rogerisaksson/coaxial_63100/docs/architecture/planners.md

# Architecture: Planners

The loop in a synthesizer's terms, a term a thing: [synth](synth.md).

The gynoid's latent loop, the one way she moves: a text compiled to rows,
the latent state stepped, the modes on her body and their springs rendered
into the whole-body loop's ask ([solvers](solvers.md)), then her drives.
Run by her law ([robotics](robotics.md)). Findings:
[orthokinematics](../findings/orthokinematics.md),
[flight](../findings/flight.md).

| Module | Is |
| --- | --- |
| ortho | orthokinematics: humanoid robot movement as text - `(stream_inject ..)`, `(defbehavior ..)`: latent targets, a stiffness and a damping a mode, rhythm, task constraints - compiled to rows of numbers (gynoid_mesomorph_medium.lisp, examples.lisp) |
| latent | humanoid robot latent state stepped with no branch: a row laid by a mask, the state a lerp, humanoid robot rhythm one angle; each mode's reference and impedance out |
| modal | humanoid robot modes on the body, no branch: the soles' places from the centre of mass as sums and differences, the standing legs' compression, the turns; what is sensed, the statics and the loop's ask laid flat |
| impedance | humanoid robot modes' springs rendered, no branch: the centre of mass's acceleration, a sole in the air, the turns, arms and knees - the whole-body loop's ask |
| poise | humanoid robot ZMP into humanoid robot spanned support polygon, humanoid robot capture point kept in it; which soles stand, with no branch |
| stride | humanoid robot stride from humanoid robot drive's phase: when a limb swings, where its sole lands (humanoid robot capture point), its clearance, its rock heel to toe, a standing sole's heel rising |
| leap | on the whole-body stack: which soles stand, told from one pass - each as it bears, an unloaded one beside one that bears or with humanoid robot at rest; one that does not is asked to its landing (reach) |
| support | sparse upper-body admittance coupling between driven joint innovations and modal references, with no branch |
| se2 | the outer twist-to-setpoint gate and the inner branchless heading, analog insole floor-plane and CPG modulation pass |

- The texts: `gynoid_mesomorph_medium.lisp` (and `_r80`), `gait_base.lisp`,
  `postures_base.lisp`, `motion.lisp`, `situations.lisp`,
  `examples.lisp`.
- `host/tools/sim/`: ortho (humanoid robot latent loop as the page runs it,
  traced; `--walk --look` humanoid robot walk's look); hop (a hop on it:
  thrown, flown, landed).

## Suites

| Suite | Holds |
| --- | --- |
| `test_ortho.py` | a text compiled to rows, none refused; no branch in the core or the renderer; the state blended and turned; crouched, shifted, bowed, on one sole, hopped; the walk on its own payloads; the first texts as given; the gym's worker, keys |
| `test_postures.py` | the seat's chain her landing's; her legs blended over what bears her, the soles' the crouch bit for bit, a let-go hip hung; the kernel's posture atlas read; sat on the chair, her ask her legs' |
| `test_leap.py` | which soles stand, from one pass alone; a landing within reach; the loop in C against the python stack, no sole standing; a hop on both, three in a row on the loop |
