rogerisaksson/coaxial_63100/docs/architecture/aerodynamics.md

# Architecture: Aerodynamics

What flies, on one flight stack: intent as text, the kinematics in a
vacuum, figures as rows and routines as cards, the grounds; the airframes in
MuJoCo, each on its 63100 drives. The quad and the core in C it flies on:
[quad](quad.md). Findings: [aircraft](../findings/aircraft.md),
[envelope](../findings/envelope.md).

| Module | Is |
| --- | --- |
| aerolisp | flight intent as text - `(stream_inject ..)`: latent targets, a stiffness and a damping a mode, an oscillator, task constraints - compiled to aero/'s payloads, a stream laid over the one before; a vehicle's blocks by `defblock` and `use` |
| aerokin | the quad's kinematics in a vacuum, no branch: a row of `aerobatics`' setpoints and the frame as it flies to aero/'s payload - a collective, the rotors' axis's tilt in the heading, the rates its turn gives |
| aerobatics | a figure a row of setpoints (`aerokin`'s), a routine a card of them |
| grounds | the gates in the air and what stands about them; `world` the rotorcraft's, these grounds for the course and the airfield for the routines |
| airfield | the aerobat's runway, its course laid for a plane - an air gate, a limbo, a hoop, a slalom, a knife gate on one line of arcs it flies by L1 - what stands about them |
| course | the gates among trees, houses and cars, a lap a line flown as rows; `flown` any laid line |
| sweep | the rotorcraft's sweep past the spectator before their figures, out down the runway and back past them |
| helicopter | the 3D helicopter in MuJoCo: collective and cyclic swashplate, tail rotor, stunts; `airframe`, `form` a T-REX 700's measured form - drawn -, `sky`, `law`, `observer`, and `kit` the SO(3) law's pieces the three share |
| ornithopter | the Dune-style four-wing flapping ornithopter in MuJoCo: articulated wings, dive fold, stunts; `airframe`, `sky`, `law`, `observer` |
| aerobat | an Extra 300 in MuJoCo: prop-hang, high-deflection surfaces, stunts; `airframe`, `form` its measured form - drawn, and what touches the runway -, `sky`, `law`, `observer` |
| wingborne | a plane's wing and tail in the air, its run on its wheels and its law wing-borne |

- The texts: `aerodynamics.lisp`, `dynamics.lisp` and `kinematics.lisp`
  shared; `quadcopter.lisp`, `helicopter.lisp`, `ornithopter.lisp` and
  `aerobat.lisp` a craft each.
- Drawn by `coaxial/graphics/<craft>.py`; flown on `terminal/views/<craft>/`
  and `show_<craft>.py` ([views](views.md)).
- `test_helicopter.py`: the helicopter and the ornithopter in MuJoCo, the
  three's boards and views; `test_aerobat.py`: the aerobat's routine on its
  airfield and its gate course in wind.

## Aircraft Flight Stack & Real-Time SO(3) Control Architecture

Aircraft flight stack and real-time SO(3) control architecture
