rogerisaksson/coaxial_63100/docs/DONE.md

# Done

What left [TODO](TODO.md), the oldest first; a line's numbers are in the file
it names. A closed item is cut from the list and gets its line here, last;
the two hundred before these: [DONE_1-50](DONE_1-50.md),
[DONE_51-100](DONE_51-100.md), [DONE_101-150](DONE_101-150.md),
[DONE_151-200](DONE_151-200.md).

1. Her DC link (`machine.body.dclink`): her packs, their BMS and her boards'
    capacitance under her drives' power, bled on her boards' d axes past the
    text's onset; under its 60 V through every scene, a hop down's landing
    58.93 V (test_kernel.py, [kernel](findings/kernel.md)).
2. Her blind field (`machine.senses.field`): the kernel's admittance seek down
    where her rows wait on a seat not bearing her; a chair lower than seen
    found and sat on, a chair pulled before it bears her a squat
    (test_kernel.py, [kernel](findings/kernel.md)).
3. The somatic manifolds on her observer (wbc_gmo.c, 8 manifolds): her
    forefoot by her soles' centre of pressure, her thighs' backs, her
    forearms' and carpal heels' shove; read against her skin walking,
    seated and lying ([kernel](findings/kernel.md)).
4. Her right-invariant EKF on SE_2+2(3) (`machine.senses.inekf`) beside her
    estimate: IMU and her soles' contacts by the observer's weights; walking
    0.039 m along the floor and 0.004 in height in 7.2 m where her estimate
    0.060 and 0.041 (test_kernel.py, `tools/sim/drifted.py`).
5. The kernel's two master texts as given, a module a file (26): the
    22-capsule body schema, the AST-to-SoA lowering - its functions
    evaluated as written -, the somatic schedule folded into the room's; the
    protocol's list rewritten to its seven steps and five tests.
6. The SoA ABI and the lowering (`machine.texts.lowering`, wbc_soa.h): a gait
    folded into a bank of the text's fields at its offsets over her nominal's,
    a biquad a node seeded on her value, the manifolds' weights, the capsules;
    carried over her link's table, her loop's biquad in C bit for bit; swapped
    settled, a step of 8.6e-7 where unseeded 0.30 ([kernel](findings/kernel.md)).
7. Her body schema (`machine.law.schema`): the kernel's 18 capsules on her
    skin, its 13 pairs' clearances, her posture held to each near pair's
    ECBF in her mass's metric, each floor raised by its braking distance
    through her drives' back-EMF bounds (`machine.body.bemf`); walking every pair
    clear of its floor ([kernel](findings/kernel.md)).
8. Her law's torque box her drives' back-EMF bounds (`machine.body.bemf`,
    `machine.stack.shrunk`): each driven joint's bounds by its speed on her link's
    volts inside its clamp, in her python step, wbc_step.c and the board's
    wbc_shrunk.c: her ask shrunk to her clamps, each drive clipped to its
    bounds, her C twins as her python ([kernel](findings/kernel.md)).
9. The insert's phase-margin probe (`machine.law.margin`, `tools/sim/margin.py`):
    the text's lock-in at 15, 22, 30 and 38 Hz, each in its turn, on her loop
    broken at a drive's torque; a known loop read within 0.11 dB and 1.7 deg;
    her gearboxes in, her hip's loop at 22 Hz past 0 dB with 25 deg
    ([kernel](findings/kernel.md)).
10. Her things as the room's boxes (`machine.law.schema`, `machine.body.capsules`
    the kernel's capsules apart); her arms' shield against them through their
    elbows tried and undone: at a doorway's jamb it spared no strike and
    halved her shoulder's yield ([kernel](findings/kernel.md)).
11. The wayfinder's gauge (`machine.way.wayfinder`, `tools/sim/doorway.py`): her
    trunk twisted through the gap 0.6 s ahead; the lodge's door ajar at 0.8
    of her shoulders passed, her waist 28 deg, her arms 55 mm clear
    ([kernel](findings/kernel.md)).
12. Her map (`machine.eyes.registry`): the kernel's 256 slots of what her looks
    told her within her eyes' frustum, a thing matched to a slot of its kind
    within its position's precision, weighed by the text's log-odds, blind
    spots kept 45 s and swollen, a mover at its velocity; 45 of the lodge's
    53 boxes after her bed errand ([kernel](findings/kernel.md)).
13. QUIT on the front page, Q and Enter on it; the RS485 plate tells its CRC
    from her wear's drift alarms (WEAR), SERVICE's row named wear.
14. Her buses through a noisy line (`edge.noise`, `edge.burst`, wbc_sil.c): a
    corrupt frame refused once and resent the next pass; a bus refusing past
    her horizon 1/omega (306 passes) turns her drives off till a restart;
    Renode's limb takes the same noise on its socket (test_buses).
15. The tube on and off (`terminal.ui.tube`), a retro set's switch: a dot over
    the shell's text, a line, the front page unfolding from it; the last frame
    folded to a line and a dot on leaving, 0.4 and 0.3 s.
16. The suite's side-lie (side_lie.lisp): perched on the bed's edge, a
    trochanteric pendulum along it; its handler (`maneuver._pendulum`) refuses
    the roll past her modes' reach by name, her gym's lie_bed kept.
    stunts_base.lisp renamed motion.lisp.
17. Her eyes' things as her registry's looks under `physics.SIGHT`
    (`sight.told`, `sprung.LOOKS`), the world's boxes their stand-in without
    it; the chair, table and bed told within 0.10 m.
18. Tour's corner on her closing speed toward the stop (`se2.closing`), a
    spin's drift away no approach; the brake's wire by the gait she was told,
    not her sway's phase: the chair errand sits at 23.7 s where 25.5.
19. The kernel's Coulomb slide as an ask of her step (`wrench.step`, the C
    step and its mirror): a pressing contact's tangential rows freed, its
    friction the kinetic one given, its normal force capped; unasked, the
    step to the bit as before. Measured on the chair's edge sit.
20. A slide said by her text: `(slide v)` in a phase's task constraints
    (`ortho.SLIDE`, the row 304 bytes), carried by her latent (`latent.SLID`,
    wbc_law.c alike) to her step's ask; nothing said, nothing moved.
21. The kernel's reachability on her loop (`machine.law.somatic`): each leg's
    reach over her leg's length rolls her sole's centre of pressure onto its
    ball from 0.86 to 0.98 of it by the furniture's told share; the slide's
    ask laid there too. Standing and sat on the chair, nothing moves.
22. Her seat one patch of her step (`wrench._patch`, wbc_patch.c): its
    contacts' split pinned as felt; the Coulomb regime as the step feels it
    (`rounds.pushed`, past SLIDE_M_S), the text's slide its cap; what bears
    her capped as told over every patch, no lower than the lever's rule; the
    rise's lean panned to her soles at the handover's 0.82, her legs' springs
    back with it, her neck braced seated. The chair laid 2e-4 rad either way
    sat (main fell at -2e-4), square and +2e-4 risen at roll 2.4 deg, the
    dock stood, her walk as it was; the -2e-4 rise stays open (protocol 5).
23. Her loop's layers live (`machine.process.introspect`, findings/introspect.md):
    latent, impedance and wrench a JSON line each law pass to any client
    attached, every field named from her code's constants; idle 604 us a
    pass where 615 without, 875 read.
24. Her telemetry gated (`machine.rig.gate`, `machine.rig.streams`, findings/
    introspect.md): her analyzers beside her loop, a trigger's half swing
    before and after written gate after gate, 11 streams on their own
    clocks interleaved in time with their metadata; every gated section her
    passes' own to the bit (test_gate), the page's snapshots matched.
25. Her pose laid within her joints' stops (`physics.World.reset`): her
    fingers, held a fist at 80 deg, laid at the stand's 18 snapped in at
    893.5 deg/s each lay, her wrists at 69.1; now 0.4 and 3.8, her walk as
    it was (findings/introspect.md).
26. HUMANOID's prompt on its own model (`gynoid.MODELS`, gemma4:e4b: 4.6
    GB on the card where 12b held 8.1), warmed as the page opens and at
    `/`, released as it closes; the Ollama host 127.0.0.1, where localhost
    paid 2.04 s a request: a prompt 2.42 -> 0.11 s, a board-chat question
    8.0 -> 1.4 s (MODELS.md).
27. Her classifier on MuJoCo's furniture painted into her map (test_sight):
    each piece's kind, place and floor hull within a voxel at 0.05 m, the
    bed moved and turned; a map's voxel its own (`voxels.Map`), her eyes'
    at the 0.1 m they fill; a look's `things` 994 -> 174 ms at 0.05 m
    (findings/sight.md).
28. Her fake camera, a vision SIL (`machine.eyes.camera`): her eye's frames shot
    on the card where the world runs, her map and classifier in a process
    of their own, her things a look later; her loop 1.09 x flat out with it,
    1.08 without; a structure told in pieces by its cells (test_camera).
29. The rotor page's segments read its feed once a frame in test_views_segments:
    the stepper went 52-80 of 60 degrees under a full run, 56 and 52 on 24
    copies side by side.
