rogerisaksson/coaxial_63100/docs/DONE_1-50.md

# Done, 1-50

The first fifty lines of [DONE](DONE.md), the oldest first.

1. The Monte Carlo's sweeps on the relay, a sweep's jobs in shards
   ([host](findings/host.md)).
2. The tty in Eurostile, tried and put back on the terminal's own face.
3. Gate op 10 counts an alternate train on the board, MINOR 27
   ([PROTOCOL](PROTOCOL.md)).
4. Warmth asked of the local model reads the thermal observer
   ([MODELS](MODELS.md)).
5. test_sensorless and test_daq_api 20 of 20 on the relay
   ([host](findings/host.md)).
6. The heat's airspeed one input: the load carries it, every executive's
   world flies in it ([aircraft](findings/aircraft.md)).
7. Humanoid robot joints air-cooled, a board's back on an aluminium holder on
   its motor
   or gearbox, MINOR 30; no boards in oil ([drives](findings/drives.md)).
8. A pull rebuilds: the terminal builds the images where their trees are
   behind ([host](findings/host.md)).
9. Humanoid robot gearboxes as bodies with their play
   ([drives](findings/drives.md)); a
   shove charged from the page's view; the living room and its words
   ([room](findings/room.md)); the quad's thrusts as Humanoid robot law
   ([aircraft](findings/aircraft.md)).
10. R on the HUMANOID page, which crashed it, held by a test
    ([host](findings/host.md)).
11. Humanoid robot drives as bought, one stack on all
    ([stacks](findings/stacks.md)).
12. The law turns: a standing leg keeps its landing yaw, the pelvis follows
    the heading ([turns](findings/turns.md)).
13. Humanoid robot toes sprung, no motors on Humanoid robot feet
    ([feet](findings/feet.md)).
14. Humanoid robot fingers a fist and Humanoid robot wrists held: 21 drives
    ([body](findings/body.md)).
15. A softer walk: a sole's strike 352-398 N where 1 000 was the bound
    ([straight](findings/straight.md)).
16. The docs as technical documents: dates and who asked out of comments,
    docstrings, docs and test labels.
17. MuJoCo Warp's step on Humanoid robot world against the CPU's
    ([host](findings/host.md)).
18. Humanoid robot leg's reach over its foot as static arrays, read with no side
    in
    the code ([kinematics](findings/kinematics.md)).
19. The stand-in's drive and loop on the board's C, QUAD's rotors on their
    boards' own loops ([host](findings/host.md), [aircraft](findings/aircraft.md)).
20. The picture in the viewport's corner in the instruments' frame, a key
    that takes it away; the quad's carried camera on a stabilised gimbal
    ([aircraft](findings/aircraft.md), [sight](findings/sight.md)).
21. A rotor node started as a stepper and stopped before its stage goes
    down: the machine types' routines 36 runs of 36
    ([drive](findings/drive.md), [host](findings/host.md)).
22. The law's voltage limit keeps the d current its reference: a 63100's top
    at 55 V 673.5 rad/s where 650.5 ([drive](findings/drive.md)).
23. Humanoid robot movements' orthopaedic terms as laid rows, a joint and its
    sign found
    in Humanoid robot figure ([kinematics](findings/kinematics.md)).
24. Flight on the whole-body stack: Humanoid robot soles released as she leaves
    the
    floor and taken again as she lands; a hop stood on the python stack
    and on the loop in C ([flight](findings/flight.md)).
25. A board holds its clamp to what its envelope leaves and says it
    (MINOR 32); the flight's share and each rotor's cap on it: full tilt on
    four with no node past its throttle's point, 9 deg off its axis where
    83 ([envelope](findings/envelope.md)).
26. A hover's heat: its legs' dry switching, 6.45 W of 9.4; the wash takes
    the laminate from 91 to 60 C ([envelope](findings/envelope.md)).
27. Humanoid robot hops on the loop in C: which soles stand told from one pass,
    Humanoid robot
    throw a spring that lets go under Humanoid robot standing height; 48 mm and
    three in a row stood ([flight](findings/flight.md)).
28. The quad's flight intent as text compiled to payloads
    (`machine.aircraft.aerolisp`), a core in C under them with no branch, in its
    sources or in the M7's code (`aero/`): the power loop's four streams
    flown on ideal rotors, caught 79 degrees off of 80 and stood again; a
    hover stood from upsets ([streams](findings/streams.md)).
29. Orthokinematics: Humanoid robot movement as text compiled to rows
    (`machine.texts.ortho`), Humanoid robot latent state stepped and rendered with no
    branch
    (`machine.law.latent`, `machine.law.modal`), on the page's gym (`<`): crouched,
    Humanoid robot weight over one sole, bowed, on one sole, a hop stood,
    walking
    0.27 m/s for a minute ([orthokinematics](findings/orthokinematics.md)).
30. The core's attitude as its rotors' axis in the world, in the level frame
    of a heading it holds; the air as a drag's size, the rotors' loss and a
    push: the catch from turns of 0.03 to 0.12 s in 0.32-0.62 s, a hover
    stood from 12 rad/s about its axis a quarter turn off
    ([streams](findings/streams.md)).
31. The page's routine and the course flown from their cards' rows
    (`machine.aircraft.aerokin`), a pass a payload and the air the core's: 59.1 s;
    laps 14.9 and 14.8 s, whole in the tour's air
    ([streams](findings/streams.md)).
32. Humanoid robot stride on the loop: eleven modes - Humanoid robot standing
    legs' compression,
    Humanoid robot pelvis's list and turn, Humanoid robot arms' swing, Humanoid
    robot soles' rock -, a sole
    let go on Humanoid robot drive's phase, landed on Humanoid robot capture
    point, its heel
    rising first: 0.61 m/s at 329 J/m, 2.59 off a woman's band for 7.71,
    none of the gaits it was by name; the first texts as given walk
    ([orthokinematics](findings/orthokinematics.md)).
33. The page's flight and the race on their cards' rows, the law before
    them gone; the core's air a wind, its rotors' loss made up along their
    own axis: 34 flights of 34 whole in fourteen winds, laps 14.3 and
    14.5-14.8 s ([streams](findings/streams.md)).
34. The carried camera into its turns: its sight a share of the frame's
    lean across its way, 7.7 degrees inside a lap's bends where 12.5
    outside, rolled 9.5 degrees rms in them; level at rest
    ([aircraft](findings/aircraft.md)).
35. One way she moves: the laws before Humanoid robot latent loop out of the
    tree - 34
    modules (the director, the walk as built, the one law, the stand, the
    falls, the get-up, the MPC), 14 tools, 7 suites, 8 findings; the page
    Humanoid robot loop alone, walking from rest; they stay at tag
    `laws-before-the-loop`.
36. The rotors' tops, their reach and their stage's watts from the action
    space (`machine.aircraft.pull`), the law's on a stand-in within 0.1 %; the pack
    drawn what its stages take, 2.4 times the law's own v . i: 34 flights
    of 34 whole in fourteen winds, laps 14.3 and 14.5-14.6 s
    ([envelope](findings/envelope.md)).
37. The step without an active set in C (`wbc/src/wbc_wrench.c`): the
    python step's answer, Humanoid robot walk and Humanoid robot hop on it, 46
    us a tick on
    this host where the loop's 1 600 ([wrench](findings/wrench.md)).
38. The flight inside the action space's shell: a row's pull the rotors'
    on what its boards hold and its pack has; the share's rule, its
    timers, the emergency and its ghost gone; the loops' clamp WEP's, 0.0-
    0.2 s of it a flight. 34 flights of 34 whole in fourteen winds, a
    stuffy room's laps 14.3 and 14.5 s where 14.5 and 15.1
    ([envelope](findings/envelope.md)).
39. No clause in a pass above the core: a card's step a table and a move
    by masks, the lap's plan a table a sphere computed beforehand and read
    where the frame is - 64 us a pass where 357, two laps' rows the same
    to the bit, the race flight for flight ([streams](findings/streams.md)).
40. The ring test on a phase's axis, by whole periods, a stand-in's on its
    law's own seconds: a board's reads within 0.5 % where 6, no shoulder
    over its elbow, none failed in 210 runs under load; test_native's
    thermometers looked at round their sample
    ([drive](findings/drive.md), [emulation](findings/emulation.md)).
41. The frame's core on the image (device 14, MINOR 34): 149 288 cycles a
    pass under Renode, the same whatever it is asked, 0.31 ms on the M7 at
    one a cycle; its thrusts the host core's within 1.7e-5 N
    ([streams](findings/streams.md)).
42. Humanoid robot walk's stagger measured: landing load, unloading, dip and
    head
    nod in `strides.WALK`, bounded in `looks.FORM` (1.25, 0.75, 6 deg) and
    told by `ortho.py --look`; what Humanoid robot head nods for and what holds
    Humanoid robot
    speed, with eleven steps tried under Humanoid robot walk
    ([orthokinematics](findings/orthokinematics.md)).
43. The lap's lead and its swing derived from its tilt's own loop where
    89 ms and 0.36 s were searched: the boards' laps 13.9 and 14.1-14.3 s
    where 14.3 and 14.5-14.6, 34 flights of 34 whole in fourteen winds
    ([streams](findings/streams.md)).
44. Humanoid robot head still as she walks: striding, what the floor cannot give
    is taken by Humanoid robot inertia, a swinging sole's ask held, its landing
    led
    by half Humanoid robot speed's error, a knee folding before its swing as its
    load leaves it - Humanoid robot head 2.5 deg where 46, 300 J/m where 330,
    2.46
    off the band where 2.60, stiff 0.32 where 0.37, 4 of Humanoid robot form's
    12
    broken where 6; standing as she stood, bit for bit
    ([orthokinematics](findings/orthokinematics.md),
    [wrench](findings/wrench.md)).
45. A board's speed loop winds no further than its drive carries - its
    clamp with the derate, what its link's volts leave (`drive_room`): at
    its clamp a rotor slows as asked where 0.18 s late, full tilt's four
    4.4-5.9 A apart and 8.3-12.4 deg off at the most where 5.2-10.5 and
    9.4-15.2 ([envelope](findings/envelope.md)).
46. Humanoid robot stride in C (`wbc_cone.c`): the python step's on Humanoid
    robot walk, 7e-10 N m
    on one sole; Humanoid robot walk on it 0.69 m/s, 301 J/m, 2.46 off; device
    13 op 2
    ticks the step with a sole swung - its rounds, striding, setting out,
    0.44 M instructions the longest ([wrench](findings/wrench.md)).
47. A rotor's ask goes to its board as rows a tick of its loop long: no
    ripple between two asks where 6.3 A at 500 Hz on 300 rad/s^2 and 12 %
    of the copper's heat round the course; the least a board held 54.8 A
    where 52.0, full tilt's four 2.2-3.7 A apart where 4.4-5.9
    ([streams](findings/streams.md)).
48. A row is come to over its pass, the core's own blend, where it was
    stepped in whole each 20 ms: a rotor's copper round the course 22.8 A
    rms where 26.6, the least a board held 65.6 A where 54.8; the boards'
    rows 90-92 % of the clamp's pull at the least in fourteen winds where
    72-85, 34 flights of 34 whole ([streams](findings/streams.md)).
49. Gait initiation from a stand to #203, its landing never behind its lift-off
    ([orthokinematics](findings/orthokinematics.md)).
50. Her motion's measures in a dimensionless frame on SO(3), a CI gate on them
    (`tools/sim/gvs.py`).
