rogerisaksson/coaxial_63100/docs/DONE_151-200.md

# Done, 151-200

What left [TODO](TODO.md), the oldest first; a line's numbers are in the file
it names; the fifty after these: [DONE](DONE.md).

1. The flight pages watched by a spectator beside the field: one eye, a
   filtered gaze, a lens framing the craft over its horizon, the chase on the
   course's laps alone - the aerobat's routine had been chased and flown on
   the course's 1.5 g ([aircraft](findings/aircraft.md)).
2. The rotorcraft swept past the spectator before their figures and the
   figures brought down to 4 m, full tilt to 15-20 m where 22-63; the four
   pages watched from one spot by the runway ([quad](findings/quad.md)).
3. The helicopter drawn a T-REX 700's and the quad a Hunter's, measured off
   models, the ornithopter a dragonfly's: a canopy over frames, a boom on
   supports, bowed gear; plates on flat arms, the pack, a GPS mast, legs on
   the sky's feet; a ribbed glass head, veined wings
   ([aircraft](findings/aircraft.md)).
4. The rotorcraft's routines flown on the airfield, as the aerobat's, the
   course's grounds standing for the course alone: a tree had stood 6 m from
   home ([quad](findings/quad.md)).
5. The four of one size at 2 kg, 1.25-1.4 m: the helicopter on a 1.25 m rotor
   (1.0), its turns as quick; the Extra on a 1.4 m wing (1.6), its side
   its form's, its opening's turns 11 m and its knife 0.47 m; the quad and
   the ornithopter as they were ([aircraft](findings/aircraft.md)).
6. The rotorcraft off a pad under the first gate straight into the course, its
   descent not held; the helicopter and the ornithopter on the gates'
   middles, the helicopter at 1.5 g; the spectator 10 m off the runway, each
   craft framed at 0.4: eighteen page runs on the tour and in kept winds,
   none struck ([quad](findings/quad.md), [aircraft](findings/aircraft.md)).
7. Every figure on the deck - the hover at 0.3 m, the high 0.75, each
   figure's lowest point 0.2-0.5 m over the runway, the helicopter inverted
   at 0.2 with its disc 0.12 over it, the quad's toss 0.7 s -; gusts, eddies
   and rise none at the floor, whole from 3 m, and every disc's ground
   effect: in six winds the quad struck none, the aerobat 16 times where 21
   ([aircraft](findings/aircraft.md), [quad](findings/quad.md)).
8. The helicopter and the ornithopter lap on a line laid for them by flight
   at 2.2 g, their laws on all they have: 18 s a lap where 24, none struck in
   17 airs, six page winds and 36 turbulent seeds
   ([aircraft](findings/aircraft.md)).
9. The aerobat lands off a circuit and a final laid as its laps are, the
   course's off its last lap: in still air a touch at 0.22 m/s 0.04 m off
   the centreline where 0.64 m/s; in gusts 13 of 13 at 0.11-0.22 m/s, no
   final past the stall where every course's hung on its propeller, all
   stopped on a strip to 30 m where the timed circuit came down 25-37 m
   beside the runway ([aircraft](findings/aircraft.md)).
10. The crafts' pages run as her page does: the flight in a process of its
    own, her worker's loop made general (`machine.process.apart`), played back in
    real time or slower, never ahead: 18.7-19.3 frames a second where
    13.4-18.7, the longest gap 89 ms where 639 ([host](findings/host.md)).
11. The flights drawn in step and at 30 frames a second: each frame on a
    beat, the flight shown at the instant it is written (`screen.drawn_at`),
    a synchronized update - on screen 0.98-1.02 of its speed where
    0.67-1.48, on its lap 0.04 dots off smooth motion -, a frame 35 ms where
    52 ([host](findings/host.md)).
12. The aerobat's propeller a 1.4 m 3D model's 17x8, fixed, on its speed,
    its surfaces in its slipstream, both boards on its own rotor: 2.65 g
    where 7.5; its routine lands in 9 airs of 9 where 7
    ([aircraft](findings/aircraft.md)).
13. Her page held to what it shows and played back steady, her 3D drawn a
    frame ahead in its own process (`terminal.ui.ahead`, the flights' too):
    27.3 frames a second where 14.8, her motion on screen 0.92-1.03 of its
    speed where 0.59-1.07 ([host](findings/host.md)).
14. The aerobat's page on its 17x8 as its boards turn it: gusty, its figures
    higher by its law's gusts, the waterfall one tumble from 6 m, its lap at
    16 m/s, its course on all it has - 2 crashes in six tours of 400 s where
    47 ([aerobat](findings/aerobat.md)).
15. The aerobat flown, not forced, in air grown and subsided: gusts over 4-8 s,
    eddies of two stages, a kind eased in on an S - the air's change 0.09-1.5
    m/s^2 rms where 1.2-14 -; its wing-borne share whatever its pitch, sped up
    on its propeller, its height's loop at its wing's pace, its take-off and
    heading within what its wing does: 3 strikes in six tours where 7, its
    circuit's pitch 1.4 deg where 3.1 ([aerobat](findings/aerobat.md)).
16. Her inner loop a branchless SE(3) and modal continuum (`machine.law.motion`,
    `machine.senses.touch`, `machine.senses.grip`, `machine.law.se2`, `machine.process.sprung`,
    `machine.senses.edge`, `terminal/views/humanoid_keys.py`, `test_structure.py`):
    zero `if`-branches or mode-name checks in `motion`, `touch` and `grip`;
    off-sole leg-chord suspension (`impedance`, `poise`) dangling her legs on
    chair and bed; named stream commands (`stand`, `sway`, `step`, `walk`,
    `walk_back`), `A`/`D` sidestrafe and `Q`/`E` turn in place; cervical and
    shoulder inertia decoupling on stop; and `software_layout.svg` generated
    from live code constants ([scenarios](findings/scenarios.md)).
17. Space-charged (`5-250 ms`) standing two-footed high jump, walking and
    running forward leaps, viewport `[F]` autonomous approach errands for
    chair, bed and doorway exit, and TTY tour with live LLM command stream and
    interactive `/` gynoid LLM prompt (`machine.moves.leap`, `machine.way.tour`,
    `machine.process.worker`, `terminal/views/scanner.py`, `terminal/views/gym.py`,
    `terminal/views/viewpoint.py`, `terminal/views/show_humanoid.py`,
    `test_leap.py`, `test_errands.py`, `test_views_humanoid.py`).
18. Smooth room bed entry and rise (`lie_bed` and `rise_bed` with physical
    pelvis alignment, backing, foam compliance and heel clearance), persistent
    `BOARD CHAT`-style `GYNOID CHAT` LLM prompt dock under the viewport, and
    continuous outer-loop horizon functions (`init_lead`, `brake_lead`,
    `stand_lead`, `rise_lead`) replacing discrete delay tables (`machine.world.room`,
    `machine.law.motion`, `machine.way.tour`, `machine.law.se2`, `machine.process.worker`,
    `terminal/views/gym.py`, `terminal/views/show_humanoid.py`,
    `terminal/keybindings.py`, `test_errands.py`, `test_views_humanoid.py`).
19. The 31 mocap takes as MuJoCo scenarios (`tools/sim/stunts.py`,
    `scenarios.STUNTS`, `tests/takes/stunts.json`): one measuring function for
    a move from joints' places, a take's and hers alike; a scene, a telling
    and a signature a take; a step's edge behind her (`floor` `edge_behind`);
    a verb without a text refused by name. First run 2 of 31 met.
20. The emulated RS485 bus in order and conformance at its own pace: a limb's
    characters on one medium, framed by t3.5 on its clock (`RS485_Bus.cs`,
    `RS485_Adapter.cs`), the UART's 475-MIPS touch and the receive FIFO
    gone; emulated boards armed on the host's emulated pilot
    (`coaxial.node.arm_stage`, SIL); a limb of three 51 echoes of 51,
    conformance 110 of 110 on the emulator and on the bench board, the bench
    suites green on COM3 ([emulation](findings/emulation.md)).
21. Her simulator's pace against real time: MuJoCo's step alone 13.6 of
    real time; her loop 1.38 -> 1.73 (walking 1.92), the page's worker 1.37 ->
    1.87 on this laptop, her walk's smoke the same to the digit: her surety
    field in C bit for bit (`wbc_surety.c`, held over 12 s of her walk), the
    whole-body step's pointed write with M rescaled; her suites run her flat
    out, real time the page's; the tiers her page affords by the machine's
    cores said at boot and in its BUSES box with her headroom
    ([pace](findings/pace.md)).
22. A performance build beside her stack
    (`gynoid_mesomorph_medium_performance`: the U12 II KV120 on box A for her
    spine, hips, knees and ankles, its manifest and its text extending hers,
    the U12 II and U10 II in the motors' library as bought): her hop's demand
    on it measured, 1.44 of the U12's amps at the hips and the box 0.93 where
    1.33, and her standing jump 0.03 legs' rise on it for 0.01: the hop's ask
    is the law's ([demand](findings/demand.md)).
23. The standing jump's push laid from what the drives give (`leap.pushed`:
    a curve of rows at the knees' clamp through the lever, the crouch the
    take's own frames held a spring's period): take-off 1.5-1.65 m/s, rise
    0.43-0.51 legs of the human's 0.55 where 0.01; four faults of the law
    found on the way - the latent's curve anchoring, `touch.step`'s dropped
    acceleration, the knee rows' damping against still, the surety's phase
    read for the held polygon - rows that lower her waiting for a floor
    (`waits.landed_rows`), and the parry stepping her only while the rows
    hold the polygon: off and down on both soles
    ([stunts](findings/stunts.md)).
24. Balloons on what she sees, HUMANOID: each support in her sight a balloon
    on it, its key and its word, the one she faces first (from her lay in the
    lodge F1 go out, F2 lie down, F3 sit; one alone F1 too, F1 and her rise on
    her while something bears her), a chair's seat and back one
    thing, one behind the docked eyes or off the drawing at their edge
    pointing on; F then the digit within a typed key's hold
    (`console.HOLD_WINDOW_S`, 0.65 s) or the function key says that one's
    errand to that thing (`at`: the chair scene's two chairs each their
    own), F alone the first's once the hold lapses ([host](findings/host.md)).
25. CI's host gate out of time and its moved bed: her page's close read its
    world's pipe after ending it, and half a state on a POSIX pipe waited for
    its rest for ever (show_humanoid past 120 s, the terminal pages and an
    ortho shard past 300 s); drained while it ends now, `test_views_flying`
    holding a world spilling 4 MB states closed within its wait, red on the
    old close on CI. Her map's cell as high as HITS of a look's points say:
    the moved bed's 95th 0.74 on Linux, told a table, 0.49 now. Her walk's
    correction judged as a share of what the world's own model takes: 0.57
    here, 0.62 on Linux ([identification](findings/identification.md)).
26. The firmware workflow's Release job green again: the emulator suite's
    bus group, out of time at 480 s on CI's runner, split in two - the
    echoes through a limb of three 129 s here, the off-rate open 63 -, each
    test's seconds printed, a group out of time keeping its lines (the
    relay's children unbuffered).
27. The curve's own acceleration reaches the impedance only with no polygon
    held, a throw's rows (`touch.step`, `wbc_touch.c`): held, a take's frames
    31 ms apart bent 118 sagittal/s^2 and 56 pitch/s^2 of noise and the
    sit-down take fell seated at 6.9 s (3.8 widths, 0.6 now; the standing
    jump 3.9 -> 3.0); test_leap 21 of 21, errands 19 of 19
    ([stunts](findings/stunts.md)).
28. BOARD ATTITUDE at the screen's 30 Hz and its first frame under a second:
    drawn in a process of its own a frame ahead, its face, outline, floor and
    shadow at once on arrays (bit for bit), its feed asked a frame - 10.4 ->
    29.6 fps turning, 19 -> 27 new poses a second; from the front page on the
    bench 2.3 -> 0.9 s, drawn here on the warm card till its process is up
    ([host](findings/host.md)).
29. BOARD ATTITUDE's drawing started as the terminal opens and again after
    the page closes (its AHEAD; `ahead.keep`, `take`, `let_go`), a named
    page's before the loader's imports: on the bench by name 2.5 -> 1.9 s to
    the first frame, from the front page 0.9 s, its own process's
    ([host](findings/host.md)).
30. The terminal's one UX: every page's keys rows of one table
    (`terminal/ui/bindings.py`), its bar and help read off them, one dispatch
    with each page's modes, a key two rows bind refused; Esc the start menu
    over any page, Tab the instruments' column - folded at first to a rail,
    its arrow breathing, the front page's panels up -, ? the keys; the 13
    pages drawn with it at 150 x 44 ([host](findings/host.md)).
31. F's balloons only on what she has identified: a rise from the thing that
    bears her offered at that thing, none with none known; from the floor
    alone (a crouch, a fall) offered, unballooned. Lying in the bed she walked
    to: `[F1] rise bed` on the bed, the click up ([sight](findings/sight.md)).
32. The ortho-DSP suite read, voiced on her walk by its changes off the
    nominal and refused by name where she cannot (`machine.texts.dsp`,
    test_dsp.py); a take converted to its modifier against her walk, numpy
    alone (`tools/sim/identify.py`); the patches, the schedule and the takes
    played on her and measured by it (`tools/sim/suite.py`,
    [sequencer](findings/sequencer.md)).
33. The start menu over a page taken out: Esc leaves a page for the front
    page, the band its name alone (`terminal.ui.bindings`, `taskbar`,
    `stage`; test_views_keys.py, [host](findings/host.md)).
34. Her head through a stop: her neck let go through a brake and a sole
    let go only once the other bears as much of her (`motion.control`,
    `poise.stands`, wbc_stride.c; [jerk](findings/jerk.md)).
35. The folded column a tab: its edge a line, a tab in the middle of it,
    its arrow breathing over Tab's keycap (`terminal.ui.taskbar`); the
    pictures draw what the terminal draws where Consolas has no glyph
    (`machine.rig.ansi`).
36. The drawing takes the folded column's room: BOARD ATTITUDE, angle, desk
    and thermal the window less the column as it stands (`taskbar.room`),
    not the open column's ([host](findings/host.md)).
37. The folded column's tab 5 cells across, its edge's line run into it, its
    arrow and key on the key bar's ground; one column on every page: chat
    and render the template's 40 and its instrument, desk's bridge the whole
    room, HUMANOID and the crafts `taskbar.room` (`terminal.ui.taskbar`).
38. The tab's arrow breathing fainter: 0.3 of the way to an instrument
    edge's ink, from 0.5 (`taskbar.BREATH`).
39. Her agent's chat a drawer, slid as ?'s help (`taskbar.slid`): up with
    the greeting as HUMANOID opens, on / while her prompt is open and
    HELP_S after its last line, then down, her drawing taking its rows; its
    lead a braille turning (`gym.drawer`, test_views_humanoid.py).
40. The suite's chair: sit and rise played from the ortho-DSP suite's
    patches, paced to her springs, her arms held, docked at the patch's
    standoff (`machine.texts.maneuver`, `seated`, `swing`; test_errands.py,
    [sequencer](findings/sequencer.md)).
41. Her way walked through a corner where a curve fits her arc: A* ->
    convex corridors on her cells -> a clamped cubic B-spline held in them
    by linear rows (`route.planned`, `qp.solve`), walked on her arc's twist
    while she lags it (`tour._steer`; test_sight.py,
    [errands](findings/errands.md)).
42. The autotuner on her loop: the text as given
    (lisp/humanoid/meta_ast_autotuner.lisp) read, a root's literals walked by its
    grammar, their reach on her by evaluation, a gait, a stunt or a schedule
    run on the relay, its six classes over whatever bears her, the text's
    step a QP with her form held, judged against its floors, a write held on
    every root it reaches (`machine.texts.tune`, `tools/sim/tune.py`, `telemetry`;
    test_dsp.py, [autotuner](findings/autotuner.md)).
43. The anti-spasm insert her master bus, the last stage of every patch: its
    tank on her drives' 1 kHz pass, each slew and jerk its drive's own,
    buffers before her stops; her heel's cap a woman's (`machine.law.supervisor`,
    `wbc_bus.c`, `stride.HEEL_RAD`; [synth](architecture/synth.md),
    [jerk](findings/jerk.md)).
44. The autotuner at runtime: her loop and a tuner apart with no lock
    (`machine.process.rcu`), her raw passes copied in C and cooked off-core, a table
    of her walk's row compiled from her texts laid at her barrier
    minimum-jerk (`machine.process.tap`); her walk tuned while she walks, converged
    and held on her suite's roots and the bench (`tools/sim/runtime.py`;
    test_tune.py,
    [autotuner](findings/autotuner.md)).
45. The dual-domain kernel's texts as given (host/lisp/humanoid/kernel/, 22
    modules) read whole: quasiquotes, laws her world resolves, pipelines
    threaded later, gates; each op its mechanism's node (`machine.texts.kernel`);
    90 names, the room's schedule (test_dsp.py, todo/protocol.md).
46. The kernel's SoA bridge in C: `rcu`'s block laid by wbc/inc/wbc_rcu.h
    (64-byte lines, two banks, acquire/release words), her loop's taps and
    takes through wbc_rcu.c, the block locked in memory; her walk linked bit
    for bit as unlinked (test_tune.py).
47. Her momentum observer, blind (`machine.senses.observer`): her drives' torques
    through her edge, her IMU's acceleration, her encoders over her law's
    M(q) at the kernel's 35 Hz, split over its patches; against her skin
    walking her soles 22 N rms, seated 14, nothing unfelt past 0.06 of her
    weight walking (test_kernel.py, `tools/sim/observed.py`,
    [kernel](findings/kernel.md)).
48. Her momentum observer in C (wbc_gmo.c, 31.6 us a law pass) and her
    pass's cost measured: 58 us of the text's 350 on this host; her chest's
    yaw standing moves her soles and centre of mass under 1e-5 of its
    acceleration (test_kernel.py, [kernel](findings/kernel.md)).
49. What bears her weighed as felt (`observer.weighed`): her rows' told
    manifold weights where the text's comparator feels the manifold, gated
    at 4.5 and 45 a second, the rest her soles'; her ZMP's hold her soles'
    taken weight (test_kernel.py, [kernel](findings/kernel.md)).
50. Her capture point's barrier (`machine.law.barrier`): the kernel's DCM barrier
    on her centre of mass's ask over what bears her, on as far as her rows
    lean on what she does not feel; a chair pulled from under her sit
    weighs nothing and she squats (test_kernel.py,
    [kernel](findings/kernel.md)).
