rogerisaksson/coaxial_63100/docs/MODELS.md

# Models

The local model with the board's tools: `host/coaxial_ollama/`,
`host/board_chat.ps1` (+ `board_chat/`), `host/dbg.py`, tools in
`host/coaxial_mcp/`. Its measured failure modes are in FINDINGS.

## Picking and pulling

### Picker

`python -m coaxial_ollama.capability`: VRAM minus reserve, free RAM,
cores -> tag. `choose(prefer='speed')` takes the largest tag that fits VRAM
whole (a hybrid split measured ~5x slower). CPU ceiling 8 GB; a 12B on 32
cores ran 6.4 tok/s.

| Tag | GB | Note |
| --- | --- | --- |
| llama3.1:8b | 4.9 | invents tool arguments |
| qwen2.5:7b | 4.7 | |
| gemma4:12b | 7.8 | default here |
| qwen2.5:14b | 9.7 | 12 GB card |
| qwen2.5:32b | 20.0 | |
| llama3.3:70b | 42.0 | needs 64 GB RAM |

### Reserve and pull

Reserve = max(quarter of card, 2 GB, used + 2 GB); override
`COAXIAL_VRAM_RESERVE_GB` / `board_chat -Reserve`. Windows' `AdapterRAM` is
32-bit: read `qwMemorySize`. `python -m coaxial_ollama.pull TAG` is the one
pull (daemon stream drawn as a bar); every entry point pulls a missing tag.

### Decision model (`coaxial_ollama/decide.py`)

Ollama's `/v1/systemone` (0.35.1): a state and typed questions in, one
forward pass, a probability an option out; no text, no tools.
`decide(state, {key: choice() | noul() | score()})`; the first of `MODELS`
pulled answers.

| Tag | GB | Measured |
| --- | --- | --- |
| clef:4k | 17 | `ollama create clef:4k -f` a Modelfile `FROM clef:27b-q4_k_m`, `PARAMETER num_ctx 4096`: 53/65 layers on the 16 GB card, 21 s cold, 5.3 s a decision warm, the same answer every pass; over three faults rounds it picked stand 0.57, faults 0.28 |
| clef:27b-q4_k_m | 17 | at its 16384 the runner wants a 5.4 GB compute buffer beside 11.7 GB of weights: OOM; `options.num_ctx` and OLLAMA_CONTEXT_LENGTH ignored |
| clef-flash | 10 | every request "non-finite logit" on 0.35.1 (ollama issue 18769) |

### Her prompt (`coaxial_ollama/gynoid.py`)

The HUMANOID page's prompt in the operator's own words: the page's model
(`gynoid.MODELS`, else the chat's DEFAULT_MODEL) picks one row of her catalog
(`machine.texts.says`, every row generated from the code that plays it - errands,
stunts, behaviours, gaits, takes, the tour), held to the rows by a JSON
Schema enum, null when nothing fits, the mocap takes named after her own
rows and chosen only when asked for. Asked off the page's thread, the plan
sent as it lands (`gym.drain_plan`); loaded off it as the page opens and at
`/`, held 5 min, released as the page closes; a smoke run loads nothing.

Measured on 20 prompts in Swedish and English, and the eight of
`tests/test_live_gynoid.py` judged on her loop:

| Tag | GB on the card | Warm s | Cold s | Right of 20 | Loop |
| --- | --- | --- | --- | --- | --- |
| gemma4:e4b | 4.6 | 0.11 | 7.5 | 17 | 7 of 8: 'res dig' lying chose lie_floor |
| gemma4:e4b-it-q8_0 | 6.3 | 0.15 | 8.1 | 17 | 'res dig' lying lie_floor as Q4 |
| gemma4:12b | 8.1 | 0.39 | 6.3 | 17 | 8 of 8 |
| gemma4:e2b | 3.1 | 0.15 | 6.5 | 12 | |
| qwen3.5:4b | 3.8 | 0.19 | 4.2 | 11 | |
| qwen3:4b | 3.2 | 0.16 | 11.7 | 11 | |
| d3:2b | 3.8 | 0.07 | 3.6 | 13 | decision model, 72 options in one pass |
| tev1:4b | 5.6 | 0.24 | 3.8 | 13 | decision model |

No better: a fits flag before the op, the kinds beside the lines, the request
put in English first, repeat_penalty 1.0 or 1.05 (the same 20 answers).
With the takes in one list her walk came out running_forward and 'stand up
from the chair' sit_to_stand. 'buga' and Swedish 'spring' missed on every
model; hop's line was its specialization's header ('propulsion spring
specialization') till `says` passed over a self-extending behaviour.
strands-decider needs MLX. The live suite's first run found the catalog's
errand command carrying a documentation placeholder for `at` into her loop.

## Daemon and client

### Tuning (`board_chat/Tuning.ps1`)

| Variable | Value | Why |
| --- | --- | --- |
| LLAMA_ARG_CACHE_RAM | 0 | prompt cache ~343 MiB a question |
| LLAMA_ARG_CTX_CHECKPOINTS | 0 | restoring one threw `std::bad_alloc` |
| OLLAMA_MAX_LOADED_MODELS | 1 | two copies of weights: `cudaMalloc failed` |
| OLLAMA_NUM_PARALLEL | 1 | the same |

A failed preload is reported in the daemon's words (`llama-server binary
not found` = broken install: rerun `setup.ps1`).

### Client (`client.py`)

Host 127.0.0.1: `localhost` tries ::1 first and paid 2.04 s a request, the
daemon on IPv4 alone (1-14 ms). Temperature 0, seed 7, `num_ctx` 8192,
keep_alive 30m (REPL) / 2m (one question). OOM ladder: free other models,
flush, halve context to 2048, raise. `release()` sends keep_alive 0. Never a
second client at another `num_ctx` (reloads 7.6 GB).

## Prompt loop (`dbg.py`)

`coaxial_ollama/debug.py` `Chat` = `budget` (the prompt inside the
window), `turn` (one question, its rounds and calls) and `commands` (the /
lines); the fixed words are `words.py`.

### SYSTEM and tools

~70-token SYSTEM prompt; every line answers a measured failure
(`test_ollama_prompt.py`). Hints join only with their tools. Tool sets
(`SETS`): read, code, pins, build, docs, all, none; re-sent every turn
(runner ~1390 tokens, read ~560, none ~110). A non-`REPEATABLE` tool
repeated in a turn is refused. `run_command` = argv allowlist
(`sandbox.Shell`); `run_python` = persistent `sandbox.Scope`. Output
clipped at 4000 chars.

### Slash commands and prose orders

`/py`, `/sh` (no model), `/model TAG|auto` (releases VRAM first),
`/board simulated|auto|rs485|COMx`, `/node N` (0 = broadcast), `/tools`,
`/detail`, `/confirm`, `/lang`, `/ctx`, `/clear`, `/history`, `/cost`,
`/help`, `/q`. A sentence asking to switch boards is carried out by
`board_switch()` for no tokens (`BOARD_WORDS`, `_BOARD_VERBS`).

### Intent, language, replies, context

- `intent.py` classifies a sentence on the turn's own client (map, read,
  power, devices, link, words, control, orient); 11/12 on gemma4:12b.
  Thinking off (it spent the budget and returned nothing).
- `language.py` locks the session to the question's language; only the
  host releases it. Stdin/stdout re-coded (cp1252 split multi-byte UTF-8).
- `replies.py`: catches a retyped channel table, tool calls written as
  text, marker noise, a tool named instead of called.
- `context.py`: prompt <= 0.7 of `num_ctx`, old tool results stubbed to 80
  chars. `detail.py`: terse under 30 B parameters.

## Runner and MCP

- `runner.py` drives `coaxial_ollama/plans/bringup.yaml`: tasks with limits
  judged in Python; a `report` tool called once, last, with a board tool behind
  it.
- MCP (`python -m coaxial_mcp --port COMx`, stdio): board_info,
  analog_read, docs, self_test, imu, angle, orientation, afe_power,
  devices, digital_read, gpio_pin, gpio_port, test_gate, thermal, link.
  `coaxial_ollama.tools` adds run_python, run_command, build_firmware,
  run_tests, link_diagnose, report. `docs` = index / section (clip 4000,
  1200 terse) / find (12 hits with chapter).
- `run_tests.py -m auto` asks `pick_tests.py` for the model's pick, held
  inside the tier; the path map settles cheap changes without the model.

## What the models did

- Wrote "Mid-scale ... 25.00 C" from the warning text when refusing was
  tried.
- Invented a coaxial cable twice; guessed `ch=['phA']`, BUS_VOLT, A0; sent
  the left knee (asked in Swedish) as `right knee`.
- gemma4:12b answered a measurement with HARDWARE.md's table; denied being
  able to flash with the tool listed.
- qwen2.5:14b switched the AFE on four times in one turn; answered in
  Chinese, Japanese and Thai.
- A search hit without its chapter was reported as the explanation when it
  sat under Ruled Out: `find` reports the chapter.
