rogerisaksson/coaxial_63100/docs/findings/support.md

# Findings: support

What bears her off her soles - a seat, a bed, a knee or a hand on the floor -
as her skin feels it (`machine.senses.borne`) and her law and her step take it.
Her scenarios: [scenarios](scenarios.md).

- Past her modes' 1 onto a chair: 447 N on its seat at 1.83 s, her soles
  unload, her law reads no stance and lets her fall freely: down at 3.06 s.
- A segment the skin feels pushed up is support (`machine.senses.borne`): in her
  support region, grounding her, her soles standing while it bears. Its sensed
  force fed to her whole-body step a pass late chattered: 695, 250, 88, 539, 131
  N on the seat 30 ms apart, her soles 0 to 286 N; unfed, seat and soles shared
  her weight, 100 N each.
- Her free soles were held in her pelvis's frame, as in flight: pitched forward
  0.5 rad on a seat they rose 9 cm. Something bearing her and no sole standing,
  they are held up from the floor in her way's frame.
- Her soles unloaded, the step took her base as free: her trunk pitched from
  0.95 to 1.42 units and she slid off the seat. Each bearing segment a contact of
  the step - three unknowns at the touch's centre, its point still, its push in
  its cone -: seated 1.95 to 8 s, the seat 190-220 N, each sole 30-50 N.
- On a mattress's soft edge the step planned 311 N where it bore 107, and she
  rolled back; a contact's push no more than 30 N over what it bears now: she
  reclines 0.44 rad on the edge 5.8 s and rises. Reclined 1 rad, her pelvis
  pitched with her trunk - one pitch mode for both -, her thighs rose with it and
  she slid off.
- Rising: the old thrust's 6000 N/m threw her soles 15 cm up; a lean of 1 s
  before the thrust overshot her trunk to 1.5 units and her capture point stepped
  her out of a squat; a lean of 0.5 s under a thrust blended over 1.5 s, she
  rises at 0.13 m/s.
- Not kept: standing soles pressed 20 N while something bears her, a contact's
  friction half a sole's - the chair fell rising at 11.9 s.
- The referee: 'sat' and 'lay' count what bears her off her soles, on her soles
  her soles' own loads; the bed side-on, its edge 0.1 m behind her (lengthwise,
  its headboard stood in her).
- A fall is a part of her above her shins on her ground (`floor.grounds`); by
  her doing's name, lying on a bed was one.
- The bench: scenes 62 of 87 (chair and bed up), the 80 N polar and the replays
  as they were; 200 N as it was, standing 14 of 32 met, walking 21. Chair 13 of
  13 wobbles; bed 7: at -5e-4 she sat over her right sole on the mattress's edge,
  2 and 219 N, 22 N on the edge, and a sole lifting stepped her. Seated deeper
  and slower, 3 of 13.
- Rising off the bed at -2e-4 her pelvis's geom was over the mattress's front
  corner - 2.1 cm from its edge where the chair has her 6.7 -, the contact's
  normal 23 deg ahead (0.92 up, 0.40 on). As the sit-up's blend ended the step
  planned 145 N up of the 358 asked, a contact let go in its last round (wrench.md);
  the corner took 241-309 N along its normal and threw her on at 4-6.7 m/s^2
  against -1 asked, a 0.27 m step; the other sole, the step's counterweight on
  one (W_COM 1000, W_SWING 30), rose to 0.34 m and never landed.
  `wrench.pushed` takes every prop's normal as the world's up.
- The step held to its band: the bed 10 -> 11 of 13 wobbles, its two falls
  lying back (5.15, 6.24 s) gone. She sits deeper on it, her centre of mass 14
  cm behind her soles' middle as the sit-up ends, and a rise waits while her
  capture point is off her soles and something bears her (161 passes at wobble
  0). The bench as it was but the bed, up at -2e-4, down at 2e-4: there the bed
  bears half her weight 0.51 s of the 1 asked. At -5e-4 her soles' loads swap
  side to side every 50 ms rising, the mattress's share flickering 0.17-1.0,
  and she goes back over her heels (12.75 s).
- Not kept: her height held while something bears her - raised to as she is by
  the share off her soles -: the bed 9 -> 6 of 13, falling as she lay back where
  the soft mattress had her deeper than asked.
- Not kept: her pelvis's pitch apart from her trunk's (a `pelvis_pitch` mode, 0
  at rest - her walk the same to the digit): her trunk reclined 1 rad over a
  pelvis kept at 0.5, the bed 11 -> 5 of 13; her pelvis bore 200 N on the edge
  at 3.5 s and none at 4.0, nothing under her trunk, and she rolled back off it.
- A foam's mattress (0.08 s, 10 cm) under a quicker `lie_bed`: lying at 2.2 s
  where 4.2, still at 3.4 where 6.3, 7.5 cm in where 5.5; 1 fall in 13 lain
  where 2. Quicker on the firm one, 5.
- A sole let go as she sat, the other standing, rose where her folded legs put
  it (`swing.free` held a free sole at the floor only with none
  standing): the chair 0.4 um off, off the seat 36 ms at 2.07 s and back on it
  at 488 N, her left sole 0 N, up 2.2 mm at 2.22 s and 7.3 at 2.29, and she was
  thrown off the chair at 4.1 s, 1 of 16 offsets. Each sole that does not stand
  held at the floor while something bears her: 16 of 16 seated and risen, the
  others' trajectories and her walk the same to the bit. Not kept: a prop kept
  on its last felt force within 2 mm of where it bore, 6 of 16 risen.
- Her legs as what bears her holds them (`modal.poses`): sat on the chair
  the crouch's column asked her ankle 25.4 deg past hers, her hip 28.6 short
  (chair_low 33.8, 37.0); the seat's chain (`modal.seat`, her legs to 0.1
  deg) blended by her support asks 7.8 and 6.2, the soles' 0.15 the rest.
  Her legs, the contacts', moved not at all; the chair and the walk the same
  to the digit; bed_rise, unmet both, fell at 19.7 s and now never rises.
  `HUNG` adds her pelvis's pitch to a let-go hip where the chain subtracts it.
- On all fours (`machine.moves.fours`, test_fours), her toes and fists, limbs
  plumb at the dog trot's -0.06 rad: knee 1.68 rad, hips 0.648 m up, her
  legs 0.48 of her. The text's 0.68 is her centre 0.099 m back; no contact
  metric moves it - a static stance's vertical loads are its statics' (her
  drives' held torques, arms 22.3 N m, legs 43.0: 6e-16 of her).
- The torus clock at the text's 8.5/s locks each symmetry from any start in
  0.64 s or less. Trot to crawl keeps two limbs bearing along the torus's
  shortest arc; the offsets taken as numbers turn the right fore three
  quarters and leave one bearing at 0.26 of the morph.
- Four contacts on one plane cannot all be squeezed alike: 6.1 N short of
  32 (a braced quadrilateral's self-stress); three can, to 3e-14.
- The kernel's six ground origins laid rigid on a hard floor
  (`machine.world.groundwork`, test_groundwork; her 30.8 kg as built): the supine
  rests on its dorsal patch, pelvis and head bearing, her torso 9.8 mm up.
  On her shins and toes the tall kneel's centre is 79 mm past her knees, no
  rest, until 0.60 of its axial column (knee 115 deg, pitched -17 deg). The
  quadruped bears on fists and toes, her knees 111 mm up; the tripod's fists
  hold her pelvis 63 mm up; the prone's +0.45 rad shoulders, unabducted, put
  her arms under her chest, her front 211 mm up. Her ankle's 45 deg never
  lays a foot's dorsum flat: she kneels on her toes. The 90/90 bridge turns
  a hip 39 deg, hers 25; the quadruped's neck -49 deg, hers -45.
- Rolled onto her side on a hard floor, her arms at her sides she climbs
  47.3 J (74.0 N m) and lies on her downside fist; the overhead slot 10.3 J
  (26.0 N m), its fist still lowest side down; the cantilever 3.0 J, her
  centre 15 mm toward the roll. Her head clears the floor by 45 mm round the
  turn; the helical wave turns her waist 21.8 deg of its 50.
- The roll law's trough at its soft threshold, 65 N/mm: 4.65 mm, 0.70 N m.
  Its 110 N heel push 0.163 m from her right buttock gives 17.9 N m, equal at
  2.55 N/mm; its cantilever (hip 0.95 rad, knee straight) holds that heel
  0.73 m up. Its m g / (2 k L) is a length only with k L the floor's
  d Fz / dz.
- On soft ground (`machine.world.substrate`, test_substrate): the work loop's
  energy return of a linear contact is exp(-2 pi zeta / sqrt(1 - zeta^2)),
  so its regimes are damping ratios: harmonic under 0.076, plastic over
  0.28 - an elastic foam damped at 0.5 returns 2.7 % and reads as snow. Her
  30.8 kg's stroke fits the identifier's 35 ms only past 62.1 N/mm.
- Her patches: sole 213 cm^2, fist 28 (the text 25), shin 334, forearm and
  fist 153, thigh 565, buttocks 522; shin to sole 1.57 (the text 4.8),
  forearm to fist 5.42 (5.5), thighs to buttocks 2.16 (3.2). Her pressure,
  kPa: standing 7.1, a landing at 1.25 of her 17.7, kneeling 4.5, fists on
  all fours at the text's 0.34 18.2, forearms 9.9, sat 5.8; snow's ceiling
  14.
- A power law's stiffness at load F and sinkage z is n F / z, whatever its
  moduli: the tamp's 42 N/mm opens under its 0.28 of her weight only within
  2.0-4.0 mm of sinkage (n 1-2), 7.2-14.4 under all of it; at its 260 mm it
  stands at 0.008-0.016 of the gate.
- Her centre held still, her push on a bed is her weight, constant: the bed's
  energy about its loaded rest falls by its own damper alone, to 9e-7. A bed
  damped 0.076 with her on it keeps 0.13 of its energy after the text's 1.5
  periods if as heavy as her, 4e-4 if a fifth. The kip's 340 mm takes 263 ms
  and 102.9 J; her hips and knees at its 12.5 and 14 rad/s keep their 108
  N m (48 V, 16.8 rad/s at most).
- Off her feet (`machine.moves.crawl`, test_crawl), the crab at her capacity: its
  hips turned out to their 25 deg stop, her shoulders not at all. So turned,
  her abduction moves her ankle sideways 0.74 of its stroke (0.30 m for
  +-20 deg), her knee 0.60, her hip's turn 0.07, her elbow 0.08; her trunk's
  lateral bend carries her shoulders 0.37 m. Its straight arms plumb at 1.04
  rad of shoulder extension, she rests on soles and fists pitched 59 deg, her
  pelvis 226 mm up, her legs 0.378 of her; static N m (held): hip 31.8 (43.0),
  its turn 18.5 (43.0), knee 9.8 (41.8), shoulder 1.0 (22.3), elbow 1.2
  (22.3). Belly down, the dog's origin turned out so rests on toes and fists
  pitched -73 deg, pelvis 512 mm up, legs 0.274; hip 16.8, knee 17.6,
  shoulder 8.8 N m, each within its held. There her abduction moves her
  ankle sideways 0.91 of its stroke, her hip's turn 0.91, her knee 0.42.
- A sled's anchors hold its drag only carrying over mu_sled / (mu_anchor +
  mu_sled) of her, 0.44-0.48 on the patches' frictions: the scoot's (0.75)
  hold 0.601 of the vault's half turn, the stairs' (0.65) 0.469, the hip
  drag's (0.28) and the army crawl's (0.35) none.
- A dead leg (`degraded_scoot_and_crawl_*.lisp`, `crawl.partitioned`): her
  freewheeling knee holds 1.23 N m of backdrive, her shank and foot (2.31
  kg) level turn it 4.6 - it folds; a 0.22 rad roll onto one buttock lifts
  her far hip 35.6 mm (163 mm across); her heel 30 mm off her midline, her
  hands 148, the dead side's arm pushes 1.20 of the other for no yaw; her
  anchors hold the low crawl's belly from 0.441 of her, the seal drag's from
  0.509.
- Laid rigid, the dog's origin rests on its hands and toes; her back's bridge
  lies on her arms, its feet 313 mm up; the scooter's heels and fists hold her
  pelvis 25 mm up.
- The supine ratchet: a 175 mm riser takes 52.9 J; the text caps her
  shoulder's extension at 28 N m, her shoulder holds 22.3 for ever; its 18 mm
  skim is a 0.59 m/s, 5.4 J drop.
- At a seat's or a bed's edge (`machine.moves.bedside`, test_bedside), standing:
  her heels reach 54 mm behind her hips (0-0.06 m up), her calves 43 (to
  0.43 m), her thighs' backs 46 (to 0.76), her buttocks 148. The chairs'
  seat edges and the lodge bed's side (0.10-0.44 m) meet her calves, on no
  patch of her registry; an edge over her knee meets her thighs' backs, her
  posterior femoral patch. From the turn's standoff the stool meets her in
  62 mm, the bed in 42; the text seeks 110.
- Seated, legs hung (the canonical seat): her centre 86 mm ahead of her
  buttocks, at her spine's 30 deg extension stop still 35 - she cannot lean
  off a stool backward. Her centre over a 340 mm stool's middle, her ischia
  are 45.4 mm inside its rim upright; its 40.8 mm margin holds to a 0.045
  rad lean (the text 0.09). Her hung shank swings at 0.912 Hz (the text
  1.15). On her toes at her 45 deg stop her buttocks rise from 0.771 m to
  0.841. Her leg is 845 mm hip to sole (the text 890).
- On the lodge bed: lying straight she reaches 0.750 m over her pelvis,
  0.900 under; her pelvis lies 0.835-1.300 m from its head. Sat her deepest,
  her calves at its edge, her hips are 0.316 m in, 0.134 off its line; on
  her back, arms at her sides, 0.609 m wide - inside the roll's 140 mm
  margins only within 5.4 mm of the line. Her hip holds a leg out straight
  with 18.1 N m of its 43.0.
- Rolled from her back onto her side in the roll wave's posture she drifts
  0.310 m, a radius of 0.197 (the text 0.165). Her spine's 35 deg lateral
  stop moves her pelvis 186 mm across her shoulders (the text 185, its cot
  210); from the pendulum's 134 mm the escape scoots her 0.443 m that
  quarter, three strokes. On the 720 mm cot's 500 mm between margins her
  elbows fold 0.95 rad more: 499 mm wide.
- Onto a stool at her hips (`overheight_*.lisp`, test_vault): her hands
  bear on fists, a point each, so hung from them she leans back 40 deg at
  her lockout (her elbow's -5 deg stop, the text -13) to 76 at the dip's
  end. Her lockout lifts her pelvis 31 mm from the dip's origin (the text
  42); the dip lowers it 167 mm (235), her hip then 11 mm under the seat.
  At the anchors' 0.92 of her: shoulder 34.5, elbow 42.7 N m (peak 51.3,
  held 22.3); her heel hooked bearing 0.45, 20.6 and 25.5.
- At the edge her thighs bear 0.18 of her; wrapping it 26 deg from the dip
  they drag 30 N. A 5 kg stool of 200 mm base, its seat at her hips 0.844
  m, keeps its centre 46 mm off its middle, 110 mm inside its margin; it
  tips at 0.185 of its load in shear, the text caps 0.38. Seated her fists
  reach 252 mm along the seat either side of her shoulders. Her forefeet
  take her from a seat of 0.738 m, dipped 0.822; from there undipped she
  drops 84 mm, 1.28 m/s, 25 J.
- Her seat as the kernel's pressure box (the ischial box of
  `anatomical-manifold-registry`, x -90..110 mm, y +-145 mm), where her step
  holds each seat contact's point and its split pinned to the felt (W_PIN,
  [seat](seat.md)): a probe on the Python twin of her upright step laid each
  patch she sat on at the box's corners round its felt centre, in her way's
  frame, a quarter of its force each, its split unpinned while she sat. In
  the twin as on the bench stand_to_sit and sit_to_stand fell; the root of
  stand_to_sit's fall (5.645 s, her arms 1 511 deg/s, her right elbow 17.9
  times its clamp) is her turns against a pinned support, her head and arms
  its reaction masses: replayed without the turn rows or the pin, the step's
  scale stays 1.00. Cornered on any seat the beds regressed (bed_leg fell at
  9.00 s); on firm seats alone her passes past her clamps went 19 -> 1 on
  the chair and 7 -> 0 on the low one and both takes stood, the beds and the
  floor the same to the digit, but the thighs' force moved past her hips; on
  her pelvis alone sit_to_stand fell at 11.31 s, each corner on the segment
  under it chair_low at 12.23. Not landed: the box lies flat in her way's
  frame, and on a low chair her thighs slope and the seat is bounded, so its
  corners land off what bears her. Open: the box clipped to the seat's face,
  each corner on the segment under it there, as `emancipation.seated`
  corners a seat on the floor.
