rogerisaksson/coaxial_63100/docs/findings/body.md

# Findings: body

Build, buses, falls, drawing and clothes; the drives in
[drives](drives.md), the board's findings in [FINDINGS](../FINDINGS.md),
her latent loop in [orthokinematics](orthokinematics.md).

## Model

- MuJoCo, 55 kg, 26 drives, 1 kHz: on the line the legs stand
  in a V, 8 cm out at the hip for 3 at the foot, needing 0.773 m of 0.770:
  the IK clamped, a foot hung 3 mm off the floor, the body tipped over it;
  the pelvis 12 mm lower. On one leg no stiffness held (x5 4.8 s, x20
  unstable); the CoM fed back through the pelvis's target did.
- Hair on two hinges under the crown, 0.06 kg at 1.8 Hz: 17 deg fore and aft
  and 6 aside, walking.
- Jeans' legs softly stopped at 14 deg swung to 19, the shin 35 mm out
  through their sides, the sneaker 64. Stiffly stopped at 5, 8, 3
  (`mjcf.HEM_*`), a 74 mm hem on the vamp: the shin inside, the sneaker 5,
  the other foot 12 in where 16.
- Jeans as MuJoCo cloth (`flexcomp`, 3.14.0), the 1 ms step 0.31 ms: two
  grids of 400 vertices over the shanks 19.2 ms, 100 vertices 1.06, 100
  touching the body alone 0.47, 48 so 0.31. A coarse reference runs live, the
  denim not.
- The whole body collides (`figure.BODY`).

## Buses

- Boards on their buses, simulated (`machine.rig.buses`):
  + A bus a limb (the type's subsystems: the axis, each arm, each leg), a
    process each with its boards' PD loops, in lockstep with the world a
    step at a time over a shared block (q, qd, limit in; ctrl out; a byte on
    stdin a step); the host's frames real bytes on a TCP socket a bus
    (`socket://`, an emulated limb's port).
  + Modbus RTU (`machine.rig.rtu`): a pass is one 0x10 broadcast of the bus's
    setpoints (9 bytes and an i32 mdeg a unit, SETPOINT_REG) and a 0x03 poll
    a board (8 bytes; reply 13: angle and rate, i32 mdeg and mdeg/s,
    STATE_REG); a frame lands its bytes after its stamp at 9 216 000 baud
    (USART2/UART5's rate in the .ioc; 115 200 is the debug VCP's alone),
    8N1; a reply the board's 30 us turn after the poll; nothing sent on a bus
    still busy a pass on.
  + A leg's seven boards hear a pass's setpoints 40 us on, the host their
    state 0.4 ms on: held 89.8 %, stir 3.55 mm, as with threads (89.8 %,
    3.53).
  + Lockstep of five processes: 19 us a step spinning on the block, 37
    spinning then a semaphore, 46 the semaphore alone. The walk's step 1 431
    us wall against the threads' 1 710 (GIL hand-offs); the buses' share
    ~350 us a pass (a sendall 21 us a bus, a pipe byte 10 a process, CRC and
    parsing ~115); 0 bad frames in 10 000 replies.
  + The setpoint rate a board carries on at is read between two frames, never
    from a hold: from the reset's hold to the first frame 37 us later it came
    to 150 rad/s and every drive slammed to its peak.
  + A world with no buses runs the drives itself (`machine.process.sprung`).
- Five processes (the axis's 5 boards, each arm's 4, each leg's 7), 0 bad
  frames:
  + With the heat in each reply (21 bytes) a leg's wire is busy 430 us of a
    1 ms pass.
  + Each board keeps its heat (`machine.body.heat`: thermal.c's envelope on three
    lumped nodes, the 5230SL through a 1:64 cycloid, heat at 10 times the
    clock).
  + A knee warmed to 100 C (0.93, derated 0.73) walked on, 0.98 2.5 s later;
    in its SOA (on-resistance x50) it dropped its gates under 107 N m, armed
    again 54 ms later, its derate back to 1 in 2.8 s, walking on.

## Falls and stops

- Contacts: seat, back, chest, skull, arms, thighs (`figure.BODY`).
- Pads where falls land, 5 mm of gel (`figure.PADS`, `mjcf.PAD_SOFT`): stiff,
  it bounced, median landing 19.6 kN, bare 6.0; over 12 falls against none,
  the padded parts' landing peak 5.99 -> 5.32 kN at the median, its spread
  3.00 -> 2.53.
- Down after a sill the spine bent back 98-101 deg; stopped (`mjcf.STOPS`)
  31-37.

## Page

- The drives' callouts (HUMANOID page) dock at the viewport's edges, a leader
  to each pivot: beside the figure at 0.42 m they were three cells and
  crossed the stride.
- The page threw at a zoom of 1.1^3: a callout placed at its joint's height
  at rest, the joint past the drawing's edge, was written past the last row.
- Callouts 34 cells a joint -> 20 in the tty's frame, the name on a patch in
  its drive's heat colour (`ansi.thermal_rgb`).
- Playback: the frames drawn at 15 a second showed the same
  state again 65 times in 235, the rest 0.036 s of simulated time apart on
  the mean with 0.022 of spread; the process runs 0.7 of real time in slices
  of 0.05 s. Played 0.2 s behind the newest state on a clock of its own, its
  pace eased over 0.5 s, the states between blended: the same state again
  once in 234, simulated time per wall second 0.22 of spread where 0.62. The
  drives' six-field readings had cost the loop's `flat` twice its time; a
  float taken as it is: 0.53 -> 0.64 of real time.
- What her law sees, reviewed: her edge's array alone - an IMU in its own
  frame, encoders, load cells, skin in each segment's frame, no place or
  speed of hers in the world - and her own model as her estimate poses it;
  her floor and its pitch from her soles. Her law in C is given her law's
  arrays alone. The world is written by the drives' torques, a lay, a scene
  and a shove; its harness is the stand's (`test_sysid`). test_structure
  holds it, `borne`, `grip` and her law's C now among it; the fallen limp
  took the world's joint angles where her encoders give the same bits.

## Mechanics

- The hip's drives kept on the pelvis's side, its pitch on its axis:
  on the thigh 0.12 m down with rods to the pelvis they would
  add 0.038 kg m^2 to the leg's 1.685 about the hip, its ~140 deg past a
  crank's dead point (the ankle's rod spans 95, 39-41 deg at worst), and
  ball-joint play where hysteresis shows. The femur and tibia hang from their
  drives' gearbox collars (`skeleton.HUNG`), no longer through the drums'
  centres, 40 mm into the hip's; the pelvis's boom 30 mm round, 170 N m on it
  147 MPa.
- The ankle's rod bent down the calf's inner back (`linkage.BENDS`), its ball
  on the heel's back 20 mm in: clear of every part over fit's 45 poses, 2 mm
  of its drive at full dorsiflexion; straight inside the leg it stood 51 mm
  out of the shell and 15 of the jeans, now 52 and 5 behind the calf.
  Rejected: arms at 33 and 34.5 mm with the hub kept (the walk from the
  squat fell at 13 s); the drive 15 mm ahead (two falls put the head down at
  1.6-1.9 m/s); the crank outside (the thigh's boards met it sat back, 15
  mm).
- The ankle a parallel pair (`linkage.PAIRS`):
  + Two M drives at 1:68, 80 and 150 mm under the knee, each a 12 mm carbon
    rod crossed from a crank on its drum's gearbox end at the knee's front,
    bent down past the drums to a horn on the heel's back 12 mm out or 16 in.
    The ankle's shell, 32-36 mm round, leaves any rod's line within 25 mm of
    the axis: on 48 mm arms the balls stood 26-29 mm out.
  + Pitch both together: lever 0.75-0.91, 160 N m, 652 deg/s. Roll one
    against the other: 0.60, 105 N m. Each board's current the pitch's share
    plus or minus the roll's, within its 25 A (`buses`, `physics.paired`).
  + Inside the shell and jeans standing, fit clean over its 45 poses;
    scoreboard 495, held 68.3 % (the L and its rod: 535, 64.5).
  + Skeleton colliding: 542, 62.3 %, never the floor: inside the shell,
    outside the skins' capsules, the toes' belt sank to it with the sole and
    felled the body; a knee's drum landed past its gel, 935 N against 102 bare.
    Colliding, shoved past saving into the crouch, the head met the floor at
    1.03-1.66 m/s in 3 of 64 falls, without at 0.66-0.81 in 2; one with
    nothing of the skeleton touching: chance. On her loop, colliding,
    she walks as without: 51 s, 0.69 m/s, 299 J/m, 2.45 off the band
    where 300 and 2.46; a pass 1 651 us where 1 610.
- Every drive's output on its drum's axis from its gearbox's end
  (`tools/sim/fit.py`'s outputs). Before: the ankle's L along
  the shin turning its crank about the knee's axis; the hip yaw's gearbox
  facing up, away from the hip; the elbow's and wrist's belts turning about x
  off drums along the arm (across it the drums stood 3-26 mm out of the
  shell, so a bevel pair at each gearbox's end, `linkage.BEVELS`); the spine
  roll's M 90 mm off its joint, nothing between.
- The hip a gimbal of parts (`skeleton.gimbal`):
  + The yaw's M on the pelvis turns a fork (a steerer; a crown over the
    pitch's L; legs before it 20 mm in, behind it 20 out) to the roll's
    bearings 55 mm either side of the hip's centre; the roll's M rides the
    fork, its spur pair into the cradle round the L.
  + Each drive's stator on the stage before its joint, a body of its own
    (`build.riders`, `physics.STAGED`), 4.6 kg off the pelvis, 35.95 kg kept.
  + The boom 60 mm across and an arm up to each yaw drive: across, it lay on
    the L, their inner corners 16 mm higher rolled 25 deg, no crown between.
    fit clean over its 45 poses once the femur left its collar 34 mm out,
    not 28.5 (knees under the body it met the fork's front bearing, 1 mm).
- The trunk's roll drive: the shell at the spine's pivot 70 mm
  ahead and behind, 102 to the sides.
  + On its own axis a roll M stood 47 mm out of it, 10 past the clothes
    ahead, 27 behind.
  + A rod from the pelvis to the roll's stage crosses the pitch: its ball on
    the pitch axis, rolled 10 deg and pitched 60, it read 10 of false roll;
    its slant took the roll's lever through zero near 58 of pitch.
  + A bevel differential across the pivot fitted (two M at x +-55 mm), but
    its bevels carry the drives' 87.5 N m each, 4.4 kN on a 20 mm radius:
    steel needs ~70 mm across, the drums then past the shell; sat back on the
    heels, hips -163, the femurs met its drums 3-6 mm wherever the knee's
    board left room.
  + The roll's M on the pitch stage beside the pivot met the hip's yaw drum.
  + Taken: the roll first (`figure.SEGMENTS`; a replica, not an exact copy):
    its M on the pelvis, 10 mm lower, a 1:1 spur pair into it; the pitch's L
    on its stage, 13 mm off the M; the hips' yaw drums rolled 35 deg; fit
    clean, the M 4 mm inside the skin; scoreboard 582, held 64.0 %.
- Drives held (`skeleton.HELD`). Before: the
  hip's roll M, the ankles' and the toes' held by nothing; the arms' and the
  trunk's only by wires through them. Now: the roll M on two collars and
  struts into the fork's back leg; the yaw M's collar on the boom; the
  ankles' M on struts into the tibia; the toes' S on the foot's keel; the
  humerus and the forearm clamped to their drums' collars and on under the
  bevel to a clevis; the tibia's clevis round the ankle's cross. A bone is
  checked against each drum it does not clamp: the femur went 30 mm through
  the hip's yaw M at the sit back's asked -163 and meets it past -142; the
  hip reaches -130 at most, the torso stopping the thigh. The gimbal rolls
  -35..+28.
- The trunk framed (`skeleton.TRUNK`):
  + The boom ran through the roll's M: its middle 28 mm down under it, the M
    on it; 40 mm back, a hip's roll M yawed 18 deg met it, 17 mm.
  + The pelvis's fork to the roll's bearings 66 mm before and behind the
    pivot; its front legs 55 mm out past the 1:1 spur pair and in under the
    bearing (a bar across met the pitch's bracket at 75 deg rolled 35, 11
    mm), its back one on the middle.
  + The pitch's bracket arched 52-85 mm over the roll's band to the waist's
    M, now 120 mm up the torso, its gearbox down (the mass model had it at
    the pivot, inside the pitch's L).
  + Over spine -30..85, roll +-35, waist +-50 the closest 2 mm; every drive
    held (`skeleton.HELD`).
- Sneaker, size 38, in shape and physics (`coaxial/graphics/sneaker.py`):
  + 237 mm long (the heel 55 behind the ankle, the ball 117 ahead, the toes
    65), 94 wide at the ball, 76 tall at the heel, 15 mm of toe spring; the
    gum sole 28 mm at the heel, 18 at the ball; 0.25 kg (`build.HOLDS`).
  + The forefoot's bend is the toes' spring, 10 N m/rad (`drives.passive`);
    grip and give in `machine.body.mjcf`.
  + A bare quarter render reads as a low-top sneaker, the toe box rounded,
    the sole band seen.
- The shell fitted to the skeleton as sized, the clothes over it
  (`tools/sim/fit.py`). Standing, past the shell: the hips' yaw
  inverters +6 -> -1 mm (the pelvis's rings at 0.07 and 0.11: 130 and 106 ->
  140 and 114 wide), the head's turn +4 -> -1 (the neck 5 mm fuller), the
  knee +1 -> -1 (the femur's and tibia's ends 2 mm fuller); left: the toes'
  stack +20 in the shoe, the elbow +2. The shell past the clothes, measured
  since (`tools/sim/seams.py`): the cheeks 19 mm out of the jeans between the
  seat and the thighs' legs -> the seat's crotch 20 mm lower, its bottom
  rings 110 and 95 wide, 130 back: within 1 mm, the rest 3-27 inside. A held
  drive's bevel pair crashed the page's mechanism view (no drum on the
  wrist): skipped, in test_render.
- Tubes cut from stock (`tools/sim/members.py --family`): of 13
  stock sizes (1 mm walls to 25 mm round, 2 from 30) the lightest family
  passing every member within 2.5 mm of its radius was six (12x1, 20x1,
  25x1, 30x2, 40x2, 50x2), 0.67 kg of tube against 0.68 in nine sizes; seven
  as built: 35x2 for the tibia's lower run (40 met the ankle's rod by 6 mm in
  the crouch), every tube in the shanks' high-modulus grade. Changes: the
  femur's lower run 50 -> 40 (flex 0.25 deg), the boom kept 50 (0.30 at 40),
  the neck 18 -> 20 (0.28 -> 0.20), the hip fork's arms 22 -> 25 (1.02 of
  their allowable at the hips' 203 N m peak at KV 110 -> 0.78), the humerus
  24 -> 25, the forearm 22 and 18 -> 25 and 20. Marginal: the tibia's lower
  run 0.31, the femur's 0.25, the roll's horn 0.26.
- Members sized for stiffness: at 0.6 of their drives' peaks
  at most 0.25 deg each; roll-wrapped carbon E 70 GPa, G 20.

| Member | Stock tube | Room | Taken |
| --- | --- | --- | --- |
| femur | 60 x 56 | 50 | high-modulus 50 x 44, 0.14 deg; 36 at its top |
| tibia | 60 x 56 | 40 | 40 at its top, 30 past the rods, 20 its clevis |
| boom | 50 x 47 | 60 | 50: a hip's pitch twisted the 30 mm one 1.3 deg |
| hip fork | 22 x 20 | 24 | legs 22, bearing arms 18, crown a carbon plate |
| spine fork legs | 35 x 32 | 24 | high-modulus 24 front, 30 behind |
| trunk column, girdle | 50, 35 | 40, 30 | high-modulus 40, 30 |
| humerus below its drive | 35 x 32 | 20 | high-modulus 20, 0.37 deg |
| forearm below its drive | 20 x 18 | 14 | high-modulus 16, 0.14 deg |
| drums' struts | - | - | printed 20 for the rods' 3-4 kN |

- The arms' 12 mm tubes bent 7.7 deg under the elbow's 50 N m. Printed
  PAHT-CF takes a solid 30-80 mm round where carbon takes a 20-60 mm tube:
  printed parts short and stout. The boom steep to the yaw drives: at 45 deg
  the hips' L met it, 8 mm. The fork's crown a tube met the femur's collar, 4
  mm. The neck's bracket 10 mm, the head's 0.77 kg on it; 25 stood 15 mm out
  of the neck.
- Printed parts without overhangs: collars split rings printed axis up, tube
  sockets bore up, side holes a 45 deg roof; brackets plates printed flat,
  their loads in the layers' plane (PAHT-CF and PET-CF half as strong across
  them); seats 0.1 mm under, reamed.
- Members under their drives (`tools/sim/members.py`): each tube,
  plate, rod and strut against its drive's deliverable peak or 1.5x its
  clamp, the less; stress against the material, flex at 0.6 of it against
  0.25 deg.
  + As they stood: the pitch's bracket (12 mm) 8.1x its carbon's allowable,
    22.7 deg (the spine wound up 27 deg at its 142 N m: the trunk's visible
    bob); the neck's bracket 1.3x and 3.2 deg; the hip fork's 10 mm steerer
    3.7x in the yaw's torsion, its crown's diagonals 7.1x; the shank's lower
    run 1.2 deg; the arms 0.75-1.2x.
  + Sized: the bracket 36 mm high-modulus (40 took 9 mm of the waist's
    holder); the fork's legs 30 high-modulus, its back member 40; the neck 18
    at 47 mm out (20 took 6 mm of its collar); the steerer 24; the fork's legs
    30, its arms 22; the femur's top 40; the tibia's lower run 36 (40 took 5
    mm of the ankle's rods); the arms 24 and 22. 3 of 63 marginal: the
    tibia's lower run 0.31 deg, the neck 0.28, the roll's horn 0.26.
  + Joint wind-up at the clamps, structure and box: spine 1.1 deg, waist 1.6
    (its 44 mm box), hip and knee 1.1, hip roll 1.8, ankle 2.6 (the 12 mm
    rods' stretch over the horn).
  + Carbon tubes cut to length, epoxied into printed PAHT-CF holders (a
    socket one diameter deep at 15 MPa shear takes 500 N m on a 40 mm tube);
    each holder an extrusion along its print axis, no overhang in any print
    pose.
- Flex in the world (`physics.WOUND`, `drives.flex`): a board's
  encoder on the motor sees its joint wound up by its last torque over its
  gearbox's stiffness (`drives.BOX_K`, estimated 20/9/3 kN m/rad) and its
  structure's (`drives.WIND`). A loop on the motor takes no series flex: the
  servo and the observer read the motor's encoder (`physics.WOUND` 1).
- The trunk's roll on a four-bar (`linkage.PLANAR`): its 1:1 spur
  pair's 100 mm wheels stood in the pitch bracket's sweep, and a stage at
  1:40 needs 1.5 after it. An 18 mm crank on the roll's M, a 24 mm horn on
  its stage, crossed, in the 12 mm between the M's face and the roll's
  bearing, the M 7 mm back: over +-35 deg its lever 1.33 at rest, 1.48-1.73
  toward the ends, its transmission 53 deg at worst, 2.9-3.7 kN in its rod;
  over spine -30..85 and roll +-35 the closest 1 mm.
- By `tools/sim/bom.py`, `tools/sim/fit.py` and `tools/sim/members.py`:
  21 part types, one bearing
  size, one rod end, tubes of 7 stock sizes; standing, the elbow 20, the
  shoulder 15 and the hip yaw 6 mm past the clothes; over 45 poses the
  closest pairs -13 to -19 mm (the pelvis's frame and the hip roll's drum
  rolling onto her front, the arm bones and the ankles' rods sitting back);
  2 members of 61 past a limit, the shank's first run flexing 0.29 deg, the
  spine roll's horn 0.26.
- Dressed as cloth hangs (`coaxial.graphics.gynoid`): the tee a tube hung
  plumb from the chest and the bust, EASE_M 12 mm off the torso where it is
  wider below, its hem at the hips' widest, 140 mm under the torso joint
  (0.192 half-wide over the jeans; a hem 36 mm under it at 0.152 over the
  jeans' 0.118 top read as a roll); the seat's back 100-126 mm behind the pelvis
  where 130 stood a ledge over the thighs; the hair a cap 14 mm over the
  skull from the ears' line, its front the hairline up to 0.65 of the
  skull's height, where an ellipsoid 24 mm wider than the head reached the
  jaw; the fall 36 mm deep behind the occiput where 160 stood a wall.
- Bent at the joints (`coaxial.graphics.drape`, two frames a corner, blended over
  the 35-90 mm past the joint): the seat's corners on a thigh swung 35 deg
  follow it, no notch at the hip; the tee's hem follows a spine bent 15;
  a stride's frame 0.01 s the dearer. A grid-and-tendon cloth (the ICARSC
  2026 composite, 20 x 26 spheres a panel) is a page's whole budget: not
  taken.
