rogerisaksson/coaxial_63100/docs/findings/errands.md

# Her errands

What F and a click send her to - a chair, a bed, the door -: her way there,
her dock, its stunt; the scenes themselves in [scenarios](scenarios.md).

## Walked to a thing

- Told to stop, `law.held_back` held the stand for ever: the brake's sway
  kept a swing commanded on two standing soles, her doing flipped between
  `brake` and `#201` 3 781 times in 4 s, `sit_chair` held with it. Holding on
  the sole off the floor, on her rhythm's gain or a control step ahead of now
  each moved her (`walk_turn_right_at_0.69` fell, ice 1.76 m); the hold as it
  was, let go after two of her rhythm's swings (`latent.TURNS`): she stands in
  0.3 s, sits at 3.2 s, rises at 2.7 s, the 12 replays whole. Let go only
  with her capture point inside her soles, hop-after-a-stop fell.
- Her doing read at the world's passes between her law's: a stand her law held
  came and went at every pass, 596 flips in a stop, the page's arrows with it.
  Read at her law's last pass (`se2.doing`), 2.
- A hold let go kept its start: a hop said 2.1 s after a stop, her still
  stepping, was let go at once onto one sole (275/0 N) and fell landing at 3 of
  9 wobbles; each hold counted from its own, 1, after a 38 N push.
- The ice scene's `past 1.8` was that shuffle: told to stop at 1.49 m she
  crept on at 0.045 m/s to 1.88 m; let go she stands at 9.0 s at 1.76 m. Its
  goal is 1.7 m.
- A walk asked of a stand swaying over 0.04 m/s got a stand first and the gait
  1.35 s later (`worker.heard_say`'s `off_c`); at rest she sways 0.05, after
  a stop 0.05-0.16, so every W waited 1.35 s. The sway term gone, init_walk
  comes with the ask, her posture and loads still gating it.
- W held through a scene change: what she felt of the chair (`g['_felt']`,
  3 s) outlived the world laid anew and deflected the walk into a sidestep at
  0.29 m/s. Cleared on the reset, init_walk within 10 ms, 0.49 m/s at 2 s;
  the page tells her the keys' twist again as it sees the new scene.
- On a scene laid anew (`gym._run_scenario`), the pad's cached `setpoint` held
  the prior twist and swallowed the next W asked at once; cleared on scene
  reset, a walk asked at once begins in 1 ms. `arrows.describe` draws the stop
  mark only on `STOP_DOING` and the going arrow only on a commanded twist.
- Told to stand from her walk she goes on 0.70 m and is still 2.7 s later, at
  0.81 m/s felt whatever speed was asked (0.25-0.69): she has the one walk
  (`se2.STOP_M`). A left sidestep moves her at her heading plus a right angle,
  0.12-0.35 m/s, 0.00-0.15 m on after a stop; her back-walk 0.09 rad off dead
  astern, 0.05 m on. The errand from the viewport (`tour.step_errand`: stood
  where her stopping point enters the box before the dock, the look-ahead on
  the prop's normal, a turn, a sidestep, backing onto the edge) docks her at
  the chair with her heels 0.05 m from its edge, seated at 18.8 s, and reclines
  her into bed_rest at 29 s, surety 0.97. Before it: a stop radius of 0.6 m
  from 0.69 m/s overshot the staging point by 0.95 m, and a cone of 0.3 rad
  flipped her between walking and turning in place every half second, 16 s
  round one spot, surety 0.36.
- Her stop's spasms: the brake cuts her drive in 500 ms and lets her stride go
  (`a[STRIDES]` 1 to 0 in a law pass) mid-step at 0.5-0.9 m/s; her step's
  rounds, its projection gone, trade what her soles cannot give to her arms
  and head - a shoulder at -294 rad/s^2 (under 6 with her stride held), -99
  deg at 1 168 deg/s. Her stand lets her neck go while her rhythm's gain falls
  to 0.05 (the brake's hold reads the gain told, the rest's the gain as it
  is): 97 deg at 900 deg/s. The suite's stop (`dock-terminal-stance`) laid on
  her loop - from her lateral crossing every voice's amplitude to 0 on the log
  brake over two bars, her stand at its end, her clock's rate kept - meets the
  22 held scenes unwobbled and stops a steady walk with her arms at her walk's
  own swing, her neck at 16 deg/s at most, her stride let go at 0.16-0.23 m/s;
  but she goes on 1.24 m and is still 3.9 s after the word (0.72 m, 2.2 s by
  the same reading), and in the lodge her errands lose to her stops by the
  furniture and to the clock: the chair 66 down and 29 short of 112 (38, 7),
  the bed 9 and 52 (3, 4). Her clock slowed with the rest stalled her last
  swing, a sole 16-21 cm up for 0.9-2.0 s, 3 runs of 4 down; her neck held
  through the stand cut the runs whose neck spasm is at a stop 52 -> 22 and
  moved the trade to her arms (corner stops' median 208 -> 261 deg/s). Not
  kept.
- Asked flat on the bed from recline (pitch -3.0, sagittal -2.5) she lies at
  -84 deg by 6 s and rolls: yaw 3.7 to 157 deg, the bed's share 1.10 to 0.20,
  surety 0.51, the rise stuck in sit_up; sagittal -3.5 with her arms back
  falls off the bed at 6.6 s. Lying flat waits on her trunk's contacts as her
  support (item 1); mocap: lying down from sitting takes 5.7 s, the hips
  0.45 m back, the feet from the floor to the mattress.
- Seated on the bed's edge from the errand (the page's recording, 17:56), her
  soles reach the floor and her support flickers between the mattress and a
  sole - the bed's share 0.96, 0.28, 0.99, 0.29, the loads 0 and 98 N - and the
  whole-body step takes the trunk's moment from her right arm: wound 421 deg
  on the page, -53 to -362 in 6 s here, the chair the same (-186, -310). Her
  shoulders have no range; given a human's (60 behind, 180 overhead) the arm
  pumped within it (+74 to +157 in 0.75 s) while the flicker lasted, and the
  stop met her back-walk's arm swing (65 deg back) and the standing turn at
  the dock: she fell onto the bed, where without it she lay. Not kept. The
  stagger before it: 6 s turning in place for a
  half turn at her YAW_RATE (0.5 rad/s made of 0.7 asked), roll 9.5 deg as it
  begins, and the sidestep at 0.15 m/s.
- The door errand on CI's Linux: aimed at the errand's end a stage past the
  door, a room's height ahead at the least, she closed on the doorway's
  middle by a room's height's worth a room's height walked, met the post at
  x 0.5 for the middle's 0.75 and pushed it 8 s on Windows, 30 s on Linux
  (a probe on the runner, both Pythons). Docked on the line and aimed at
  the middle her stage (1.2 m) ahead at the least she passes at x 0.72,
  through at 7.5 s, over at 8.8 s on both; her stopping distance ahead she
  swung to x 1.18 at the other post. Left red on Linux: the chair's sit by
  its text bears 0.34 of her at 7 s on 3.12 where Windows' 1.02 (the
  perch), the viewport chair misses the seat (3.12) or falls at the dock
  (3.14), the bed's lie sits down before the bed and falls at 22 s where
  Windows finds it at 21.5 s and sits again at 24: the dock's backing stop
  and the seat's perch, item 1's.
- A human's sit (`tools/sim/seats.py`, the takes Stand To Sit and Sitting on
  Bed): 0.6 s down for 0.45-0.52 legs, the hips 0.31-0.47 legs behind the
  ankles, knees 94-98 deg, the trunk 45 deg forward on the way onto a chair
  and 14 back onto a bed's edge, seated within 7 deg of upright, the feet
  never off the floor, the upper arms within 40 deg through it and 10 seated.
  Hers on the page: feet up 0.26 legs, arms 170 deg, hips 0.04 legs back,
  trunk -31 (the lie's recline). The feet: `impedance.ask` lifts her soles by
  what a prop holds her above her legs' asked length. Left down (the spring
  relaxed by it alone) through the viewport's bed errand the right shoulder
  stayed within -53 to +52 deg where -383 to +99, seated 10 deg, soles 98 and
  90 N, the bed 0.34-0.41, surety 0.98; the chair -56 to +131, seated 15; her
  sits then against the band: feet rise 0.00, arms seated 0.3-0.7 deg, descent
  0.54-0.59 s, off it drop 0.38-0.40 legs and knees 101-102 deg (a seat 0.45 m
  high on legs of 0.77 m), hips 0.13-0.21 legs back, the arms' swing down
  54-56 deg. But a seat then bears her with her soles (chair 0.53, bed 0.39),
  not off them as the scenarios judge a sit, a chair's sole loads cross her
  touch 32 times in 8 s, and rising from the bed she fell at swing_out. Not
  kept: the sit is to be laid from the takes whole - the hips back over the
  seat, the weight onto it, the feet down, the rise.

## Errands from every spot

Every spot of the lodge's free floor, four headings: [spots.md](spots.md).

## The keys that send her

- VS Code's terminal took F3 (find next), F5 (debug), F6 (next part) and
  F10 (step over) from a page: HUMANOID's F3 balloon did nothing. They pass
  to the page now (.vscode/settings.json).

## Spin to walk

The viewport's chair errand after 0.6 s of walking (a probe of its planner's
transitions): tour's 'corner' row fired on her speed, not her approach - at
6.32 s, receding from her stop at 0.36 m/s in a spin's drift, it stopped her
(stand 7.36 s, walk 7.88) and sat her at 25.5 s. On her closing speed toward
the stop (`se2.closing`, none receding) she sits at 23.7 s; 0.5-1.0 s of
walking before the click all sit, 15.6-25.2 s. The brake's wire was chosen by
her sway's phase (sin of its lateral phase under -0.2), which read a spin as
a backward walk; it is the gait she was told (`active_entry` among the
backward gaits).

## The stage at the budget

`route.staged` took the middle of the first free run along the dock's
normal: the chair before the table staged 0.45 m out and the viewport's
click perched her on the seat's corner (pelvis 0.742, sure 0.48); the stage
is the run's point nearest the budget - her stop and the turn's stride,
`route.docks`' d_most - 0.70 m there: seated 0.586, sure 0.95; the lodge's
start sits either way (16.6, 17.6 s). In the open the two are one point.

## The dock as the thing faces

Told to sit at the lodge's low chair (the west wall, facing +x) she walked
to (-2.27, -1.18) beside it and shuttled 30 s (recordings 212533, 212600):
the room's dock, a chair facing -z, laid on one facing +x - every prop's R
is I. A chair faces away from its back (`affordance.faced`), its dock its
own edge that way (`affordance.support`, `errand._laid`): dock (-2.47,
0.00), stage (-1.30, 0.00), seated at 23.6 s; the 0.45 m chair's docks
unmoved.

## Her way to the door

Told the door after rising from the low chair she walked a straight line
at the doorway's middle - the door's errand planned no way - across the
bed's foot, tripped and fell (the page). Every errand walks `route.planned`'s
way to its stage, the door's 1.2 m inside the doorway's middle, settles
there facing out and runs out on planned corners - no curve: the push
through the yielding door is contact, and the curve's near tracking fought
the opening panel's shove and wedged her on the post at 0.92 rad for 24 s.
The grow round her things is her figure's (`figure.WIDE_HALF`, the hips
row of BODY, 0.165 + the map's half cell): RADIUS_M 0.3 grew the 0.05-half
posts 0.4 m and shut the 0.9 m doorway - no way through it existed, which
is why the door ran hand-aimed. She looks along her way each look
(`errand._looked_along`, `sight.LOOK_S`): the rest is replanned where a
thing she holds blocks it (the walk's `_cornered`, the run out's `_out`),
a new way only where the old stops existing - a stale way from the low
chair fell her at 37 s; with the look she stood, replanned and left; the
leading blocked run (her own cell inside a grown disc docking) and the
stage's cell are hers to stand in, checked they replanned her mid-stride
and she perched on the chair unsure (0.48) and fell at the door. The door
is a thing of her map at its live pose (`route.blocked`, no door
exception): closed, no way out exists and the fallback straight line is
the push; held out of her map she ground the panel onto its 1.92 rad stop
and its spring flung her at 1.66 m/s onto her thigh. A mover wakes: a
box's swell grows by its floor speed over a look (`registry.boxes`,
LOOK_S) - the hairline corridor beside the swinging panel opened and
closed with it. From the low chair: seated 22.4 s, risen, round the bed
0.41 m clear, out past the line at 19.6 s; from the start 12.5 s; no
falls. Open: charging the closed door walking (the page's click mid-walk),
the panel sweeps 0 to 1.92 rad in 0.8 s and its edge wipes her - hinge
left, the edge crosses her lane at omega r - out at 1.12 m/s askew and the
brake fells her at the deck's rail; the push belongs to the somatic shove
(`splice-somatic-object-interaction`, the Schlesinger transport, TODO 16),
or her lane the hinge's side where omega r is small, the hinge the fixed
point of the panel's move between looks.

## Her dock solved from the thing and her turn

The stage a stride past her stopping distance (1.17 m) turned her 0.56-1.25 m
off the face and backed her 0.61-1.33 m (12 starts). Her turn in place pivots
on her soles: from still with them bearing alike, left on their balls 0.10 m
ahead, right on their middle; mid weight-swing - 1.0-1.5 s after a walk's
stop, 349/4 N to 153/153 - anywhere from 0.44 m behind to 0.28 ahead. Her
run-out is her speed over STOP_M / WALK_SPEED, a stride at least: capped at
0.87 m she ran 1.17 from 0.92 m/s onto the bed. `dock.docked` stages her the
least out her measured turn clears each thing by its height (`footprint`),
her map grows each thing by her lateral reach in its bands (0.17-0.38 m, was
0.215 for all): 12/12 sat or lay (11/12 before), 0.09-0.52 m off the face after
the turn, backed 0-0.52 m.

## Her wayfinder apart

Her dock, her way and its watch are `machine.way.planner`'s, in `python -m
machine.way.planner` on her page (`machine.way.planner.Here` in a run off it, one
process a relay baton). house.py, 112 starts a verb: the chair 28 of 39 offered
sat (34 before), the bed 20 of 25 lain (20). Her stage cleared from one arrival
lies 0.22-0.45 m out (all five: 0.45). Walking at a thing her swinging foot
reaches 0.32 m ahead, 0.24 across: the text's funnel opens a thing before its
face from her hips up only. The lodge's chair stands 1.03 m off its table's
edge, her stage 0.58 m off it.
