rogerisaksson/coaxial_63100/docs/findings/hitch.md

# The hitch on her hands

Her deep sit by her hands, from the chair's edge onto its seat (branch `sit-deep`);
the edge sit and the seat's other measures: [seat](seat.md).

Branch `sit-deep`: the two ischia, a bearing point's room and the let-go leg
on main's hands, the edge landing kept (the ischia and the rooms taken out
again on main: the lodge's chair errand, 0.47 m, rose and fell at 11.3 s with
them, the bench's 0.45 m chair 3 of 3); a leg is let go whenever a seat bears
her and her text asks nothing of her soles, on the floor or off
(`impedance._let_go`); her hands' share counts in her support's comparator;
both hands are capped at their told share together (each alone, they took
0.84 of her). The edge sit so: the seat 0.66 of her on two ischia (44-52 N
each) and the thighs on the edge (66/40 N), soles 48/52 N, upright 1 deg; the
chair scene 3 of 3. The hitch as text (`acts._hitch`: reach, brace, hitch at
the kernel's -0.16 m/s, the deep rest; `acts._egress` before the rise's
lean), aimed at her ischia over the seat's middle, 0.115 m deeper (0.42
legs), moved her hips 0 (0.263 -> 0.253 legs) square; the chair scene 1 of 3:

- Fists swung back low met the seat's front face, 2.5 cm ahead of the edge;
  reached over it a fist's radius up, both land (26-35 N), one 5 cm behind
  the edge and the other 27: the first hand down is held by its contact.
- Told the seat 0.3 and her hands 0.7, the step unloaded the seat to 0 in
  0.2 s: her let-go legs bore 0.3-0.65 of her through feet on the floor (the
  knees released to -32 dB, the thigh pointing 15 deg down), the seat unfelt
  handed her rows back to her soles. A let-go hip sprung a quarter turn from
  her pelvis is where it sat (-86 deg, the pelvis 11-18 deg forward); sprung
  level in the world (-79) it stayed -84.
- The centre of mass told in the hanging legs' frame (-3.9) asked 0.19 m at
  once, 9 m/s^2, and the ask shrank to 0.11. Shoulders 40 N m and elbows 25
  bound a hand's push along the seat near 70 N: the seat under 0.75 of her.
- The rise after it, braced and the egress said, stood her square at 14 s
  (one sole 268-427 N through the lean); at 2e-4 rad either way she fell in
  the rise (9.9, 11.1 s).

From main (branch hands-hitch, WIP): her soles keep their sat 0.15 through the
hitch, the seat at the kernel's ingress cap 0.55, her hands the rest; her
elbows lifted, her shoulders back, her fists down, her hands told only as
they come down - told as they lifted, the fist her descent swung back touched
the seat and was held there 0.23 m behind her hips. On the 0.45 m chair one
fist bears 0.15-0.27 of her in every placement; the other ends on the seat's
front corner (0.02-0.05) or 1.2-1.9 cm over it, so the shuffle, waiting for
both, never runs. Her shoulders sit 4.7 cm behind the seat's edge, her
descent swings one arm ahead of it, a phase ends with her arm 80 % of its
move (a critically damped 10 rad/s following its blend) and a fist that
touches is held where it touched; her arms share one reach and one fold, a
back-swung elbow presses its fist 1.1 cm at most, and her arm IK from the WIP
diverged from her elbow's mid-range (1 458 deg). Left: each fist's place
asked per side, or a phase that waits for her arm to arrive.
As one move - her fists carried over the seat through her descent, down on
it as it slides under her: carried hanging, her forearms held them 14 cm
ahead of its edge and they came down in front of it; carried back over it,
her arms moved her centre of mass behind her descent's and she missed the
seat, her hips 0.39 m up. Her fists asked by joint angles land within
several cm of her model's: placed by touch instead, as her hips find a seat
(`machine.senses.field`).

The pan as a row of the step (each patch's load toward its told share, weight
30 as the turns') held nothing: the seated rest's told 0.85 pushed the seat
harder than the sit has it (0.55-0.66), her soles went 186/0 N and she fell
off the low chair at 6.7-7.0 s; told a share before they bore, a fist brushing
her thigh was pressed 92 N and flung her arm - not kept.

## The low chair

A second chair in the lodge, its back against the wall straight to her right
as she starts facing the door, facing the room (`room.CHAIR_LOW_AT`), and in the
bench's scene (`floor.CHAIR_LOW_H`,
scene `chair_low_behind`, scenario `chair_low`): its seat at her popliteal
height, 0.397 m, where a human's deep sit keeps her soles flat; the lodge's
chair's top is 0.47. Landed on the low one she sits 0.30 legs back
(0.26 on the lodge's 0.45 m chair), the seat 0.52-0.56 of her, soles 0.44,
upright 11 deg, her thighs along the seat (2.4 cm under its top at the knee).
Without the two ischia (main) the low chair bears her 0.5-0.6 s at square and
+2e-4 and she stands off it, -2e-4 falls at 9.5 s; the 0.45 m chair 3 of 3.
The deep sit there is her hips 0.10 m further back on planted feet, her knee
105 -> 92 deg, her leg 0.49 -> 0.58 m hip to ankle. Scooting back as a human
(the descent's lean forward, 0.68 rad, the seat told the kernel's 0.55 and her
soles the rest, the slide said -0.16 m/s, no hands): the lean unloaded the
seat to 0 in 0.4 s (soles 136/137 N), the legs lengthened toward the deep
sit's and stood her up off the seat (hips 0.94 legs high at 4.8 s), down at
5.9 s - not kept. The seat's friction is her soles' (0.6): the feet push her
back only with the seat under 0.5 of her, a lean of the human's 43 deg, and
her law stands her where the seat is unfelt.

The rise from the low chair as the suite plays it (hips 0.33 legs back, the
seat 0.46 of her) falls 3 of 3 (8.2-11.2 s): the lean strikes the seat at
1.01-1.06 of her weight, one sole 87/0 N then 275/24, her trunk 15 deg back,
and she stands on one sole bouncing on the seat (0.46-0.62) till 11.2 s.

## The deep landing

Why she lands on the edge: `seated.landed` keeps her centre of mass over her
heels through the descent, a squat with her knees 16 cm ahead of her ankles
and her hips 0.19-0.22 m back; the human folds the knee with the shank plumb,
leans 43 deg and lets the hips swing a thigh's length back, the seat taking a
centre of mass already behind the feet. Landed as deep as her thighs clear
the edge, up to the seat's middle, with the ZMP let go through the descent
(not kept): the low chair's landing 0.46 legs asked, 0.37 measured square
(0.237 m onto the seat, upright 4 deg, the seat 0.62) - struck at 1.36 of her
weight, one sole 0 N through the sit, the rise down at 11.7 s; at +2e-4 she
fell in the sit at 4.2 s. The 0.45 m chair's landing is set by its edge, 0.29
legs asked, 0.26 measured, and the ZMP let go there felled the rise square
(9.75 s): 1 of 3 where 3. Aimed at the middle whatever the thighs met, the
0.45 m seat perched them and she fell at 3.1 s, 0 of 6.

The tip the seat catches (not kept, branch plumb-sit): her hips landed as far
back as her shank stands plumb and her thighs clear the edge, the ZMP let go
once her centre of mass passes her heels. On the 0.45 m chair her thighs meet
its edge before her shank is plumb: the landing is the edge sit's to the bit.
On the low chair (plumb: knee 87.8 deg, hips 0.51 legs back) the seat took
0.14-0.39 of her through the tip, a sole at 0 N; settling upright put her
centre of mass 0.04-0.10 m behind her heels, both soles went 0 N, the seat
struck 2.33 of her weight, her trunk rolled 45 deg back and over at 4.32 s
(baseline 6 of 7). Not the seat's points: with each patch's centre of
pressure free along her (pinned across as felt; the Python step, its C's to
the digit unchanged) she fell at 4.17 s where 4.32. From 3.3 to 3.6 s her
pelvis stays 6-11 deg forward on the seat while her trunk goes from -2 to -45
deg back over it, her soles at 0 N, where the step leaves the split free.
Her hips land 0.29-0.32 m back (0.39 planned); the settle asks her centre of
mass to the plan's upright place, 0.266 m behind her heels where it is 0.026,
and her trunk bends back to get there, her hips sliding 8 cm forward. With
her CoM row's weight off while sat (borne, her ZMP let go; prototype) she
fell at 5.11 s, the seat struck at 2.93 of her weight.

Left: the rise from the deep seat; a scoot's lean as far as puts the seat at
its cap, her legs' length following her hips, the seat held felt through it.
