rogerisaksson/coaxial_63100/docs/findings/seat.md

# Findings: her seat

Her sits on the lodge's furniture, measured in the simulated world: where a
sit lands her, the kernel's Coulomb slide as her step's ask, and what her seat
is to her step. The kernel's other steps: [kernel](kernel.md).

## Her sit's dock

Why she sits on the chair's front edge leaning forward (`seats.py --sim
chair_behind sit_chair`, a human's band from the takes): her hips land 0.218 m
behind her ankles, 0.23 legs where a human's 0.31-0.47, her trunk seated 13.1
deg forward where within 7, her soles coming and going 14 times in 8 s.
`seated.landed` caps her hips a buttock past the seat's edge (0.140 + 0.078 m)
and has her thighs clear the edge where a human's rest on it. With her thighs
let rest the press her hips land with and the cap gone: 0.29 legs, 1.5 deg,
knee 97.7 (94-98), 6 come-and-goes - and her centre of mass at her heels'
edge the constraint left (0.32 legs at the text's 0.75 rad lean); risen from
the deeper seat she fell at 31.2 s where she stood in 0.94. Her rise needs
the seat's slide forward first (the kernel's Step 4): undone till then.
Landed so again with her seat one patch of her step and her lean panned:
hips 0.29 legs back, trunk 1.1 deg, knee 97.8, her soles coming and going 8
times (`seats.py --sim chair_behind sit_chair`; the human band 0.31-0.47,
within 7, 94-98); square and +2e-4 she sat and rose rolling 21 and 27 deg,
at -2e-4 her soles left the floor 3.2 s in, the seat bore 1.47 of her and she
rolled off it at 47 deg by 4.1 s. The kernel's ingress seats her with her
hands (`specialize-with-carpal-seat-boost`: the carpal heels on the seat up
to 0.20 of her, `appendage-admittance` seeking them down at 0.25 m/s): the
deep sit waits for her arms as supports (`borne` leaves them out). Undone.
Her fists onto the seat beside her hips (an arms worktree: her hands among
`borne`'s supports, the seat's cross-fade and the lean reaching both arms
back by `seated.hands`, 27 deg upright, her soles' fade letting them hang):
her shoulders follow to the degree, and her fists hang 0.27 m from her
centre line - the shoulders' 0.148 and the forearms' carry - where the
lodge's seat is 0.22 m half-wide, 5 cm outside it and 1.5 cm under its top,
touching nothing; her shoulder is one hinge, no adduction draws them in. A
seat 0.5 m wide (a chair's), or her hands on her thighs for the rise alone.
Her shoulders and elbows swept through the sit (100 deg back to 100 forward,
the elbow 0-130): no pose puts a fist on the 0.44 m seat. Nearest, the
shoulder 20 deg back and the elbow 50, a fist is 0.242 m out and 6 mm over
the top, 5 cm past where a fist lands (0.19); straight-armed 0.27. Bent 90
the carrying angle is gone and the fist 0.18 out, but 0.41 m under the
shoulder where the seat's top is 0.46-0.55 under it. A seat 0.56 m wide takes
her fists straight-armed.

The deep landing measured (the scene's chair top 0.45 m, the lodge's 0.47):
her hips land 0.075 m over the top and 0.10 m past the front edge, her ischia
(SEAT_R under SEAT_Y, 0.073 under her hip joints) 2 mm over the seat, and her
thighs - their underside 0.050 under the hip at the root, her knees 0.10
under her hips, the seat 5 cm over her popliteal 0.397 m - bear on the front
edge: a perch on a line. Square and at +2e-4 both thighs bear and she sits,
the seat 0.55-0.63 of her and her soles 0.4; at -2e-4 one thigh bears from
2.5 s (roll 0.2 deg), her soles unload as her trunk straightens (0/0 N at 3.3
s), her pelvis pitches back 8 deg and lifts the thighs off the edge, she sits
on her pelvis's one point with her soles in the air and the step standing on
them, and rolls off at 4.1-4.3 s. Her ischia and her thighs bear together
only where the thigh's slope times its reach to the edge is their 0.023 m:
her feet planted, one depth (0.09 m past the edge); deeper her knees must
rise, the heels up or the feet off the floor - the kernel's over-knee seat
(`specialize-for-overheight-seat`: the thighs' bevel perch to 0.65 of her,
the slide back till the ischia centre, the excess onto the forefeet; item 4's
feet let go). Asked 0.15 m deeper over 1.2 s she moves 17 mm, her soles'
centre of pressure put on the ball (the ask's `edge` 1) or not: a standing
sole is held whole and its edge moves no heel; the regime frees a contact
past 0.15 m/s of slip, which a seated thigh never reaches; the seat's
friction being the floor's, her feet push the thigh's contact along only
under half her weight on the seat. Her legs let go seated (the stance flags
off): the posture's hips are -50 deg where she sits at -75
(`mode_axial_compression` bends the hip half the knee); let go she extends
them, her thighs leave the edge and she sits on her pelvis's point rolled 7
deg till the rise fells her; flexed 30 deg more, her feet planted, she pushes
herself off the seat. Her soles told standing no more and held where they
are, or lifted 1-5 cm, she falls within 1.5 s at every wobble: at 3.6 s she
had her pelvis (128 N) and both thighs (74/64) on the seat and the patch's
felt split ran away, 229 N on one thigh then 697 on her pelvis within 0.4 s.
Her seat bears her only with her soles standing. Slid in on the step's rows
instead - the patch's tangential rows freed where a slide is said and the
seat bears no more than the slide's cap - a lean of 0.5 rad pitched her
pelvis about its seat point and her hips went 4-5 cm forward; drawn along the
said slide at its 0.16 m/s (the kernel's attractor), 1.4 cm back and her
pelvis lifted off at 2.1 s. The deeper sit's centre of mass (hips 0.12 m
back, leaned 0.5 rad) lies 0.25 m behind her soles' middle, at her ischia:
her soles push nothing there against a seat gripping as the floor does
(1.0), and leaned over her soles the seat bears nothing to slide on. The
scoot on such a seat is a hitch - her hips lifted off the seat over her
soles, moved back, sat down deeper - or the far dock's drop: landed where
her thighs and ischia meet the seat together with her shanks upright (hips
0.34 m behind her ankles, 0.40 legs, the dock 0.10 m further out), her
centre of mass is 9 cm behind her heels before the seat bears; asked so she
stood on one sole from 1.8 s and fell at every wobble. The far dock with the
sit as the tree lands it (the centre of mass at her heels): her hips 3.6 cm
in front of the edge, she fell backward at 4.7 s; her descent timed and a
250 ms reach back to the deep posture after it: the seat never bore her, she
squatted 0.28 m up with her hips 0.12 m behind her ankles on both soles, 0 of
2. Her step keeps her centre of mass over her soles whatever the ask: the
deep sit is a tip onto a seat she knows is there, which her law has yet to
have.

Her legs let go instead (branch `deep-sit-letgo`): the deep landing, the
sit's rest telling her soles nothing, her soles standing no more while a seat
bears all of her, each leg's hip sprung where it was let go and its knee and
ankle undriven, the patch's pin held only while a sole stands (pinned as
felt, alone on the seat the split ran away, 128/74/64 N to 697 on her pelvis
in 0.4 s; free, square she sat 6.75 s - the pin's rule is on main: the step,
the kernel, the scenarios and the errands as before, the lie on the lodge's
bed held). So she sits deep at every wobble -
0.29 legs, upright - but on her pelvis alone, rolled 4-8 deg, her thighs
barely bearing (a hip sprung to her crouch's 50 deg where she sat at 78
lifted them; floating, her trunk drifted 3 -> 26 deg forward in 4 s; sprung
a degree off, they left the edge), her support's box a point under her
pelvis drawing her centre of mass to it; and the rise from it falls 2-3 of 3
as her soles stand again (the seat struck at 1.3-1.4 of her weight, the
soles planned 127/0 then 34/225 N a pass apart). Her support's box spanning
the bearing skin's capsules (the thigh's reaching 0.36 m ahead, into the
air) flung her onto the chair's back at 3.6 s. The deep sit wants her
thighs' bearing kept through the let-go and the soles' return eased, both
to measure before anything lands. Her pelvis as two ischia in the step
(branch `deep-sit-ischia`: its one touch split between its buttocks' lines
by where it lies, laid on them as far as it pushes her pelvis up), planted
and landed deep: +2e-4 sat and rose, square sat 6.4 s and fell in the rise,
-2e-4 fell at 4.2 s in the sit - as the deep landing alone; the perch's
soles in the air under a standing step remain its fault. The two ischia with
her legs let go: down at 5.1 and 6.8 s in the sit, +2e-4 in the rise.

Built up on seven wobbles, -3e-4 to +3e-4 (branch `deep-sit-build`): the
two ischia and the deep landing alone sit 2 of 7, five falling in the sit at
4-5 s; a sole off the floor while the seat bears her let go instead of swung
(swung, at 2e-4 rad it stepped her up onto one leg), 6 of 7 sit and 0 rise;
the let-go kept to a rest that asks nothing of her soles (a rise's lean asks
them 0.82: let go there she had no soles to lean on), 5 sit and 2 rise; a
bearing point's room its capsule's radius round it (MuJoCo gives a capsule
one contact point: her support's box was the ischia's line, her centre of
mass asked back to it at 1.5 m/s^2), 5 sit and 3 rise, those upright and
rolled 0-1 deg. The rise's lean from the deep sit asks her centre of mass
over her soles in 350 ms, 20 cm ahead of her hips: she lurches off the seat
onto one foot (the seat struck at 1.5-3 of her weight). The slide's
attractor under the governor's cap (the thighs' points drawn along the said
slide) changed nothing there: the lean's seat bears over the cap. The
kernel's egress slide as a phase before the lean - her hips drawn to where
her ischia meet the edge over 0.88 s, the seat panned to half her weight
(under it her soles' grip moves it, both surfaces her cone's), her trunk
where those shares balance (upright) - fells every rise, 0 of 7, at 8.8-9.7
s: not kept. Its trunk leaned for the legs she sits with and its centre of
mass the balance point itself, the slide moved her hips 3 cm forward and
she rose at +2e-4, 1 of 7: at square the seat struck 1.1 of her weight at
the slide's start, the step planning 0 N on it under a cap of 223 while her
soles bore nothing, and she jumped. A lean asking her hips up off the seat
(her height the knee of the hips lifted by the sit's press) never began:
rows that raise her wait while her capture point is off her soles
(`waits.risen_back`), and seated deep it is. A sole off the floor while
something bears her hovering CLEAR_M over the floor under it, no swing's
clearance of what it met (branch `deep-sit-build`, 2c9904e7): the seven
wobbles as before, 5 sit and 2 rise - the sits lost at -1 and -2e-4 fall at
4.4 and 5.3 s to the digit, in the settle's strike before any sole kicks.
The settle asking her soles nothing too: the seven reshuffled, -2e-4 sat
and -3e-4 and -1e-4 fell at 4.4-4.7 s, 5 sit and 2 rise again - not kept.
Left: that strike (the seat at 1.2-1.3 of her weight as her trunk
straightens on the perch, one thigh then her pelvis alone) and the egress
from the deep seat measured apart.

Her bed the suite's way (`house.py --one 0.32 1.01 1.37 lie_bed --said`): the
supine sleep's dock, 70 mm, fell her off the mattress's edge in the settle 3
of 3 - the bed soft, rigid, raised to the chair's 0.47 m - where the chair's
85 mm held, and a chair lowered to the bed's 0.44 held (neck 213 deg/s).
Docked at 85 the side-lie (side_lie.lisp) sat her and laid her nowhere: her
list and turn modes at their reach, 0.9 and 1.2 rad, tilt her pelvis against
her standing legs; at rest her soles bore all of her, 305 N, the bed 0, her
pelvis 0.64 m up, her neck swung 1 363 deg/s. Her gym's text (motion.lisp)
kept: arms 535 deg/s, trunk 279, neck 834 against her walk's 174, 88, 110. A
roll of her base onto her trochanter with her legs off the floor is no mode
of hers (Step 4).

## The Coulomb slide

The kernel's slide (`drive-tangential-coulomb-slide`) on her loop: her text's
`(slide v)` (m/s along her way, forward +; `ortho.SLIDE` -> `latent.SLID`)
names the regime, her pressing contacts' load capped at its share of her
weight (`somatic.CAPS`: deeper 0.55, forward 0.70); the slide itself her
step feels (`wrench._patch`, `rounds.pushed`, wbc_patch.c): a point slipping
along the floor's plane past SLIDE_M_S, along the said slide, has its
friction the kinetic one against its slip, given, its rows up alone; stuck,
or slipping against the say, it is held still, its friction the step's
within the cone. Counted whatever the text said, a hand walked into the
wall slid by that measure, was let go of along the wall's normal and the
wall threw her back 1.18 m (the wall scene at +2e-4, main's met at 0.22),
and a strike's skid as she stood up from the chair (1 000 N, 0.4 m/s)
flipped the step's answer for 6 ms. Measured across the force a patch
feels, the slip's plane leaned 30 deg into the lean's push (the force is
no surface normal) and the regime let her hips drop along it. Unsaid the
step is as it was to the bit. Sat on the
chair at its 85 mm dock, her pelvis 44 mm behind the seat's front edge (the
edge sit), 2 s of asks of the step, the regime then an ask (`slide_probe`):

| ask | moved along the seat | seat's share after |
| --- | --- | --- |
| none | +0.001 m | 0.52 |
| the point's velocity row at W_STILL, +0.16 m/s | -0.095, off the seat | 0.00 |
| the same with her centre of mass driven back | -0.029, soles 0 N | 0.50 |
| her centre of mass driven back alone, rows still | +0.043 | 0.63 |
| the regime (rows freed, friction given), com driven | -0.19 to -0.22 | 0.59 |

- A velocity row on the thigh's point at the still rows' weight lifts her off
  the seat: cheaper than moving her. The point slides by her centre of mass.
- Freed of the stiction the step assumed of the seat, her seated posture
  pushes her hips forward off the edge: the edge sit stood on that assumption.
  The slide's driver is the phase's deeper posture (`seated.landed` behind)
  with the regime, not a velocity on the point.
- A lower hold on a contact's normal force (within GROW_N of the force felt)
  felled her sit as the seat's first touch spiked: the felt force is a pass
  late (`machine.senses.borne`).
- Her text says it: `(slide -0.15)` in a phase's task constraints, m/s along
  her way, forward + (`ortho.SLIDE`, the row 304 bytes; `latent.SLID`,
  wbc_law.c alike; the step's ask from it). Nothing said, the sit and rise
  are as before to the digit. Derived instead from her sagittal reference's
  rate while borne, the slide was live in the sit's own settle: she sat 2-3 cm
  deeper (hips 0.067-0.075 m past the edge where 0.044, the seat bearing 0.63
  where 0.54) with one sole off the floor, and the errand's rise fell at 23.6
  s - undone for the text's say.
- Said with her hips asked 0.18 m deeper over 1.2 s, the knee as the edge
  sit's or as a seat at that depth has it: her hips moved 0.002 m. Her feet
  planted and her knee held set her hips' depth; a slide deeper needs her feet
  to come along - the reachability's equinus onto the forefoot (item 4), or
  the feet's own slide.
- The reachability on her loop (`machine.law.somatic`): each leg's reach, hip to
  sole over her leg's 845 mm. Standing 0.998 (her knee 6 deg), nothing borne:
  her soles her stride's; sat on the chair 0.70 and 0.75, under the text's
  0.86; 0.18 m deeper would be 0.92, her sole's centre of pressure half onto
  its ball by the seat's 0.85. Asked deeper from the edge she never got
  there (2 mm): the feet must step or slide along before the reach grows.

## Her seat as two points

The chair scene laid 2e-4 rad off (scenarios' chair, red on main): sat as
square to the digit for 2.5 s (the seat 0.59 of her, soles 63/63 N), then at
4.0 s the step's expectation of the seat's two contacts - a thigh each,
`machine.senses.borne` a point a segment - chatters pass to pass, 63/65 -> 40/60 ->
146/112 -> 104/0 -> 4/4 -> 68/219 N, her knees -13 to +50 N m, her soles 13
to 320 N; she pops off the seat at 4.5 s, yaws -0.22 rad and rolls -10 deg by
5.7 s, and the rise at 8.0 fells her (8.44 s). Laid square the split stays
even by symmetry alone. Not it: the clip's scope (one total for the two
points, the split free: down at 6.9 s) and a prior toward the force felt (a
pass late and spiky: down at 4.2 s at every wobble, laid square too). The
Python step and its C twin fall to the digit alike. The text bears her on
one manifold with a centre of pressure (`ischial-bilateral`, the slide's
stop on its CoP): her step is to take a patch's contacts as one wrench, its
force one, its CoP within the points' spread as a sole's within its room.

Tried on the Python step (`chair_py.py`, the step swapped in, falls to the
digit as the C's) with the patch's centre (the felt forces' weighted point)
held still: the sit held at every wobble and the rise twisted - the centre
held while her pelvis must leave it, yaw +-0.25, one sole 350 N, knees -93
N m. Landed instead, in both (`wrench._patch`, wbc_patch.c): each contact's
point held still and its force along the patch's normal pinned at its share
of what is felt (W_PIN, as a clipped force is held). The step's expectation
of the two thighs stays within 5 N of the felt at every wobble; the chair
bears her 5.7 s square, 6.05 at -2e-4 (where she fell at 8.44), 5.67 at
+2e-4. What bears her off her soles is capped as told (`somatic.asked`: the
pan's share of her weight, the slide regime's 0.55 deeper or 0.70 forward,
never under the lever's rule - her centre of mass between the seat's points
and her heels; under it the step planned her soles 20/19 N where 250 came),
over every patch as felt: capped a patch at a time, a thigh on the seat's
front face let the seat plan 297 N under 214.

## The rise's lean

The handover's preload pans what bears her to her soles at the share its
crossfade waits for (0.82, `maneuver._panned`), her ZMP in her support, the
kernel's egress slide said (`(slide 0.15)`): left to the fade, the seat bore
0.9-1.1 of her through the lean and one sole took her at the thrust, 33/156
N. The slide as a regime assumed - the thighs' rows freed, their friction
pinned kinetic against the asked slide - fought the seat she sticks to: the
lean's first pass planned -128 N along her thighs and felt +148; its rows
taken apart (`step_rows.py`, the pass's least squares unclipped against the
rounds') put the centre of mass's residual at 4 589 and the points' at 16
201 where the unclipped answer had 8 and 9, her soles planned 4/3 N where
67/65 bore; at -2e-4 she bounced on the seat at 1.64 of her weight and fell
at 11 s. The regime felt, she rose square and at +2e-4 (roll 7.5 and 1.6
deg; main's 3.8 and 8.0) and collapsed onto the seat at -2e-4: her neck let
go while she sat (`motion.control`'s w_sit, errands findings), the lean
whipped her head and asked her neck and head 10 and 8 times their clamps,
the whole ask shrunk as one to 0.03-0.16 (`wrench.shrunk`) and the seat met
at 3.7 of her weight; braced seated as walking, the shrink never bites
(scale 1.00 through the lean). Her legs were at the seat's gain through the
lean, the sit's cross-fade's -24 dB (`substrate-rigid-chair`): panned to her
soles so, one sole took her, 274-401 N to the other's 0, and rolled her 13
deg square; her legs' springs back toward their rest by the pan's share
(`maneuver._legs`), she rises square and at +2e-4 with roll 2.4 deg and the
dock's rise stands, its lean on the staggered sole. At -2e-4 she sits where
main fell and rises on one sole (0/299 N through the stand, the lean's
strike at 1.2 of her weight having lifted the other), stumbles at 9.8 s and
is down at 11.3; the same lean rose at 3.3 deg with the regime left to count
a backward skid (chaos, not a cause: the gate decides the outcome at that
wobble). Left (docs/todo/protocol.md): one sole bears her through the lean
(0/257 N square) and the seat is met at 1.2 of her weight twice: capped
under what holding her hips still asks, the step rolls her pelvis for it
(the pass taken apart: the points' rows 13 900 where the unclipped answer
had 76); the handover wants the hips asked up off the seat as the pan goes,
not the seat's force capped under what it gives.

Her pelvis on the seat: `impedance.SEAT_HOLDS` let its pitch go once borne,
and after the descent's 0.68 rad lean it stayed 29 deg forward of her settled
trunk, her spine at -25 deg (its stop -30); sprung to the asked pitch as her
trunk is, it settles at 9.3 deg, the spine at -6, its pitch rate at most 1.16
rad/s (the snap the old note records was ~3), the plain sit's hips 0.26 legs
back (0.24). Her hands bear as the furniture does (`borne`, a patch a hand,
the told `palmar` share): an arm whose hand bears is held by its contact, not
its rows - held by both, the first hand down turned her trunk 8 cm at the
other's and lifted it 5 cm -, and a phase can wait till each bears
(`ortho.PALMED`). The lodge's chair is 5.3 cm over her popliteal height (her
knee 0.455 m up, the thigh's underside there 0.397): her landing stops where
her thighs meet its edge (`seated.landed`'s clearance; her centre of mass 3.9
cm inside her heels), 0.192 m behind her ankles for any hands' share 0-0.28.
Deeper, her thighs must rise over the edge (1.6 cm of lift 0.15 m onto the
seat, 3.4 at 0.20) and her heels come up for her ischia to come down (4.7 deg
0.10 m onto it, 9.2 at 0.14 with her knee at 95, 12 at 0.18).
Hitched from the edge on her hands (branch seat-hitch, not kept): her arms'
reach and fold from her arm's kinematics (`figure.palm`), her hands seeking
the seat at the kernel's 0.25 m/s beside where her hips go, the press waiting
till both bear, she lands them together (21/20 N), bears 42-53 N a hand and
goes 0.077 to 0.140 m onto the seat - and falls as they let go, every variant
(5.5-7.6 s): her thighs perch on the edge (55-60 N) and her ischia hang 1.4-2
cm over the seat. Her heels raised as far as her thighs need (`stride.heels`
sat, python), her soles unloaded (12/0 N) before her ischia came down. Left:
the seat's ischia and thighs as two patches, and a hand-over to the ischia.
Her hands in the deep sit's descent (worktree wt_deep: deep-sit-build merged
with main, not kept): the merge alone sits 0.30 legs back, trunk -0.3 deg,
knee 98. The landing's limit moved by her hands' lever (the kernel's carpal
0.20, `seated.landed` with a share) and her arms reaching the seat beside
where her hips land: her centre of mass went behind her heels before her
hands met the seat, 0.26 legs, tipped back to -59 deg, soles up 0.18 legs.
The descent split, her centre of mass over her heels till both hands bear:
they never both bore, she stayed bent 41 deg forward at 0.25 legs.
The field's seek back sought again (`field.SEEK`, the kernel's -0.12 m/s
under the capture point's barrier) with her hands reaching the seat in the
descent: she fell back off it, a drop of 0.83 legs, her trunk -124 deg - her
hands bore too late for the barrier's support to reach back to them.

## The hitch on her hands

In [hitch](hitch.md).

## Her seated legs' posture

Sat on the chair, her ask's posture (`modal.poses`: her stand and the crouch
by her knees' bend) holds each hip and ankle at -51 deg where she sits at -84
and -25. The solve never reads them: a standing leg's joints follow its sole
(`wrench._maps`); a leg's posture is read at a let-go hip, the standing knees'
row and a swing's knee fold only. Asked her landing's own angles by the
ischial share (0.85; hip -78, ankle -32), the chair's sit and the bed's to 8.5
s ran bit for bit the same, sha1 every second. Her shank sits 25.4 deg ahead
of plumb, the takes' -9.5 and -0.3 (`seats.py`, shank seated): where
`seated.landed` sets her hips (the deep landing, [hitch](hitch.md)).

## The floor lie

The floor lie, the fall window's spasm and the rise from the floor:
[lie.md](lie.md).
