rogerisaksson/coaxial_63100/docs/findings/sensing.md

# Findings: sensing

Her law on what a robot of her build measures (`machine.senses.edge`,
`machine.senses.estimate`); the board's findings: [FINDINGS](../FINDINGS.md).

- Her law moved onto the edge, the world's state handed to it: her walk the same
  to the digit - 51 s, 0.69 m/s, 415 J/m, 2.57 off the band, four of FORM
  broken.
- On her estimate with her floor held where she was laid: down at 22.0 s. The
  estimate's height drifted +22 mm at 10 s and -55 mm at 20 s, her floor
  following it down only; taken where her bearing soles stand, she stood 51 s at
  410 J/m.
- Her pelvis's speed from each bearing sole's lowest corner: 6 mm/s median,
  0.165 m/s at the 99th percentile and 0.41 at worst over 25 s of walking, where
  a sole rolled. Carried by the IMU and drawn to the soles over 30 ms: 0.062 and
  0.10 (10 ms 0.135, 100 ms 0.039), her head 37-38 mm aside where 35 at any
  hold. Drawn to each insole's centre of pressure: 51 s, 0.69 m/s, 416 J/m, 2.57
  off, the same four of FORM broken, her head within.
- Her hair and her jeans' hems, unmeasured, at rest in her law's model: her walk
  as with their true angles, 493 against 491 J/m.
- A sole tripped on any along-floor touch aloft: 13 trips in 40 s of a flat
  floor, 461 J/m where 415. Walking a flat floor its along-floor touches come
  with the sole 7.9 mm over her floor at most - a landing's friction 544 N -,
  the 35 mm sill's face 14 to 38 mm up: an edge met past 10 mm trips her
  (`touch.EDGE_M`), none on a flat floor in 30 s.
- Her slide is the draw's sum, kept through a pass no sole bears
  (`machine.senses.estimate`): dropped there, a swing's toes scuffing the floor at
  2.6-2.9 m/s under 64-77 N drew her speed to 2.2 m/s where 1.3, its return read
  a slide of the sole that held, 0.6 m/s - its grip 0.157 - and she fell off the
  snow at 7.6 s. Kept, a pull and its return cancel: on the snow her holding
  soles read 0.086 m/s at the 99th percentile where 0.353 at 2e-4 rad, 0.052
  where 0.164 at 0; asphalt, ice, the slick patch and the plays to the digit.
