rogerisaksson/coaxial_63100/render/models/cube.stl

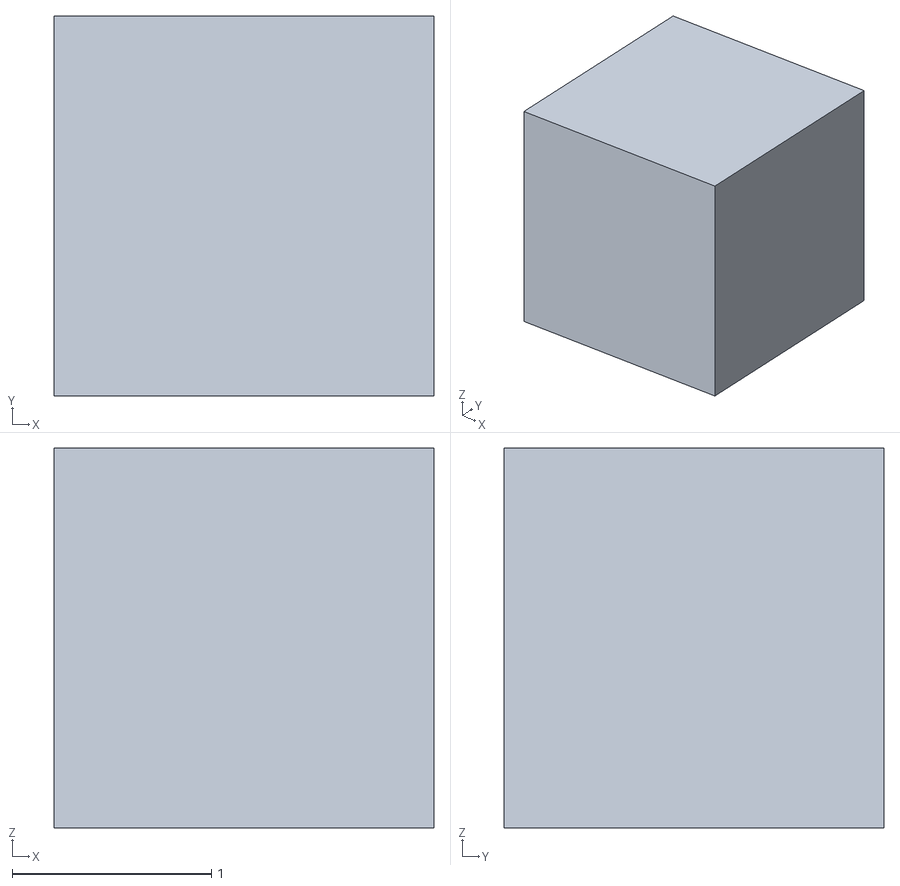
[picture p5: CAD file, 2026-08-30]
render/models/cube.stl
1.90 x 1.90 x 1.90
