rogerisaksson/coaxial_63100/render/models/coaxial_63100.stl

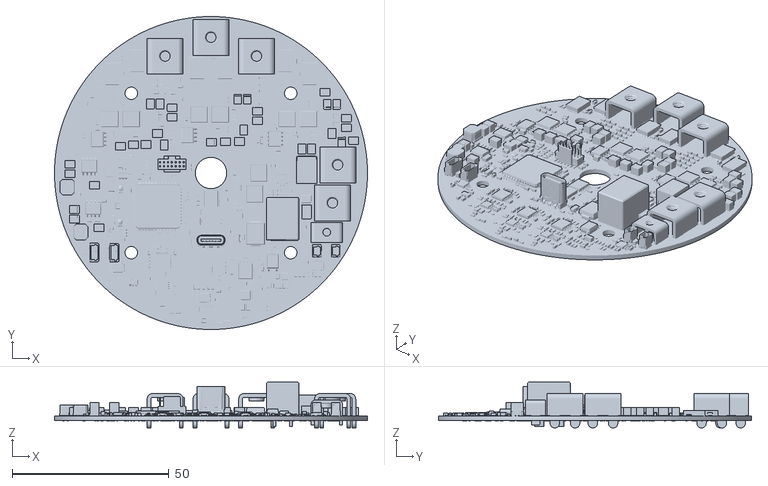
[picture p6: CAD file, 2026-08-29]
render/models/coaxial_63100.stl
100.0 x 100.0 x 14.7
