rogerisaksson/coaxial_63100/host/tests/replays/walk_and_stop.csv

t | epoch | stage | x | y | z | keys | commands
0.0 | 0 | stand | 0.0 | 0.8989447417610219 | 0.0 |  | [[0, 0, 0.0, {"laid": {"every": 3, "walks": false, "gym": "gynoid_mesomorph_medium", "room": 1.0, "sight": 0.0}}]]
0.026 | 0 | stand | -3.2782312265473372e-06 | 0.8985807767854669 | -2.5957156039460855e-05 |  | []
0.046 | 0 | stand | -9.279662904381558e-06 | 0.8983226747217075 | 3.0189254395434645e-05 |  | []
0.079 | 0 | stand | -2.4192354448080395e-05 | 0.898069405573295 | 0.0003258091295028732 |  | []
0.129 | 0 | stand | -5.5079070776971095e-05 | 0.8979488193113034 | 0.0013220353542832154 |  | []
0.179 | 0 | stand | -9.058884003639286e-05 | 0.8979299418588611 | 0.0031082451363062566 |  | []
0.229 | 0 | stand | -0.00012581780308480484 | 0.8979186096891314 | 0.005759309593316149 |  | []
0.279 | 0 | stand | -0.0001575261016290064 | 0.897900753981193 | 0.009309283360593041 |  | [[0, 279, 0.2790000000000002, {"walk": true}]]
0.329 | 0 | stand | -0.0007573452027949339 | 0.8978917753086265 | 0.013142802022441166 |  | []
0.379 | 0 | stand | -0.0024502384359139664 | 0.8976794583084771 | 0.01647593046004133 |  | []
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
