rogerisaksson/coaxial_63100/host/tests/replays/falls/hop_after_a_stop.csv

t | epoch | stage | x | y | z | keys | commands
0.0 | 0 | stand | 0.0 | 0.8989447417610219 | 0.0 |  | [[0, 0, 0.0, {"laid": {"every": 3, "walks": false, "gym": "gynoid_mesomorph_medium", "room": 1.0, "sight": 0.0}}]]
0.026 | 0 | stand | -3.2782312265473372e-06 | 0.8985807767854669 | -2.5957156039460855e-05 |  | []
0.047 | 0 | stand | -9.645343536100354e-06 | 0.8983118835049758 | 3.534037902745636e-05 |  | []
0.082 | 0 | stand | -2.5807878119335708e-05 | 0.8980554255761819 | 0.00036600349082400996 |  | []
0.132 | 0 | stand | -5.713477175637501e-05 | 0.8979464084496163 | 0.001406215221955099 |  | []
0.182 | 0 | stand | -9.275191684301527e-05 | 0.8979294439987949 | 0.00324224764752312 |  | []
0.232 | 0 | stand | -0.0001278412852856123 | 0.8979175148920432 | 0.005947463452394142 |  | []
0.282 | 0 | stand | -0.00015928637951413149 | 0.8979003470768452 | 0.009544577860177126 |  | [[0, 282, 0.2820000000000002, {"walk": true}]]
0.332 | 0 | stand | -0.000760075915256157 | 0.8978911133054978 | 0.013386407131132079 |  | []
0.382 | 0 | stand | -0.0024546401598089175 | 0.8976773529787329 | 0.0167048655380033 |  | []
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
