rogerisaksson/coaxial_63100/host/tests/replays/falls/walk_turn_right_at_0.69.csv

t | epoch | stage | x | y | z | keys | commands
0.0 | 0 | stand | 0.0 | 0.8989447417610219 | 0.0 |  | [[0, 0, 0.0, {"laid": {"every": 3, "walks": false, "gym": "gynoid_mesomorph_medium", "room": 1.0, "sight": 0.0}}]]
0.018 | 0 | walk | -1.6626247105173544e-06 | 0.898700963336565 | -2.5025933623218352e-05 |  | []
0.036 | 0 | walk | -5.9547634672518965e-06 | 0.8984421214874196 | -8.891222278707832e-06 |  | []
0.066 | 0 | walk | -1.7656657975712575e-05 | 0.8981455855111745 | 0.00017774852941963623 |  | []
0.115 | 0 | walk | -4.5720689276212546e-05 | 0.8979646989150236 | 0.0009669134760133777 |  | []
0.165 | 0 | walk | -8.048977059733118e-05 | 0.8979325392211305 | 0.0025238005895851807 |  | []
0.215 | 0 | walk | -0.00011620599561324116 | 0.8979229022377896 | 0.004925686567391318 |  | []
0.265 | 0 | walk | -0.00014909847959364238 | 0.8979037109638286 | 0.008236823886298303 |  | [[0, 265, 0.2650000000000002, {"walk": true}]]
0.315 | 0 | walk | -0.0007665858534968916 | 0.8978933074630073 | 0.011992629679776731 |  | []
0.365 | 0 | walk | -0.0024711212258895585 | 0.897679960861417 | 0.015366871002033652 |  | []
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
