rogerisaksson/coaxial_63100/host/tests/renders/ascii-x0y45z0.png

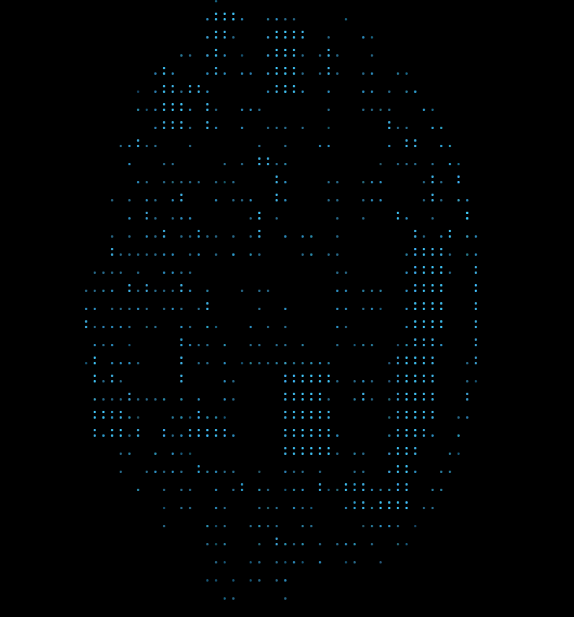
host/tests/renders/ascii-x0y45z0.png
