rogerisaksson/coaxial_63100/host/tests/renders/ascii-x45y45z45.png

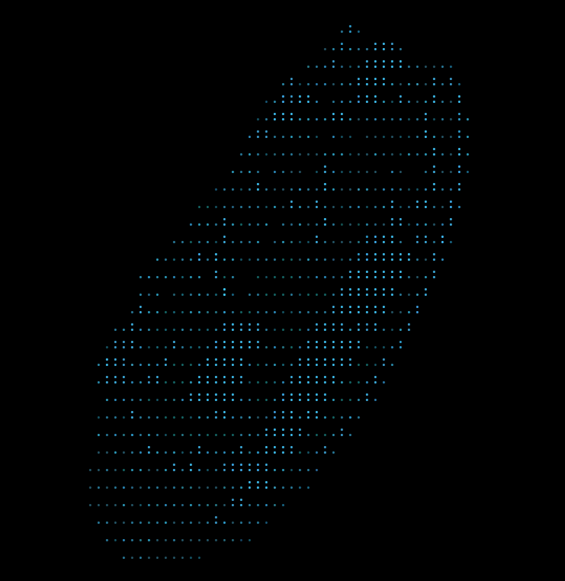
host/tests/renders/ascii-x45y45z45.png
