rogerisaksson/coaxial_63100/docs/todo/flight.md

# Flight pages

- **The crafts' continuum** (aircraft.md): the aerobat's wing-borne figures
  run into each other; its stunts still switch - a stunt or not, the
  waterfall's and the inverted nose at -1.5 and -0.5, the airborne latch,
  the burn -, as do the helicopter's and the ornithopter's laws, the line's
  lean its asked speed's derivative clipped. On their instruments the burn
  leans 28 deg, the ornithopter's dive turns its cyclic end to end. DOD: no
  branch on a threshold in the three laws; at each stage change the angular
  acceleration and the controls' step within the stage's own; the three on
  their instruments, the knife pass 2.5 cm higher; Dryden's scales.
- **The aerobat's aerodynamics from its form** (aerobat.md): the flight
  model's tail arm 0.48 m and wing 0.392 m^2 against the drawn Extra's 0.67
  m and 0.345 m^2; its side is the form's. DOD: `airframe` reads them from
  `form`; the card flies whole, the knife pass's tip within 2 cm of its 4 cm
  over the runway.
- **The courses after the aerobatics** (aircraft.md): brought to the
  routines' new shape - close by, watched, sized to the crafts. DOD: to be
  agreed.
- **The aerobat in wind** (aerobat.md): its knife pass, its final and its
  course struck in each of six winds, before the deck and on it. DOD: its
  page on the tour and in kept winds, none struck.
- **A spent pack mid-turn-over** (aircraft.md): spent in its roll or its
  flip, the quad's way down begins upside down and strikes. DOD: spent
  anywhere on its card, it lands.
- **The courses on what the crafts have** (quad.md, aircraft.md): the quad's
  planned on 3.6 g of its 11.1 - its line laid for that, on 5-6 g its ideal
  rotors struck gate 0 -, the two-drive crafts' on 2.2 of 3.6-3.9 (on 2.5
  more struck). DOD: each course on as much as its law's corrections leave,
  its line laid for it, no gate struck in the kept winds and the turbulent
  seeds.
- **The propellers' inertia and grip** (aircraft.md): the helicopter's and the
  ornithopter's pages turn the quad's motor and 16x14 (`pull.ROTOR`, 4.5e-4
  kg m^2) - the helicopter's 1 m head among them -, every suite ideal rotors;
  their discs' thrust against the air through them the quad's 14 in pitch
  whatever their collective (`quad.inflow`). DOD: each craft's rotor its own
  inertia, its thrust by its blades' pitch against its inflow, page and
  suites alike.
- **The aerobat's control at speed** (aerobat.md): off a 15 m turn in still
  air it rolls past level 2 deg at 12 m/s, 6 at 16, 12 at 19; straight in
  gusts its bank spreads 12-20 deg. DOD: out of a turn within 2 deg of level
  at any speed; straight in gusts within 5.
- **The aerobat's landing** (aerobat.md): in gusts five touches of 13
  land 0.50-0.68 m downwind of the centreline - the line's crab eased out
  under 0.2 m, its float drifts in the floor's 1 m/s crosswind. DOD: a touch
  under 0.5 m/s within 0.5 m of the centreline, stopped on the runway, still
  or gusty.
