rogerisaksson/coaxial_63100/docs/todo/bench.md

# Bench

- **25 kHz under a 63 V drive**: a hover's heat is its legs' dry switching,
  6.45 W of 9.4 (envelope.md); the bench's dry rise halves at 25 kHz. DOD:
  TIM1's period and the law's ts from the record; the ripple on a 33 uH
  winding measured; a hover's legs at it.
- **Bootloader**. DOD: a power cycle runs the store at unit 1 on the bench;
  the prefix search's real collision seen; 10 Mbit on the bench adapter.
- **From D2 SRAM**. DOD: the ITCM sample path under the drive; LOOP and
  `__sbrk_heap_end` stable an hour.
- **Drive**: a current loop closed through a winding,
  `tools/bench/commission.py` past its dry run. DOD: record ids 15..44
  measured.
- **SOA path**. DOD: dry `budget()` over the wire, a gate proof with a
  lowered ceiling and a load run on target; `Board_SyncMeanSquare`'s ISR
  cost measured.
- **Thermal observer at short periods**: the NTC anchor inverts a standing
  miss x1.8. DOD: `tools/bench/power_check.py` at 1-5 s keeps its patches.
- **STO chain** (`tools/bench/sto_probe.py`): R93 to 3V3D, a master's pilot
  on RS485, one arm with neither bypass, the keepalive from a timer
  interrupt. DOD: on the bench as on the emulator; one transient of
  `sto.asc` at 0.7 and 2.2 V within the model's windows.
- **DMA and WFI**. DOD: the A1335 by DMA against the poll; CYCCNT through
  WFI; the gate supply back after an idle's paused keepalive; ADC3's
  injected end off HAL's handler; RCR 1 on the scope.
- **Scope**: counted hold, dead-time skew, `Q_RING`. DOD: each on it.
- **Thermal**: a camera under load, a thermocouple on a winding, the
  supply's amps dry. DOD: the ceilings measured; the room found on the
  laminate's two nodes; `thermal_app.c`'s tables fitted in each.
- **Spans**: phase gain, the DC link. DOD: by a DMM.
- **`CMD_LINK_SHARE_PCT`** 75. DOD: measured on a populated RS485 segment.
- **The test line's limits** (`testline/plans/coaxial_63100_fct.yaml`).
  DOD: measured.
