rogerisaksson/coaxial_63100/docs/todo/wayfinder.md

# Her wayfinder

- **Her wayfinder apart, its smooth interactive text**
  (`smooth_interactive_wayfinder.lisp`, bridged by
  `agnostic_terrain_and_clutter_nav.lisp`): her dock and her way planned in a
  process of their own (`machine.way.planner`; a dock or a way she stands for told
  at once, her way watched walking told 0.25 s on from where she will be
  then); her map opened before the face she docks at
  (`:affordance-aperture`). Left: corners rounded where her arc fits - an
  errand walks at speed 0.02-1.4 s of its 15-28 s and stops at 1-5 corners,
  no spline fitting her 0.99 m arc in her corridors -, then her heading
  through them by the text's clothoid (`integrate-se2-clothoid-streamline`):
  her gait is said anew at each new twist (`se2.heard_twist`), a turn rate
  varied each pass needs a twist that keeps it; her stage cleared from the
  arrival her way brings her on, not from all five (0.22-0.45 m out by
  arrival); a thing seen from one side given its frustum's shadow
  (`extract-agnostic-frustum-so3-clusters`). DOD: house.py's starts sat or
  lain as often as before, nothing touched before the stunt, her body within
  0.10 m of the thing after her turn; no corner stop where her arc fits; the
  errands' suites green.
