rogerisaksson/coaxial_63100/electronics/Coaxial 63100 Schematics.pdf

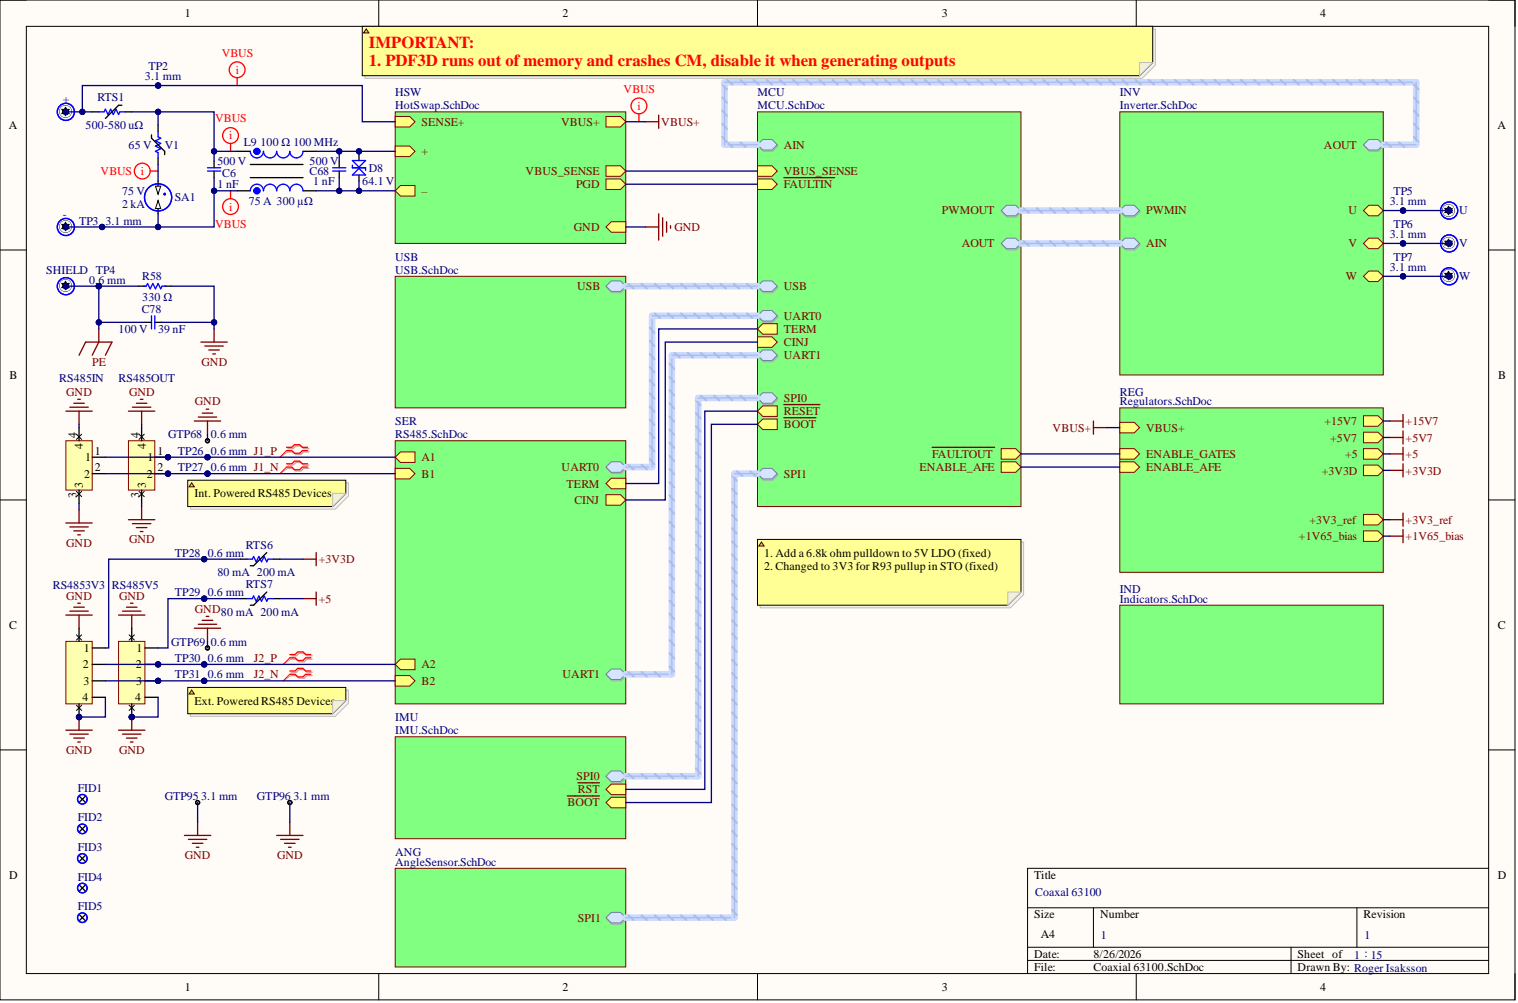
[picture p9: page 1]

IMPO
1. PDF3D runs out of memory and crashes

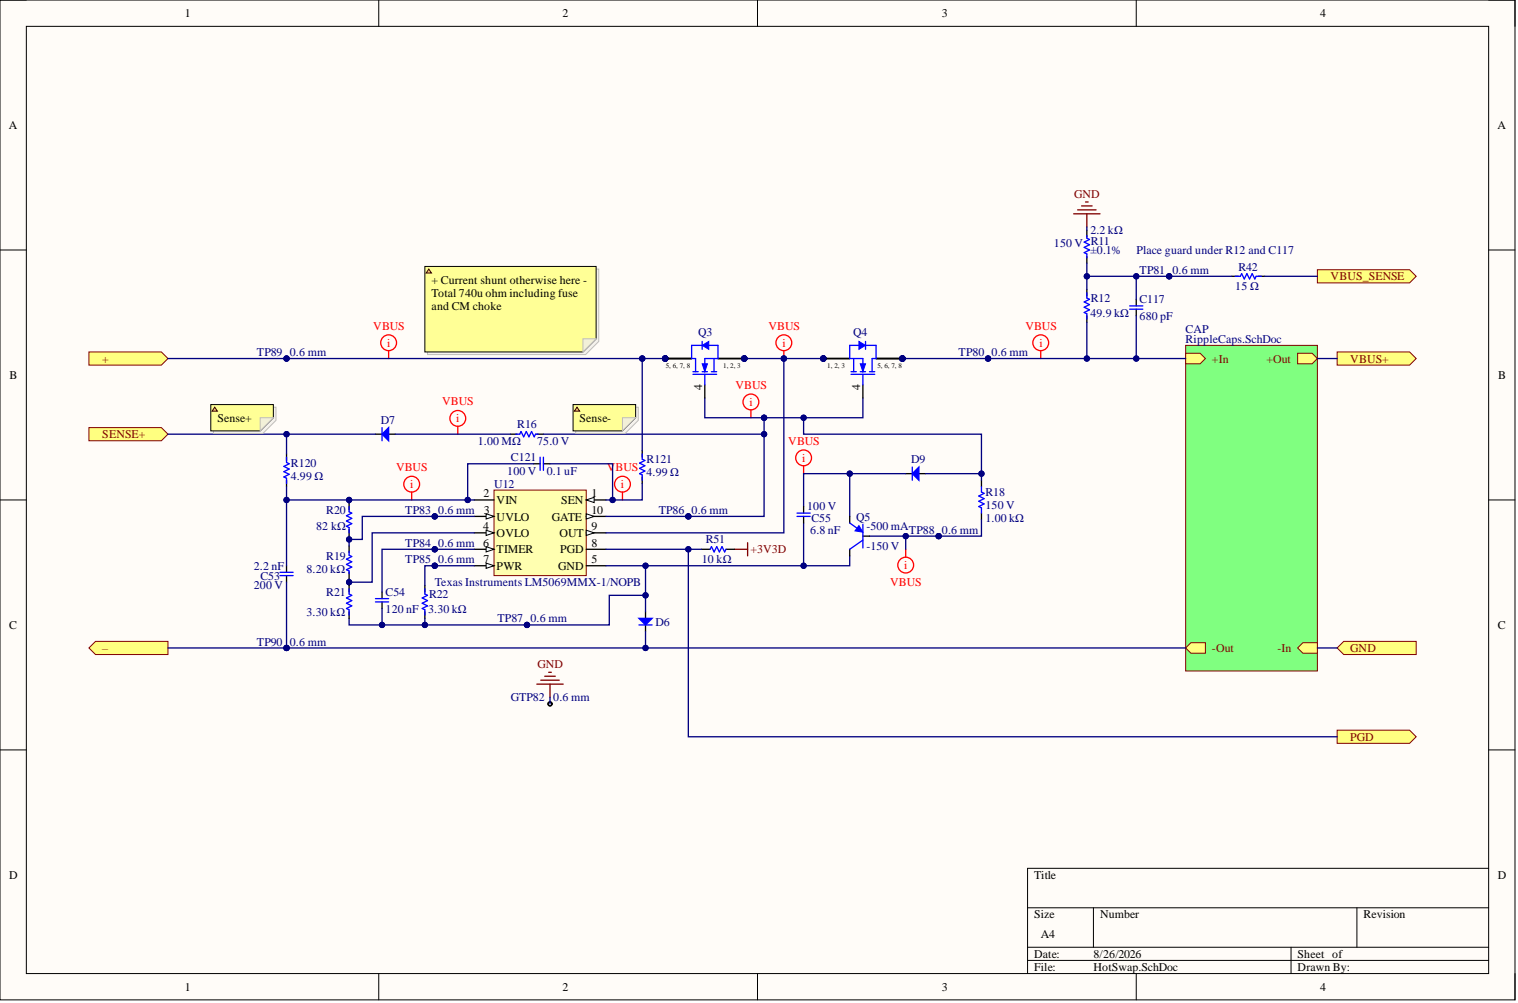
[picture p10: page 2]

- | VBU S

TP8 5 0.6 mm | 7 | VBU S | -O u t -In

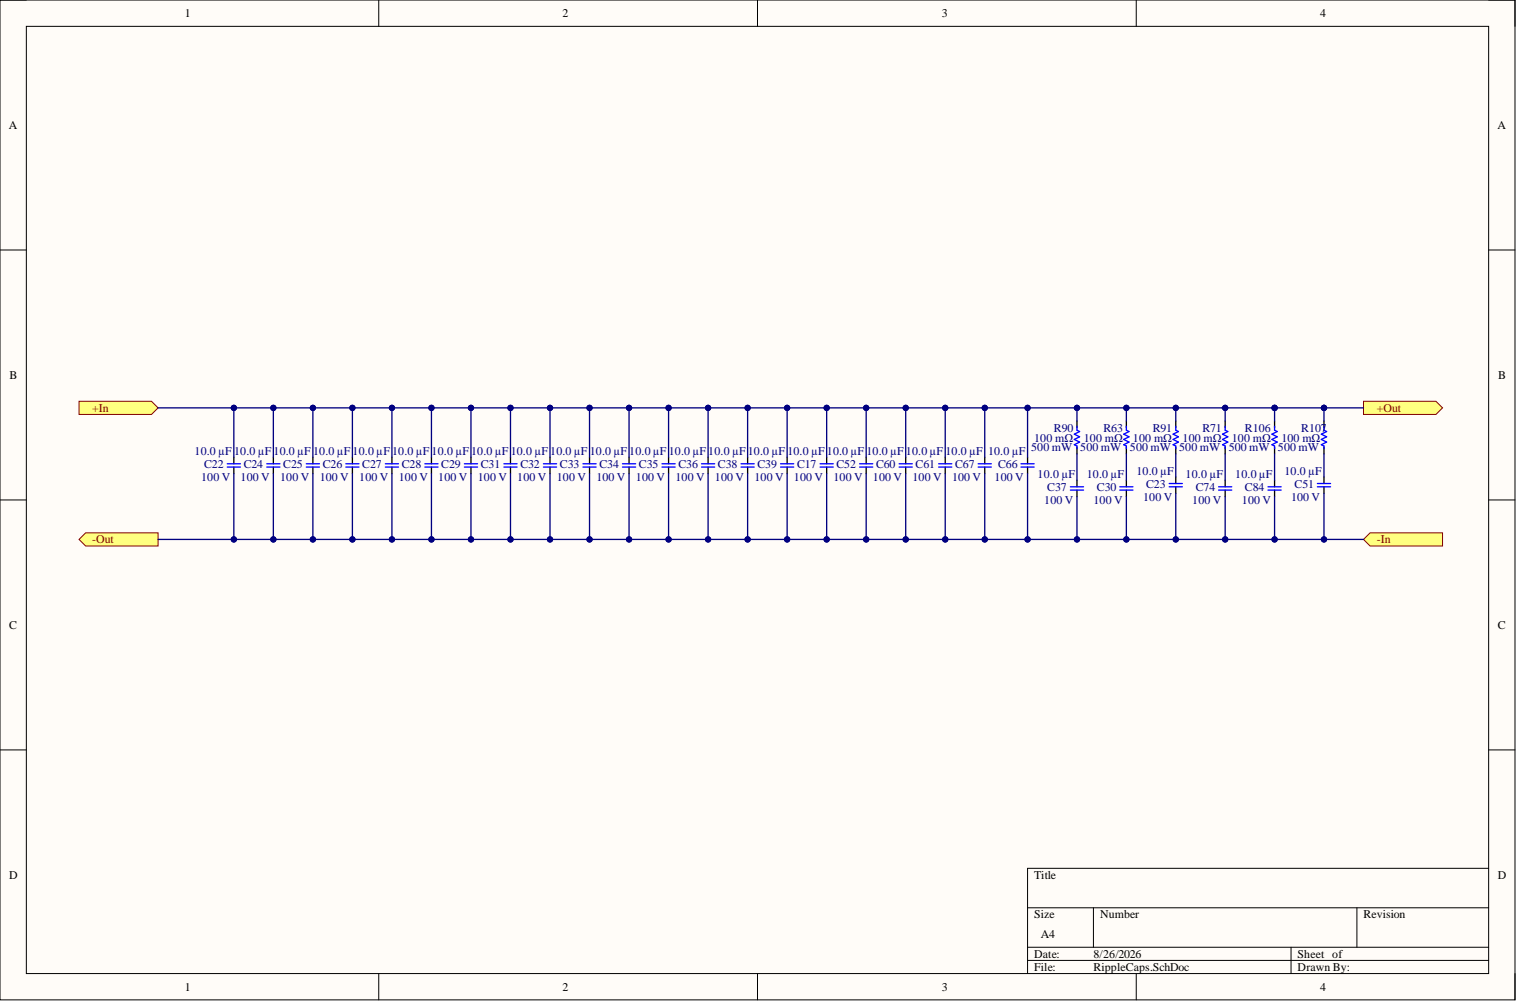
[picture p11: page 3]

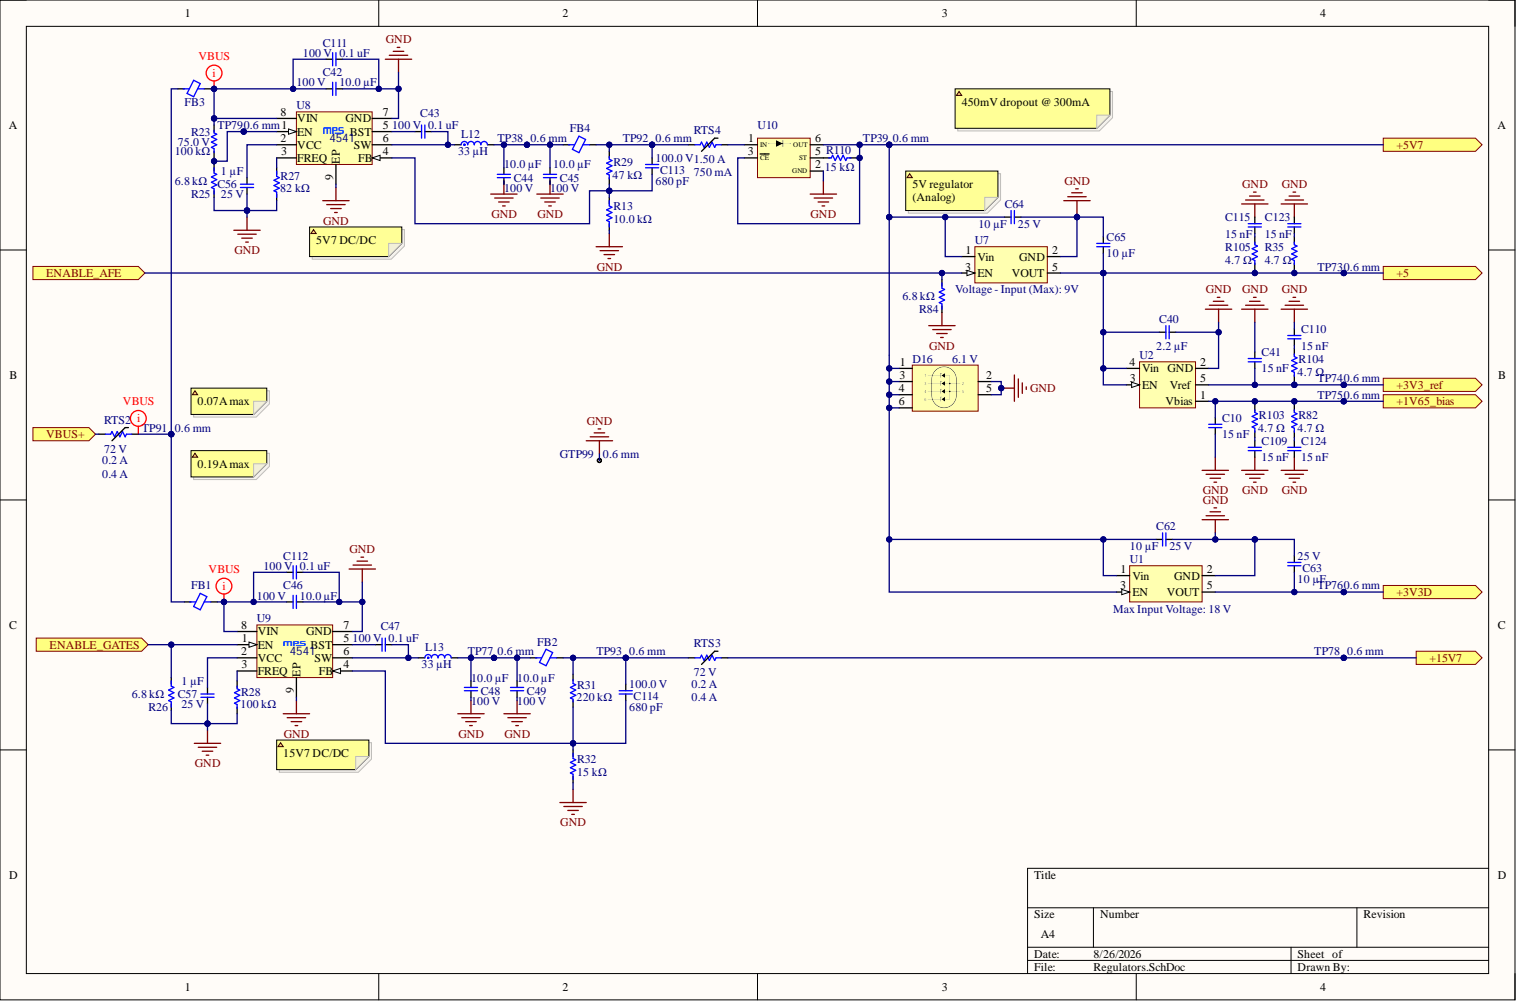
[picture p12: page 4]

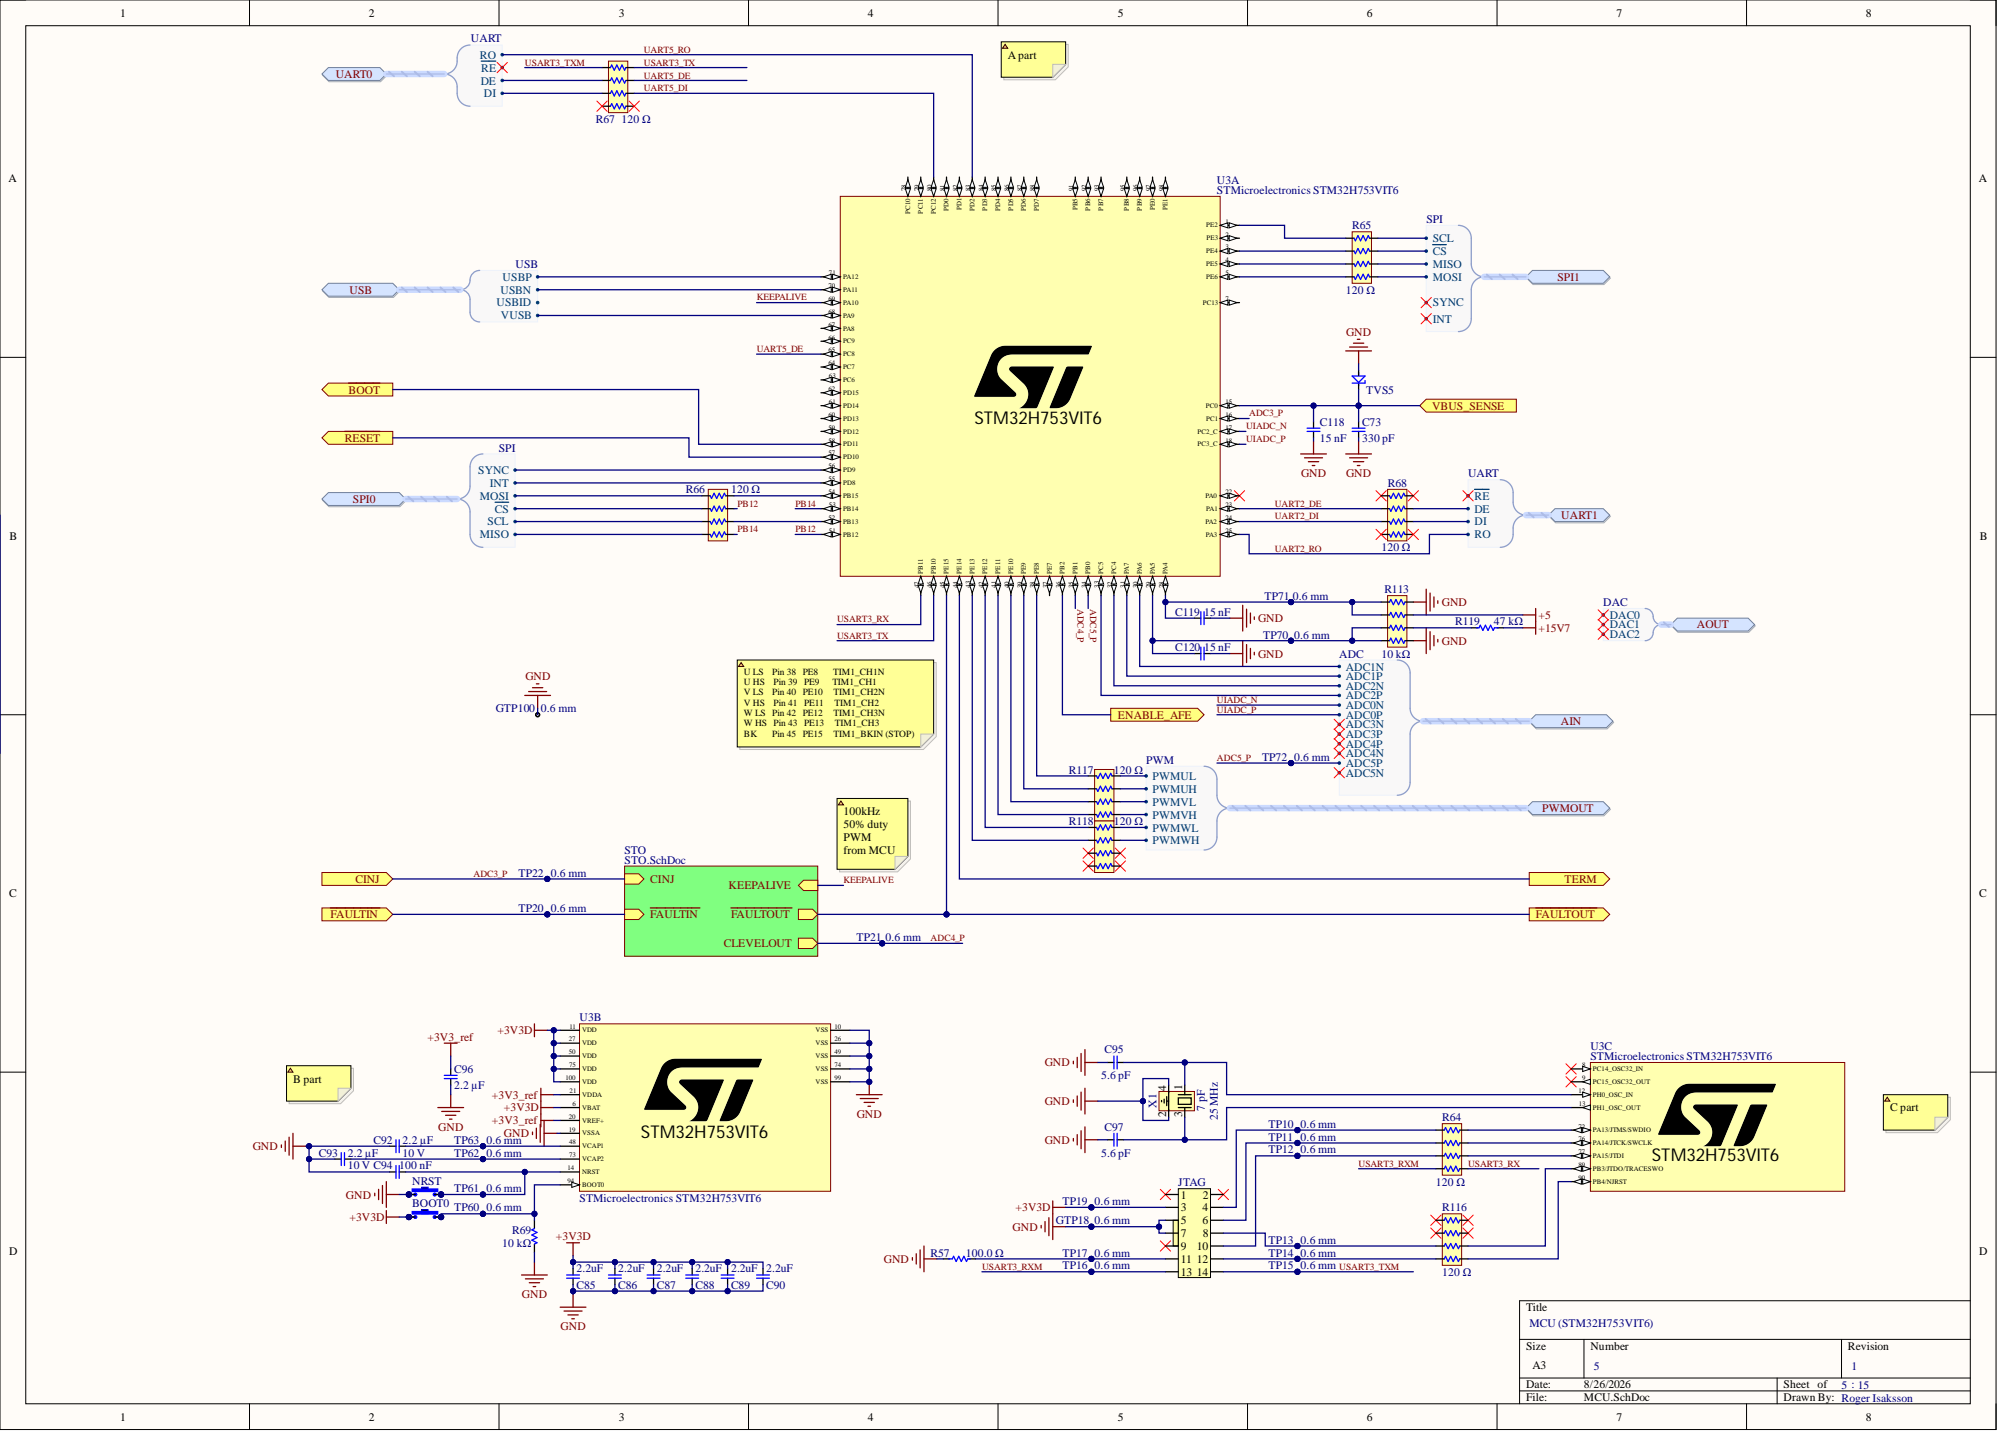
[picture p13: page 5]

USART3_RX

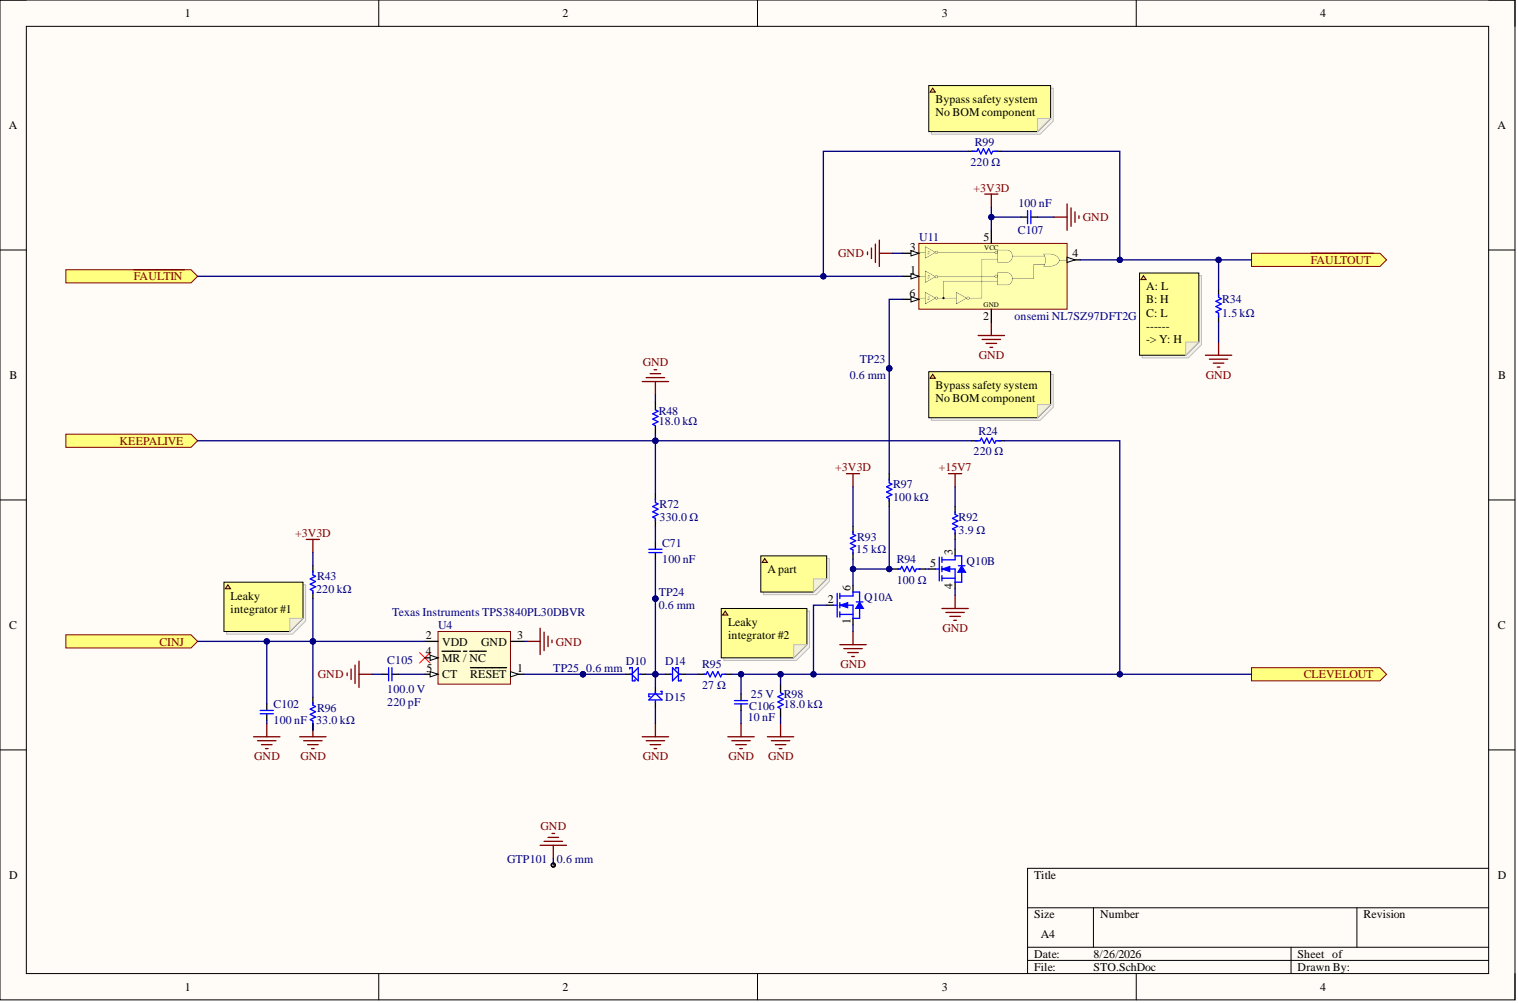
[picture p14: page 6]

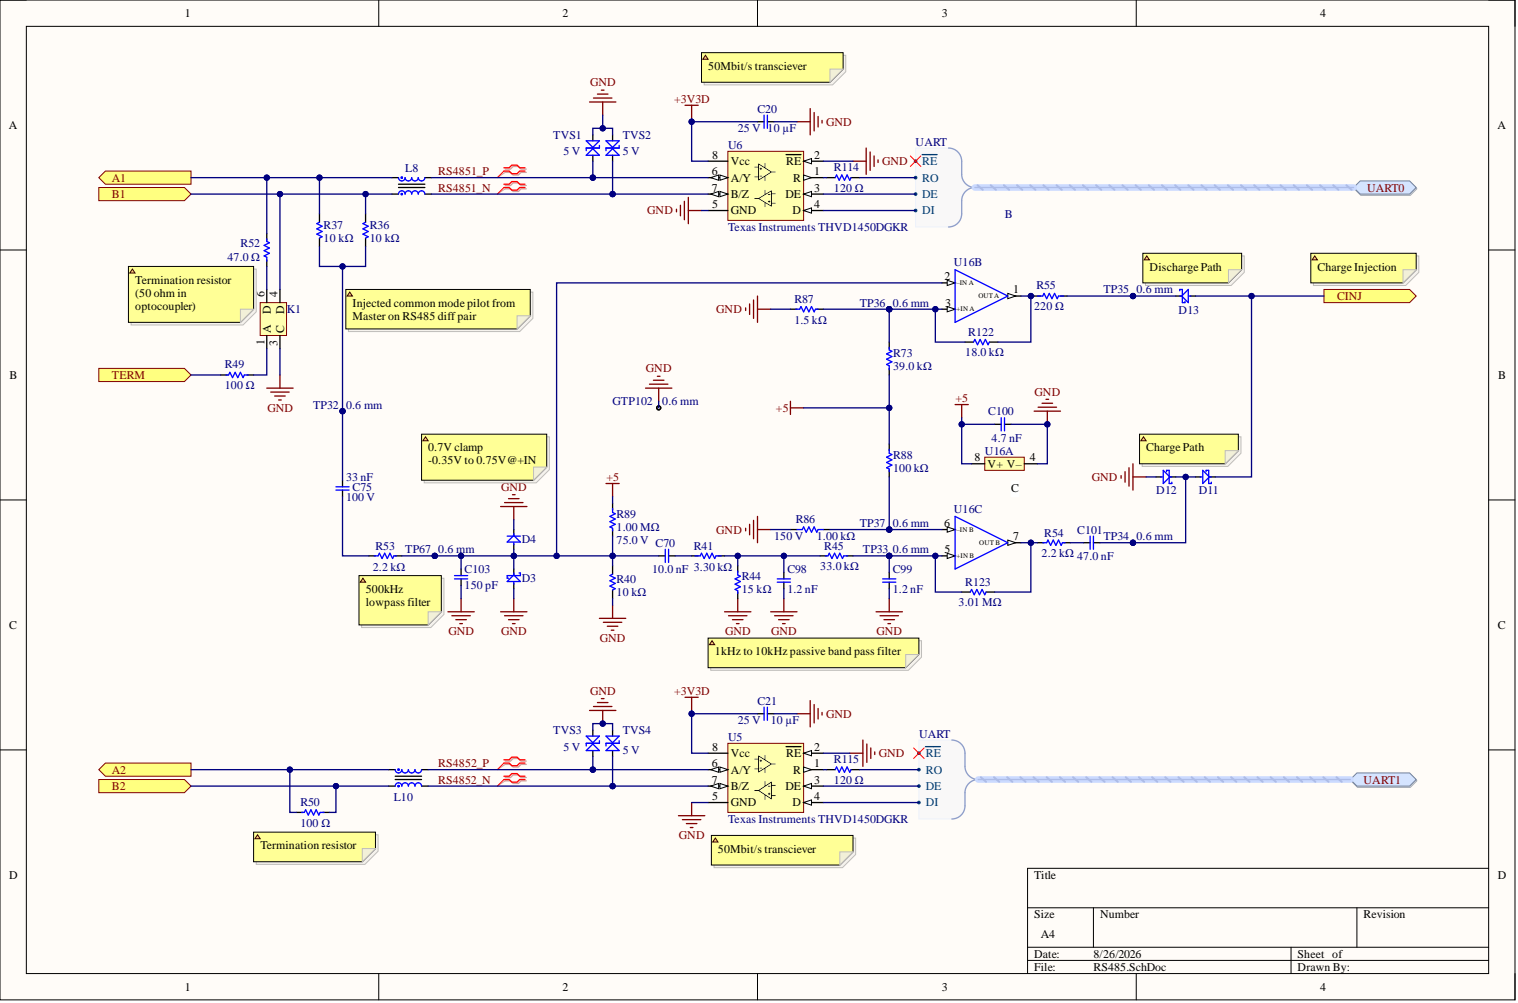
[picture p15: page 7]

Injected common mode pilot from
Master on RS485 diff pair

1kHz to 10kHz passive band pass filter

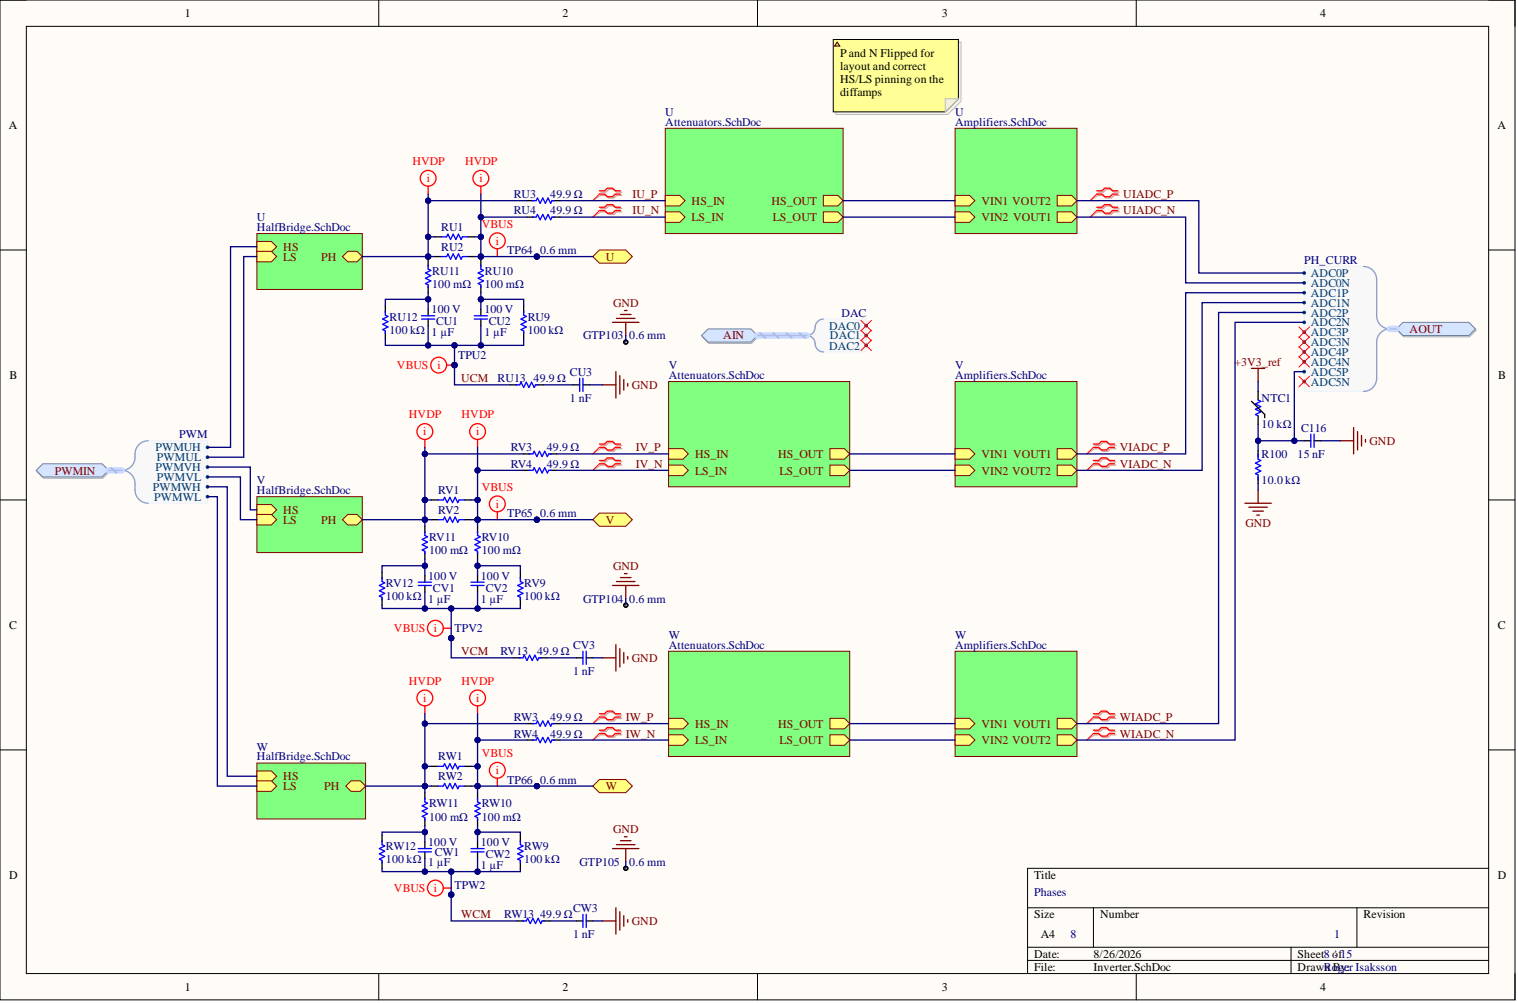
[picture p16: page 8]
ger Isak; VCM WCM UCM; ped for; d correct

H PWMUL PWMVH PWMVL PWMWH PWMWL

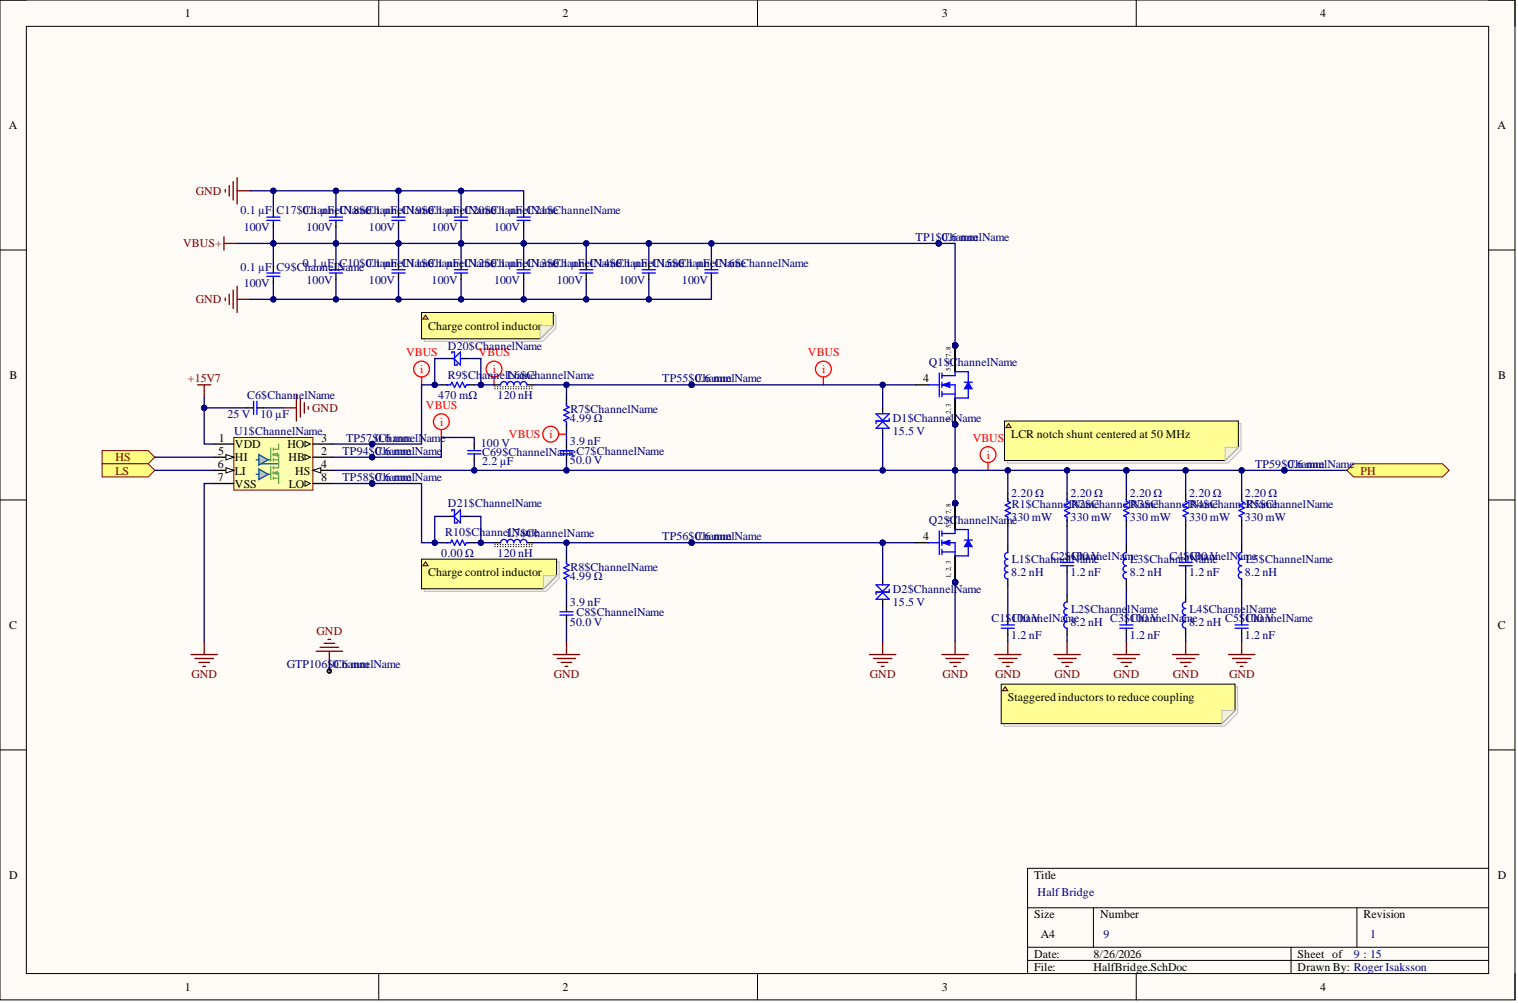
[picture p17: page 9]
File:; HalfBridge.SchDoc; Drawn By:; 9 : 15 Roger Isaksson; Half Bridge; VBUS i; TP1$Ch 0.6anmmnelName; TP55$Ch 0.6anmmnelName; TP56$Ch 0.6anmmnelName; TP57$0Ch.6 anmmnelName; TP58$Ch 0.6anmmnelName; TP59$Ch 0.6anmmnelName; TP94$Ch 0.6anmmnelName; VDD 1; 8 VSS 7; 3.9 nF C7$ChannelName; 3.9 nF C8$ChannelName; 100 V C69$ChannelName; C6$ChannelName; 2.20 Ω R1$ChannelName; 2.20 Ω R2$ChannelName; 2.20 Ω R3$ChannelName; 2.20 Ω R4$ChannelName; 2.20 Ω R5$ChannelName; 4.99 Ω R7$ChannelName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

LCR notch shunt centered at 50 MHz

Staggered inductors to reduce coupling

LCR notch shunt centered at 50 MHz

Staggered inductors to reduce coupling

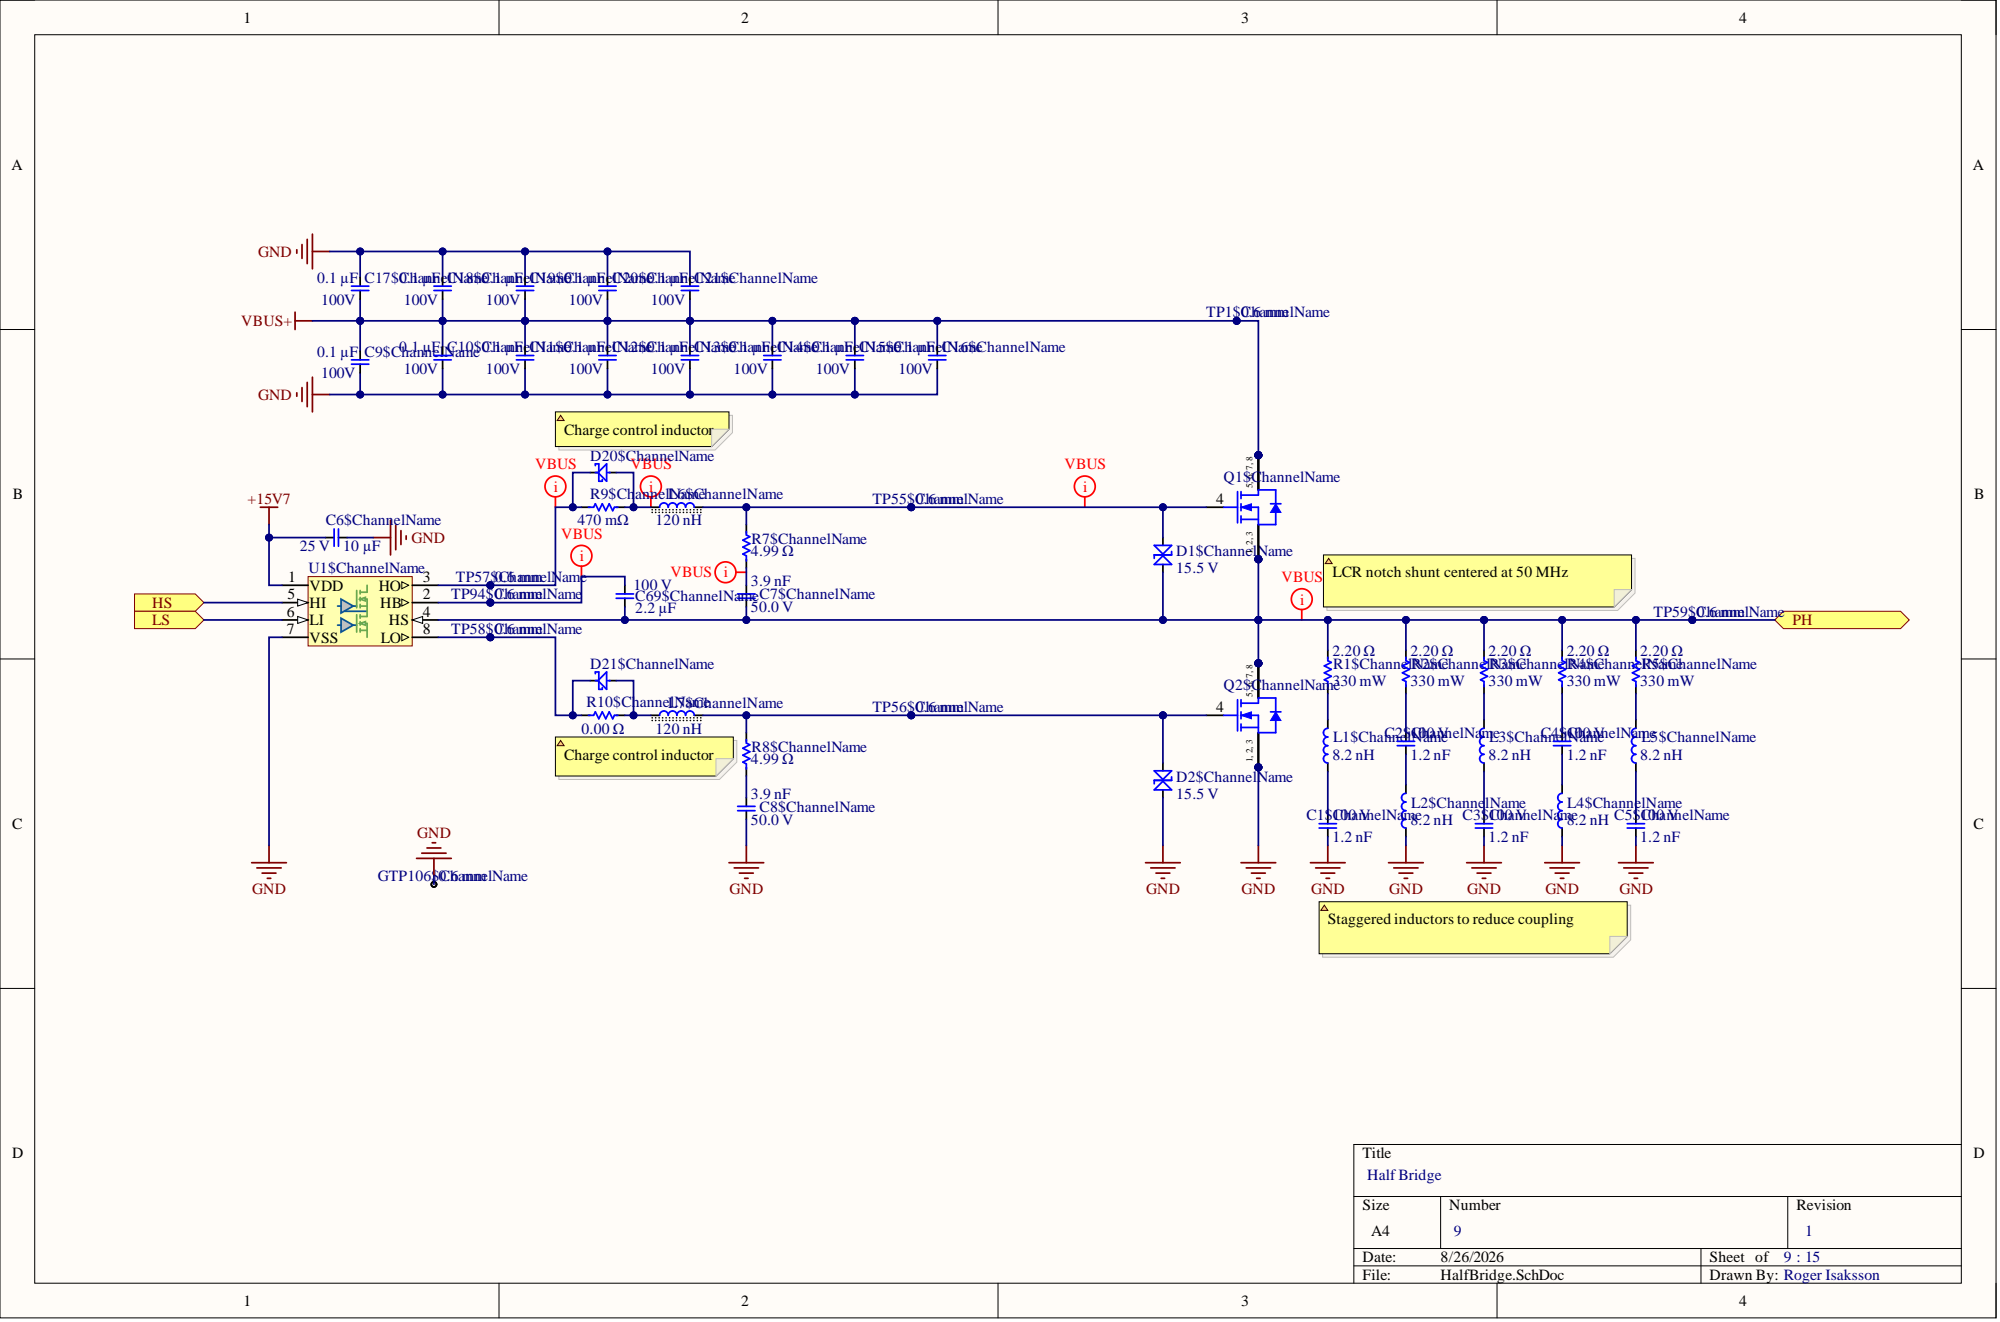
[picture p18: page 11]

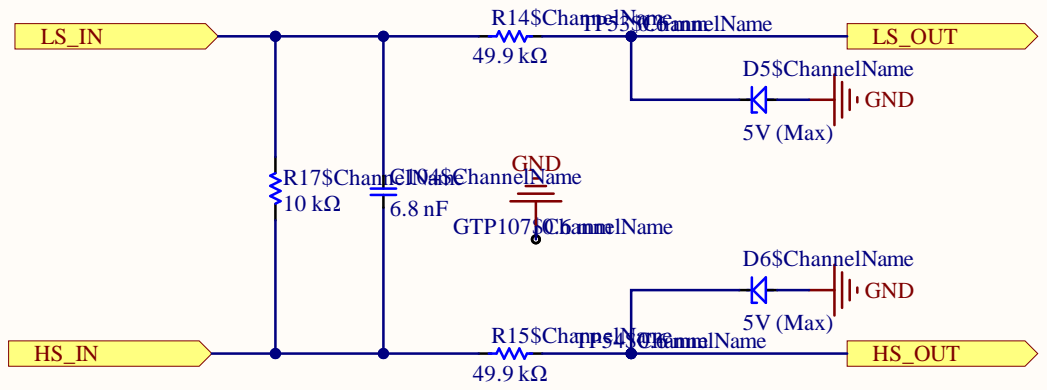
[picture p19: page 12]
File:; Attenuators.SchDoc; Drawn By:; TP54$Ch 0.6anmmnelName; 5V (Max)

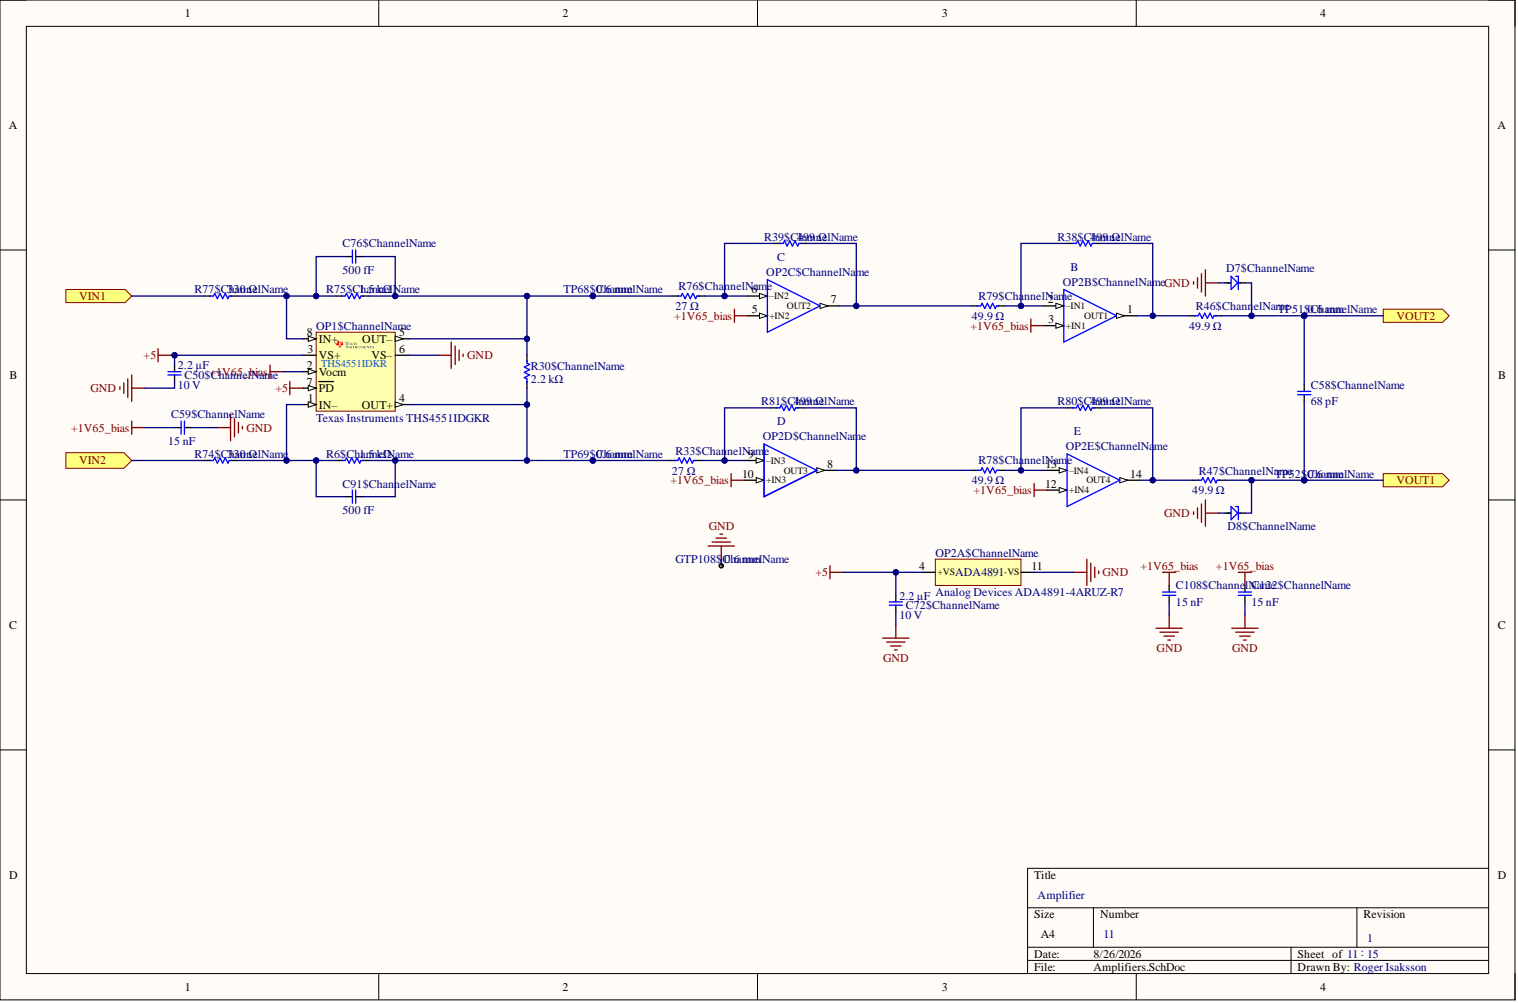
[picture p20: page 15]
File:; Amplifiers.SchDoc; Drawn By:; Roger Isaksson; TP52$Ch 0.6anmmnelName; OUT1; OUT3; ADA4891-VS; Analog Devices ADA4891-4ARUZ-R7; R46$ChannelName +1V65_bias; TP69$Ch 0.6anmmnelName; R77$Ch33an0nΩelName; TP68$Ch 0.6anmmnelName; Vocm 2; Texas Instruments THS4551IDGKR

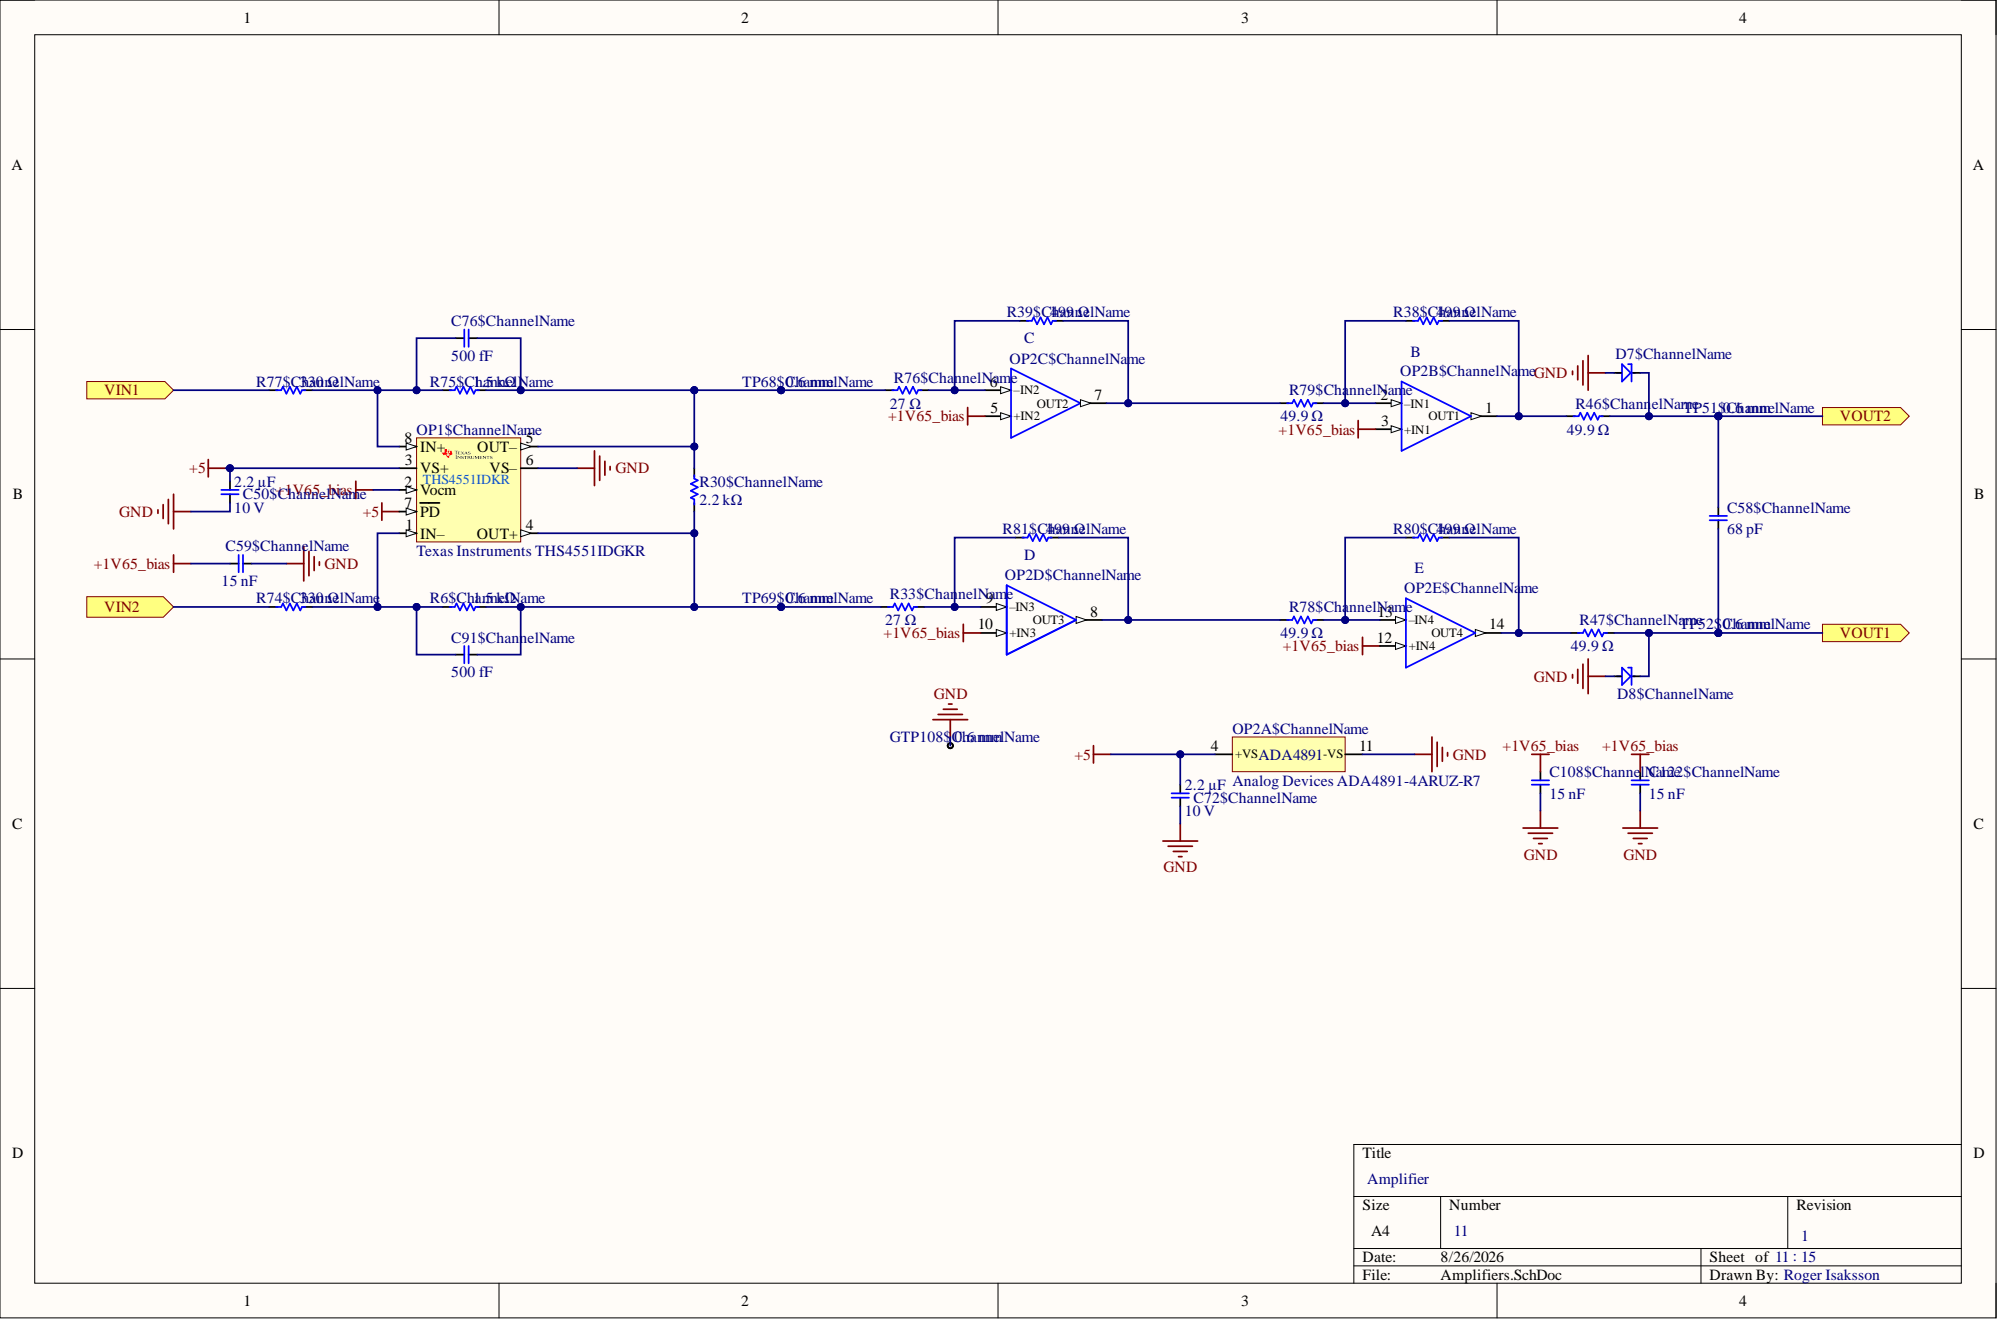
[picture p21: page 17]

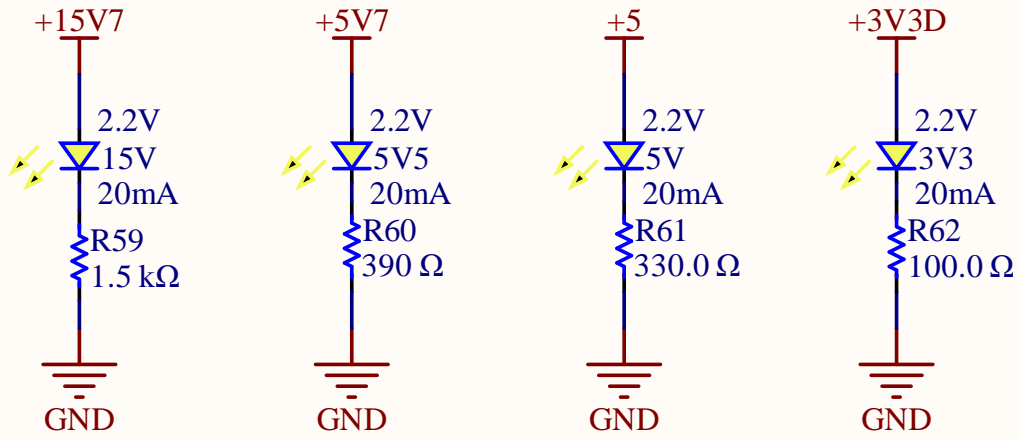
[picture p22: page 18]
+5 GND; PIR6002 COR60; PIR6102 COR61; PIR6201

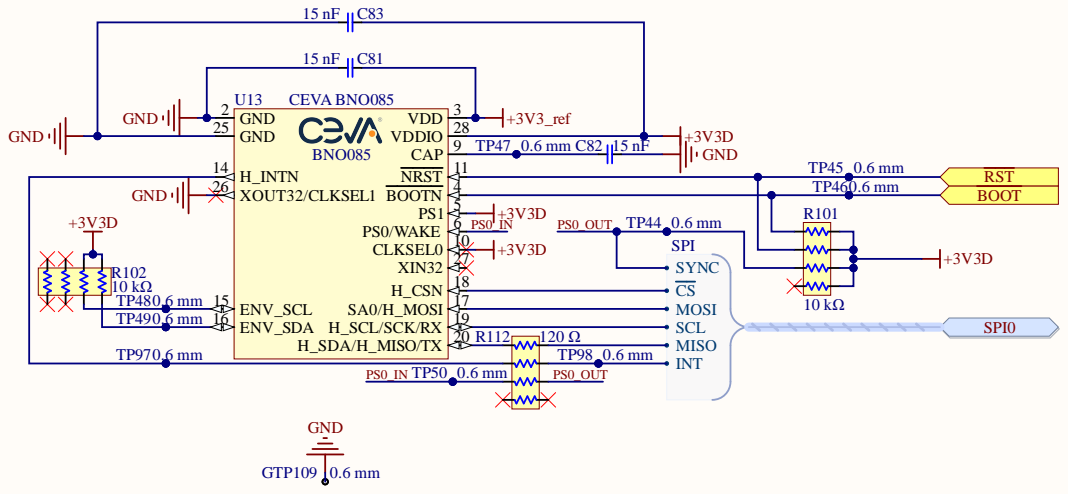
[picture p23: page 19]

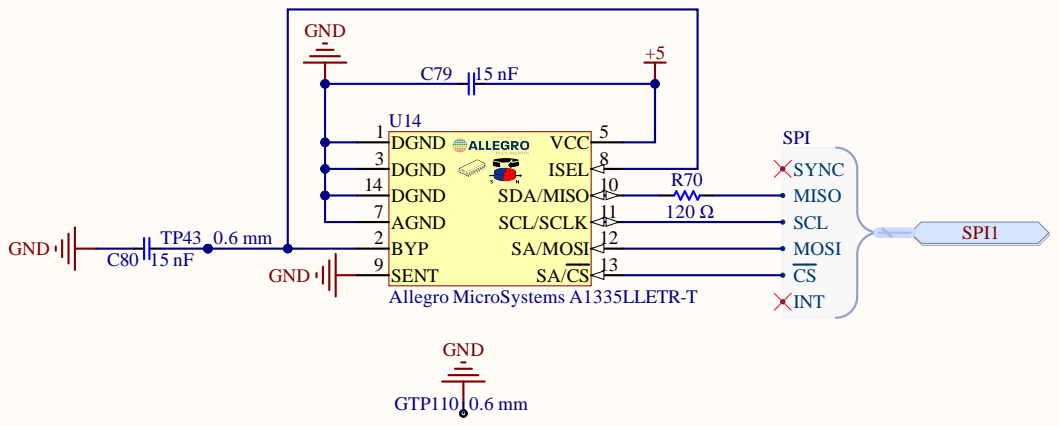
[picture p24: page 20]
File:; AngleSensor.SchDoc; Drawn By:; GTP110 0.6 mm; ISEL; 8 DGND 3; SA/MOSI; 12 BYP 2; DGND 14; DGND 1; VCC; AGND 7; SENT 9; Allegro MicroSystems A1335LLETR-T

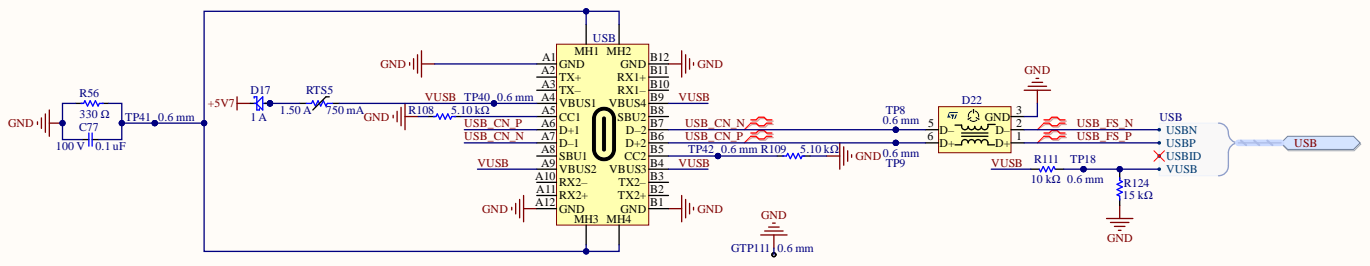
[picture p25: page 21]

USBP USBID VUSB USB
USB
