rogerisaksson/coaxial_63100/core/src/main.c

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
/* Includes ------------------------------------------------------------------*/
#include "main.h"

/* USER CODE BEGIN Includes */
#include "board.h"
#include "board_drive.h"
#include "board_power.h"
#include "console.h"
#include "dev_serial.h"
#include "link.h"
/* USER CODE END Includes */

ADC_HandleTypeDef hadc1;
ADC_HandleTypeDef hadc2;
ADC_HandleTypeDef hadc3;

SPI_HandleTypeDef hspi2;
SPI_HandleTypeDef hspi4;

TIM_HandleTypeDef htim1;

UART_HandleTypeDef huart5;
UART_HandleTypeDef huart2;
UART_HandleTypeDef huart3;

PCD_HandleTypeDef hpcd_USB_OTG_FS;

void SystemClock_Config(void);
void PeriphCommonClock_Config(void);
static void MPU_Config(void);
static void MX_GPIO_Init(void);
static void MX_USART3_UART_Init(void);
static void MX_ADC1_Init(void);
static void MX_ADC2_Init(void);
static void MX_ADC3_Init(void);
static void MX_SPI2_Init(void);
static void MX_SPI4_Init(void);
static void MX_UART5_Init(void);
static void MX_USART2_UART_Init(void);
static void MX_TIM1_Init(void);
static void MX_USB_OTG_FS_PCD_Init(void);
/**
  * @brief  The application entry point.
  * @retval int
  */
int main(void)
{

  /* USER CODE BEGIN 1 */
  Board_Early();
  /* USER CODE END 1 */

  /* MPU Configuration--------------------------------------------------------*/
  MPU_Config();

  /* MCU Configuration--------------------------------------------------------*/

  /* Reset of all peripherals, Initializes the Flash interface and the Systick. */
  HAL_Init();

  /* USER CODE BEGIN Init */

  /* The M7's instruction cache. */
  SCB_EnableICache();

  /* USER CODE END Init */

  /* Configure the system clock */
  SystemClock_Config();

  /* Configure the peripherals common clocks */
  PeriphCommonClock_Config();

  /* Initialize all configured peripherals */
  MX_GPIO_Init();
  MX_USART3_UART_Init();
  MX_ADC1_Init();
  MX_ADC2_Init();
  MX_ADC3_Init();
  MX_SPI2_Init();
  MX_SPI4_Init();
  MX_UART5_Init();
  MX_USART2_UART_Init();
  MX_TIM1_Init();
  MX_USB_OTG_FS_PCD_Init();
  /* USER CODE BEGIN 2 */

  /* Gates down first. */
  Board_PwmInit();

  /* Before anything reads a channel: the scaling parameters and the
     per-channel corrections come out of flash here, or fall back to the
     schematic's numbers. */
  Board_CalInit();

  /* What the bootloader left in the handover slot - the unit id and the
     termination - or nothing, on a bench board it never saw. */
  Board_BootInit();

  /* The dead time comes from the record, and so has to wait for it. */
  (void)Board_PwmSetDeadTime(Board_Cal()->deadtime_ns);
  (void)Board_PwmSetDeadTimeSkew((int8_t)Board_Cal()->deadtime_skew);

  /* The RS485 pair's baud is the record's too, and must land before
     link_init() derives the RTU silences from it. */
  (void)dev_uart_set_rs485_baud(Board_Cal()->link_baud);

  /* Each converter's linearity and both its offsets, once, on the reference:
     that is AFE_ON's, so the rail is up for them. */
  ADC_HandleTypeDef *const converters[] = { &hadc1, &hadc2, &hadc3 };

  Board_SetAfeOn(true);
  HAL_Delay(ADC_REFERENCE_SETTLE_MS);
  for (uint32_t i = 0U; i < (sizeof(converters) / sizeof(converters[0])); i++)
  {
    if (HAL_ADCEx_Calibration_Start(converters[i], ADC_CALIB_OFFSET_LINEARITY, ADC_SINGLE_ENDED) != HAL_OK ||
        HAL_ADCEx_Calibration_Start(converters[i], ADC_CALIB_OFFSET, ADC_DIFFERENTIAL_ENDED) != HAL_OK)
    {
      Error_Handler();
    }
  }

  Board_TimebaseInit();
  link_init();
  Console_Banner();

  /* The thermal observer, started on the thermistor while its reference is up. */
  Board_ThermalInit();
  Board_SetAfeOn(false);

  /* The control law: parameters out of the record, the period off TIM1. */
  Board_DriveInit();

  /* USER CODE END 2 */

  /* Infinite loop */
  /* USER CODE BEGIN WHILE */
  while (1)
  {
    /* First, and outside every branch below: the STO chain's only evidence
       that main() is still turning. */
    Board_StoKeepalive();

    /* Beside it, and for the same reason: this is what gives a rail back
       when its owner stopped running, so it cannot sit behind the branch
       that starved the owner. */
    Board_PowerPoll();

    /* A `stay` resets into the bootloader once its reply has left the wire
       - the reset waits here, not in the handler. */
    Board_BootPoll();

    /* The IMU polls itself into shared memory; the host only ever reads
       that. */
    if (!link_busy())
    {
      Board_ImuPoll();
      Board_AnglePoll();
      Board_DaqPoll();

      /* Arithmetic over cached state plus one NTC read, gated to 10 Hz
         inside. */
      Board_ThermalPoll();
    }

    /* Every open port's Modbus: the RS485 pair's from boot, the console's once the
       host sent 'm'. */
    link_poll();

    /* Nothing mid-frame: asleep until the next interrupt where the STO chain
       can spare the keepalive. */
    if (!link_busy())
    {
      Board_StoIdle();
    }

    if (link_active())
    {
      /* Modbus owns USART3. */
      continue;
    }

    Console_Poll();

    /* USER CODE END WHILE */

    /* USER CODE BEGIN 3 */
  }
  /* USER CODE END 3 */
}

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
 /* MPU Configuration */

void MPU_Config(void)
{
  MPU_Region_InitTypeDef MPU_InitStruct = {0};

  /* Disables the MPU */
  HAL_MPU_Disable();

  /** Initializes and configures the Region and the memory to be protected
  */
  MPU_InitStruct.Enable = MPU_REGION_ENABLE;
  MPU_InitStruct.Number = MPU_REGION_NUMBER0;
  MPU_InitStruct.BaseAddress = 0x0;
  MPU_InitStruct.Size = MPU_REGION_SIZE_4GB;
  MPU_InitStruct.SubRegionDisable = 0x87;
  MPU_InitStruct.TypeExtField = MPU_TEX_LEVEL0;
  MPU_InitStruct.AccessPermission = MPU_REGION_NO_ACCESS;
  MPU_InitStruct.DisableExec = MPU_INSTRUCTION_ACCESS_DISABLE;
  MPU_InitStruct.IsShareable = MPU_ACCESS_SHAREABLE;
  MPU_InitStruct.IsCacheable = MPU_ACCESS_NOT_CACHEABLE;
  MPU_InitStruct.IsBufferable = MPU_ACCESS_NOT_BUFFERABLE;

  HAL_MPU_ConfigRegion(&MPU_InitStruct);
  /* Enables the MPU */
  HAL_MPU_Enable(MPU_PRIVILEGED_DEFAULT);

}

/**
  * @brief  This function is executed in case of error occurrence.
  * @retval None
  */
void Error_Handler(void)
{
  /* USER CODE BEGIN Error_Handler_Debug */
  /* User can add his own implementation to report the HAL error return state */
  __disable_irq();
  while (1)
  {
  }
  /* USER CODE END Error_Handler_Debug */
}
#ifdef USE_FULL_ASSERT
/**
  * @brief  Reports the name of the source file and the source line number
  *         where the assert_param error has occurred.
  * @param  file: pointer to the source file name
  * @param  line: assert_param error line source number
  * @retval None
  */
void assert_failed(uint8_t *file, uint32_t line)
{
  /* USER CODE BEGIN 6 */
  /* User can add his own implementation to report the file name and line number,
     ex: printf("Wrong parameters value: file %s on line %d\r\n", file, line) */
  /* USER CODE END 6 */
}
#endif /* USE_FULL_ASSERT */
