rogerisaksson/coaxial_63100/coaxial_63100.ioc

Mcu.UserName=STM32H753VITx
PA1.Signal=USART2_DE
PA10.Signal=GPIO_Output
PA11.Signal=USB_OTG_FS_DM
PA12.Signal=USB_OTG_FS_DP
PA2.Signal=USART2_TX
PA3.Signal=USART2_RX
PA4.Signal=ADCx_INP18
PA5.Signal=ADCx_INP19
PA6.Signal=ADCx_INP3
PA7.Signal=ADCx_INN3
PA9.Signal=USB_OTG_FS_VBUS
PB0.Signal=ADCx_INP9
PB1.Signal=ADCx_INP5
PB10.Signal=USART3_TX
PB11.Signal=USART3_RX
PB12.Signal=SPI2_NSS
PB13.Signal=SPI2_SCK
PB14.Signal=SPI2_MISO
PB15.Signal=SPI2_MOSI
PB2.Signal=GPIO_Output
PC0.Signal=ADCx_INP10
PC1.Signal=ADCx_INP11
PC12.Signal=UART5_TX
PC2_C.Signal=ADC3_INN1
PC3_C.Signal=ADC3_INP1
PC4.Signal=ADCx_INP4
PC5.Signal=ADCx_INN4
PC8.Signal=UART5_DE
PD10.Signal=GPIO_Output
PD11.Signal=GPIO_Output
PD2.Signal=UART5_RX
PD8.Signal=GPIO_Input
PD9.Signal=GPIO_Output
PE10.Signal=TIM1_CH2N
PE11.Signal=S_TIM1_CH2
PE12.Signal=TIM1_CH3N
PE13.Signal=S_TIM1_CH3
PE14.Signal=GPIO_Output
PE15.Signal=TIM1_BKIN
PE2.Signal=SPI4_SCK
PE4.Signal=SPI4_NSS
PE5.Signal=SPI4_MISO
PE6.Signal=SPI4_MOSI
PE8.Signal=TIM1_CH1N
PE9.Signal=S_TIM1_CH1
