rogerisaksson/coaxial_63100/drive/src/drive.c

/** drive.c - One PWM period of the control law, and the modes it runs in. */
#include "drive.h"

#include <math.h>
#include <string.h>

/** Periods from the step that asks for a duty to the sample that shows it. */
#define PIPELINE 2U

#define PI_F         3.1415927f
#define TWO_PI_F     6.2831853f
#define INV_TWO_PI_F 0.15915494f
#define HALF_SQRT3   0.8660254f
#define INV_SQRT3    0.57735027f

/** The back-EMF's speed filter, s: thirty of the current loop's 64 us, so a torque step's
    L di/dt, which the magnitude does not subtract, passes as a thirtieth of itself. */
#define BEMF_TAU_S 0.002f

static float bemf_weight(const drive_t *d, float speed);
static float rotor_speed(const drive_t *d);

void drive_defaults(drive_params_t *p)
{
  /* Placeholders. */
  memset(p, 0, sizeof(*p));
  p->r = 0.05f;
  p->ld = 20e-6f;
  p->lq = 25e-6f;
  p->lambda = 0.005f;
  p->pole_pairs = 7.0f;
  p->kp = 0.1f;
  p->ki = 250.0f;
  p->l1 = 0.1f;
  p->l2 = 100.0f;
  p->inj_volts = 0.0f;
  p->inj_periods = 1U;
  p->inj_phase = 0.0f;
  p->eps_gain = 0.0f;
  p->i_max = 5.0f;
  p->i_trip = 20.0f;
  p->v_frac = 0.95f;
  p->sign = 1.0f;
  p->w_lo = 60.0f;
  p->w_hi = 120.0f;
  p->dt_step = 1.0f;
}

static void loop_reset(drive_t *d)
{
  d->xd = 0.0f;
  d->xq = 0.0f;
  d->vd = 0.0f;
  d->vq = 0.0f;
  d->va_out = 0.0f;
  d->vb_out = 0.0f;
  d->inj_count = 0U;
  d->cyc_count = 0U;
  d->acc_q = 0.0f;
  d->acc_d = 0.0f;
  d->inj_warm = 0U;
  d->inj_valid = false;
  d->have_prev = false;
  d->ih = 0.0f;
  d->fb_fill = 0U;
  memset(d->sign_hist, 0, sizeof(d->sign_hist));
  memset(d->cos_hist, 0, sizeof(d->cos_hist));
  memset(d->sin_hist, 0, sizeof(d->sin_hist));
}

void drive_init(drive_t *d, float ts)
{
  memset(d, 0, sizeof(*d));
  d->ts = ts;
  drive_defaults(&d->p);
  drive_thermal_defaults(&d->tp, ts);
  drive_thermal_init(d, 25.0f);
  drive_model_defaults(&d->model.p);
  drive_model_init(&d->model);
  d->source = DRIVE_SOURCE_ADC;
  drive_observer_init(&d->obs, &d->p, ts);
  d->inj_sign = 1.0f;
  loop_reset(d);
}

void drive_set_theta(drive_t *d, float theta)
{
  d->theta_hat = drive_wrap(theta);
  d->theta_cmd = d->theta_hat;
}

void drive_set_theta_setpoint(drive_t *d, float theta)
{
  if ((d->mode == DRIVE_HOLD) || (d->mode == DRIVE_VOLT))
  {
    d->theta_cmd = drive_wrap(d->theta_cmd + (theta - d->sp.theta));
  }
  d->sp.theta = theta;
}

const char *drive_set_mode(drive_t *d, drive_mode_t mode, bool stage_enabled,
                           bool powered)
{
  if (mode >= DRIVE_MODES)
  {
    return "no such mode - 0 off, 1 volt, 2 hold, 3 sensorless, 4 polarity";
  }
  if (mode == DRIVE_OFF)
  {
    d->mode = DRIVE_OFF;
    loop_reset(d);
    return NULL;
  }
  /* The model needs neither a reference nor a stage: it is the currents, and
     the duties go to real gates only if MOE happens to be set. */
  if (d->source == DRIVE_SOURCE_MODEL)
  {
    powered = true;
    stage_enabled = true;
  }
  if (!powered)
  {
    return "AFE_ON is off, and it powers the converter's reference - the "
           "currents this mode would act on are mid-scale, not measurements; "
           "enable the AFE first";
  }
  if (!stage_enabled)
  {
    return "the stage is off - gates.on() is what sets MOE, and a "
           "mode that switches is refused until it has";
  }
  if ((mode == DRIVE_POLARITY) && (d->sp.pol_periods == 0U))
  {
    return "polarity needs pol_periods above zero - one pulse of no length "
           "measures nothing";
  }

  loop_reset(d);
  d->fault = DRIVE_FAULT_NONE;
  if ((mode == DRIVE_HOLD) || (mode == DRIVE_VOLT))
  {
    /* Out of the rotor observer's frame above the back-EMF's speed: the command
       frame starts on the rotor, and its ramp carries it; else at the setpoint's
       angle, standing. */
    const bool turning = (d->mode == DRIVE_SENSORLESS) && (bemf_weight(d, rotor_speed(d)) > 0.0f);

    d->theta_cmd = turning ? d->theta_hat : drive_wrap(d->sp.theta);
    d->omega_cmd = turning ? d->omega_hat : 0.0f;
  }
  if (mode == DRIVE_POLARITY)
  {
    d->pol_step = 0U;
    d->pol_pos = 0.0f;
    d->pol_neg = 0.0f;
  }
  d->mode = mode;
  /* The chain cannot acquire a speed from nothing, so it takes the estimate
     the drive already holds whenever a mode starts. */
  drive_observer_sync(&d->obs, &d->p, d->theta_hat, d->omega_hat);
  return NULL;
}

/* ---- the window ------------------------------------------------------- */

static void acc_add(drive_acc_t *a, float x)
{
  a->n++;
  a->sum += (double)x;
  a->sumsq += (double)x * (double)x;
}

static void window_innovation(drive_window_t *w, float e)
{
  /* The lagged products of the innovation, for the whiteness test the host
     runs: a residual that still correlates with itself carries a model
     error, and rho_j = lag[j] / lag[0] is what says so. */
  w->e_ring[w->e_head] = e;
  for (uint8_t j = 0U; j <= DRIVE_LAGS; j++)
  {
    const uint8_t back = (uint8_t)((w->e_head + (DRIVE_LAGS + 1U) - j)
                                   % (DRIVE_LAGS + 1U));

    w->lag[j] += (double)e * (double)w->e_ring[back];
  }
  w->e_head = (uint8_t)((w->e_head + 1U) % (DRIVE_LAGS + 1U));
  acc_add(&w->acc[DRIVE_ACC_EPS], e);
}

void drive_window_take(drive_t *d, drive_window_t *out)
{
  *out = d->win;
  memset(&d->win, 0, sizeof(d->win));
}

/* ---- the moments ------------------------------------------------------ */

void drive_moments_arm(drive_t *d, uint32_t periods)
{
  memset(&d->mom, 0, sizeof(d->mom));
  d->mom.want = periods;
}

void drive_moments_feed(drive_t *d, const int32_t *codes)
{
  drive_moments_t *m = &d->mom;

  if ((m->want == 0U) || (m->n >= m->want))
  {
    return;
  }
  for (uint8_t k = 0U; k < DRIVE_MOMENT_CHANNELS; k++)
  {
    const int32_t c = codes[k];

    if (m->n == 0U)
    {
      m->lo[k] = c;
      m->hi[k] = c;
    }
    m->lo[k] = (c < m->lo[k]) ? c : m->lo[k];
    m->hi[k] = (c > m->hi[k]) ? c : m->hi[k];
    m->sum[k] += (int64_t)c;
    m->sumsq[k] += (uint64_t)((int64_t)c * (int64_t)c);
  }
  m->n++;
}

/* ---- one period ------------------------------------------------------- */

static float clampf(float x, float lo, float hi)
{
  return fminf(fmaxf(x, lo), hi);
}

/** How much of the angle error comes from the back-EMF, 0..1 by speed. */
static float bemf_weight(const drive_t *d, float speed)
{
  const float w = fabsf(speed);

  if (d->p.w_hi <= d->p.w_lo)
  {
    return (w > d->p.w_lo) ? 1.0f : 0.0f;
  }
  return clampf((w - d->p.w_lo) / (d->p.w_hi - d->p.w_lo), 0.0f, 1.0f);
}

/** The rotor's speed as its back-EMF says it, the estimate's where lambda is unknown. Weighed
    by the estimate's own speed, noise at rest past w_hi handed over to a back-EMF of nothing,
    which read back the drive's feed-forward and held the estimate there. */
static float rotor_speed(const drive_t *d)
{
  return (d->p.lambda > 0.0f) ? d->bemf_speed : d->omega_hat;
}

float drive_room(const drive_t *d)
{
  const float scale = fmaxf(d->th.v_mod_scale, 1.0f);
  const float w = fabsf(d->omega_hat), vmax = d->p.v_frac * scale * d->vdc * INV_SQRT3;
  const float a = w * w * d->p.lq * d->p.lq + d->p.r * d->p.r;
  const float b = d->p.r * w * d->p.lambda;
  const float under = b * b - a * (w * w * d->p.lambda * d->p.lambda - vmax * vmax);
  const float i_volt = (a > 0.0f) ? fmaxf(sqrtf(fmaxf(under, 0.0f)) - b, 0.0f) / a : INFINITY;

  return fminf(i_volt, d->th.i_max_dyn);
}

/** The feedback the loop acts on: the raw dq, or their mean over one
    injection cycle so the HF ripple does not reach the PI and come back out
    as an fs/2 voltage the demodulator would read as inductance. */
static void feedback(drive_t *d, float id_raw, float iq_raw, bool injecting,
                     uint16_t n, float *id, float *iq)
{
  d->fb_d[d->fb_head] = id_raw;
  d->fb_q[d->fb_head] = iq_raw;
  d->fb_head = (uint8_t)((d->fb_head + 1U) % DRIVE_FB_RING);
  if (d->fb_fill < DRIVE_FB_RING)
  {
    d->fb_fill++;
  }

  if (!injecting)
  {
    *id = id_raw;
    *iq = iq_raw;
    return;
  }

  const uint16_t span = (uint16_t)(2U * n);
  const uint16_t use = (d->fb_fill < span) ? d->fb_fill : span;
  float sd = 0.0f;
  float sq = 0.0f;

  for (uint16_t k = 0U; k < use; k++)
  {
    const uint8_t at = (uint8_t)((d->fb_head + DRIVE_FB_RING - 1U - k)
                                 % DRIVE_FB_RING);

    sd += d->fb_d[at];
    sq += d->fb_q[at];
  }
  *id = sd / (float)use;
  *iq = sq / (float)use;
}

/** The demodulator. */
static bool demodulate(drive_t *d, float alpha, float beta, uint16_t n)
{
  const uint32_t at = (d->periods - PIPELINE) & 3U;
  const float s = d->sign_hist[at];

  /* Every difference counts and the cycles abut: 2n consecutive differences
     see n of each sign whatever the alignment, which is what cancels the
     fundamental. Each is taken stationary and read along the axis its step was
     injected on: a difference of currents each rotated into its own frame read
     the frame's turn under the fundamental as angle - at the demo's handover 12 A
     of d current fed 4.4 of each correction back, the estimate a pole off.
     */
  if (d->have_prev)
  {
    const float da = alpha - d->alpha_prev;
    const float db = beta - d->beta_prev;
    const float c = d->cos_hist[at];
    const float sn = d->sin_hist[at];

    d->acc_d += s * (da * c + db * sn);
    d->acc_q += s * (db * c - da * sn);
    d->cyc_count++;
  }
  d->alpha_prev = alpha;
  d->beta_prev = beta;
  d->have_prev = true;

  if (d->cyc_count < (uint16_t)(2U * n))
  {
    return false;
  }

  const float per = 1.0f / (float)(2U * n);

  d->demod_q = d->acc_q * per;
  d->demod_d = d->acc_d * per;
  d->acc_q = 0.0f;
  d->acc_d = 0.0f;
  d->cyc_count = 0U;
  if (d->inj_warm < 2U)
  {
    d->inj_warm++;
  }
  d->inj_valid = (d->inj_warm >= 2U);
  if (d->inj_valid)
  {
    d->ih = fabsf(d->demod_d);
    d->eps_amps = d->demod_q;
    acc_add(&d->win.acc[DRIVE_ACC_IH], d->ih);
  }
  return d->inj_valid;
}

/** The back-EMF's angle error in the rotor observer's frame, or 0 below
    w_lo. */
static float bemf_error(drive_t *d, float alpha, float beta, float w,
                        float c, float s)
{
  float idh, iqh, vdh, vqh;

  if (w <= 0.0f)
  {
    return 0.0f;
  }
  if (c != c)                                    /* NAN: not the loop frame */
  {
    drive_sincos(d->theta_hat, &s, &c);
  }
  drive_park_cs(alpha, beta, c, s, &idh, &iqh);
  drive_park_cs(d->va_out, d->vb_out, c, s, &vdh, &vqh);

  const float ed = vdh - d->p.r * idh + d->omega_hat * d->p.lq * iqh;
  const float eq = vqh - d->p.r * iqh - d->omega_hat * d->p.ld * idh;
  const float sg = (d->omega_hat >= 0.0f) ? 1.0f : -1.0f;

  if ((fabsf(ed) + fabsf(eq)) < 1e-6f)
  {
    return 0.0f;
  }
  return drive_atan2(-ed * sg, eq * sg);
}

/** |back-EMF| in the loop's frame turning at `w_frame`, V: the fundamental the loop drove
    less what R and the frame's turn take of its current, the injection's ripple averaged out
    of both - through R the raw ripple read 10 rad/s at rest at 2 V. */
static float bemf_magnitude(const drive_t *d, float w_frame)
{
  const float ed = d->vd - d->p.r * d->id + w_frame * d->p.lq * d->iq;
  const float eq = d->vq - d->p.r * d->iq - w_frame * d->p.ld * d->id;

  return sqrtf(ed * ed + eq * eq);
}

static void rotor_observer(drive_t *d, float alpha, float beta, bool injecting,
                           bool cycle_done, float w, float c, float s)
{
  const bool cmd_frame = (d->mode == DRIVE_HOLD) || (d->mode == DRIVE_VOLT);
  const float e_b = bemf_error(d, alpha, beta, w, c, s);
  bool have = false;
  float e = 0.0f;

  d->e_bemf = e_b;
  if (d->p.lambda > 0.0f)
  {
    const float mag = bemf_magnitude(d, cmd_frame ? d->omega_cmd : d->omega_hat);

    d->bemf_speed += (mag / d->p.lambda - d->bemf_speed) * (d->ts / BEMF_TAU_S);
  }
  if ((d->mode == DRIVE_SENSORLESS) && injecting)
  {
    if (cycle_done && (d->p.eps_gain != 0.0f))
    {
      e = (1.0f - w) * (d->eps_amps / d->p.eps_gain) + w * e_b;
      have = true;
    }
  }
  else if ((w > 0.0f) && (d->mode != DRIVE_OFF) && (d->mode != DRIVE_POLARITY))
  {
    /* Past the injection, or a command frame past the back-EMF's speed: the estimate on
       the back-EMF. Off or pulsing, nothing is driven to read it by. */
    e = e_b;
    have = true;
  }

  if (have)
  {
    e = e - TWO_PI_F * floorf((e + PI_F) * INV_TWO_PI_F);   /* to (-pi, pi] */
    d->theta_hat += d->p.l1 * e;
    d->omega_hat += d->p.l2 * e;
    d->eps = e;
    window_innovation(&d->win, e);
  }
  else if ((d->mode == DRIVE_HOLD) || (d->mode == DRIVE_VOLT))
  {
    /* A command frame below the back-EMF's speed: nothing to correct on, and the
       frame the rotor is held in is the estimate. */
    d->theta_hat = d->theta_cmd;
    d->omega_hat = d->omega_cmd;
    return;
  }
  d->theta_hat = drive_wrap(d->theta_hat + d->omega_hat * d->ts);
}

/** The PI with decoupling, and the vector limit: the d axis whole, q what the
    circle leaves of it - the field's current stays its reference at the limit,
    the torque's gives way. An axis cut integrates only what pulls it back in. */
static void current_loop(drive_t *d, float id, float iq, float vmax,
                         float w_e, float *vd, float *vq)
{
  const float i_lim = fminf(d->p.i_max, d->th.i_max_dyn);
  const float id_ref = clampf(d->sp.id_ref, -i_lim, i_lim);
  const float iq_ref = clampf(d->sp.iq_ref, -i_lim, i_lim);
  const float ed = id_ref - id;
  const float eq = iq_ref - iq;
  const float vd_u = d->p.kp * ed + d->xd - w_e * d->p.lq * iq;
  const float vq_u = d->p.kp * eq + d->xq + w_e * d->p.ld * id
                     + w_e * d->p.lambda;
  const float vd_c = clampf(vd_u, -vmax, vmax);
  const float room = sqrtf(vmax * vmax - vd_c * vd_c);
  const float vq_c = clampf(vq_u, -room, room);
  const bool d_cut = (vd_u > vmax) || (vd_u < -vmax);
  const bool q_cut = (vq_u > room) || (vq_u < -room);

  *vd = vd_c;
  *vq = vq_c;
  if (!d_cut || (ed * vd_u < 0.0f))
  {
    d->xd += d->p.ki * d->ts * ed;
  }
  if (!q_cut || (eq * vq_u < 0.0f))
  {
    d->xq += d->p.ki * d->ts * eq;
  }
}

/** Two pulses along theta_hat, +V then -V, a gap after each; then OFF. */
static float polarity(drive_t *d, float id)
{
  const uint32_t p = d->sp.pol_periods;
  const uint32_t g = d->sp.pol_gap;
  const uint32_t at = d->pol_step++;
  float v = 0.0f;

  if (at < p)
  {
    v = d->sp.pol_volts;
    d->pol_pos = fmaxf(fabsf(id), d->pol_pos);
  }
  else if (at < (p + g))
  {
    v = 0.0f;
  }
  else if (at < (2U * p + g))
  {
    v = -d->sp.pol_volts;
    d->pol_neg = fmaxf(fabsf(id), d->pol_neg);
  }
  else if (at >= (2U * p + 2U * g))
  {
    d->mode = DRIVE_OFF;
    loop_reset(d);
  }
  return v;
}

static void command_frame(drive_t *d)
{
  if ((d->mode != DRIVE_HOLD) && (d->mode != DRIVE_VOLT))
  {
    return;
  }
  const float step = d->sp.accel * d->ts;
  const float gap = d->sp.omega_target - d->omega_cmd;

  if (fabsf(gap) <= step)
  {
    d->omega_cmd = d->sp.omega_target;
  }
  else
  {
    d->omega_cmd += (gap > 0.0f) ? step : -step;
  }
  d->theta_cmd = drive_wrap(d->theta_cmd + d->omega_cmd * d->ts);
}

/* A current past the trip drops the stage, as the thermal ceiling does; a
   stage dropped under a running mode is a fault too. True: stop here. */
static bool tripped(drive_t *d, const float *i, bool stage_enabled)
{
  if (!stage_enabled)
  {
    if (d->mode != DRIVE_OFF)
    {
      d->fault = DRIVE_FAULT_STAGE;
      d->mode = DRIVE_OFF;
      loop_reset(d);
    }
    return false;
  }
  for (uint8_t k = 0U; k < DRIVE_PHASES; k++)
  {
    if (fabsf(i[k]) > d->p.i_trip)
    {
      d->fault = DRIVE_FAULT_OVERCURRENT;
      d->mode = DRIVE_OFF;
      loop_reset(d);
      return true;
    }
  }
  return false;
}

/* No injection this period: its demodulator starts over. */
static void injection_idle(drive_t *d)
{
  d->inj_valid = false;
  d->inj_warm = 0U;
  d->cyc_count = 0U;
  d->have_prev = false;
  d->acc_q = 0.0f;
  d->acc_d = 0.0f;
  d->ih = 0.0f;
}

/* The fundamental's dq voltage for the mode. Sensorless, the loop's speed is the estimate's
   back-EMF share `w`: at rest the injection's estimate steps each update, and fed forward as
   w lambda it moved the current the demodulator reads as angle - 2 306 rad/s from rest at a
   400 Hz PLL, native's -8 000 with 16 A. The PI carries the back-EMF below w_lo. */
static void fundamental(drive_t *d, float id, float iq, float id_raw, float vmax, float w,
                        float *vd, float *vq)
{
  switch (d->mode)
  {
    case DRIVE_VOLT:
      *vd = d->sp.vd;
      *vq = d->sp.vq;
      break;
    case DRIVE_HOLD:
      current_loop(d, id, iq, vmax, d->omega_cmd, vd, vq);
      break;
    case DRIVE_SENSORLESS:
      current_loop(d, id, iq, vmax, w * d->omega_hat, vd, vq);
      break;
    case DRIVE_POLARITY:
      *vd = polarity(d, id_raw);
      break;
    default:
      break;
  }
}

/* The injection's square wave onto the stationary voltage, its sign and axis kept. */
static void inject(drive_t *d, bool injecting, float amp, uint16_t n, float th,
                   float c, float s, float *va, float *vb)
{
  const uint32_t at = d->periods & 3U;

  if (!injecting)
  {
    d->sign_hist[at] = 0.0f;
    return;
  }
  if (d->inj_count == 0U)
  {
    d->inj_sign = -d->inj_sign;
    d->inj_count = n;
  }
  d->inj_count--;
  if (d->p.inj_phase != 0.0f)
  {
    drive_sincos(th + d->p.inj_phase, &s, &c);
  }
  d->sign_hist[at] = d->inj_sign;
  d->cos_hist[at] = c;
  d->sin_hist[at] = s;
  *va += amp * d->inj_sign * c;
  *vb += amp * d->inj_sign * s;
}

/* One period into the statistics window. */
static void window_add(drive_t *d, float id, float iq, float vd, float vq,
                       float vdc, float peak)
{
  acc_add(&d->win.acc[DRIVE_ACC_ID], id);
  acc_add(&d->win.acc[DRIVE_ACC_IQ], iq);
  acc_add(&d->win.acc[DRIVE_ACC_VD], vd);
  acc_add(&d->win.acc[DRIVE_ACC_VQ], vq);
  acc_add(&d->win.acc[DRIVE_ACC_VDC], vdc);
  d->win.n++;
  d->win.i_peak = fmaxf(peak, d->win.i_peak);
}

bool drive_step(drive_t *d, const drive_sample_t *in, bool stage_enabled,
                drive_out_t *out)
{
  float i[DRIVE_PHASES];
  float alpha, beta, id_raw, iq_raw, id, iq;

  d->periods++;
  d->vdc = in->vdc;
  for (uint8_t k = 0U; k < DRIVE_PHASES; k++)
  {
    i[k] = in->i[k] * d->p.sign;
    out->duty[k] = 0.0f;
  }
  out->driven = false;

  if (tripped(d, i, stage_enabled))
  {
    return true;
  }

  const bool cmd_frame = (d->mode == DRIVE_HOLD) || (d->mode == DRIVE_VOLT);
  const float omega_active = cmd_frame ? d->omega_cmd : d->omega_hat;

  /* Step the real-time junction thermal observer, dynamic PWM period T_sw = 1/f_sw,
     and inverse ceiling predictor I_max(Delta_t) before the observers and PI loop. */
  (void)drive_thermal_step(d, i, in->vdc, omega_active);

  drive_clarke(i, &alpha, &beta);

  const float th = cmd_frame ? d->theta_cmd : d->theta_hat;
  const float w = bemf_weight(d, cmd_frame ? d->omega_cmd : rotor_speed(d));
  uint16_t n = d->p.inj_periods;

  n = (n == 0U) ? 1U : ((n > (DRIVE_FB_RING / 2U)) ? (DRIVE_FB_RING / 2U) : n);

  const float amp = d->p.inj_volts * (1.0f - w);
  const bool injecting = (amp > 0.0f) && (d->mode != DRIVE_OFF)
                         && (d->mode != DRIVE_POLARITY);

  /* One trig pair for the frame; the rotor observer reuses it when the frame
     is its own, and every other transform below is built on it. */
  float c, s;

  drive_sincos(th, &s, &c);
  drive_park_cs(alpha, beta, c, s, &id_raw, &iq_raw);

  bool cycle_done = false;

  if (injecting)
  {
    cycle_done = demodulate(d, alpha, beta, n);
  }
  else
  {
    injection_idle(d);
  }
  feedback(d, id_raw, iq_raw, injecting, n, &id, &iq);
  d->id = id;
  d->iq = iq;

  const float was = d->theta_hat;

  rotor_observer(d, alpha, beta, injecting, cycle_done, w,
                 cmd_frame ? NAN : c, cmd_frame ? NAN : s);
  /* A step moves the estimate a fraction of a turn: a gap past half of one is its wrap. */
  if (d->theta_hat - was < -PI_F)
  {
    d->turns += 1U;
  }
  else if (d->theta_hat - was > PI_F)
  {
    d->turns -= 1U;
  }
  command_frame(d);

  /* The duties wait a period and meet the rotor at the angle the step just
     advanced to. */
  const float th_out = cmd_frame ? d->theta_cmd : d->theta_hat;

  drive_sincos(th_out, &s, &c);

  /* the fundamental: WEP overmodulation expands the circular limit from Vdc/sqrt3
     toward 2*Vdc/sqrt3, while drive_hex_clamp projects onto the hexagon boundary. */
  const float v_mod = fmaxf(d->th.v_mod_scale, 1.0f);
  const float vmax = clampf(d->p.v_frac * v_mod * in->vdc * INV_SQRT3 - amp,
                            0.0f, 1e9f);
  float vd = 0.0f;
  float vq = 0.0f;

  fundamental(d, id, iq, id_raw, vmax, w, &vd, &vq);

  float va, vb;

  drive_inv_park_cs(vd, vq, c, s, &va, &vb);
  if (d->th.gamma_wep > 0.0f)
  {
    const float hex_scale = drive_hex_clamp(&va, &vb, in->vdc, d->p.v_frac);

    vd *= hex_scale;
    vq *= hex_scale;
  }
  d->vd = vd;
  d->vq = vq;
  d->va_out = va;
  d->vb_out = vb;

  /* The observer chain, on the same samples and steering nothing: the
     voltage the modulator is about to apply and the current just measured,
     both in the stationary frame. */
  drive_observer_step(&d->obs, &d->p, va, vb, alpha, beta, d->ts);

  /* the inverter's error on the fundamental, cancelled before it happens:
     the raw sample carries an fs/2 injection ripple whose sign turns every
     period. */
  if (d->p.dt_step > 0.0f)
  {
    float ia_f, ib_f, i_f[DRIVE_PHASES], comp[DRIVE_PHASES];
    float ca, cb;

    drive_inv_park_cs(id, iq, c, s, &ia_f, &ib_f);
    i_f[0] = ia_f;
    i_f[1] = -0.5f * ia_f + HALF_SQRT3 * ib_f;
    i_f[2] = -0.5f * ia_f - HALF_SQRT3 * ib_f;
    for (uint8_t k = 0U; k < DRIVE_PHASES; k++)
    {
      comp[k] = drive_dt_volts(&d->p, i_f[k]);
    }
    drive_clarke(comp, &ca, &cb);
    va += ca;
    vb += cb;
  }

  inject(d, injecting, amp, n, th_out, c, s, &va, &vb);

  if (stage_enabled && (d->mode != DRIVE_OFF))
  {
    (void)drive_svm(va, vb, in->vdc, out->duty);
    out->driven = true;
  }
  else
  {
    d->va_out = 0.0f;
    d->vb_out = 0.0f;
  }

  window_add(d, id, iq, vd, vq, in->vdc, sqrtf(id_raw * id_raw + iq_raw * iq_raw));
  return false;
}
