rogerisaksson/coaxial_63100/board/src/board_drive.c

/** board_drive.c - The control law on this hardware, once a PWM period. */
#include "board.h"
#include "board_irq.h"
#include "board_ctrl.h"
#include "board_drive.h"
#include "board_hw.h"
#include "board_units.h"

#include <math.h>

/** The drive glue's state: the law, the record's derate and clamp, the
    ownership of the compares, the step's cost, and the converters' scaling. */
static struct
{
  drive_t drive;
  bool ready;
  /** What the thermal envelope is scaling the current clamp by, 1 to 0. */
  float derate;
  /** The clamp the record asked for, before any derating. */
  float i_max_cal;
  bool owned;                     /**< the drive holds the compares */
  uint32_t cycles_last;           /**< what one step cost, raw CYCCNT */
  uint32_t cycles_max;
  /** Where TIM1 stood when the step ended, in ticks past the trigger: the
      conversion, the HAL's interrupt entry and the step, all of it. */
  uint16_t exit_ticks_max;

  /** The conversions, affine and cached: refreshed with the parameters. */
  int32_t i_off[BOARD_PWM_PHASES];
  float i_k[BOARD_PWM_PHASES];
  int32_t v_off;
  float v_k;
  float arr;
  uint16_t arr_active;
  uint16_t trig_lead;
} s = {
  .derate = 1.0f, .i_max_cal = 0.0f, .trig_lead = 15U
};

void Board_DriveDerate(float factor)
{
  /* Clamped here rather than trusted: this is a multiplier on a current
     limit, and a value outside 0..1 would be a limit RAISED by the thermal
     envelope, which is the one thing it must never do. */
  if (!(factor >= 0.0f))
  {
    factor = 0.0f;
  }
  if (factor > 1.0f)
  {
    factor = 1.0f;
  }
  s.derate = factor;
  if (s.ready)
  {
    s.drive.p.i_max = s.i_max_cal * s.derate;
  }
}

float Board_DriveDerating(void)
{
  return s.derate;
}

float Board_DriveClamp(void)
{
  return s.i_max_cal;
}

#define TWO_PI_F 6.2831853f
#define CODES_PER_TURN 65536.0f   /* the wire's angle: a turn in 65536 */
#define LOG_EPS_SCALE  10000.0f   /* the log's eps: tenths of a milliradian */

static float milli(uint32_t v)
{
  return (float)v / MILLI_PER_UNIT;
}

static float micro(uint32_t v)
{
  return (float)v / MICRO_PER_UNIT;
}

static float milli_signed(uint32_t v)
{
  return (float)(int32_t)v / MILLI_PER_UNIT;
}

void Board_DriveParamsFromCal(void)
{
  const board_cal_t *cal = Board_Cal();
  drive_params_t *p = &s.drive.p;

  p->r = micro(cal->motor_r_uohm);
  p->ld = (float)cal->motor_ld_nh / NANO_PER_UNIT;
  p->lq = (float)cal->motor_lq_nh / NANO_PER_UNIT;
  p->lambda = micro(cal->motor_lambda_uvs);
  p->pole_pairs = (float)cal->motor_pole_pairs;
  p->kp = milli(cal->drv_kp_mv_per_a);
  p->ki = (float)cal->drv_ki_v_per_as;
  p->l1 = milli(cal->drv_l1_milli);
  p->l2 = milli(cal->drv_l2_milli);
  p->inj_volts = milli(cal->drv_inj_mv);
  p->inj_periods = (uint16_t)cal->drv_inj_periods;
  p->inj_phase = milli_signed(cal->drv_inj_phase_mrad);
  p->eps_gain = (float)(int32_t)cal->drv_eps_gain_ua_per_rad / MICRO_PER_UNIT;
  s.i_max_cal = milli(cal->drv_i_max_ma);
  p->i_max = s.i_max_cal * s.derate;
  p->i_trip = milli(cal->drv_i_trip_ma);
  p->v_frac = micro(cal->drv_v_frac_ppm);
  p->sign = ((int32_t)cal->drv_sign < 0) ? -1.0f : 1.0f;
  p->w_lo = milli(cal->drv_w_lo_mrad_s);
  p->w_hi = milli(cal->drv_w_hi_mrad_s);
  p->dt_step = milli(cal->drv_dt_step_ma);
  for (uint8_t k = 0U; k < DRIVE_DT_POINTS; k++)
  {
    p->dt_volts[k] = milli(cal->drv_dt_mv[k]);
  }

  for (uint8_t k = 0U; k < BOARD_PWM_PHASES; k++)
  {
    Board_PhaseScale(k, &s.i_off[k], &s.i_k[k]);
  }
  Board_DcBusScale(&s.v_off, &s.v_k);

  /* The sample point the commissioning chose, if it chose one. */
  if (cal->drv_trigger_ticks != 0U)
  {
    const uint16_t trig = (uint16_t)cal->drv_trigger_ticks;
    const uint16_t arr_nom = (uint16_t)s.arr;

    s.trig_lead = (arr_nom > trig) ? (uint16_t)(arr_nom - trig) : 15U;
    (void)Board_SyncSetTrigger(trig);
  }
  else
  {
    s.trig_lead = 15U;
  }
}

void Board_DriveInit(void)
{
  /* Centre-aligned, so a period is twice ARR ticks of the timer clock, which
     is half SYSCLK. */
  const uint32_t period = Board_PwmPeriod();
  const uint32_t arr = (period > 0U) ? (period - 1U) : 0U;
  const uint32_t ticks = 2U * arr;
  const uint32_t hz = Board_SysClkHz() / 2U;
  const float ts = ((ticks != 0U) && (hz != 0U))
                   ? ((float)ticks / (float)hz) : 20e-6f;

  s.arr = (float)arr;
  s.arr_active = (uint16_t)arr;
  s.trig_lead = 15U;
  drive_init(&s.drive, ts);
  s.drive.cycles = Board_Cycles;
  Board_DriveParamsFromCal();
  s.owned = false;
  s.cycles_max = 0U;
  s.ready = true;
}

const drive_t *Board_Drive(void)
{
  return &s.drive;
}

float Board_DriveTs(void)
{
  return s.drive.ts;
}

const char *Board_DriveSetMode(uint8_t mode)
{
  if (!s.ready)
  {
    return "the drive has not been initialised - the board has not "
           "finished starting";
  }
  const char *sync = ((mode != (uint8_t)DRIVE_OFF) && !Board_SyncArmed())
                     ? Board_SyncArm() : NULL;

  if (sync != NULL)
  {
    return sync;              /* no triple, no loop: the sync's own words */
  }

  /* The record may have been edited since the last mode change; a drive
     running yesterday's gains after today's calibration is the stale copy
     invariant 7 exists to prevent. */
  Board_DriveParamsFromCal();

  const uint32_t masked = Board_IrqHold();
  const char *why = drive_set_mode(&s.drive, (drive_mode_t)mode,
                                   Board_PwmIsEnabled(), Board_AfeOn());
  Board_IrqRelease(masked);
  return why;
}

const char *Board_DriveSetpoint(uint8_t id, int32_t value)
{
  drive_setpoints_t *sp = &s.drive.sp;
  const float f = (float)value;

  switch (id)
  {
    case 0U: sp->id_ref = f / MILLI_PER_UNIT; break;
    case 1U: sp->iq_ref = f / MILLI_PER_UNIT; break;
    case 2U:
    {
      /* In a command frame the frame moves with it, against the ISR's own step. */
      const uint32_t masked = Board_IrqHold();

      drive_set_theta_setpoint(&s.drive, f / MILLI_PER_UNIT);
      Board_IrqRelease(masked);
      break;
    }
    case 3U: sp->omega_target = f / MILLI_PER_UNIT; break;
    case 4U: sp->accel = f / MILLI_PER_UNIT; break;
    case 5U: sp->vd = f / MILLI_PER_UNIT; break;
    case 6U: sp->vq = f / MILLI_PER_UNIT; break;
    case 7U: sp->pol_volts = f / MILLI_PER_UNIT; break;
    case 8U:
      if ((value <= 0) || (value > UINT16_MAX))
      {
        return "pol_periods is 1..65535 PWM periods";
      }
      sp->pol_periods = (uint16_t)value;
      break;
    case 9U:
      if ((value < 0) || (value > UINT16_MAX))
      {
        return "pol_gap is 0..65535 PWM periods";
      }
      sp->pol_gap = (uint16_t)value;
      break;
    default:
      return "no such setpoint - 0 id_ref mA, 1 iq_ref mA, 2 theta mrad, "
             "3 omega_target mrad/s, 4 accel mrad/s2, 5 vd mV, 6 vq mV, "
             "7 pol_volts mV, 8 pol_periods, 9 pol_gap";
  }
  return NULL;
}

void Board_DriveSetpointsGet(int32_t *out)
{
  const drive_setpoints_t *sp = &s.drive.sp;

  out[0] = (int32_t)(sp->id_ref * MILLI_PER_UNIT);
  out[1] = (int32_t)(sp->iq_ref * MILLI_PER_UNIT);
  out[2] = (int32_t)(sp->theta * MILLI_PER_UNIT);
  out[3] = (int32_t)(sp->omega_target * MILLI_PER_UNIT);
  out[4] = (int32_t)(sp->accel * MILLI_PER_UNIT);
  out[5] = (int32_t)(sp->vd * MILLI_PER_UNIT);
  out[6] = (int32_t)(sp->vq * MILLI_PER_UNIT);
  out[7] = (int32_t)(sp->pol_volts * MILLI_PER_UNIT);
  out[8] = (int32_t)sp->pol_periods;
  out[9] = (int32_t)sp->pol_gap;
}

const char *Board_DriveSetSource(uint8_t source)
{
  if (source > 1U)
  {
    return "source is 0 for the converters or 1 for the model";
  }
  if (s.drive.mode != DRIVE_OFF)
  {
    return "the drive is running - mode 0 first, then change where its "
           "samples come from";
  }

  const uint32_t masked = Board_IrqHold();
  s.drive.source = (source != 0U) ? DRIVE_SOURCE_MODEL : DRIVE_SOURCE_ADC;
  drive_model_init(&s.drive.model);
  Board_IrqRelease(masked);
  return NULL;
}

const char *Board_DriveModelParam(uint8_t id, int32_t value)
{
  drive_model_params_t *p = &s.drive.model.p;
  const float f = (float)value;

  switch (id)
  {
    case 0U:  p->r = f / MICRO_PER_UNIT; break;
    case 1U:  if (value <= 0) { return "ld is nanohenry, above zero"; }
              p->ld = f / NANO_PER_UNIT; break;
    case 2U:  if (value <= 0) { return "lq is nanohenry, above zero"; }
              p->lq = f / NANO_PER_UNIT; break;
    case 3U:  p->lambda = f / MICRO_PER_UNIT; break;
    case 4U:  if (value <= 0) { return "pole pairs is a count above zero"; }
              p->pole_pairs = f; break;
    case 5U:  p->sat = f / MICRO_PER_UNIT; break;
    case 6U:  if (value <= 0) { return "i_sat is milliamperes, above zero"; }
              p->i_sat = f / MILLI_PER_UNIT; break;
    case 7U:  if (value <= 0) { return "J is nano kg m2, above zero"; }
              p->j = f / NANO_PER_UNIT; break;
    case 8U:  p->b = f / NANO_PER_UNIT; break;
    case 9U:  p->load = f / MICRO_PER_UNIT; break;
    case 10U: p->v_dt = f / MILLI_PER_UNIT; break;
    case 11U: if (value <= 0) { return "i_knee is milliamperes, above zero"; }
              p->i_knee = f / MILLI_PER_UNIT; break;
    case 12U: if (value <= 0) { return "vdc is millivolts, above zero"; }
              p->vdc = f / MILLI_PER_UNIT; break;
    case 13U: p->noise = f / MICRO_PER_UNIT; break;
    case 14U: p->theta0 = f / MICRO_PER_UNIT; break;
    case 15U: if ((value < 1) || (value > 16)) { return "substeps is 1..16"; }
              p->sub = (uint8_t)value; break;
    default:
      return "no such model parameter - 0 r uohm, 1 ld nH, 2 lq nH, 3 lambda "
             "uVs, 4 pole pairs, 5 sat ppm, 6 i_sat mA, 7 J nkgm2, 8 B nNms, "
             "9 load uNm, 10 v_dt mV, 11 i_knee mA, 12 vdc mV, 13 noise uA, "
             "14 theta0 urad, 15 substeps";
  }
  return NULL;
}

void Board_DriveModelReset(void)
{
  const uint32_t masked = Board_IrqHold();
  drive_model_init(&s.drive.model);
  Board_IrqRelease(masked);
}

void Board_DriveSetTheta(int32_t microradians)
{
  const uint32_t masked = Board_IrqHold();
  drive_set_theta(&s.drive, (float)microradians / MICRO_PER_UNIT);
  Board_IrqRelease(masked);
}

void Board_DriveWindowTake(drive_window_t *out)
{
  const uint32_t masked = Board_IrqHold();
  drive_window_take(&s.drive, out);
  Board_IrqRelease(masked);
}

void Board_DriveMomentsArm(uint32_t periods)
{
  const uint32_t masked = Board_IrqHold();
  drive_moments_arm(&s.drive, periods);
  Board_IrqRelease(masked);
}

void Board_DriveMoments(drive_moments_t *out)
{
  const uint32_t masked = Board_IrqHold();
  *out = s.drive.mom;
  Board_IrqRelease(masked);
}

void Board_DriveCycles(uint32_t *last, uint32_t *max)
{
  *last = s.cycles_last;
  *max = s.cycles_max;
}

void Board_DriveCyclesReset(void)
{
  s.cycles_max = 0U;
  s.exit_ticks_max = 0U;
}

uint16_t Board_DriveExitTicks(void)
{
  return s.exit_ticks_max;
}

bool Board_DriveOwnsCompares(void)
{
  return s.owned;
}

/* The stage is the drive's from the first triple until it lets go - taken
   once, not asked for every period. */
static void own_pwm(void)
{
  if (s.owned)
  {
    return;
  }
  Board_PwmDriveOwn(true);
  s.owned = true;
}

/* vrintr.f32 on Cortex-M7: one instruction, no branch; lrintf is a library
   call from ITCM. */
static inline int32_t rounded(float x)
{
  return (int32_t)nearbyintf(x);
}

void Board_DriveSetWep(float gamma_wep)
{
  drive_set_wep(&s.drive, gamma_wep);
}

float Board_DriveWep(void)
{
  return s.drive.th.gamma_wep;
}

void Board_DriveSetPcbTemp(float t_ntc)
{
  drive_set_pcb_temp(&s.drive, t_ntc);
}

/** What the law's duties do to the compares this period: nothing while the
    stage is down, the next triple while the law drives an armed stage, and
    the bridge let go, open, once it stops - polarity finishing, a stage
    drop, the host asking for OFF. */
static void commit_duties(const drive_out_t *out, bool enabled)
{
  if (enabled && out->driven)
  {
    uint16_t ticks[BOARD_PWM_PHASES];
    const float f_nom = fmaxf(s.drive.tp.f_sw_nom, 1000.0f);
    const float f_act = fminf(fmaxf(s.drive.th.f_sw, 500.0f), f_nom);
    const uint16_t arr_dyn = (uint16_t)rounded(s.arr * (f_nom / f_act));

    if ((arr_dyn >= 64U) && (arr_dyn != s.arr_active) && Board_PwmSetPeriod(arr_dyn))
    {
      const uint16_t lead = s.trig_lead;
      const uint16_t trig = (arr_dyn > lead) ? (uint16_t)(arr_dyn - lead) : 1U;

      s.arr_active = arr_dyn;
      (void)Board_SyncSetTrigger(trig);
    }

    const float arr = (float)((arr_dyn >= 64U) ? arr_dyn : (uint16_t)s.arr);

    for (uint8_t k = 0U; k < BOARD_PWM_PHASES; k++)
    {
      ticks[k] = (uint16_t)rounded(out->duty[k] * arr);
    }
    own_pwm();
    Board_PwmSetNext(ticks);
    return;
  }
  if (s.owned)
  {
    if ((s.arr >= 64.0f) && (s.arr_active != (uint16_t)s.arr))
    {
      const uint16_t arr_nom = (uint16_t)s.arr;
      const uint16_t lead = s.trig_lead;

      if (Board_PwmSetPeriod(arr_nom))
      {
        s.arr_active = arr_nom;
        if (arr_nom > lead)
        {
          (void)Board_SyncSetTrigger((uint16_t)(arr_nom - lead));
        }
      }
    }
    Board_PwmDriveOwn(false);
    s.owned = false;
  }
}

void Board_DriveOnSample(const int16_t *phase, uint32_t dcbus_raw)
{
  /* In ADC3's interrupt, straight after the triple was latched. */
  if (!s.ready)
  {
    return;
  }

  const uint32_t t0 = Board_Cycles();
  int32_t codes[DRIVE_MOMENT_CHANNELS];
  drive_sample_t in;
  drive_out_t out;

  /* The board's loop first: its command is this period's setpoint. */
  Board_CtrlTick(&s.drive);

  for (uint8_t k = 0U; k < BOARD_PWM_PHASES; k++)
  {
    codes[k] = (int32_t)phase[k];
    in.i[k] = (float)(codes[k] - s.i_off[k]) * s.i_k[k];
  }
  codes[3] = (int32_t)dcbus_raw;
  in.vdc = (float)(codes[3] - s.v_off) * s.v_k;
  drive_moments_feed(&s.drive, codes);

  const bool enabled = Board_PwmIsEnabled();
  /* The model as the source: the law runs on its currents whether or not a
     stage is armed, and the duties below reach the gates only if one is -
     which is how the rotor observer is watched on this bench, where the
     converters and the drivers are never powered together. */
  const bool trip = (s.drive.source == DRIVE_SOURCE_MODEL)
                    ? drive_step_virtual(&s.drive, &out)
                    : drive_step(&s.drive, &in, enabled, &out);

  if (trip)
  {
    /* The trip: MOE down in hardware before this returns. */
    Board_PwmDisable();
    s.owned = false;
  }
  else
  {
    commit_duties(&out, enabled);
  }

  /* The ring, when armed for this source: dq current, the rotor observer's
     angle as a turn in 65536, the innovation in 0.1 mrad. */
  if ((Board_LogSources() & (1U << BOARD_LOG_SOURCE_DRIVE)) != 0U)
  {
    const int16_t logged[4] = {
      (int16_t)rounded(s.drive.id * CENTI_PER_UNIT),
      (int16_t)rounded(s.drive.iq * CENTI_PER_UNIT),
      (int16_t)(uint16_t)rounded(s.drive.theta_hat * (CODES_PER_TURN / TWO_PI_F)),
      (int16_t)rounded(s.drive.eps * LOG_EPS_SCALE),
    };

    Board_LogPush(BOARD_LOG_SOURCE_DRIVE, logged, 4U);
  }

  s.cycles_last = Board_Cycles() - t0;
  s.cycles_max = (s.cycles_last > s.cycles_max) ? s.cycles_last : s.cycles_max;

  /* The trigger fires on the down-slope at CCR5; the counter has fallen
     since, or turned at zero and climbed. */
  const uint32_t cnt = TIM1->CNT;
  const uint32_t trigger = Board_SyncTrigger();
  const uint32_t since = ((TIM1->CR1 & TIM_CR1_DIR) != 0U)
                         ? (trigger - cnt) : (trigger + cnt);

  if (since > s.exit_ticks_max)
  {
    s.exit_ticks_max = (uint16_t)since;
  }
}
