rogerisaksson/coaxial_63100/drive/inc/drive.h

/** drive.h - The control law: one PWM period in, three duties out. */
#ifndef DRIVE_H
#define DRIVE_H

#include <stdbool.h>
#include <stdint.h>

#ifdef __cplusplus
extern "C" {
#endif

#define DRIVE_PHASES 3U

/** Points in the dead-time compensation table, at multiples of `dt_step`. */
#define DRIVE_DT_POINTS 8U

/** Lags of the innovation autocorrelation the window keeps, 1..LAGS. */
#define DRIVE_LAGS 7U

/** Channels the raw-code moments cover: U, V, W, DC bus. */
#define DRIVE_MOMENT_CHANNELS 4U

typedef enum
{
  DRIVE_OFF = 0,     /**< duties at zero, everything else still runs */
  DRIVE_VOLT,        /**< open loop: vd, vq in the command frame */
  DRIVE_HOLD,        /**< current control in the command frame; I/f when omega_target is not
      zero */
  DRIVE_SENSORLESS,  /**< current control in the rotor observer's frame */
  DRIVE_POLARITY,    /**< two voltage pulses along theta_hat, then OFF */
  DRIVE_MODES
} drive_mode_t;

typedef enum
{
  DRIVE_FAULT_NONE = 0,
  DRIVE_FAULT_OVERCURRENT,   /**< a phase passed `i_trip`; the stage was dropped */
  DRIVE_FAULT_STAGE,         /**< MOE went away under a running mode */
  DRIVE_FAULT_SUPPLY         /**< AFE_ON went away: readings mean nothing */
} drive_fault_t;

/** What the host tells the drive, in SI. The record keeps integers. */
typedef struct
{
  float r;             /**< phase resistance, ohm */
  float ld;            /**< d inductance, henry */
  float lq;            /**< q inductance, henry */
  float lambda;        /**< PM flux linkage, V.s */
  float pole_pairs;
  float kp;            /**< current loop, V/A */
  float ki;            /**< current loop, V/(A.s) */
  float l1;            /**< rotor observer angle gain, 1 */
  float l2;            /**< rotor observer speed gain, 1/s */
  float inj_volts;     /**< HF injection amplitude, V */
  uint16_t inj_periods;/**< PWM periods per injection half cycle; 1 = fs/2 */
  float inj_phase;     /**< injection axis, rad from the frame's d axis */
  float eps_gain;      /**< demodulated amps per radian of angle error */
  float i_max;         /**< reference clamp, A */
  float i_trip;        /**< drop the stage past this, A, per phase */
  float v_frac;        /**< of Vdc/sqrt3 the voltage vector may use */
  float sign;          /**< +1 or -1: shunt polarity against the drive */
  float w_lo;          /**< below this the injection error alone, rad/s */
  float w_hi;          /**< above this the back-EMF error alone, rad/s */
  float dt_step;       /**< dead-time table spacing, A */
  float dt_volts[DRIVE_DT_POINTS]; /**< voltage error at k*dt_step, V */
} drive_params_t;

/** What a mode is asked to do. Runtime only; never in the record. */
typedef struct
{
  float id_ref;        /**< A, in the mode's frame */
  float iq_ref;        /**< A */
  float theta;         /**< rad: the command frame's angle (HOLD, VOLT) */
  float omega_target;  /**< rad/s the command frame ramps to (I/f) */
  float accel;         /**< rad/s^2 of that ramp */
  float vd;            /**< VOLT mode, V */
  float vq;
  float pol_volts;     /**< POLARITY: pulse amplitude, V */
  uint16_t pol_periods;/**< POLARITY: periods per pulse */
  uint16_t pol_gap;    /**< POLARITY: periods between them */
} drive_setpoints_t;

/** One period's measurement, already in amperes and volts. */
typedef struct
{
  float i[DRIVE_PHASES];   /**< phase currents as the shunts report them */
  float vdc;               /**< DC link, V */
} drive_sample_t;

typedef struct
{
  float duty[DRIVE_PHASES];   /**< 0..1 per leg */
  bool driven;                /**< the legs switch at `duty`; false: the bridge open */
} drive_out_t;

/** Feedback ring: one injection cycle of dq samples. */
#define DRIVE_FB_RING 16U

/** Running sums over a window, double so 10^5 periods do not lose bits. */
typedef struct
{
  uint32_t n;
  double sum;
  double sumsq;
} drive_acc_t;

/** Which fields the window accumulates, in wire order. */
typedef enum
{
  DRIVE_ACC_ID = 0, DRIVE_ACC_IQ, DRIVE_ACC_VD, DRIVE_ACC_VQ,
  DRIVE_ACC_EPS, DRIVE_ACC_IH, DRIVE_ACC_VDC, DRIVE_ACC_FIELDS
} drive_acc_field_t;

/** The window's totals and the innovation's lagged products. */
typedef struct
{
  uint32_t n;
  drive_acc_t acc[DRIVE_ACC_FIELDS];
  double  lag[DRIVE_LAGS + 1U];      /**< sum e[k] e[k-j], j = 0..LAGS */
  float   e_ring[DRIVE_LAGS + 1U];   /**< the last innovations */
  uint8_t e_head;
  float   i_peak;                    /**< largest |i_dq| seen */
} drive_window_t;

/** Raw-code moments: what the converter did at one sample point. */
typedef struct
{
  int64_t  sum[DRIVE_MOMENT_CHANNELS];
  uint64_t sumsq[DRIVE_MOMENT_CHANNELS];
  int32_t  lo[DRIVE_MOMENT_CHANNELS];
  int32_t  hi[DRIVE_MOMENT_CHANNELS];
  uint32_t n;
  uint32_t want;                     /**< periods asked for; 0 is idle */
} drive_moments_t;

/** Where the samples come from: the converters, or the model below. */
typedef enum
{
  DRIVE_SOURCE_ADC = 0,
  DRIVE_SOURCE_MODEL
} drive_source_t;

/** A PMSM and its inverter, for running the law with no motor and no front
    end - drive_model.c. */
typedef struct
{
  float r, ld, lq, lambda, pole_pairs;
  float sat;           /**< Ld bends by this fraction at i_sat of d current */
  float i_sat;
  float j;             /**< kg m^2 */
  float b;             /**< N m s */
  float load;          /**< N m */
  float v_dt;          /**< the inverter's dead-time volts per phase */
  float i_knee;        /**< where that error saturates, A */
  float vdc;           /**< the link it runs from, V */
  float noise;         /**< current noise sd on each shunt, A */
  float theta0;        /**< the rotor's angle at init, rad electrical */
  uint8_t sub;         /**< Euler sub-steps per period */
} drive_model_params_t;

typedef struct
{
  drive_model_params_t p;
  float theta;         /**< electrical, the truth the rotor observer is judged by */
  float omega;         /**< electrical */
  float omega_lo;      /**< the low bits omega's sum drops */
  float id, iq;        /**< in the rotor's own frame */
  float id_prev, iq_prev;
  float duty_prev[DRIVE_PHASES]; /**< the pipeline: last step's duties */
  bool driven_prev;              /**< and whether its bridge switched */
  float c, s;                    /**< cos/sin of theta at the sample */
  float i_abc[DRIVE_PHASES];     /**< the sample's currents, noise-free */
  uint32_t rng;
} drive_model_t;

/** The back-EMF observer chain, drive_observer.c. */
#define DRIVE_OBS_WC           20.0f   /**< the leak, rad/s electrical */
#define DRIVE_OBS_CROSS        20.0f   /**< current model pull, rad/s */
#define DRIVE_OBS_PLL_KP      200.0f
#define DRIVE_OBS_PLL_KI     8000.0f
#define DRIVE_OBS_BLEND_LO     40.0f   /**< x wc: all dual below */
#define DRIVE_OBS_BLEND_HI    150.0f   /**< x wc: all flux above */
#define DRIVE_OBS_SPEED_FILTER 300.0f  /**< on the flux model's own speed */

/** What the chain holds. */
typedef struct
{
  float psi_a, psi_b;        /**< dual: the voltage model, held down */
  float leak_a, leak_b;      /**< plain: the leaking integrator */
  float pll_theta, pll_omega;/**< dual: the PLL's state */
  float flux_theta;          /**< plain: its angle */
  float flux_omega;          /**< plain: its filtered speed */
  float dual_theta;          /**< what each reported this step */
  float flux_only;
  float theta;               /**< the blend, rad electrical */
  float omega;               /**< the blend's speed, rad/s electrical */
  float blend;               /**< 0 all dual, 1 all flux */
  float lambda_hat;          /**< |psi_r| - the magnets, across the gap */
  float wc, cross, pll_kp, pll_ki, blend_lo, blend_hi;
  float ts;
  bool  valid;               /**< above wc, so there is a back-EMF at all */
} drive_obs_t;

/** Start the chain from the parameters the drive is running. */
void drive_observer_init(drive_obs_t *o, const drive_params_t *p, float ts);

/** Hand the chain the estimate the drive already holds. */
void drive_observer_sync(drive_obs_t *o, const drive_params_t *p,
                         float theta, float omega);

/** One step, on the applied voltage and the measured current, both in the
    stationary frame. */
void drive_observer_step(drive_obs_t *o, const drive_params_t *p,
                         float va, float vb, float ia, float ib, float ts);

/** Real-time 3-node Cauer thermal RC network parameters (Junction -> Case/Solder -> PCB)
    and coupled semiconductor loss model, evaluated every PWM period. */
#define DRIVE_TJ_NODES 3U

typedef struct
{
  float r_ds0;         /**< MOSFET R_DS(on) at reference temperature t_ref, ohm */
  float alpha_r;       /**< positive temperature coefficient of R_DS(on), 1/K */
  float t_ref;         /**< reference temperature T_0 for R_DS(on), deg C */
  float e_sw;          /**< switching energy coefficient: P_sw = e_sw * Vdc * |I| * f_sw, W/(V*A*Hz) */
  float r_th[DRIVE_TJ_NODES]; /**< Cauer thermal resistances [R_jc, R_cs, R_sb] to NTC, K/W */
  float c_th[DRIVE_TJ_NODES]; /**< Cauer thermal capacitances [C_j, C_c, C_s], J/K */
  float tj_nom;        /**< nominal continuous junction temperature limit T_{j,nom}, deg C */
  float tj_max;        /**< absolute silicon maximum temperature limit T_{j,max}, deg C */
  float horizon_s;     /**< prediction horizon Delta_t for inverse ceiling I_max(Delta_t), s */
  float f_sw_nom;      /**< nominal PWM switching frequency f_{sw,nom}, Hz */
  float f_sw_min;      /**< minimum PWM switching frequency f_{sw,min}, Hz */
  float omega_sw_knee; /**< electrical speed knee for quasi-static f_sw downscaling, rad/s */
} drive_thermal_params_t;

/** Flat, statically allocated state of the real-time junction observer, WEP envelope,
    and dynamic PWM / overmodulation projection. */
typedef struct
{
  float t_node[DRIVE_TJ_NODES]; /**< Cauer node temperatures [T_j_hat, T_c_hat, T_s_hat], deg C */
  float t_pcb;                  /**< sampled PCB / NTC boundary temperature T_NTC, deg C */
  float gamma_wep;              /**< continuous War Emergency Power override in [0, 1] */
  float tj_hat;                 /**< worst-case estimated junction temperature \hat{T}_j, deg C */
  float tj_limit;               /**< active interpolated junction ceiling T_{j,limit}(gamma_WEP), deg C */
  float p_loss;                 /**< instantaneous coupled loss P_loss in worst-loaded phase, W */
  float r_dson;                 /**< temperature-dependent R_DS(on)(\hat{T}_j), ohm */
  float f_sw;                   /**< active dynamic switching frequency f_sw, Hz */
  float ts_active;              /**< active PWM period T_sw = 1 / f_sw, s */
  float v_mod_scale;            /**< active voltage circle-to-hexagon modulation factor in [1, 2] */
  float i_max_dyn;              /**< continuous inverse-predicted current bound I_max(Delta_t), A */
} drive_thermal_state_t;

/** The whole controller. Owned by the caller; drive_init fills it. */
typedef struct
{
  float ts;                          /**< PWM period, s */
  drive_params_t p;
  drive_setpoints_t sp;
  drive_mode_t mode;
  drive_fault_t fault;
  drive_source_t source;
  drive_model_t model;

  /** A cycle counter the board lends, or NULL: with it the virtual step
      records what its three blocks cost, so an interrupt that outgrew the
      period is read block by block rather than guessed at. */
  uint32_t (*cycles)(void);
  uint32_t cyc_sample, cyc_step, cyc_advance;

  /* the rotor observer */
  float theta_hat;
  float omega_hat;
  float eps;                         /**< last innovation, rad */
  float eps_amps;                    /**< last demodulated error, A */
  float ih;                          /**< last HF current amplitude, A */
  float e_bemf;                      /**< last back-EMF angle error, rad */
  float bemf_speed;                  /**< |back-EMF| / lambda, filtered: the rotor's speed as its voltage says it, rad/s */
  uint32_t turns;                    /**< theta_hat's whole turns, modulo 2^32: theta_hat + 2 pi turns runs on through its wraps */

  /* the back-EMF observer chain, beside it */
  drive_obs_t obs;

  /* the command frame */
  float theta_cmd;
  float omega_cmd;

  /* the current loop */
  float xd, xq;                      /**< integrators, V */
  float id, iq;                      /**< this period, in the loop frame */
  float vd, vq;                      /**< this period's demand, V */
  float va_out, vb_out;              /**< the fundamental applied, alpha/beta */
  float vdc;
  float   fb_d[DRIVE_FB_RING];       /**< feedback ring, see feedback() */
  float   fb_q[DRIVE_FB_RING];
  uint8_t fb_head;
  uint8_t fb_fill;

  /* the injection */
  float    inj_sign;                 /**< +1 or -1 this period */
  uint16_t inj_count;                /**< periods left at this sign */
  float    sign_hist[4];             /**< the sign each recent step wrote */
  float    cos_hist[4];              /**< and the axis it wrote it on */
  float    sin_hist[4];
  float    alpha_prev;               /**< the last sample, stationary */
  float    beta_prev;
  bool     have_prev;                /**< alpha_prev holds a sample */
  float    acc_q;                    /**< this cycle's demodulated sums */
  float    acc_d;
  uint16_t cyc_count;                /**< periods into this cycle */
  uint8_t  inj_warm;                 /**< cycles seen since it started */
  float    demod_q;                  /**< last full-cycle demodulated q */
  float    demod_d;
  bool     inj_valid;                /**< two whole cycles have been seen */

  /* POLARITY */
  uint32_t pol_step;
  float    pol_pos;                  /**< peak |id| on the +pulse, A */
  float    pol_neg;

  uint32_t periods;                  /**< steps since init */
  drive_window_t win;
  drive_moments_t mom;

  /* Real-time junction observer, WEP envelope, and dynamic PWM */
  drive_thermal_params_t tp;
  drive_thermal_state_t  th;
} drive_t;

/** Defaults: placeholders the commissioning replaces, and said so. */
void drive_defaults(drive_params_t *p);

/** Default silicon/package Cauer parameters and WEP envelope bounds. */
void drive_thermal_defaults(drive_thermal_params_t *tp, float ts);

/** Initialize the junction thermal observer anchored to `t_pcb` (deg C). */
void drive_thermal_init(drive_t *d, float t_pcb);

/** Anchor the slowest Cauer node boundary to sampled PCB temperature `t_ntc` (deg C). */
void drive_set_pcb_temp(drive_t *d, float t_ntc);

/** Set the continuous War Emergency Power escalation parameter `gamma_wep` in [0, 1]. */
void drive_set_wep(drive_t *d, float gamma_wep);

/** Step the real-time Cauer thermal observer, inverse ceiling predictor I_max(Delta_t),
    and dynamic switching frequency f_sw. Returns I_max(Delta_t) in A. */
float drive_thermal_step(drive_t *d, const float *i_abc, float vdc, float omega_e);

/** Continuous box-constraint limit min(p.i_max, th.i_max_dyn) exposed to upper loops. */
float drive_current_limit(const drive_t *d);

void drive_init(drive_t *d, float ts);

/** Put both frames at `theta`: the polarity flip, or a known start. */
void drive_set_theta(drive_t *d, float theta);

/** The theta setpoint, rad: where HOLD and VOLT start, and in them the command frame moved by
    its change, the ramp's travel kept. */
void drive_set_theta_setpoint(drive_t *d, float theta);

/** The torque's current its link's volts leave as it turns, A, the field's at none:
    (w Lq i)^2 + (R i + w lambda)^2 inside (v_frac vdc / sqrt 3)^2. */
float drive_room(const drive_t *d);

/** Change mode. */
const char *drive_set_mode(drive_t *d, drive_mode_t mode, bool stage_enabled,
                           bool powered);

/** One PWM period. */
bool drive_step(drive_t *d, const drive_sample_t *in, bool stage_enabled,
                drive_out_t *out);

/** Copy the window out and start a new one. */
void drive_window_take(drive_t *d, drive_window_t *out);

/* ---- the model as the sample source ---------------------------------- */

void drive_model_defaults(drive_model_params_t *p);

/** The rotor at `p.theta0`, at rest, no current, the pipeline empty. */
void drive_model_init(drive_model_t *m);

/** The three phase currents and the link as the shunts would report them
    now, with the noise asked for. */
void drive_model_sample(drive_model_t *m, drive_sample_t *out);

/** One period at these duties. */
void drive_model_advance(drive_model_t *m, const float *duty, float ts);

/** One period with the bridge open: no current, the rotor on its drag and
    load. */
void drive_model_coast(drive_model_t *m, float ts);

/** One period with the model as the source: sample, step, advance with the
    step before's duties - the pipeline the stage has. */
bool drive_step_virtual(drive_t *d, drive_out_t *out);

/** Arm the raw-code moments for `periods`; zero forgets them. */
void drive_moments_arm(drive_t *d, uint32_t periods);

/** Feed one period's raw codes. Ignored while idle or done. */
void drive_moments_feed(drive_t *d, const int32_t *codes);

/* ---- the arithmetic, exposed for the harness ------------------------- */

void drive_clarke(const float *iabc, float *alpha, float *beta);
void drive_park(float alpha, float beta, float theta, float *d, float *q);
void drive_inv_park(float d, float q, float theta, float *alpha, float *beta);

/** The same with cos and sin already taken: one pair serves a whole step. */
void drive_park_cs(float alpha, float beta, float c, float s, float *d,
                   float *q);
void drive_inv_park_cs(float d, float q, float c, float s, float *alpha,
                       float *beta);

/** Min-max SVM: alpha/beta volts and the link to three duties, 0..1. */
float drive_svm(float valpha, float vbeta, float vdc, float *duty);

/** Branch-free geometric projection onto the Space Vector Hexagon boundary in alpha/beta,
    returning the scale factor in (0, 1] applied to (*valpha, *vbeta). */
float drive_hex_clamp(float *valpha, float *vbeta, float vdc, float v_frac);

/** Wrap to [0, 2 pi). */
float drive_wrap(float theta);

/** sin and cos together, a polynomial: 3e-6 worst, no library call. */
void drive_sincos(float theta, float *s, float *c);

/** atan2, a polynomial: 1.7e-6 worst, no library call. */
float drive_atan2(float y, float x);

/** tanh, a rational on the clamped argument: a float's few ulps, no branch nor library call. */
float drive_tanh(float x);

/** The dead-time table at `amps`, odd in the current. */
float drive_dt_volts(const drive_params_t *p, float amps);

#ifdef __cplusplus
}
#endif

#endif /* DRIVE_H */
