rogerisaksson/coaxial_63100/drive/src/drive_model.c

/** drive_model.c - PMSM + inverter model for the drive to run against. */
#include "drive.h"

#include <math.h>
#include <string.h>

/* The noise source: a linear congruential generator (Numerical Recipes'
   constants), seeded the same on every reset so a run repeats, its top 24
   bits taken as a fraction. */
#define MODEL_SEED   0x2545F491UL
#define LCG_A        1664525U
#define LCG_C        1013904223U
#define LCG_TOP_BITS 8
#define LCG_TOP_ONE  16777216.0f   /* 2^24: the top 24 bits as a fraction */

#define TWO_PI_F    6.2831853f
#define HALF_SQRT3  0.8660254f
#define INV_SQRT3   0.57735027f

void drive_model_defaults(drive_model_params_t *p)
{
  /* The order of magnitude of a small outrunner, the same set drive_defaults
     carries so a virtual run is consistent out of the box. */
  memset(p, 0, sizeof(*p));
  p->r = 0.05f;
  p->ld = 20e-6f;
  p->lq = 25e-6f;
  p->lambda = 0.005f;
  p->pole_pairs = 7.0f;
  p->sat = 0.0f;
  p->i_sat = 5.0f;
  p->j = 2e-5f;
  p->b = 1e-5f;
  p->load = 0.0f;
  p->v_dt = 0.0f;
  p->i_knee = 0.3f;
  p->vdc = 24.0f;
  p->noise = 0.0f;
  p->theta0 = 0.0f;
  p->sub = 4U;
}

void drive_model_init(drive_model_t *m)
{
  m->theta = drive_wrap(m->p.theta0);
  m->omega = 0.0f;
  m->omega_lo = 0.0f;
  m->id = 0.0f;
  m->iq = 0.0f;
  m->id_prev = 0.0f;
  m->iq_prev = 0.0f;
  m->rng = MODEL_SEED;
  memset(m->duty_prev, 0, sizeof(m->duty_prev));
  m->driven_prev = false;
  m->c = 1.0f;
  m->s = 0.0f;
  memset(m->i_abc, 0, sizeof(m->i_abc));
}

/** Roughly Gaussian, cheap: three uniforms from an LCG, centred. */
static float model_noise(drive_model_t *m, float sd)
{
  if (sd <= 0.0f)
  {
    return 0.0f;
  }
  float sum = 0.0f;

  for (uint8_t k = 0U; k < 3U; k++)
  {
    m->rng = m->rng * LCG_A + LCG_C;   /* U: the LCG wraps in uint32_t on every target; UL made an LP64 host
       widen the product to 64 bits before the same wrap */
    sum += (float)(m->rng >> LCG_TOP_BITS) / LCG_TOP_ONE - 0.5f;
  }
  return sum * 2.0f * sd;                 /* three uniforms: sd is 0.5 */
}

/* omega plus `d`, the low bits a float sum drops carried to the next: a
   sub-step at the flywheel's drag changes it by 2.6 of its ulp, and a plain
   sum took 4.2 % more off a coast than J dw/dt = -b w. */
static void omega_add(drive_model_t *m, float d)
{
  const float y = d - m->omega_lo;
  const float t = m->omega + y;

  m->omega_lo = (t - m->omega) - y;
  m->omega = t;
}

static float model_ld(const drive_model_t *m)
{
  return (m->p.sat == 0.0f) ? m->p.ld
         : (m->p.ld * (1.0f - m->p.sat * drive_tanh(m->id / m->p.i_sat)));
}

void drive_model_sample(drive_model_t *m, drive_sample_t *out)
{
  /* The three phase currents as the shunts would report them, at the top of
     the period - amplitude-invariant, with the noise the caller asked for on
     each. */
  drive_sincos(m->theta, &m->s, &m->c);
  const float ia = m->id * m->c - m->iq * m->s;
  const float ib = m->id * m->s + m->iq * m->c;

  m->i_abc[0] = ia;
  m->i_abc[1] = -0.5f * ia + HALF_SQRT3 * ib;
  m->i_abc[2] = -0.5f * ia - HALF_SQRT3 * ib;
  if (m->p.noise > 0.0f)
  {
    for (uint8_t k = 0U; k < DRIVE_PHASES; k++)
    {
      out->i[k] = m->i_abc[k] + model_noise(m, m->p.noise);
    }
  }
  else
  {
    out->i[0] = m->i_abc[0];
    out->i[1] = m->i_abc[1];
    out->i[2] = m->i_abc[2];
  }
  out->vdc = m->p.vdc;
}

void drive_model_advance(drive_model_t *m, const float *duty, float ts)
{
  /* One period at these duties: the average-voltage inverter with its
     neutral floating, the dead-time error taken off each phase by the sign
     of its current, then the motor in its own frame. */
  const float mean = (duty[0] + duty[1] + duty[2]) / 3.0f;
  float v[DRIVE_PHASES];

  for (uint8_t k = 0U; k < DRIVE_PHASES; k++)
  {
    v[k] = m->p.vdc * (duty[k] - mean);
  }
  const float c = m->c;
  const float s = m->s;
  const float id_f = 0.5f * (m->id + m->id_prev);
  const float iq_f = 0.5f * (m->iq + m->iq_prev);

  m->id_prev = m->id;
  m->iq_prev = m->iq;
  if (m->p.v_dt > 0.0f)
  {
    /* The fundamental over two periods: at a DC hold it is the sample's, and
       an fs/2 ripple sits at opposite peaks at the two tops and cancels. */
    const float ia_f = id_f * c - iq_f * s;
    const float ib_f = id_f * s + iq_f * c;
    const float i_f[DRIVE_PHASES] = {
      ia_f,
      -0.5f * ia_f + HALF_SQRT3 * ib_f,
      -0.5f * ia_f - HALF_SQRT3 * ib_f,
    };

    for (uint8_t k = 0U; k < DRIVE_PHASES; k++)
    {
      v[k] -= m->p.v_dt * drive_tanh(i_f[k] / m->p.i_knee);
    }
  }

  const float va = (2.0f * v[0] - v[1] - v[2]) / 3.0f;
  const float vb = (v[1] - v[2]) * INV_SQRT3;
  const float vd = va * c + vb * s;
  const float vq = vb * c - va * s;
  const uint8_t sub = (m->p.sub == 0U) ? 1U : m->p.sub;
  const float dt = ts / (float)sub;
  const float ld = model_ld(m);          /* once: it bends with the period's current */

  for (uint8_t k = 0U; k < sub; k++)
  {
    const float did = (vd - m->p.r * m->id + m->omega * m->p.lq * m->iq) / ld;
    const float diq = (vq - m->p.r * m->iq - m->omega * ld * m->id
                       - m->omega * m->p.lambda) / m->p.lq;

    m->id += did * dt;
    m->iq += diq * dt;

    const float torque = 1.5f * m->p.pole_pairs
                         * (m->p.lambda * m->iq + (ld - m->p.lq) * m->id * m->iq);
    const float wm = m->omega / m->p.pole_pairs;

    omega_add(m, (torque - m->p.b * wm - m->p.load) / m->p.j * dt * m->p.pole_pairs);
    m->theta += m->omega * dt;
  }
  m->theta = drive_wrap(m->theta);
}

void drive_model_coast(drive_model_t *m, float ts)
{
  /* The diodes conduct only past the link's volts, beyond the no-load
     speed: not modelled. */
  const uint8_t sub = (m->p.sub == 0U) ? 1U : m->p.sub;
  const float dt = ts / (float)sub;

  m->id = m->iq = m->id_prev = m->iq_prev = 0.0f;
  for (uint8_t k = 0U; k < sub; k++)
  {
    const float wm = m->omega / m->p.pole_pairs;

    omega_add(m, (-m->p.b * wm - m->p.load) / m->p.j * dt * m->p.pole_pairs);
    m->theta += m->omega * dt;
  }
  m->theta = drive_wrap(m->theta);
}

bool drive_step_virtual(drive_t *d, drive_out_t *out)
{
  /* Sample, step, advance with the duty from the step BEFORE - the
     firmware's pipeline: what this step asks for shapes the period after the
     next one, so the model sees it a period late, like the stage. */
  drive_sample_t in;
  const uint32_t t0 = d->cycles ? d->cycles() : 0U;

  drive_model_sample(&d->model, &in);

  const uint32_t t1 = d->cycles ? d->cycles() : 0U;
  const bool trip = drive_step(d, &in, true, out);
  const uint32_t t2 = d->cycles ? d->cycles() : 0U;

  if (d->model.driven_prev)
  {
    drive_model_advance(&d->model, d->model.duty_prev, d->ts);
  }
  else
  {
    drive_model_coast(&d->model, d->ts);
  }
  memcpy(d->model.duty_prev, out->duty, sizeof(d->model.duty_prev));
  d->model.driven_prev = out->driven;
  if (d->cycles)
  {
    /* Where the period goes, so an interrupt that outgrew it can be read
       block by block rather than guessed at. */
    d->cyc_sample = t1 - t0;
    d->cyc_step = t2 - t1;
    d->cyc_advance = d->cycles() - t2;
  }
  return trip;
}
