rogerisaksson/coaxial_63100/drive/src/drive_math.c

/** drive_math.c - Frame transforms, modulator, dead-time table. */
#include "drive.h"

#include <math.h>

#define TWO_PI      6.2831853f
#define INV_TWO_PI  0.15915494f
#define PI          3.1415927f
#define HALF_PI     1.5707963f
#define ONE_THIRD   0.33333334f
#define INV_SQRT3   0.57735027f
#define HALF_SQRT3  0.8660254f

void drive_clarke(const float *iabc, float *alpha, float *beta)
{
  *alpha = (2.0f * iabc[0] - iabc[1] - iabc[2]) * ONE_THIRD;
  *beta  = (iabc[1] - iabc[2]) * INV_SQRT3;
}

void drive_park_cs(float alpha, float beta, float c, float s, float *d,
                   float *q)
{
  *d = alpha * c + beta * s;
  *q = beta * c - alpha * s;
}

void drive_inv_park_cs(float d, float q, float c, float s, float *alpha,
                       float *beta)
{
  *alpha = d * c - q * s;
  *beta  = d * s + q * c;
}

void drive_sincos(float theta, float *s, float *c)
{
  /* A ninth-order odd polynomial on [-pi/2, pi/2] after folding with
     vrintm/vminnm/vmaxnm/vabs (no branches, no divide), 3e-6 at the worst
     point - a control law needs milliradians. */
  const float x = theta - TWO_PI * floorf((theta + PI) * INV_TWO_PI);
  const float xs = fminf(fmaxf(x, -HALF_PI), HALF_PI) * 2.0f - x;
  const float xc = HALF_PI - fabsf(x);
  const float s2 = xs * xs;
  const float c2 = xc * xc;

  *s = xs * (1.0f + s2 * (-1.6666667e-1f + s2 * (8.3333333e-3f
             + s2 * (-1.9841270e-4f + s2 * 2.7557319e-6f))));
  *c = xc * (1.0f + c2 * (-1.6666667e-1f + c2 * (8.3333333e-3f
             + c2 * (-1.9841270e-4f + c2 * 2.7557319e-6f))));
}

float drive_tanh(float x)
{
  /* 13/6 odd over even past the clamp where a float's tanh is 1: libm's tanhf took expm1f
     and its errno path from the plant twice a step. */
  const float c = fminf(fmaxf(x, -7.90531110763549805f), 7.90531110763549805f);
  const float c2 = c * c;
  const float p = c * (4.89352455891786e-03f + c2 * (6.37261928875436e-04f
                  + c2 * (1.48572235717979e-05f + c2 * (5.12229709037114e-08f
                  + c2 * (-8.60467152213735e-11f + c2 * (2.00018790482477e-13f
                  + c2 * -2.76076847742355e-16f))))));
  const float q = 4.89352518554385e-03f + c2 * (2.26843463243900e-03f
                  + c2 * (1.18534705686654e-04f + c2 * 1.19825839466702e-06f));

  return p / q;
}

float drive_atan2(float y, float x)
{
  /* An eleventh-order odd polynomial on [0, 1] after folding into the octant,
     1.7e-6 at the worst point: the library's was called four times a period.
     */
  const float ay = fabsf(y);
  const float ax = fabsf(x);

  if ((ax == 0.0f) && (ay == 0.0f))
  {
    return 0.0f;
  }

  const float t = (ay > ax) ? (ax / ay) : (ay / ax);
  const float t2 = t * t;
  float r = t * (9.9997726e-1f + t2 * (-3.3262347e-1f + t2 * (1.9354346e-1f
            + t2 * (-1.1643287e-1f + t2 * (5.265332e-2f + t2 * -1.172120e-2f)))));

  if (ay > ax)
  {
    r = HALF_PI - r;
  }
  if (x < 0.0f)
  {
    r = PI - r;
  }
  return (y < 0.0f) ? -r : r;
}

void drive_park(float alpha, float beta, float theta, float *d, float *q)
{
  float s, c;

  drive_sincos(theta, &s, &c);
  drive_park_cs(alpha, beta, c, s, d, q);
}

void drive_inv_park(float d, float q, float theta, float *alpha, float *beta)
{
  float s, c;

  drive_sincos(theta, &s, &c);
  drive_inv_park_cs(d, q, c, s, alpha, beta);
}

float drive_hex_clamp(float *valpha, float *vbeta, float vdc, float v_frac)
{
  /* Exact geometric projection onto the Space Vector Hexagon in abc span:
     line-to-line span hi - lo <= v_frac * vdc, completely branch-free via
     fminf/fmaxf saturation arithmetic. */
  const float va = *valpha;
  const float vb = *vbeta;
  const float v0 = va;
  const float v1 = -0.5f * va + HALF_SQRT3 * vb;
  const float v2 = -0.5f * va - HALF_SQRT3 * vb;
  const float lo = fminf(fminf(v0, v1), v2);
  const float hi = fmaxf(fmaxf(v0, v1), v2);
  const float span = fmaxf(hi - lo, 1e-9f);
  const float v_lim = fmaxf(v_frac * vdc, 0.0f);
  const float scale = fminf(1.0f, v_lim / span);

  *valpha = va * scale;
  *vbeta  = vb * scale;
  return scale;
}

float drive_svm(float valpha, float vbeta, float vdc, float *duty)
{
  /* Min-max: the zero sequence that centres the three phase voltages in the
     link, which puts the vector's linear range at Vdc/sqrt3 instead of
     Vdc/2. */
  float v[DRIVE_PHASES];
  float scale = 1.0f;

  if (vdc <= 0.0f)
  {
    duty[0] = 0.0f;
    duty[1] = 0.0f;
    duty[2] = 0.0f;
    return 0.0f;
  }

  v[0] = valpha;
  v[1] = -0.5f * valpha + HALF_SQRT3 * vbeta;
  v[2] = -0.5f * valpha - HALF_SQRT3 * vbeta;

  float lo = fminf(fminf(v[0], v[1]), v[2]);
  float hi = fmaxf(fmaxf(v[0], v[1]), v[2]);

  if ((hi - lo) > vdc)
  {
    scale = vdc / (hi - lo);
    v[0] *= scale;
    v[1] *= scale;
    v[2] *= scale;
    lo *= scale;
    hi *= scale;
  }

  const float zero = -0.5f * (hi + lo);
  const float inv_vdc = 1.0f / vdc;

  for (uint8_t k = 0U; k < DRIVE_PHASES; k++)
  {
    const float d = 0.5f + (v[k] + zero) * inv_vdc;

    duty[k] = fminf(fmaxf(d, 0.0f), 1.0f);
  }
  return scale;
}

float drive_wrap(float theta)
{
  /* vrintm.f32 on Cortex-M7: no branches for the fold. */
  const float k1 = floorf(theta * INV_TWO_PI);

  theta = (theta - k1 * 6.2831850f) - k1 * 4.7683716e-7f;
  const float k2 = floorf(theta * 0.15915495f);

  return fmaxf((theta - k2 * 6.2831850f) - k2 * 4.7683716e-7f, 0.0f);
}

float drive_dt_volts(const drive_params_t *p, float amps)
{
  /* Odd in the current, linear between the points, held past the last: what
     the inverter loses to dead time saturates once the current is large
     against the ripple, and the table is measured out to where it does. */
  if (p->dt_step <= 0.0f)
  {
    return 0.0f;
  }

  const float mag = (amps < 0.0f) ? -amps : amps;
  const float pos = mag / p->dt_step;
  const float last = (float)(DRIVE_DT_POINTS - 1U);
  float v;

  if (pos >= last)
  {
    v = p->dt_volts[DRIVE_DT_POINTS - 1U];
  }
  else
  {
    const uint32_t k = (uint32_t)pos;
    const float frac = pos - (float)k;

    v = p->dt_volts[k] + frac * (p->dt_volts[k + 1U] - p->dt_volts[k]);
  }
  return (amps < 0.0f) ? -v : v;
}
