rogerisaksson/coaxial_63100/(commit log)

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2026-08-22 Stop tracking the bench captures
    host/data/*.csv were five captures from one board on one bench on one
    day. Nothing in the tree reads them by a fixed path -
    host/tools/analyze_phase_log.py takes its file as an argument - and a
    reader of the repo has no way to tell what conditions they were taken
    under. Untracked, ignored, and left on disk.
    [allchan_475.csv, allchan_475_fixed.csv, phase_log.csv, phase_log_475.csv, se_scan_475.csv]
2026-08-22 Keep the model on this machine, and give it one window to run in
    Ollama will proxy a `:cloud` tag to somebody else's GPU without saying
    so, and on this bench a prompt carries register dumps, pin names and
    whatever a plan says about unreleased hardware. That is the whole reason
    the runner is local in the first place, so it is now enforced rather than
    assumed: a non-loopback host or a cloud tag raises from Ollama.__init__,
    and require_model drops cloud tags from the candidate list so a bare stem
    cannot resolve onto one. `--allow-remote` is how you mean it on purpose.
    dbg.py catches the refusal before opening a prompt loop against a model
    it will not use.
    bench.ps1 is the preflight in front of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
2026-08-22 Install the editor side too, and stop sending anyone to st.com
    The rule everywhere else in setup.ps1 is check, then install. The VS Code
    extensions were the last place it was only checking - and an editor with
    none of them is an editor where nothing in Core/ resolves and the .ioc
    does not open.
    Three are listed, and only three. The STM32 entry is a pack: installing
    it installs fifteen, including cmake-tools, clangd, the serial monitor,
    the memory inspector and every debug adapter, so listing those again here
    would only be a second list to keep in step with ST. What the pack does
    not bring is cpptools, which .vscode/c_cpp_properties.json is written
    for, and the Python extension, which is the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
2026-08-22 Make the tools hard to call wrongly, after a model answered from memory
    llama3.1:8b was tried against gemma4:12b on this bench, and it is
    genuinely faster: three questions in 24.0 s against 31.3, two model calls
    per question against three, 1.2k prompt tokens against 2.9k. Then it was
    asked for the board temperature and said "25.00 C", three runs running,
    for a board that `board temp` had at 36.3.
    It had called analog_read with ch="ntc" - a bare string where the schema
    says array. `for item in "ntc"` iterates characters, so the tool answered
    `unknown channel 'n'`, and the model, with nothing it could act on,
    filled the gap from memory. 25.00 C is not a random wrong number: it is
    what this bo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
2026-08-22 A download page for CubeMX, and json mode where it belongs
    Two unrelated things, both about not forcing a route on anyone.
    CubeMX had exactly one way in: the 308 MB bundle. Now the machine is
    looked at first - Find-CubeMX checks the bundle and the three places
    st.com's installer puts STM32CubeMX.exe - and if it is absent the
    download page is opened on request, the run carries on, and
    -CubeMXInstaller runs the downloaded installer on the next pass. Missing
    CubeMX stops nothing: it is not needed to build, flash, measure or drive
    the model, only to regenerate Core/ from the .ioc.
    That check earned itself immediately on this machine. CubeMX has been
    installed under Program Files all along, and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
2026-08-22 Send the board questions to the model standing next to the board
    Two things, and the first is the point of the second.
    A question about what this board reads right now does not need an
    expensive model reasoning from memory - there is a local one on the
    machine with the board's eleven tools wired to it, free per token, one
    serial cable away from the answer. CLAUDE.md now says so, with a table:
    live board state goes to `board-prompt -Ask`, code and protocol and
    design stay here. Relay what it measured, do not re-derive it, and do
    not decorate it with a verdict - invariant 10 binds the model exactly as
    it binds the firmware.
    "The model is not installed" is no longer a reason to answer from me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
2026-08-22 Count the desktop's VRAM, and get out of its way
    The reserve was a flat quarter of the card, which quietly assumed that
    quarter was empty. It is not. Measured here with nothing of ours
    running: a two-screen Windows desktop was holding 2.6 GB of a 16 GB card
    at 0 % utilisation. So the 4.0 GB reserve left the desktop 1.4 GB to
    grow into - a second 4K surface, a video starting, a canvas tab - and
    when that is not enough the driver evicts to satisfy the allocation.
    What the user sees is not an error, it is a momentary hang, which is
    worse because nobody can read it.
    nvidia-smi already knew. The probe now reads memory.used alongside
    memory.total, and the reserve is the largest of three numbers: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
2026-08-22 Measure what is left of the machine, not what it shipped with
    Yesterday's reserve counted the wrong thing, and the way it was wrong
    was a ratchet. The probe reads what the card is holding, but it usually
    runs while the last question's model is still resident - so our own
    7.8 GB was counted as somebody else's desktop, the reserve came out at
    12.8 GB of a 16 GB card, and the next choice was a smaller model, which
    then became the baseline for the run after that. Measured exactly that
    way before it was fixed: "16 GB card with 10.8 GB already on it".
    probe() now asks the daemon what it is holding and subtracts it, and
    says so in the notes ("nvidia-smi minus ollama"). The desktop on this
    machine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
2026-08-22 Put a stop in front of the board, not just a preference
    CLAUDE.md already said that questions about what the board reads right
    now go to the local model. It was walked straight past: "I want to fetch
    measurement data from the board" turned into the expensive model driving
    the serial port through a full snapshot, a rate sweep and a CSV,
    producing numbers the free model standing next to the board would have
    produced for nothing.
    The rule was not wrong, it was unenforceable - a table of who-answers-
    what with no moment where anything has to happen. So the moment is
    explicit now: before touching the board to answer a question, ask the
    user whether it is worth tokens, and on "the local model" pr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
2026-08-22 A separator in a channel name is not information
    Reported from a live prompt: gemma4:12b asked for `dc_bus` and got back
    `unknown channel 'dc_bus'; names are ch3,ch6,dcbus,ntc,phaseu,...` - a
    refusal listing a name one underscore away from the one it used. The
    model was not wrong about the board. board_info prints the signal as
    "DC bus", render.short makes that "DCbus", and which of dc_bus, dc-bus,
    DC bus and dcbus this tool wanted was never stated anywhere.
    _key strips everything that is not a letter or a digit and lowercases
    the rest, on both sides of the comparison, so all four collapse to the
    same channel. Same for phase_u, Phase U and PHASEU. An index is left
    alone, and a name that is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
2026-08-22 Answer in the language the question was asked in
    The bench prompt is English and so was every answer, including the ones
    to questions asked in Swedish. One line in the dbg system prompt fixes
    that, with the part that must not follow the question: units and channel
    names stay as the board prints them - NTC, DCbus, V, C - because those
    are what board_info, the CSVs and these documents use, and a translated
    channel name is one nobody can grep for.
    Verified live in three languages against docs the model had to read
    first. Which is how the second half surfaced: standard output on this
    console encodes with the locale codepage, cp1252. Swedish and German are
    inside it and render correctly. A Polis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
2026-08-22 Decide the language here, and tell the model which one
    "Answer in the language the question was asked in" asks the model to do
    two things: work out what language that was, and then answer. The first
    is where it drifts. Reported from the bench: qwen2.5:14b - a model whose
    training leans heavily Chinese - answering European questions in
    Chinese, Japanese and Thai.
    So the host decides. language.py names it and the turn's system message
    says it plainly: "The question is in Swedish. Answer in Swedish and in
    no other language." An introspection becomes an instruction, which is
    the same division of labour as everywhere else here - the program does
    the part a program is reliable at.
    Two stages, bo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
2026-08-22 Clear the card on the way in as well as on the way out
    Leaving the prompt hands the weights back, but not every exit is a
    leaving: a killed window, a -Hold from last time, somebody's own
    `ollama run` in another terminal. Each leaves a model resident until its
    keep_alive expires, and the next load then asks a card that is already
    full - which on this bench is a 500 from the daemon reading
    `cudaMalloc failed`, with nothing obviously wrong at either end.
    So board_prompt.ps1 sweeps before it loads, and says what it freed
    rather than doing it quietly:
    ok unloaded llama3.1:8b was still resident, 4.9 GB freed
    ok model gemma4:12b loaded in 7.0 s, held 30m
    The model this run is about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
2026-08-22 Reach the board from the docked terminal, not a new window
    Two things, one of them mine.
    -NewWindow was broken for any argument with a space in it.
    Start-Process -ArgumentList joins an array and quotes nothing, so
    `-Ask "read the NTC"` arrived in the new window as three arguments; NTC
    then bound to -Prefer, which rejected it against its ValidateSet. The
    error named a parameter nobody had typed, which is the worst kind. Each
    argument is quoted now, and the relaunch was verified by clearing the
    card and watching a model load - evidence without reading the window.
    The window itself is the wrong answer anyway. Asked to start the local
    model, the useful place is the terminal already docked in t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
2026-08-22 One click to the prompt, in the panel already open
    Asked to start the local model, printing a command to retype is not
    starting it, and opening a window is starting it in the wrong place. A
    terminal profile is the third option and the right one: Terminal panel,
    the dropdown beside +, "Board prompt". It opens in the docked panel
    beside the build output, it is a prompt you can type into, and closing
    it hands the graphics memory back.
    A profile rather than another task because a task terminal belongs to
    the task - read-only once the command exits. The task stays for the
    one-question case, where there is nothing to type into afterwards:
    Ctrl+Shift+B.
    So the answer to "local model" is now a cli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
2026-08-22 Phase A is Phase U, and the tool should know that
    Reported from the prompt: the model asked for
    ch=['ntc', 'dc_bus', 'phase_a', 'phase_b', 'phase_c']
    and lost all five readings to the two names it spelled the other way.
    A/B/C and U/V/W are not a right and a wrong way to label a three-phase
    drive, they are two conventions that appear in the same datasheets, and
    a tool that knows only one of them is being fussy about vocabulary while
    holding the measurement hostage.
    So the phase conventions alias each other, bare letters included -
    tools/analyze_phase_log.py already names its CSV columns U, V and W, and
    no channel on this board is one letter, so there is nothing to collide
    with. The ali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
2026-08-22 Say when an answer was cut off, and make the prompt look alive
    Three things from one transcript.
    The seven-channel table stopped mid-row, at "| NTC | SE | 39498.2 |
    +1.9889V | 36". Not a formatting fault: the meter says 180 out, which is
    exactly --words. A table that ends in the middle of a row reads as
    complete to everyone except a reader counting rows, so the reply's
    done_reason is checked now and a truncated answer is marked as one.
    ch=['all'] was refused as an unknown channel. The schema says "omit for
    all", so a model that wants everything writes the word the schema used.
    It means every channel and now resolves to every channel - fifth in the
    family after the list shape, the argument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
2026-08-22 Keep spinning while the question is being typed
    Two corrections, both right.
    The spinner stopped at the first keypress. That was a workaround, not a
    design: a spinner redrawing its whole line repaints under the characters
    being typed, which is how a prompt eats an argument - so it stopped
    exactly when someone was looking at it. It now repaints only its own
    cell and puts the cursor back where the typing is: ESC 7, column, glyph,
    ESC 8. The typed text is never written over because it is never written
    to. Moved to its own module, since it is now a thread with a lifetime
    rather than a loop.
    And the bar is an en dash. At the size a terminal draws them a hyphen is
    a third the width of the pipe a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
2026-08-22 A refusal did not prevent an invented reading, it caused one
    Asked for the raw codes with the AFE deliberately off - "trots att det är
    meningslöst" - analog_read raised, and the model, having no numbers to
    report, wrote them out of the warning text instead:
    - **PhaseU**: Mid-scale
    - **NTC**: 25.00°C
    That is the exact failure the gate exists to prevent, produced by the
    gate. It is also the wrong shape for this repository: the board is a
    dumb slave that reports codes and judges nothing, and deciding a
    measurement is not worth taking is a judgement.
    So analog_read reads either way and says which state it was in, on a
    line that cannot be mistaken for one of the readings: the refere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
2026-08-23 Install Python from python.org, and offer STM32CubeIDE on the side
    python.org replaces the winget package as the source for Python: a
    per-user installer, version resolved from the ftp index unless pinned
    with -PythonVersion, and its install directory spliced into PATH so
    the rest of the same run can use it without a new shell.
    STM32CubeIDE is not part of this project's own workflow - that stays
    VS Code plus cube-cmake - but it was asked for as an optional extra,
    so it gets the same treatment as CubeMX: a login-gated download page,
    and -CubeIDEInstaller to run one already on disk. -SkipCubeIDE turns
    it off outright.
2026-08-23 Check the serial link before asking, and show it on the spinner
    Session.board is lazily opened on the first tool call, which meant a
    dead COM port surfaced as a tool error the model read like any other -
    with nothing telling it to stop, it could carry on and answer past a
    board that was never reachable. Both entry points now open the link
    eagerly, before a single token is spent: --plan and --ask fail fast
    with a clear board error, and dbg.py's REPL warns but keeps the slash
    commands, the same shape already used for an unreachable ollama host.
    The prompt's spinner carries the same bit: green and turning forward
    while the link is up, red and backward while it is not, with the two
    padding spac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
2026-08-23 Tell the local model this is a terminal, not a markdown renderer
    The model's answers land in a plain console with no pipe-table support
    and a hard cap around 180 tokens, so a markdown table it reaches for
    on its own either misaligns on a narrow terminal or gets cut off mid
    row - either way it reads as garbage rather than data. Both system
    prompts now say so plainly: one value per short line, the same shape
    the tool output already uses, never a markdown table or heading.
    The debug prompt's token budget test needed the same fix applied to
    its own arithmetic: the +40 slack was tuned against the old, shorter
    SYSTEM string, so it now accounts for SYSTEM's actual size instead of
    a constant that q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
    [runner.py]
2026-08-23 Show the whole table, and track the link on every call
    The trace line for a tool result joined every row with ' | ' and cut
    the lot at 96 characters, which is what actually turned a channel
    table into a ragged, unreadable mess - not the model's own wording.
    It now prints one row per line, each clipped on its own, capped at
    TRACE_ROWS with a count for whatever does not fit rather than a table
    that quietly stops.
    The spinner's colour used to change only at startup or on /reconnect,
    so a cable pulled mid-session left it green until asked. Every call
    that actually reaches the board now updates it directly: a comms
    failure (ConnectError, NoReplyError, a bad CRC or frame) turns it red
    on the next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
2026-08-23 Tell the model a failed call is not a stale reading in disguise
    A tool error on the link is a measurement that did not happen, but
    nothing said so plainly: the model had the full conversation to lean
    on, and an earlier turn's real reading was sitting right there to be
    reused for a channel the current call could not reach at all. Both
    system prompts now say a failed call gets reported as failed, not
    answered from an older value or a guess.
    debug.py's prompt also stops the model restating a tool result that
    is already sitting in the trace above it as a second list of its own
    - one line is enough once the table has already been shown once.
    [runner.py]
2026-08-23 host: refuse a fabricated reading or an unmeasured report
    Chat.ask (dbg.py) could answer a fresh-looking channel table with zero
    board calls this turn, since the existing "link is down" and "table
    above, not restated" backstops only look at calls made that turn.
    self.last_channels now survives across turns so a turn with no
    analog_read call at all can still be checked against it; the reworded
    SYSTEM prompt drops the leftover "debug"/"test board" framing.
    runner.py's report tool had the same gap at higher stakes: a model
    could call report(value=...) as its very first tool call and have it
    accepted as a signed pass/fail verdict. It's now refused (nudged, then
    unfinished) unless a real board t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
    [runner.py]
2026-08-23 dbg.py: quieter output, and stop refusing to tabulate
    Two pieces of screen noise cut from the interactive prompt: the
    per-turn token meter ("[N in / N out]") is still tracked for /cost and
    --budget but no longer printed after every turn, and the "table above,
    not restated." backstop line now replaces a retyped table with
    silence instead of a caption confirming it isn't being retyped - the
    real table is already the trace directly above it.
    Also: SYSTEM's "never a markdown table" was being read by the model as
    "never produce a table at all", so asking for one got a refusal
    ("I can't make a table, but I can list the values") instead of a call
    to analog_read - even though its own plain-text gri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
2026-08-23 dbg.py: a stale "link is down" gets rechecked, not repeated
    Asked again after a failed call, the model would answer from memory of
    the earlier failure with no new tool call at all - an honest answer,
    not a fabrication, but stale: the link could have come back since.
    SYSTEM's "not an old reading" was silent on an old verdict.
    A zero-call answer while link_ok is already False now triggers one
    cheap check in code (`link`, which needs no AFE and no sample) before
    the answer is accepted. Back up: the result goes into history and the
    loop continues, giving the model a real chance to answer with fresh
    data in the same turn. Still down: a freshly-confirmed message is
    returned directly rather than w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
2026-08-23 dbg.py: a blank answer with no call also gets a real check
    The previous fix only rechecked the link when link_ok was already
    False - which meant the very first question asked right after the
    programmer was disconnected slipped through with neither a tool call
    nor an error: link_ok was still True from before, so nothing had
    flagged it yet, and the model's own blank content printed as silence.
    The same check now also fires whenever the answer is empty, regardless
    of link_ok's prior state - a zero-call, empty-content turn is never a
    fact worth trusting either way. Verified with two new tests: the link
    actually down (a fresh "link is down" message, not silence) and the
    link actually fine (the m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
2026-08-23 CLAUDE.md: ask continue-or-commit after a change lands
    This session ran a long series of small fix-test-commit cycles, and
    each commit was triggered by the user explicitly asking for it. Making
    that a documented question rather than something to guess at: ask,
    two options, same minimal shape as the board-prompt question already
    in this file.
2026-08-23 dbg.py: "no reading taken" checks the link instead of guessing
    The third backstop - a turn that skips analog_read but retypes the
    last reading anyway - had no way to tell "board fine, model just did
    not bother" from "board actually unreachable", so it always printed
    the same generic "ask again" line. On a bench where the board really
    was disconnected, that line was itself the complaint: the honest
    answer was to check the cable and the power, not to ask again.
    Factored the link probe (already used for a stale-refusal and a blank
    answer) into _probe_link(), and this backstop now calls it too: still
    reachable gets the original "no reading taken this turn - ask again.",
    actually unreachable get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
2026-08-24 review: silent runner retry, docs off by default, and a structural pass
    Four things asked for, plus what a full review of the project turned up.
    Retry a crashed model runner, silently (client.py). Measured repeatedly on
    this bench: llama-server dies with std::bad_alloc while saving its prompt
    cache and ollama answers 500 "model runner has unexpectedly stopped". The
    daemon respawns it on the next request, so recovery was always "ask again" -
    until now the operator's job, retyping a question already answered
    everywhere except in the reply. Two retries with a backoff; a request ollama
    *refused* is never retried, and a machine truly out of memory still fails in
    seconds rather than looping.
    The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
    [runner.py]
2026-08-24 ollama: find the real OOM, tune the daemon for it, and size docs by reader
    The local model kept dying mid-session with OOM and reloading 8 GB. The
    obvious cause was the prompt getting too long. It was not, and that hypothesis
    survived long enough to nearly justify the wrong fix.
    Measured, reproduced three times, from the daemon's own verbose log:
    slot get_availabl: - checking sim = 0.255 (323/1265)
    srv prompt_save: - saving prompt with length 1446, state size = 342.623 MiB
    libc++abi: terminating due to uncaught exception of type std::bad_alloc
    llama-server terminated exit.code=0xc0000409
    The prompt was 1446 tokens of an 8192 window. Two allocators inside
    llama-server,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
    [runner.py]
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2026-08-24 session: no cable is a different board, not a failing suite
    open_session(port, baud, unit, simulated=None) in coaxial_mcp/session.py
    probes with find_board.probe - the same Modbus round trip a tool call
    makes - and hands back SimulatedSession when nothing answers. Returns
    (session, real), and every caller prints which it got: dbg.py in the
    prompt tag, the MCP server on stderr, the suites in a header line.
    Prompt says what it is talking to: Coaxial 63100(COM4, 115200) green,
    (Simulated) yellow, (no board) for --no-board. Written after tail, and
    _paint() rewrites only the prefix, so the repaint does not eat it; no VT
    means the word without the colour.
    test_mcp failed one check against the st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
    [simulated.py]
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2026-08-24 channels: the board reports its own map, analog and digital, with directions
    New command 0x6D, protocol 1.2 -> 1.3 (a MINOR: an old host never calls it).
    Three kinds, kept apart on purpose:
    0 analog seven channels, all inputs, with pin/adc/unit
    1 digital IO PB2 out, PE15 in - what a fixture may read or set
    2 reserved USART3 and the debug port: not channels, never driven,
    reported only so "why was PB10 refused" has an answer
    A flag on one combined list would have put the bus one misread away from a
    pin write that severs the link the command arrived on.
    Sections rather than one reply because one does not fit: measured, all of
    it together came to 273 bytes agai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
    [board.h, board_io.c, cmd_board.c, simulated.py]
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2026-08-24 one list, named channels, and a busy port that says so
    Three things, all from one transcript.
    The retyped map. "ge mig en lista pa alla analoga kanaler" traced the map
    and the model typed the same seven names out underneath it. is_retype
    already replaces a retyped reading with silence because the trace put it
    on screen; a map row simply does not look like a reading row, so the
    backstop never saw it. replies.MAP_ROW, and with --quiet the board's own
    rows go out instead of the model's copy.
    PB1 is Clevel and PC1 is Cinj, named by the board owner, set in
    Board/Src/board_adc.c. That is what the dynamic map is for: the firmware
    table and the stand-in were the only edits, and the names appear in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
    [board_adc.c, simulated.py]
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2026-08-25 bus: a device says what it is, and there can be more than one
    Three things asked for; the first needs a correction. There is no
    `link_description` anywhere in this repo - the nearest thing is
    Origin.label, the "JTAG and COM4" in the prompt tag - so this implements
    the intent rather than pretending it was a rename.
    0x41 gains `str description`, appended, which is the one thing the frozen
    record allows: an old host stops after command_count and never knows it is
    there. Protocol 1.3 -> 1.4, a MINOR. A name picks a codec and says nothing
    about what is on the other end of the bus, which with several units
    answering is the difference between a list of numbers and a list of
    devices.
    origin.interf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
    [cmd_board.c, simulated.py]
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2026-08-25 buses: five segments, and the model's life belongs to the test runner
    A bus is a serial segment - one limb, or the axis - which is how a machine
    like this is wired: shorter runs, one limb's fault confined to one limb,
    four segments carrying traffic at once instead of twenty nodes taking
    turns. SIMULATED_BUSES is AX, LL, RL, LA, RA.
    Segments make an odd/even side rule redundant, so the unit id is the
    position down the limb: node 2 is the knee on both legs, node 1 the
    shoulder on both arms. A number worth more to a controller than a unique
    one, and the tests check it as a property rather than as a list.
    Two-letter labels, not the emoji offered: spinner.py records the
    advance-width problem wi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
    [simulated.py]
2026-08-25 run_tests.ps1 as the test interface, coverage tiers, docs off one bench
    -All | -AutomaticHigh | -AutomaticMedium | -AutomaticMinimal | -Only NAMES |
    -Tags SUBJECTS. A tier is a budget of checks that cuts as well as fills:
    25 % asked ran 25-30 %, 50 % ran 51 %, 75 % ran 76 %. Floor is one test per
    subject the pick left out plus the smallest group of the pick itself, added
    after a tight budget dropped the changed subject entirely. Sizes measured by
    tests/counts.py; the groups run 2 to 77 checks, so counting groups is not
    counting coverage.
    intent.py classifies a sentence before the model answers it - 11 of 12 on
    gemma4:12b, ~2.75 s - through the turn's own client. A second Ollama at a
    differe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
    [runner.py]
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2026-08-25 a failed conversion is not a reading of zero
    ADC_ReadOneChannel returned void and left *outRaw at 0 when ConfigChannel,
    Start or a 10 ms PollForConversion failed. On a differential channel code 0
    is 0 V, so a failure was indistinguishable from a measurement - the one
    thing a dumb slave must never produce.
    * bool, propagated through Board_AdcRead, PhaseRaw, DcBus, Ntc, AdcNoise
    and AdcBurst. The noise and burst loops abort rather than fold a zero
    into the mean; PhaseRaw short-circuits once one phase has failed.
    * h_adc_burst took on the value checks h_adc_noise already had, so its
    refusal can be SERVER DEVICE FAILURE instead of ILLEGAL DATA VALUE. A
    host seeing 0x03 on a well-formed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
    [board.h, board_adc.c, cmd_board.c]
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2026-08-25 the stand-in is checked against the firmware, offline
    Six items off the review list. The one that matters:
    * coaxial.simulated.CHANNELS is a second copy of s_adcTable, and the only
    thing that compared them was test_parity, which skips itself with no
    board - exactly when the stand-in is in use. test_simulated now reads
    s_adcTable out of board_adc.c and compares field by field, 34 -> 42
    checks, in every tier including the 25 % default. Verified to fail: a
    changed pin reports "firmware 'PC0', stand-in 'PC9'".
    * do_read_bits and do_read_regs take rsp_cap and check it. The signature
    promised a capacity that eight of nine handlers discarded.
    * mb_rtu_init: the comment was wrong, not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
    [board.h, board_adc.c, cmd_board.c]
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2026-08-26 the BNO08X on SPI2: SHTP, and seven bugs of my own
    Shtp/ is the transport, hardware-free like Modbus/ and tested the same way:
    test_shtp_core.py builds it with the host gcc and drives it through ctypes,
    38 checks against frames the datasheet writes out byte by byte. Board/ does
    the SPI, Comms/ carries it on function code 0x6E - the last user-defined one
    there is - and host/coaxial/imu.py reads it.
    Working against the part: product_id, six for six.
    sw_version 3.2.0, sw_part 10004148, build 6, patch 13, external reset
    Reads return correctly framed cargoes, including the 276-byte advertisement.
    Set Feature does not take yet: no response on channel 2, no reports on 3.
    Seven bugs, all mine, a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
    [board.h, board_hw.h, board_imu.c, cmd_imu.c, coaxial_63100.ioc, main.c]
2026-08-26 the IMU in the model's hands, and the board drawn from its quaternion
    Asking for the IMU used to fetch the ADC table: "matvarden" is the noun the
    analog channels answer to. The fix is in intent.py, not in a prompt rule -
    the IMU is a third kind of read and orientation is its own intent, so the
    host compiles the call and the model never chooses. A SYSTEM rule was tried
    first and removed: intent.py says in as many words that such backstops went
    when the compiler took the choice, and it broke the prompt's token budget.
    Live, twelve of twelve on each half:
    lista alla matvarden fran IMU:n / vad sager IMU:n? -> imu
    visa mig orienteringen pa elektroniken / hur ar kortet vant? -> orientatio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
    [simulated.py]
2026-08-26 the board says what it is made of
    channels gains kind 3: one entry per command table, with what that table is
    for and how many commands it carries. The list is derived, not written - the
    count is asked of the table on every call, so adding a table adds a subsystem
    and nothing goes stale.
    subsystems: 3
    board 11 cmd ADC channels, digital I/O, clocks, self test
    testrig 7 cmd gated raw pin access for a fixture
    imu 1 cmd BNO08X on SPI2 over SHTP
    It sits under channels because there is nowhere else. Every user-defined
    function code is spent, and 0x41 has 32 bytes left of 250 - measured, not
    assumed - so appending to the version record was out despite invariant 3
    al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
    [cmd_board.c, simulated.py]
2026-08-26 draw the board from its own STL, repaint only what changed
    render/models holds the CAD export, 419,338 triangles. mesh.py reads it
    once and reduces it to 45,000 area-weighted surface points, cached beside
    the model: 1.09 s the first time, 15 ms after. No numpy - requirements.txt
    says why, and the cost it would buy is a one-off.
    orientation.py turns points through a rotation matrix instead of two
    quaternion sandwich products each: 54 ms a frame down to 26. The camera
    convention was the wrong way round and drew the solder side under a caption
    that said component side; +Z is now the face the reader sees.
    show_orientation.py writes only the rows that differ. Rewriting all 24 at
    20 Hz is what m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
    [Coaxial 63100.stl]
2026-08-26 AFE_ON powers the IMU, and the board now says so
    Measured: with PB2 low the BNO08X answers reads, resets and returns a valid
    276-byte advertisement, and acts on no write at all. With it on, then reset,
    Set Feature 0x05 at 20 ms gives 135 rotation vectors in 4 s, 51 distinct.
    show_orientation now reads live attitude off the part.
    What that cost, and what ruled each one out, is in FINDINGS. product_id
    looked like proof the link was two-way and was not: the part sends an
    unsolicited product id response after every reset.
    Board_ImuInit refuses while PB2 is low, and Board_ImuReady clears the ready
    flag when the AFE goes away - a part that lost its supply needs a reset, not
    a resume. The wake ha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
    [board.h, board_imu.c, cmd_imu.c]
2026-08-26 the board polls the IMU into shared memory, and says what is fitted
    The host was racing the part: one Modbus round trip per SHTP cargo cost
    45 ms and caught one frame in eight, because most cargoes are the
    advertisement or the executable channel, not channel 3. Board_ImuPoll now
    runs from the main loop and writes a shared record; 0x6E op 8 reads it.
    Measured: 30 of 30 frames live, ~57 rotation vectors a second, 0 errors.
    The reset inside it is staged across main loop passes - 130 ms spent in one
    was a Modbus request timing out, seen as `fc 0x46: silence`. It is held off
    mid-frame too, via the new link_busy(): RTU delimits frames by silence and a
    276-byte cargo at 1.48 MHz is 1.5 ms.
    Ops th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
    [board.h, board_imu.c, board_io.c, cmd_board.c, cmd_imu.c, coaxial_63100.ioc, main.c]
2026-08-26 A1335 on SPI4, polled like the IMU, and 0x6E becomes a device gateway
    The angle sensor reads: TSEN 2471 counts = 308.9 K = 35.7 C, FIELD 2 gauss,
    the poll loop at ~22,000 reads a second with no errors. FIELD says whether
    the angle means anything - with no magnet in front of the part it reads 3
    gauss and the angle is noise, and the views say so instead of drawing a
    confident pointer.
    Three things cost time, all of them in code, all in FINDINGS:
    - SPI4 refuses a data size above 16 bits (IS_SPI_HIGHEND_INSTANCE names
    SPI1..3), so the 20-bit packet goes out as four 5-bit words - exactly
    twenty clock edges under one chip select;
    - the answer lags a frame, so a register read is two packets. A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
    [Coaxial 63100 BOM.csv]
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2026-08-26 calibration lives on the board, and the phase channels report amperes
    0x6E device 3: nine scaling scalars and one offset/gain pair per ADC
    channel, CRC-16, in the last sector of bank 2. Ops get/set/zero/span/
    save/load/defaults. Integers on the wire - microhms, ppm, microvolts,
    centikelvin.
    Traced off electronics/, none of it measured: phase RU1||RU2 3.5 mohm
    (two 7 mohm WSHM2818) x THS4551 1.5k/330 = 15.909 mV/A, 207.4 A full
    scale; DC link R12/R11 49.9k/2.2k = 78.15 V; NTC R100 10k with B=3380;
    VREF is U2, a REF2033, driving +3V3_ref and +1V65_bias both. The
    schematic's numbers are the record's defaults, so a rig overwrites them
    rather than rebuilding.
    Invariant 7 replaced: its premise,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
    [board.h, board_adc.c, board_cal.c, main.c, simulated.py]
2026-08-26 one test file per subject, a meter bridge, and the STL port
    test_ollama.py was 5,496 lines and 733 checks - a third of every check
    here, in one file, and the reason a coverage tier could not be asked for
    at any useful resolution. Nine files now, 12 to 218 checks each, with the
    fixtures in ollama_support.py; select() and run_file() take the roster as
    an argument because there is no single roster left to close over.
    Tiers are arithmetic, not a table of three: any 5 % step, suites joining
    cheapest-per-check first. The model narrows within a tier and no longer
    past it - measured, it put live:all back on the 25 % tier and the cheapest
    run there is took 398 s of which 352 were that suite. Where t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
    [ansi.py, simulated.py]
2026-08-26 rasterise the STL's triangles instead of splatting points off it
    The renderer sampled the surface into points and drew each as a disc. Four
    rounds of tuning that never fixed the board looking like a flat noisy disc,
    because the premise was wrong: sampling is weighted by TRUE area, and 43% of
    this model's area is near-vertical wall a rasteriser gives almost no pixels.
    mesh.py claimed carrying triangles would "cost a hundredfold". Never
    measured, and false - the full 419,338 rasterise in 1.6 s a frame at 100x30,
    and 74% of what they draw is sub-pixel.
    So: real triangles, vertex-clustered to 27,628 and indexed. Shading uses the
    ORIGINAL face normal, not the snapped triangle's - clustering tilt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
    [farm.py]
2026-08-27 TIM1 gets the bridge pins, PE14 and PE15 change hands
    CubeMX output from the pin edit, on its own so the code that leans on it can
    be reverted without taking it along.
    PE8..PE13 become TIM1 CH1/CH1N, CH2/CH2N, CH3/CH3N - the three half bridges.
    PE15 moves from a GPIO input to TIM1_BKIN, so the gate drivers' nFAULT stops
    the bridge in hardware instead of waiting to be polled. PE14 is new, an
    output low at reset. 42 pins to 49.
    TIM1 itself is not in the peripheral list, so MX_TIM1_Init is not generated:
    the pins are assigned to a timer that has no clock and no configuration yet.
    [coaxial_63100.ioc, main.c]
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2026-08-27 the pilot comes from the master, and the board only listens
    Read off RS485.SchDoc and STO.SchDoc. Gate driver supply is not the MCU's to
    switch: a Safe Torque Off chain releases it, unlocked by a common-mode pilot
    tone the master injects on the RS485 pair. Leaky integrators with a charge
    and a discharge path, so the tone has to keep arriving - a dead man's switch
    rather than a one-shot unlock.
    Extraction is R36/R37, 10k each across A1/B1 to a midpoint, so the
    differential data cancels and the common mode does not: Modbus and the pilot
    share the pair without touching each other. Then C75, a 1k-10k band pass, a
    0.7 V clamp, and U16 TLV3492 - two comparators, each with positive feedback,
    A off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
    [board_pwm.c]
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2026-08-27 ADC3 gets its interrupt, and the injected callbacks are wired
    CubeIDE rejected the hand-written TIM1 block outright: all eighteen TIM1.*
    keys gone, Mcu.IPNb back to 15, no MX_TIM1_Init. Loud rather than silent,
    which is the good failure - a half-configured timer with DeadTime left at 0
    would have been shoot-through on the first enable.
    What survived is the NVIC entry, so ADC3_IRQHandler is generated and calls
    HAL_ADC_IRQHandler. board_sync.c now overrides the two weak callbacks that
    chain hangs off - injected conversion complete and queue overflow - because
    Core/ holds CubeMX functions and the two poll calls, and these are neither.
    The likely reason the block was rejected: a timer is not e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
    [board_sync.c, coaxial_63100.ioc, main.c]
2026-08-27 TIM1 gets a real configuration, and 80 ns of dead time
    Centre-aligned, ARR 2375 off 237.5 MHz = 50.000 kHz exactly, DTG 19 =
    80.0 ns, break on PE15 active low, AOE off. Read back over SWD.
    Dead time off the models in electronic_simulations: worst-corner gate
    overlap 59.4 ns plus the 2EDL8034's 6 ns TDMOFF max = 65.4 ns floor.
    1.5 ns spread over +/-100 A and 1 ns over 27-125 C, so one fixed DTG does.
    TPW 40 ns puts the smallest high-side pulse at 29 ticks, 0.63 % duty.
    Board_PwmInit() was never called, leaving six gate driver inputs Hi-Z; it
    now sets CCxE and CEN, and clears the BIF that latches on its own init
    because PE15 floats while BKE goes on. Board_SyncReady() wanted a JSQR
    only Arm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
    [board_io.c, board_pwm.c, board_sync.c, coaxial_63100.ioc, main.c, simulated.py]
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2026-08-27 The bridge reaches the wire, and the synced triple reads right
    0x6E device 4: state, pwm on/off, duty, sync arm/disarm, sample point,
    clear break. Protocol MINOR 6 -> 7. Nothing had exposed Board_PwmState,
    Board_SyncState or Board_StoState, so measuring the loop rate needed a
    debugger reading RAM over SWD.
    Three bugs, all found by making two paths that must agree disagree:
    - Board_SyncOnInjected cast JDR to int16_t. JDR is offset binary, 32768
    = 0 V, so every quiet phase read near the negative rail: U was -31344
    where the meter read +1423. Now via Board_AdcDifferential, one
    definition (invariant 7). board_adc.c already carried a comment about
    this exact bug from an earlier session.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
    [board.h, board_adc.c, board_sto.c, board_sync.c, simulated.py]
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2026-08-27 A break bypass for bench work, and the current path validated
    0x6E device 4 op 6 clears BDTR.BKE, not just the BIF latch: with nFAULT
    low the break is a level, so the hardware holds MOE clear and clearing
    the latch alone cannot work. Protocol MINOR 8, flags2 appended to op 0
    so no existing offset moves. A reset restores the break.
    What makes it safe is not the firmware. The STO chain gates the gate
    drivers' own DC/DC, which no MCU pin reaches.
    Measured with the bridge enabled and inert: duty swept 0-100 % equal on
    all three phases, sample point swept 60..2360. Phase means stay within
    41 LSB across every sample point and 43 across every duty - inside one
    sd - with zero overruns and the DC b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
    [board.h, board_pwm.c, simulated.py]
2026-08-27 The keepalive's worst gap is the Modbus reply, not the IMU
    Added a worst-gap counter to Board_StoKeepalive - raw CYCCNT, invariant
    2's reason unchanged - with 0x6E device 4 op 7 to reset it and worst_gap
    in op 0. Protocol MINOR 9. The mean rate hid all of the following.
    5 s with no Modbus traffic ............ 476.1 us
    86 smallest-possible replies (1 B) .... 476.1 us
    86 state replies (53 B) ............... 5117.2 us
    53 B at 115200 8N1 is 4.60 ms; measured excess over the floor is 4641 us.
    The main loop blocks while it transmits, the stall scales with reply
    length, and it is identical with AFE_ON low where Board_ImuPoll returns
    immediately. Asking the board a question costs three tim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
    [board.h, board_imu.c, board_sto.c, simulated.py]
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2026-08-27 An acquisition task: configure, start, read
    0x6E device 6, DAQmx's shape cut to one task - one MCU, three converters,
    one timer, so configure replaces rather than adds. Protocol MINOR 11.
    channels bitmask over the rows of 0x6D kind 0
    clock the main loop, or the injected group at one per PWM period
    sample_time 0..7 over the H7's eight windows, now settable at all
    decimate keep one trigger in N
    accumulate sum N samples per record - summing, not averaging, because
    it keeps the bits an average throws away
    records stop after N, or 0 to run on
    Op 5 replies the record layout - per field the channel, unit, differential
    flag and signal name - and th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
    [board.h, board_adc.c, board_daq.c, board_sync.c, main.c, simulated.py]
2026-08-27 Buffered capture of everything, and a rate the board picks itself
    The acquisition task now samples the digital pins alongside the
    converters - one u32 per record, the drivable pins only, taken at the
    record's timestamp rather than summed. Naming all twenty-three in the
    layout came to 312 bytes against MB_MAX_PDU's 253 and the reply failed
    outright, which is the lesson the parts list already carried.
    A free-running task took the link down, and not by crashing: seven
    channels put about 190 us of converter work into every loop turn, and
    RTU discards a frame whose characters arrive more than t1.5 - 143 us at
    115200 - apart. s_keepalive read over SWD while the board was mute went
    0x1C2EF5 to 0x1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
    [board.h, board_daq.c, board_io.c, simulated.py]
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2026-08-27 A live accumulator that cannot overflow
    0x6E device 6 op 6. Every trigger adds into a static accumulator sized to
    the maximum channel count - a one-channel task uses one slot of it - and
    a read takes it away and resets it. Protocol MINOR 15.
    The difference from the ring is what happens when the reader is late.
    The ring is a capture with history and drops when it fills; this widens
    the averaging window instead and has nothing to drop. Message in a
    bottle or fibre, the same call.
    Measured, seven channels plus the digital word, free-running: takes
    50 ms apart returned 10, 16, 20, 25, 31 and 36 samples, means tracking
    the meter - NTC 40859..40884 against 40878.7, DC bus 20762..20763
    against 20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
    [board.h, board_daq.c, simulated.py]
2026-08-27 The accumulator counts per channel, and the loop runs free
    arr[channel][additions]: op 6 now replies a sum AND a count of the
    additions for each field, not one count for the lot. Board_DaqPoll reads
    one channel per turn of the main loop, so a take lands mid-sweep and the
    channels have had different numbers of samples - measured over half a
    second on seven channels, 1044/1043/1043/1043/1044/1044/1044. A single
    count divided six of them by the wrong number. Protocol MINOR 16.
    The sample loop is no longer throttled. The interval existed to protect
    the link, and one-conversion-per-turn already did that - rate limiting
    never worked anyway, 200 Hz survived and 1000 Hz did not, because one
    poll st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
    [board.h, board_daq.c, simulated.py]
2026-08-27 Tie the cycle counter to a host clock, and stop when the AFE does
    0x6E device 7: op 0 latches CYCCNT and is meant to be broadcast, op 1
    fetches it. Every timestamp this board makes is raw CYCCNT (invariant 2),
    which leaves a host holding ticks; this maps them. Protocol MINOR 17.
    Broadcast beats a round trip by 7x, measured on the VCP: 5 243 us for
    the bracket against 35 883 us best-of-20 for the trip, so ~17 941 us one
    way. A 16-byte reply is 1.7 ms of line time and the rest is the driver's
    latency timer, which a broadcast never waits for. The round trip looks
    better on paper - it measures the delay it corrects - and loses anyway.
    clock.probe() is kept so a segment with another driver can b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
    [board.h, board_daq.c, simulated.py]
2026-08-27 python_examples: a DAQ session behind one class
    Coaxial63100 wraps session, clock, daq and bridge so a first script does
    not have to know which subsystem owns what. Constructor takes the link,
    the baud, the port and simulated_device. daq_session.py is the flow, with
    # %% cell markers so it opens as a notebook and still runs as a script.
    The bridge is OFF by default in it, and that is not tidiness. Writing the
    example ran 25 % duty on all three phases with the STO bypassed and
    tripped the hot-swap's over-current - the second time in this session,
    after 50 % earlier. Equal duty puts no voltage between the legs so no
    phase current could flow, and both runs had AFE_ON high, which on this
    bench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
    [simulated.py]
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2026-08-27 Refusals come from the board, with a fix attached
    Everything that takes parameters returned a bare 1 or 0, so the host was
    listing possible causes in its exception text - a second answer that goes
    stale the moment a check moves. Board_DaqConfigure, Board_DaqStart,
    Board_PwmSetAll, Board_PwmSetAllFine and Board_SyncArm now return NULL or
    the reason, and cmd_took() puts it on the wire as `u8 took` plus a string.
    Protocol MINOR 20.
    Each sentence says what is wrong AND what to do about it: a refusal that
    leaves the caller guessing has done half a job.
    accumulate=0 -> accumulate counts samples per record, so the smallest is 1
    sample_time=99 -> sample_time is 0 to 7, shortest window first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
    [board.h, board_daq.c, board_pwm.c, board_sync.c]
2026-08-27 Time against UTC, not against a PC that is 947 ms out
    clock.sync() defaults to reference='utc': an SNTP offset at each end of its
    own window, the host's offset out of the epoch and the host's rate out of
    the frequency. No network falls back to the host clock and records why in
    Sync.note. The window now samples through CYCCNT's 9.04 s wrap rather than
    refusing to span it, so its floor can be driven down; floor_ppm says where.
    Measured: board -11.62 ppm vs UTC over 900 s, floor 1.11, so SYSCLK is
    474.994 MHz. This PC 947 ms out and 21.82 ppm slow six minutes after
    W32Time reported a good sync - Windows declined to step it, inside the 1 s
    MaxAllowedPhaseOffset. The correction was signed backwa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
    [simulated.py]
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2026-08-27 A gate driver view, and an arming interlock the bench board has to override
    demos/bridge.ps1 and tools/show_bridge.py: the six gate signals as one
    instant, the currents and DC link with ripple from the live accumulator, and
    a timed burst. Keys: + - duty, [ ] step, A arm, B BKIN override, I interlock
    override, 1 2 3 4 run 1/10/100/1000 ms, R run.
    The board reports the six outputs as one GPIOE IDR read plus TIM1->CNT
    beside it - protocol MINOR 22, appended after `requested`, which the first
    cut was not: it went in before and shifted every offset after it, the same
    mistake this file already carries a warning about. Six separate asks at
    50 kHz can straddle an edge and show a leg with both FETs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
    [board.h, board_pwm.c, coaxial_63100.ioc, simulated.py]
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2026-08-27 The IMU was streaming and the poll loop never read it
    Board_ImuPoll returned every turn unless H_INTN was asserted at the instant
    it looked - one GPIO read, no wait. Correct and cheap when the pulse is
    caught, useless when it is not, and the part streamed rotation vectors at
    50 Hz into a loop that never collected one. It polls a header when H_INTN
    has not asserted, rate limited to 1 kHz in raw CYCCNT: 27 us per four-byte
    transfer at 1.48 MHz, 2.7 % of the loop against a 20 ms report interval.
    A reset before a Set Feature stops the feature taking - measured over three
    seconds each: reset then feature, 0 vectors a second; feature alone, 49.0.
    The write's own wake handshake resets when the ack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
    [board.h, board_imu.c, cmd_imu.c]
2026-08-27 bridge -> gate_drivers, two supply senses, and the ceilings they found
    Renamed everywhere the subsystem is meant, not where the circuit is: a half
    bridge is still a half bridge, and so are the meter bridge and the AXI->AHB
    bridge in ST's header, which the first pass renamed and this one put back.
    PA4 and PA5 added as ADC1 IN18 and IN19. R113 on the MCU sheet is a 10 k
    array whose elements are GND, +5, +15V7 through R119 47 k, GND - so PA4 is
    the +5 rail at ratio 2.00 and PA5 the gate supply at 6.70. Measured: +5V
    2.552 V at the pin, so 5.10 V; Vgate 0.052 V, so 0.35 V, which is right
    with AFE_ON on because this board's gate is inverted. DAC0/1/2 are crossed
    out on the same sheet, so these a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
    [ansi.py, board.h, board_adc.c, board_cal.c, board_daq.c, board_io.c, board_pwm.c]
2026-08-27 The supply senses read volts, and the stand-in stopped keeping two lists
    +5V and Vgate report millivolts now, scaled by their own dividers out of the
    calibration record - R113's 10k/10k for the rail and R119 47k + R113 10k
    over 10k for the gate supply. Measured: +5.105 V and +0.350 V, on 0..6.6 and
    0..22.1 full scale. CAL_VERSION 3, four parameters appended, MINOR 24.
    A unit says what a number is, not what scaled it: three channels now report
    mV and no two share a divider, so scaling.converter takes the signal.
    Without it the meter read +5V as 60.4 V, which is 2.552 through the DC
    link's 23.68.
    Simulated mode was broken on a machine with no board, which is where it
    matters most. The stand-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
    [board.h, board_adc.c, board_cal.c, simulated.py]
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2026-08-27 The six gate signals were writable through the GPIO test path
    Board_PinUsable returns true for any pin not in s_digital - "nothing claims
    it, so a fixture may have it" - and PE8..PE13 were not in s_digital. The
    reserved list reported 19 pins and not one of them was a gate, so gpio_pin
    write on PE12 was allowed. That calls HAL_GPIO_Init, which takes the pin off
    TIM1 and leaves it driven by ODR: one FET of a half bridge latched on with
    the other still switching against it, and the dead time cannot help because
    the pin is no longer the timer's to sequence.
    All six claimed now with usable false, and the stand-in reserves them too.
    Reserved reports 25 pins; a raw wire request past the host's own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
    [board_io.c, simulated.py]
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2026-08-28 The board finds a shorted gate pair, and PE15 stopped disconnecting the break
    W read 99.13 % both-gates-high against 0.00 % on U and V - its two pins were
    one node, a bad footprint, since reworked. `Board_PwmGateShorts()` drives one
    pin and watches the other sink through its own pull-down; `gate_shorts` is
    appended to the gate driver state (proto MINOR 26) and `gate_drivers_check()`
    refuses to arm on it. After the rework: 51.6 / 47.0 / 0.0 %, matching U and V,
    and 20 s at 50 % on all three legs moved the NTC 29.52 -> 33.23 C.
    PE15 carries TIM1_BKIN and was `usable = true`, so the test path called
    HAL_GPIO_Init on it and took the break off the timer - measured after a
    conformance run, MODER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
    [board.h, board_io.c, board_pwm.c, cmd_board.c, cmd_gate_drivers.c, simulated.py]
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2026-08-28 Cut the prose around the measurements, and nine stale facts with it
    Comments and docs only, no behaviour change. cmd.h 171 -> 138 banner lines,
    the Modbus and Comms headers, eight board/cmd file comments, ~25 Python
    docstrings, all five docs rewrapped to 80 columns. PROTOCOL.md had 70 % of
    itself inside one bullet under 0x6E; it is a section per device now.
    board_imu.c told the same H_INTN measurement four times - 77 reads across
    1.2 s after a reset, all high - now once in the banner. The STO band pass,
    the span refusal and the host clock figure each lived in two documents.
    Wrong, not just long:
    board_imu.c said H_INTN and NRSTN had no pins; they are PD8 and PD10
    invariant 1 named dev_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
    [board_cal.c, board_hw.h, board_imu.c, board_log.c, board_sto.c, board_sync.c, runner.py]
2026-08-28 Every recorded mistake is now a named problem and its fix
    Reframing, plus one correction to the last commit.
    The correction: board_imu.c's banner was rewritten last commit to lead with
    "H_INTN IS ON PD8 AND NEVER ASSERTS", citing 77 reads all high. FINDINGS
    retracts exactly that measurement - each read was a Modbus round trip 15 ms
    apart against a microsecond pulse, so it could not have caught one either
    way, and feature() alone works, which needs the wake acknowledge. The line
    does assert. The banner now says so, and says why the header is polled
    anyway: Board_ImuPoll used to return every turn unless H_INTN was asserted
    at the instant it looked, leaving the part streaming 50 Hz into a loop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
    [board_imu.c]
2026-08-28 Three interfaces instead of flat method piles, and a monkey-patch removed
    The host is now declared surfaces with real and simulated implementations,
    rather than duck typing plus convention.
    Acquisition configure start stop read latest state
    Daq, Coaxial63100, SimulatedDaq
    PolledSensor state read write hold resume configuring
    Imu, Angle, SimulatedImu, SimulatedAngle
    GateControl the twelve 0x6E device 4 ops
    GateDrivers, SimulatedGateDrivers
    Every one has a stand-in, which is the argument for declaring them: a name
    that drifted used to surface as an AttributeError on the first call that
    reached for it. Verified all nine classes have n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
    [board_angle.c, board_daq.c, board_imu.c, simulated.py]
2026-08-28 Rails are reference counted, and the observer runs in the firmware
    Board_PowerAcquire/Release with named users, behind 0x6E device 9. Every
    hold but the host's is a lease: the observer took AFE_ON, link_busy()
    starved the poll holding the release, and the rail stayed high. Measured
    under 10 Hz traffic - 100 % stuck before, 0.3 % after. power_check.py
    proves 18 claims against the board; an acquire is refused while the gate
    stage is armed.
    Board_ThermalInit/Poll run from the main loop, so the NTC is sampled in
    AFE-off states too. Settable, 5 s / 500 ms: paired A/B over 12 pairs put
    500 ms minus 100 ms at +0.005 K, sem 0.008 - the reference is up before
    100 ms, and the four samples that once "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
    [ansi.py, board.h, board_power.c, board_power.h, board_thermal.c, cmd_board.c, main.c]
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2026-08-29 The demos are the session, and the host stops keeping its own calibration
    demo.ps1 with no argument IS the session now - nothing to pick and no mode to
    enter. A name still runs a standalone view, for the rendering the panels do
    not carry. `workbench` is gone as a name and as a menu entry.
    Arrow keys were broken in every view, not just the new one: an arrow sends
    ESC [ A and ESC alone is what leaves a view, so pressing one closed whatever
    was being adjusted. screen.py takes them out of the buffer before the
    lone-ESC test and hands them over as names. Up and down move the duty, which
    the session owns rather than the activity - stop switching, start again, and
    it is still where you put it. 50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
    [board.h, board_adc.c, simulated.py]
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2026-08-29 Stale counts now fail a check, and two views were broken
    Prose quoting suite sizes: CLAUDE.md, run_tests.ps1, ARCHITECTURE and TODO
    carried three different totals and four wrong sizes. test_structure now
    reads .counts.json and fails on any of them - one run behind when a check
    is added, which is the intended cost.
    Stale comments rewritten against measurement: kind 0 is 187 bytes for ten
    channels and is paged, so "nine channels come to 245, two more and it
    overflows" was wrong twice. Same for "six parts ... 380 bytes" - ten parts,
    page 0 is 172.
    converter() takes the board's calibration record. Three views cooked every
    channel with the compiled-in fallbacks while the library read the record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
    [board.h, board_io.c, board_pwm.c, board_sync.c, cmd_board.c, simulated.py]
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2026-08-29 The stand-in was missing five calls, and nothing static said so
    test_structure reads `board.X.y()` off the AST and checks both the real
    subsystem and the stand-in have it - no list to maintain. Proven: it names
    coaxial/rig.py:226 daq.read with the rename reverted.
    It found five real gaps. SimulatedBoard had no `calibration` subsystem at
    all, and SimulatedSystem no version(), self_test_failures() or
    release_console(); SimulatedAnalog no scan(). All five now answer, and
    scan() refuses with AFE off on the same condition as the real one - the
    refusal is the point, or a view ships with that path never taken.
    test_parity keeps its hand-written table: the static check cannot see a call
    through a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
    [simulated.py]
2026-08-29 python_examples was outside every check, and a flaky MCP check
    test_structure now walks python_examples/ - the files a reader copies from,
    and the only place left holding the renamed `daq.read`. Notebooks are exempt
    from the docstring and duplicate-definition checks: the first cell is a
    markdown heading, and the SIMULATED knob at the top of each is the one line
    a reader flips.
    test_mcp's "AFE off is labelled" failed twice in one run and never alone.
    `afe_power off` releases the HOST's reference and nothing more - the rail is
    on while any user holds it, and the observer's 500 ms borrow landed between
    the two calls. Waited out, bounded by one 5 s cycle, since no tool there can
    stop the observ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
    [ansi.py, coaxial_63100.ioc, main.c]
2026-08-29 The SPI mode in the .ioc is not what runs, and say() leaked escapes
    Board_ImuInit and Board_AngleInit set every field of hspi2/hspi4 and call
    HAL_SPI_Init themselves, so CubeMX's values are overwritten before either
    part is spoken to. The .ioc reads mode 2 on SPI2 and mode 0 on SPI4 while
    both drivers run mode 3 - dead values that read like a specification.
    Written down in HARDWARE.md and beside both drivers.
    screen.py's say() wrote colour unconditionally while every view suppressed
    it off a terminal, so a redirected preflight carried raw escapes into the
    log next to a clean drawing. isatty() now, the same edge rule.
    [board_angle.c, board_imu.c, coaxial_63100.ioc, main.c]
2026-08-29 Product id never answered, because eight reads took microseconds
    The part needs milliseconds to produce a control-channel answer and cmd_imu
    op 0 read eight times with no wait between them. With the queue drained -
    the normal state, the poll loop drains it - all eight came back empty and
    the reply was SERVER DEVICE FAILURE on a part answering perfectly. Measured:
    the same request sent by hand and read 15 ms later got f8 04 03 02 every
    time. Board_ImuWaitReady(5 ms) before each read; product id now answers in
    31 ms, SH-2 3.2.0 part 10004148.
    wait_intn used `HAL_GetTick() + ms` as a deadline, which wraps every 49.7
    days and then reads backwards - the wait returns at once or spins for a
    month.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
    [board.h, board_imu.c, cmd_imu.c]
2026-08-29 The IMU came back from an AFE cycle silent, and 400 Hz was a transfer cost
    Across an AFE power cycle the loop returned `running` in 0.71 s carrying its
    feature with `pending` false, and no report arrived in 15 s. The Set Feature
    went out during the part's 276-byte advertisement, was accepted at the SHTP
    level and discarded; Board_ImuWrite returns true either way, so the request
    was never made again. Applying it only after 60 ms of quiet fixes it: first
    report 0.33 s after AFE_ON, four cycles in a row. Gating on one cargo was
    tried first and was not enough.
    Rate: SPI 1.48 -> 2.97 MHz took a requested 400 Hz from 381 to 397. Polling
    at 4 kHz instead made it worse - 360 Hz and triple the error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
    [board.h, board_imu.c, cmd_imu.c, coaxial_63100.ioc, main.c, simulated.py]
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2026-08-29 Dead time 80 -> 30 ns, a teardown that lists, and the menu description
    Dead time asked down to 30 ns: t_DTS is 4.21 ns so it lands on DTG 7 =
    29.5 ns, which the board reports. Board_PwmInit writes it now instead of
    inheriting the .ioc - twice today a regeneration moved a peripheral setting
    the drivers depend on, and this is the one where a silent move shorts a leg.
    The 65 ns the old figure was fitted against is kept in FINDINGS: nothing
    disproved it, and nothing has been on a scope.
    Quitting the session lists what it put back, one line per thing, the way the
    preflight lists what it took - `everything is stopped` was one line for a
    stage that might have been switching.
    The menu still descri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
    [board_pwm.c]
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2026-08-29 The dead time lives in the record, and a session can be looked into
    It was in three places at once: the .ioc said DTG 19, Board_PwmInit wrote a
    #define of 30 ns, and the board reported 79 because the binary on it predated
    the change. Now it is calibration parameter 13, CAL_VERSION 5 - asked for,
    stored, read back. Proven: 45 ns asked, 42 held (10 counts of 4.21 ns), still
    there after a reset.
    Board_PwmInit cannot read the record: it runs before Board_CalInit, and has
    to, because its job is driving six gate inputs to their idle level. Reading
    it there got zero and the floor turned that into 21 ns. main() applies it
    after the record loads. BOARD_CAL_PARAM_COUNT is what op 0 walks, so it moved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
    [board.h, board_cal.c, board_pwm.c, main.c]
2026-08-29 The firmware's fixed numbers live in one file
    Twenty-five #defines were one per file across two layers: part clocks, buffer
    sizes, poll rates, settle times, the dead-time floor. Nothing was wrong with
    that until one of them was - and IMU_CARGO being smaller than IMU_BUF was
    invisible without opening two files in two layers, which is how a cargo
    arrived truncated.
    Comms/Inc/board_limits.h holds them in sections - the serial link, the gate
    stage, the IMU, the angle sensor, acquisition, the observer, power - each
    with the measurement that chose it, moved verbatim. Build size is unchanged
    to the byte: 145 380 B before and after.
    What did NOT move: anything the board can be told, which is in th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
    [board_angle.c, board_daq.c, board_imu.c, board_limits.h, board_power.h, board_pwm.c, board_thermal.c, cmd_imu.c]
2026-08-29 Two limits headers, one per layer, so the includes run one way
    Board/Src reaching up into Comms/Inc was backwards. The drivers' numbers are
    in Board/Inc/board_limits.h - part clocks, buffers, poll rates, settle times,
    the dead-time floor - and the wire's in Comms/Inc/comms_limits.h, which
    includes the first. Nothing in Board/ includes the second, and
    test_structure fails it if one does; proven by pointing board_imu.c at it.
    The relation the single file made visible is kept as a _Static_assert rather
    than as a thing to remember: IMU_CARGO <= IMU_BUF, with the reason. Proven
    to stop the build - a cargo of 400 fails with "a Modbus reply cannot carry
    more than the driver read".
    Build size unch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
    [board_limits.h, cmd_imu.c]
2026-08-29 The supply tripped its OCP at 29.5 ns, and the conversion rounded the wrong way
    First over-current this board has caused. Three legs at 50 %, dry - no motor,
    no load - with DTG 7 = 29.5 ns. Dry switching should draw almost nothing, so
    an over-current with no load is shoot-through, which is the one thing the
    dead time prevents and the 2EDL8034 has no interlock against.
    Board_PwmSetDeadTime truncated, so 30 ns asked became 29.5 ns held - under
    what was asked for, in the one direction that is unsafe. The floor beside it
    had rounded up since it was written, for exactly this reason. 30 ns now
    lands on 8 counts = 33.7 ns.
    Still under the 65 ns the datasheet arithmetic asks for - 59.4 ns of
    worst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
    [board_pwm.c, simulated.py]
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2026-08-29 The rail stopped flipping at every connect, and the picture is round
    Coaxial63100 switched AFE_ON as a side effect of connecting: power_afe
    defaulted to true, so every rig that opened switched it on and every one that
    closed switched it back, ten call sites deep - including switch.py, which
    turned it straight off again to arm. False by default now, and said at the
    seven call sites that read analog channels.
    The observer sampled every 5 s against a 6.8 minute time constant - 80
    samples a tau, and AFE_ON drives an LED. 30 s is 13 a tau.
    The thermal picture had three faults at once. It was oval because a terminal
    cell is a tenth taller than wide and both renderers are square in cells;
    CELL_AS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
    [board.h, board_cal.c, board_limits.h, main.c]
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2026-08-29 The console got a defined style and a renderer built around it
    tools/stage.py: a rich Theme with named roles - values glow amber, labels
    recede, one solid title band, heavy viewport frame, reversed key bar -
    and frame_of/panels_of building a full-screen Layout every view uses.
    All seven surfaces converted, session included; the hand-rolled ANSI
    layer (paint/framed/beside/grid/key_bar) is gone from the view path.
    Broker lingers 45 s after its last client: spawn + console handover cost
    5.85 s per menu hop, now 0.41 s measured. linger=0 in the tests - one
    test's broker answered the next test's clients before that.
    test_views.py: every view runs whole (args, preflight, two frames,
    teardown) as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
    [ansi.py]
2026-08-29 The stage got fast, quiet and vector-drawn
    tools/menu.py: broker probe off the frame loop (2029 ms -> 2.3 measured,
    tools/uibench.py is the meter), turntable frames cached per 1.5 deg,
    arrows fixed on Windows (msvcrt prefix codes were read and DISCARDED),
    hotkeys S B A M G T, selection moves colour only. Session and capture
    are one view; capture's uniques are the ACQUISITION box. The session
    enables the rotation vector while the rail is up, so the IMU box shows
    live quaternions.
    Wire mode in ascii3d: silhouette + depth-step edges only (WIRE_STEP
    0.018 - INK_STEP was tuned against cluster noise and swallowed every
    part outline), directional strokes, DEPTH-CUED brightness. Board
    attitude draw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
    [Coaxial 63100.stl]
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2026-08-30 The board swaps a phase pair every PWM period: op 10 alternate, proto 2.1
    `0x6E` device 4 op 10 takes two compare triples; TIM1's update ISR
    writes the other at every overflow, so the preloaded compares land at
    the underflow and each period is one triple - U high against V low,
    then V high against U low, current back and forth through the pair at
    25 kHz. Dither off while it runs; SetAll, SetAllFine, Disable end it.
    Host: gate_drivers.alternate(), the ABC and the stand-in, parity test,
    pulse.py --alternate.
    Measured 2026-08-30 at 31 V into 8 ohm, 5 %: twelve mid-run state reads
    show (118,0,0) x5 and (0,118,0) x7 and nothing else; 10, 30, 30 and 60 s
    runs all with the break clear, 0 overruns,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
    [board.h, board_pwm.c, cmd_gate_drivers.c, simulated.py]
2026-08-30 The thermal observer charges both legs of a ping-pong, and every page wears one band
    - Board_PwmGetDuty returns each leg's mean over the pair while alternating: 20 % U<->V 20 s, driver_u 29.19->40.51 C, driver_v 29.20->40.51, driver_w 29.19->29.62
    - band_of: name hard left, PORT, LIVE/SIMULATED chip right with a cell of air; header() and the masthead share it; the right column is sized to its text because rich rstrips a right-justified cell
    - boot strip: bar first at 28 cells, milestone text after in brackets; menu texts as given
    - the way back to the menu: no teardown hold to the menu, page at 0.15 s (was 2.03), board at 0.98 s; STL parsed once a process (0.46 s, was 0.60 twice); no broker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
    [board_pwm.c]
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2026-08-30 The chat pages work end to end, the board cleans up after a dead host, docs compacted
    - broker keepalive: one 0x41 read per 3 s of quiet while clients are attached; firmware deadman widened with Board_PwmSessionDrop (MOE down, bypass cleared, once per quiet edge). Bench: 15 s silent attached kept the AFE claim; 13 s detached dropped it; a killed process's armed stage was down 13 s later, all pins low
    - CCC page: values grid back in the transcript (--quiet suppressed _trace); typing echoes the input row alone (0.08 ms/67 B vs 14-26 ms/5-25 kB full paints - 5 s of lag gone); braille spinner at the prompt; mouse off so copy works, arrows scroll
    - ANTHROPIC page: generated absolute-path MCP conf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
    [board.h, board_power.c, board_pwm.c]
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2026-08-31 The observer runs on the model, starts and stops, and has a page under MOTOR CONTROLLER
    - Drive: the PMSM model as a sample source (DRIVE_SOURCE_MODEL, ops 10-13) - the observer dry against the phases with the AFE off; op 12 carries theta_hat/omega_hat beside the model rotor in one reply. Bench: locked from 0.3 rad to 0.002 rad; 441 rad/s tracked, 0.009 rad error
    - Start/stop: SetMode/SetSource, the drive owns the compares only while running, duty ops refuse meanwhile; mode and motor profile switch between runs
    - I-cache on: 1 780 idle cycles (2 922 before), the whole interrupt 12.3 us trigger to exit; every earlier cycle count was taken cacheless
    - ROTOR OBSERVER page: tools/show_observer.p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
    [board.h, board_adc.c, board_drive.c, board_drive.h, board_sync.c, cmd_drive.c, cmd_gate_drivers.c, drive.c]
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2026-08-31 Docs pruned a quarter, two latent bugs out of pyflakes, the example in subsystem style
    - docs: ARCHITECTURE 2021 -> 1481 words, HARDWARE 3930 -> 2980, PROTOCOL 5899 -> 4928 - tables for paragraphs, every measurement kept; ARCHITECTURE's Scaling section said the host owns conversions (invariant 7 says the record) and is gone
    - coaxial_mcp/render.py: def angle() shadowed the coaxial.angle module, so angle() and angle_registers() raised AttributeError on every reading - imported as a1335; test_mcp gained the two checks (46)
    - coaxial_ollama/capability.py: winreg was imported inside _gpus_registry and read by _adapters/_gpu_at at module level - NameError on the registry path; module-level import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
    [simulated.py]
2026-08-31 Two observers named apart, and the nests on both sides flattened to early returns
    - rotor_observer / thermal_observer: the chooser's view keys, demos/*.ps1, tools/show_*.py, the notebook; every bare "observer" in code and comments says which - thermal, rotor, or the viewer (the camera); drive.c's PLL is rotor_observer()
    - host: run_view() in screen.py is the loop every view ran six deep - seven mains are setup, draw(), teardown (depth 5-7 -> 2-3); Freshness shared by angle and orientation; the console-record drain, key bindings, act_on, _chat_once, connect, _resolve, run_task and _run each hand their nested block to a helper. Functions at depth >= 5: 30 -> 17, the rest render loops and elif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
    [board.h, board_adc.c, board_angle.c, board_daq.c, board_drive.c, board_imu.c, board_power.c]
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2026-08-31 The stand-in quotes the board's stride, from one formula
    It answered 12 where the board computes 14: the sample count was
    appended to the record and the stand-in's two hardcoded stride
    expressions were not, which is exactly what a host decodes by. One
    _stride() now, the board's arithmetic. Found writing the description of
    the read path; test_parity would have caught it with a board plugged in.
    after: simulated 195, structure 458, views 22 - 0 failed
    [simulated.py]
2026-08-31 An anti-alias chain the host designs, a tone that proves the path, and a buffer level
    The converter can do ~3.75 Msps and the link a few hundred records a
    second. Throwing samples away to close that folds everything above half
    the output rate onto the answer; a boxcar's first sidelobe is 13 dB down
    and not enough. So the chain is two stages, cheap first: an integer
    boxcar at the converter's rate, then the Bessel biquads the host
    designed, then the decimation.
    - Filter/ - portable C11 like Modbus/ and Drive/, cascaded biquads in
    transposed DF2. host/coaxial/bessel.py designs them without numpy
    (Durand-Kerner for the poles, bisection for -3 dB, bilinear with the
    cutoff pre-warped) and R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
    [board.h, board_daq.c, board_limits.h, simulated.py]
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2026-08-31 The board climbs a ladder of chains when the link cannot keep up
    A slow link should cost bandwidth, not records. The host sends a ladder of
    WHOLE designs - boxcar, coefficients, decimation each - and the board
    climbs it when its ring fills and comes back down when the link has caught
    up. Every rung is a complete anti-alias filter because decimating harder
    without redesigning is exactly how a fold gets in; the board cannot design
    anything, it chooses between designs.
    - device 6 op 9 loads a rung, configure takes `adapt`, op 0 appends the
    rung, the ladder depth and how often it has moved. A record says which
    rung made it without a field for it: `samples` IS that rung's boxcar
    - climbs at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
    [board.h, board_daq.c, board_limits.h, simulated.py]
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2026-08-31 The ladder answers latency, not a share of the ring
    The ring went from 16 K to 256 K and the ladder stopped working: six
    eighths of 780 records was five seconds of silence, six eighths of 14 000
    is seventy. A host that stopped reading was a minute of backlog before
    anything adapted. Measured: daq_adapt climbed and fell 0 times, was 6.
    The climb mark is now the lower of six eighths and 512 records, the fall
    mark an eighth of that - a rung answers how far behind the link is, which
    is a count of records; headroom for a burst is the rest of the ring.
    Measured after: 6 moves, 0 dropped, 6 s starve / 25 s drain.
    Offline gate 1847 passed, 0 failed. Build 0 warnings, flash 166340 B.
    Co-Authored-B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
    [board_daq.c, board_limits.h]
2026-09-01 Two buffers, a backlog in the reply, and a link that stops waiting
    A read answers how much is left in the ring, the way a DAQ card does -
    u32 appended to op 4, protocol MINOR 5, append-only. A host pacing itself
    no longer spends a round trip asking about a later moment.
    start() puts a reader thread on the link and read_buffer() takes from the
    host queue, so a print never sits between two round trips. Measured, ten
    channels and the pins with 4 ms of work a block: 84.4 -> 134.6 records/s
    and the board's backlog ends at 0 instead of climbing. One transaction at
    a time on the wire (an RLock), and one drainer of the ring: acquire() and
    blocks() serve from the queue while the reader lives, becaus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
    [board.h, board_daq.c, board_io.c, board_limits.h, simulated.py]
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2026-09-01 The stand-in gets a line, so a fast one can be measured without the board
    The board is unpowered, so this is all simulated: the stand-in now has a
    bitrate and charges time for the bytes it returns, which is what makes a
    throughput number off it mean anything. It also answers max_rate_hz - the
    board's own cmd_link_records_per_second formula against its own baud -
    which was simply missing, so a view asking what the link carries got
    nothing. Capacity was still quoting the 16 K ring from before it moved
    into the AXI SRAM.
    The host stack, through the full library path, against the emulated line:
    baud carries rec/s reads/s rec/read kbit/s % line
    115200 157 196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
    [simulated.py]
2026-09-01 The IMU keeps all three vectors, not just the quaternion
    Groundwork for reading acc, gyro, mag, the quaternion and the shaft angle
    together. The rotation vector was the only report the poll loop kept, so
    the other three were not gettable at all - the part can send them, nothing
    here caught them.
    board_imu_state_t carries accel, gyro and mag with a `have` and a status
    each, and one take_vector() reads all three: the five-byte header then x,
    y, z little-endian, which is the same shape the rotation vector's first
    three fields have. Three copies of those offsets is three places for a
    byte order to go wrong, and it went wrong here once already.
    The part can hold four features now instead of one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
    [board.h, board_imu.c, cmd_imu.c, simulated.py]
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2026-09-01 A record is an object with fields, and still the mapping it came from
    start_time = values[0].start_time
    dt = values[0].dt
    samples = values[0].samples
    sample = samples[0] # .name .unit .raw .count .value
    `Record` subclasses dict, so nothing written against the mapping moves:
    r['NTC'] is still the SUM the board sent and r['samples'] still the count
    that made it. A `Sample` carries both - `raw` is the sum, `value` is the
    sum over the count, and neither is scaled into volts, because that is
    `board.analog`'s answer and a record that guessed would be a second one.
    THE ONE COLLISION, said where it lives: r['samples'] is a COUNT and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
    [simulated.py]
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2026-09-01 The notebook shows the shape a script reads
    daq_session.py walked the catalogue, configured by name, read with
    read(-1) and ended on columns(). It was still on acquire() and
    r['NTC'] / r['samples'] - which works, since a Record is a dict, but is
    not what the front door is for.
    And a steady pin was not steady: the stand-in gave every pin a fresh
    random duty, so its own example printed `AFE 0.43` for a rail that is
    simply on. AFE_ON and the break read 1.0, KEEPALIVE lands near half
    because it is the one that genuinely toggles at ~100 kHz, and the gates
    are down until something arms them.
    Offline 1821 passed, 0 failed; test_structure 479.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
    [simulated.py]
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2026-09-01 The broker owns one ring, and every client reads its own way through it
    daq.configure_buffer(10000) # 10k records, circular
    With a broker in the path that sizes the BROKER'S ring and the broker's
    own thread fills it - one drainer of the board, many readers of the ring.
    Another process, another thread, a view and a chat session at once each
    hold a cursor and none of them takes records from the others. Alone on the
    port it sizes this process's own queue.
    `coaxial/fanout.py` is the ring: fixed-size records, a monotonic write
    sequence, and `take(cursor)` returning (blob, first, lost, next).
    Sequence numbers are monotonic and never reused, which is what makes
    "lapped" answerable - an in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
    [simulated.py]
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2026-09-01 Three of the four defects the review found
    **A round trip per frame.** `calibration.read()` was uncached, so every
    `frame(scaled=True)` fetched the channel trims from the board - eight a
    second in a live plot, for a record nobody had touched, on the link this
    tree spent a day widening. Invisible against the stand-in, where the call
    is local, which is how it survived. Cached now, with `refresh=`, and every
    writer here drops it: a cache the writers do not clear is worse than none,
    because it hands back a record the board no longer holds. Measured: five
    reads, one fetch.
    **The broker streamed from unit 1.** A broker serves a SEGMENT, and a
    hardcoded unit filled the ring from whichever node is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
    [simulated.py]
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2026-09-01 The observer's limit, measured against the firmware's own C
    tools/observer_run.py runs Drive/ built with the host gcc against the
    5230SL model: propeller loaded, 37 V, phase currents only. Two sweeps -
    q current, and PLL bandwidth.
    45 A holds, 230 krad/s^2 electrical, 5493 rpm, 12.1 deg
    50 A stalls at the handover, 58 A reverses
    PLL locks between 150 and 332 Hz; 600 Hz and up lose the rotor
    The limit is torque at standstill and a bandwidth window, not speed. The
    board's 100 A and the motor's 112.5 A are both far above it: a q-current
    step is the wrong way to start this machine.
    Two defects were in the tool, not the firmware. The polarity pulse was
    never called - injection finds the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
    [simulated.py]
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2026-09-02 Eleven examples cleaned and ported to executed notebooks
    python_examples/ is gone; notebook_examples/ holds the eleven as real
    notebooks, executed against the stand-in and checked in with outputs, so
    they read without running. The cleaning: argparse became tunables at the
    top, nothing writes image files any more (the NTC example littered the
    repository with pngs), the stale "read() is one reply" comment now says
    why the raw drain is the right idiom after stop(), and loss_calculation
    reads the LTspice model when the submodule is checked out - CHECKED
    against coaxial.inverter so the two cannot drift - and falls back to the
    library copy, saying so, when it is not.
    Running them dry caught what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
    [simulated.py]
2026-09-02 The drive as three verbs, and six missions that fly them
    coaxial.motion on device.motion: stepper (HOLD as a microstepper - soft
    energize, slewed moves, the rotor dragged by the load-angle spring),
    servo (position over the A1335, corrected BETWEEN moves), velocity
    (sensorless under coaxial.loop - an ESC's contract). Each priced by the
    link and honest about it, none of them a second place arming lives.
    Three control lessons, measured before believed (FINDINGS): a per-pass
    position loop at ~25 Hz samples the spring's ~37 Hz ring aliased and
    pumps it through a pole slip - P and PD both; an inertia overstated five
    times is a loop gain of 2.5 and +900 rpm asked came back -1552; full
    current onto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
    [motion.py, simulated.py]
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2026-09-02 The slick sweep: one slew, self-carrying rows, the machine's own model
    What was below the bar, fixed in one pass. motion's slew walk existed
    twice - the stepper's move and the servo's correction are ONE loop on
    _Mode now. A Monte Carlo row carries its own bemf_only instead of being
    zipped to it by list order after the pool. run_tests defaults --model to
    'auto' - the capability pick this machine actually runs - instead of a
    hardcoded tag that asked an 8 GB card to test the 16 GB bench's model.
    Sample.__repr__ says 'raw -> mA' instead of dressing converter codes in
    the scaled unit: '-825 mA' sent a debugging hour after an 825-milliampere
    phantom that was 825 codes of standing offset. Close-Ses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
    [motion.py]
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2026-09-02 The dangerous paths: a trip ends the block, one rotor takes a lock
    What was hazardous to hardware, fixed and proven. Every motion verb now
    polls the fault the state reply already carried - a trip mid-energize,
    mid-slew, mid-correction or mid-spin raises with the board's own word
    and leaves the drive OFF, where before the loop kept commanding a downed
    stage for the rest of its block. The overload raise and the trip
    mid-spin have their own checks, and the aborted block's coasting
    flywheel taught the suite to reset the rotor between blocks.
    The stand-in's rotor takes an RLock (_rotor_locked on the eight touching
    methods, the same shape as Transport.request's): the DAQ reader thread
    reaches it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
    [board.h, board_daq.c, motion.py, simulated.py]
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2026-09-02 Every directory is lowercase now
    Board Comms Core Drive Drivers Filter Modbus Shtp Thermal and their
    Inc/Src, plus the datasheet folders, all read in one case - 195 renames,
    318 path references repointed across CMake, the C headers' own build
    instructions, the host suites' componentwise joins, the docs and one
    notebook. Vendor internals (drivers/CMSIS, drivers/STM32H7xx_HAL_Driver)
    keep ST's case, and CubeMX regeneration writes Core/ back into its
    generated CMakeLists - Windows resolves it either way; the note sits
    beside the never-add-sources warning. Verified: fresh configure, 81/81
    zero-warning link, the four C-core suites, simulated, structure and the
    full offline set green; thermal/test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
    [board.h, board_adc.c, board_angle.c, board_cal.c, board_clock.c, board_daq.c, board_drive.c, board_drive.h]
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2026-09-02 Four failures the relayed log named, each fixed at its cause
    Two are the same defect: a UL suffix that is 32 bits on ARM and Windows
    and 64 on an LP64 runner, so the host test computed in a width the
    firmware never has - the RTU character time and the model's LCG now say
    U and every target does the same arithmetic. Two are tests leaning on
    this bench: the pick-degradation check stubs the diff nonempty (a clean
    clone answered 'nothing has changed' before reaching for the daemon),
    and the /model refusal stubs the tag list (the refusal is under test,
    not the daemon's presence). The USB-VID port filter from the previous
    push took mcp/parity/bench from ~257 s each to under 2 s on the runner.
    Co-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
    [drive_model.c]
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2026-09-03 The observer chain in firmware, and the machine it is watching
    foc_montecarlo ranked five sensorless observers and the pair that won is
    now C. drive_observer.c runs beside the control loop on the same samples
    and drives nothing: a dual flux model with a PLL below 800 rad/s
    electrical, a leaking flux integrator with its lag put back above 3000,
    blended on the unit vectors between. It is a second answer to the angle,
    from different arithmetic, which is the only way a board with no shaft
    sensor on the machine it commutates can ask whether its estimate is
    right.
    Op 14 behind device 10 reports it, CMD_PROTO_MINOR 10. test_drive_core
    holds the C to the Python it was ported from at three speeds, a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
    [cmd_drive.c, drive.c, drive.h, drive_observer.c, machine.py, observer.py]
2026-09-03 drive_observer.c: include stddef.h for NULL
    CI went red on both Python versions and every listed suite passed -
    test_drive_core.py was simply absent from the list, which is what a
    CRASHED suite looks like once the log tail has scrolled past it.
    The file uses NULL and included only drive.h and <math.h>. The bench
    toolchain's <math.h> pulls stddef in; glibc's does not, so the host gcc
    on the runner refused three functions. Nothing about the code was
    platform-specific - the include was just never written down, and this
    machine could not tell.
    The other portable cores were checked for the same latent gap: every
    other mention of NULL under drive/, modbus/, shtp/, thermal/, filter/
    and comms/ is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
    [drive_observer.c]
2026-09-03 Thermal margins as thermometers, either side of the machine
    The SOA margins now stand in the gutters beside the drawing: six on the
    left - driver and phase per leg, the FET and the shunt beneath it - and
    four on the right for the board's own network, the die, the rails, the
    front end and the laminate. They are on opposite sides because they fail
    for different reasons and are read for different ones.
    EACH IS A TUBE, not a bar. The column runs the full height with the level
    rising inside it and the empty part drawn as every other dot, one side,
    nearly black. The tube is what makes the level mean anything: a column
    half the height of nothing is a number, a column half the height of its
    own cei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
    [machine.py]
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2026-09-03 The throttle looks inside its own band, in both models and the firmware
    The bench found it in the rotor observer: the estimator peaked hard, the
    stage tripped, and everything collapsed toward zero and stayed there. It
    reported `worst` 0.756 - nowhere near a ceiling - because the whole peak
    happened between two polls.
    Three faults in the stand-in, all of them the same shape. The envelope
    ran once per poll gap rather than once per step, so it only ever saw the
    aftermath. `STEP_S` was 1.0 s, chosen as a fifth of the fastest node's
    constant - the right rule for integrating and the wrong one for acting,
    since the ramp is the last 300 ms of a node's hold. And the drive was
    sampled once for the wh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
    [board_cal.c, board_limits.h, board_thermal.c, machine.py]
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2026-09-04 The placements settle two of the guesses
    `electronics/Coaxial 63100 Pick-Place.csv` is the authority on where
    things are, the way the parts list is on what is fitted. NTC1 sits at
    (99.62, 79.83) mm, and the V gate driver is 8.2 mm from it against 15.1
    and 17.7 for the two V FETs, 28.0 for the next driver and 29.7 for the
    nearest shunt.
    THERMAL_NTC_NEIGHBOUR IS CONFIRMED. U1V is the nearest power part by a
    factor of 3.4 over the next driver, so anchoring the V leg is right -
    that had been an assumption.
    AND THE ELEMENT FRACTION IS 0.30, NOT 0.50, AND IT IS GEOMETRY NOW.
    Two-dimensional radial spreading in a plate gives `f = ln(R/r)/ln(R/a)`
    with R half the short side of the placement extent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
    [Coaxial 63100 Pick-Place.csv]
2026-09-04 A servo arrives when it stays, not when it passes
    CI caught it on the first push after the check was made to report what it
    saw, which is exactly what that detail was for: "returned 29.84 deg under
    1.2 N.m at 3.0 A". The target was 30.0 and the tolerance 0.5, so the
    reading was true - and the conclusion was not. Three amps make 0.18 N.m
    on this machine, so the shaft could not have been holding against 1.2. It
    was being dragged past, and it swept through the target while the servo
    happened to be looking.
    ONE READING CANNOT TELL A HOLD FROM A PASS, so `Servo.to()` returned
    success for a shaft it could not hold. That is a library defect and not a
    test flake: a position servo that reports arriv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
    [motion.py]
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2026-09-04 The can is sized against its own band, which ends the toggling
    Adding a row to make space for the foot gauges made the can a row taller,
    so it ran into them again - and the fix looked like adding another row.
    An afternoon went into that loop. The height was feeding the thing it was
    meant to fix: `_Radii` took the whole box, so the can grew to fill
    whatever it was given.
    It takes its own BAND now - what is left after the foot gauges and
    anything written above them - and is centred in it. The can's size
    follows the WIDTH, the rows only change the air around it, and the foot
    is clear at every height from 18 to 26. Swept: 28 dots of radius down to
    twenty-four rows, and only below that does the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
    [machine.py]
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2026-09-04 The throttle stops asking a clamp to cool what it cannot reach
    The board's SOA margin read 38 % spent on a lukewarm bench and could
    never read less than 30. Measured on the stand-in: an idle board with
    nothing switching settles at 49.1 C on the MCU and 51.1 on the
    regulators, and against a 125 C ceiling from a 20 C ambient that is
    0.30 of the budget gone before the stage has done any work. Those three
    nodes draw the same watts at zero duty as at full, so a derate asked for
    on their account is a control loop with no actuator.
    soa_undriven_mask joins the calibration record at CAL_VERSION 11 and
    names them. The throttle, its ramp and millis_to_limit skip what it
    marks; used, soak_j and tripped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
    [board.h, board_cal.c, board_thermal.c, machine.py]
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2026-09-04 The block gets a module, and the drawings stop guessing glyphs
    coaxial/braille.py holds all 256 patterns of U+2800 and the words to ask
    for one: dots by coordinate or by the chart's own numbering, and the
    line-drawing names on top - row, column, corner, tee. Picked by hand at
    call sites the set stayed a handful and the corners came out wrong, and
    chr(0x28A4) in a view is a guess that has to be decoded before it can be
    reviewed.
    The corner is the glyph nobody checks, and it has two jobs: one the line
    ENDS at is a hook and one it falls THROUGH has to reach the cell's floor
    or it breaks against the row below. Both the caption leaders and the two
    foot strokes turn properly now instead of a run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
    [machine.py]
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2026-09-05 The board becomes a halftone with a lit rim, every page draws one gauge, and the bead trails its speed
    CI: the demo test launched the rotor observer with `python -P`, which
    arrived in 3.11 - on the 3.10 runner it was "unknown option", exit 2,
    four red pushes on one flag. Read off the commit comment the failure
    step posts. The flag is gone.
    BOARD ATTITUDE, judged in a raster of the frame rather than in glyph
    counts: the sampled ladder was a sparse lattice with row banding and
    brightness encoded twice. The face is an 8x8 Bayer halftone at dot
    resolution - four cells by two, sixty-four densities, fixed in screen
    space - over the light sampled per dot, with a density floor of 0.3 so
    the dark si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
    [machine.py]
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2026-09-05 Every page scrolls its instrument column, and the wake is lighter and shorter
    The box column's paging, the click on its arrows, the drag over it and
    the up and down keys were the rotor observer's alone - seven boxes did
    not fit its column. The bench asked for the arrows on every submenu.
    The paging is the template's now: stage.paged windows the boxes to the
    terminal's height and packs the last page from the end, frame_of calls
    it for whatever view draws through it and adds the SCROLL chip to the
    key bar only while there is somewhere to go, and run_view takes the
    arrows, the marker clicks and the drag for every view at once, with
    the state kept on the console the view draws through. The sessi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
    [machine.py]
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2026-09-05 The thermal observer's board is a braille halftone with its parts on it
    It was half blocks: one palette stop a cell, the nearest, and a circle
    stepped at the cell - "pixelly". Now each of a cell's eight dots is lit
    where the temperature under it clears the blue-noise mask the attitude
    face uses (raster.NOISE, shared), denser as it is hotter, in the ramp
    blended to 24 bits between its stops; the rim and the bore's edge are
    one dot wide, and the scale beside the board is two cells of the same
    halftone, blue and not black at its cold end.
    The parts are on it, from the pick and place: thermalmap.PLACED copies
    the file's coordinates, PNP_CENTRE is the board's centre in the
    exporter's frame, and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
    [ansi.py]
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2026-09-05 The thermal observer is a graph of twenty nodes that follows the copper
    The bench asked for the modelling taken to ten of ten given the target.
    Against the lumped-network class the papers put at ten percent the star
    was a six - one board node for a disc with a seventeen kelvin gradient,
    legs that could not warm each other, switching loss scaled with voltage
    alone, a constant junction, still room air behind a stator. Each is
    closed by adding to the graph: seven laminate patches off the outline
    and the pick and place, joined by one sheet conductance times boundary
    over distance, chosen so the V patch sees the camera's lumped 15.2 K/W;
    the hot swap a node with the bridge's own FETs; the motor a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
    [board.h, board_cal.c, board_thermal.c]
2026-09-05 The board identifies its own air path and laminate while it runs, and keeps what it learned
    thermal/thermal_ident.c: a shadow of the observer run open loop between
    samples with the sensitivity of every node to four scales on the
    record's network - air, capacity, spread, ntc - by finite differences;
    at each sample a Kalman step on the prediction error, gated at three
    sigma, with process noise and a covariance floor while UNCERTAIN. The
    seat is measurement-consistent and carries its own Jacobian. States
    UNCERTAIN / CONVERGING / STABLE from the covariance and the filtered
    innovation; thermal_ident_margin gives the envelope 0.85 / 0.93 / 1.0.
    Only air and capacity are online: measured against th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
    [board.h, board_cal.c, board_limits.h, board_thermal.c]
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2026-09-06 The margin is continuous on the doubt, the states are words, and nothing learned is kept
    The bench: take out the three steps 80 / 90 / 100 and scale the margin
    with the innovation normalised between 0.8 and 1, adjustable; keep the
    states as display; remove the writing and reading to disk.
    `thermal_ident_margin` is floor + (1 - floor) * (1 - doubt), the doubt
    the worse of the filtered innovation normalised from the thermometers'
    floor to three floors and each online sigma from its STABLE threshold to
    its prior. The innovation alone fails by arithmetic: a fresh board's
    innovation starts at the floor and idle never raises it, so a board would
    have had its whole span at boot against the bench's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
    [board.h, board_cal.c, board_limits.h, board_thermal.c]
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2026-09-06 A trip shrinks the envelope to 70 %, the spend is measured from the room, and the stand-in's operator re-arms
    The bench: now the SOA values died again in ROTOR OBSERVER; still bugs
    that send the values negative or divide by something small; it should
    trip the limits and push the SOA limit down to maybe 70 %, or some other
    graceful degradation.
    The death was the envelope working: on the tour the margin is at the
    floor after every room change and the demo's burst, 0.82 of the whole
    span warm, is over a ceiling in force at 0.8, so the latched stage was
    dropped and the drive stopped making current. The negative was the
    stand-in's spend, measured from a fixed 25 C and unclamped above one:
    in the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
    [board_limits.h, board_thermal.c]
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2026-09-07 The servo measures the ring it stands in, and the stand-in's rotor keeps its energy honest
    app_robot_arm had failed two runs in three since the two-reading arrival
    of 2026-09-04, and the notebook was not the fault. Measured with its own
    poses at three commits: no corrections needed at 8241489, single ones at
    3463277, alternating and growing ones at cbbfaa5 (+0.62, -1.03, +0.70,
    -0.57) until tries ran out. A 2 ms trace found the shaft ringing +-6.6 deg
    at 28 Hz right after the energise - a rotor released into the weakest
    current step under 0.01 N.m swings to twice its static deflection - and
    not decaying two seconds later.
    Servo._measure took nine reads over 0.2 s, 22 ms apart, which against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
    [motion.py]
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2026-09-12 The page and dbg.py pull an absent tag through one module, drawn from the daemon's numbers, and a failed preload speaks the daemon's words
    coaxial_ollama/pull.py streams /api/pull and draws it in Say's columns:
    24 braille cells at half-cell resolution, the percent, bytes of bytes,
    the layer's rate and what is left at it - rewritten in place on a TTY,
    a row at every status and every five percent off one, ASCII when the
    stream cannot hold braille; an error line is raised in the daemon's
    words, a cloud tag refused before any request. board_chat.ps1 runs
    `python -m coaxial_ollama.pull $Model` instead of `ollama pull` when
    the tag is not listed; dbg.py's start goes through cli.ensure_pulled
    (it r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
    [pull.py]
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2026-09-13 The link, the reader, the stage and the verbs read flat: the broker's ops are a table, the frame's bytes are named
    The broker's eleven `if op == ...` were one ladder in `_do`; they are
    eleven functions and one table, OPS, and an op it does not list is
    refused in words as before. frame_length sizes an ack reply through
    _ack_length, and a frame's fixed bytes are named where the transport
    frames them - HEAD_BYTES, CRC_BYTES, EXCEPTION - where the 2s, 4s and 5s
    were spelt out per line. transmit pays its gap in _pay_gap; the reader
    counts its rate in _count with the window and the smoothing named; the
    stage's interlock is _require_interlock; the servo's unwrap is _turned
    with TURN and HALF_TURN;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
    [motion.py]
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2026-09-13 The raster engines read flat and every frame is the same frame; a timed-out suite dies with its whole tree
    wireframe, ascii3d and machine: thirty-eight nested ifs -> 0, the last
    in the library outside replies.json_objects. The hot loops were folded,
    not called: the rasteriser's one-pixel triangle is three flat tests on
    `tiny`, the resolver's supersample takes its deepest hit with one
    conditional expression and its band pass is a comprehension, the gauges'
    owner is max(). What became a function sits outside the pixel loop or
    once per cell: the key light _key_lit, the ground _segment, the
    three-frame _vote, the wire cell and the deepened colour, the tooth's
    stub, the missing decimates. The cac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
    [machine.py]
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2026-09-13 One language in the files: what the bench asked, in English, and its words no longer echoed
    Every quoted request of the bench's, in Swedish - in FINDINGS, MODELS,
    TODO, CLAUDE.md, board_chat.ps1, the runner's comments, the dial, the
    thermal map and the views' docstrings - is now what was asked, in
    English. The measured model answers and the questions that provoked
    them are described the same way. The render bench's two panel titles
    and its two messages, the Build-and-flash task's question to the local
    model and the thermal compendium's sentence on radiation are English
    too.
    What stays in Swedish is data: the classifier's word tables
    (BOARD_WORDS, _BOARD_VERBS, _QUESTION_WORDS, _OTHER_ACTION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
    [pull.py]
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2026-09-13 The stand-in's state is declared, a transport says what it can do, and the stage keeps the scroll in a weak table
    Twenty getattr(obj, name, default) reads become attributes. The
    acquisition stand-in's noise pool, ladder and wall clock are set in its
    constructor beside the parts the board wires; the drive's hand-set PWM
    and its accumulated shaft and the power stand-in's period counter start
    at their zeros. Transport declares address and stream - only a broker's
    transport has either - so connect() and the rig's streaming read them;
    the stand-in board declares it has no transport; the observer reads
    board.rig, which both boards declare. The key reader counts its mouse
    reports from zero, the ren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
    [observer.py]
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2026-09-13 The tree's own imports are at the top where no cycle bites: ninety-three hoisted, thirteen kept by a cycle
    The 128 relative and tree imports left inside functions were tried one
    at a time: hoist it, import the module and the three package roots in
    a fresh interpreter, keep it if that works and put it back if not.
    Ninety-three moved - every view's screen imports, the runner's
    find_board, pick_tests and client, the chat's client and capability,
    the stand-in's drive, clock and imu, the library's motor, mesh,
    commission and protocol among them. Thirteen bit and stayed:
    coaxial_mcp.session and find_board each way, wireframe and
    orientation, board and the stand-in, broker and board. Also left wher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
    [motion.py, observer.py, sysid.py]
2026-09-13 The cycles taken apart, and the red run the last push went up with: a local import left in one branch, and the rig importing the MCP session at the top
    CI failed e9e9669 twice over. _switch_board kept a local `import
    find_board` in one branch after the pass hoisted the other, so the
    function's find_board was a local and the "nothing answered" path
    raised UnboundLocalError; the gate here had passed because the ollama
    suites narrow themselves and that check was not in the draw. And the
    pass had hoisted the rig's `from coaxial_mcp.session import
    open_session` to the top: with the session imported first - CI's order
    - the library's import walked back into a partially initialised
    session.
    The ri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
    [sysid.py]
2026-09-13 Silent swallows say so: forty-seven try/except-pass become suppress, the library's asserts become checks, bound lambdas become functions
    `try: X / except E: pass` says nothing about intent; `with
    suppress(E): X` says it. Forty-seven of them across the library, the
    server, the runner and the tools are rewritten - the exception type
    kept, the handler's reason kept on the with line. The library's two
    asserts, the CRC catalogue check at import and the dial's row count,
    are checks that survive -O, raising RuntimeError and ValueError; the
    blue-noise tool's likewise. Two lambdas bound to names are functions.
    The board's hasattr on a transport's proven_dispatch is an attribute
    both transports declar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
    [ansi.py]
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2026-09-14 The host's mirrors of firmware constants are held to the C every run, and the first run found two op names adrift
    test_structure reads the #defines off the C - suffixes stripped,
    arithmetic evaluated - and compares: seven named pairs (the winding
    split, the SOA floor in ppm, the accumulate bound twice, the ring, sin
    60 and two pi as drive_math.c rounds them), every DEVICE_*, every
    *_OP_* against the matching protocol enum by name and number in both
    directions, and the identifier's thirteen constants by name. A copy by
    hand that drifts is a wire that lies quietly; now it fails a suite.
    The first run found two gate-driver ops with the same numbers under
    different names, GAPRST and DUTYQ in cm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
    [cmd_gate_drivers.c]
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2026-09-14 The packages' broad excepts say what they catch: the link's faults, a model call's, an older board's
    Eighteen `except Exception` in the library, the MCP server and the
    model runner each carried a reason, and the reasons were three
    things. errors.LINK_FAULTS is the library's own errors and the port
    or socket under them; client.FAULTS is what a call to the daemon
    raises from outside the client; the MCP tools' OLDER_FIRMWARE is the
    link's faults plus the attribute and the key a newer question finds
    missing on an older board - the shape the runner's suites showed twice
    on their first run, a board double with no thermal observer and a
    system with no channel map. The port listing narrowed to OSErr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
    [errors.py]
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2026-09-14 The four largest firmware modules hold their state as one struct each: seventy loose statics become four objects
    The thermal glue had 26 file-scope statics, the IMU driver 18, the
    PWM stage 16, the drive glue 12. Each is one `static struct { ... } s`
    now, placed where the first stood, every doc comment kept on its
    member, every initialiser designated, every use s.name - 474 of them
    rewritten by a tool that refuses a file where `s` is already an
    identifier. A `static const` table is not state and stays in flash;
    the IMU's feature count moved above the struct whose array it bounds.
    The cost is -O0's: flash 197 856 -> 201 980 B, the struct's base plus
    an offset where a static was one address;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
    [board_drive.c, board_imu.c, board_pwm.c, board_thermal.c]
2026-09-14 The wire's shape is held to itself: each fixed reply's C writer and Python reader compared field for field, and the skew written signed
    A fixed-shape reply is one sequence of widths, written field by field
    in C and read field by field in Python, and until now the only thing
    holding the two together was the bench's parity suite over a flashed
    board. test_structure parses both: the handler's wr_* calls with a
    loop's body counted its bound's times, and the decoder's r.* calls
    through the reader's own vocabulary. Three pairs, three checks: the
    gate drivers' state, the drive's, the acquisition task's.
    The first run found one: the dead-time skew written as wr_u8 with a
    cast where cmd.h says i8 an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
    [cmd_gate_drivers.c]
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2026-09-14 The wire's other half is held too: every request's packed widths against the handler's reads, and the skew read signed
    The replies were held field for field; the requests were not.
    test_structure pairs them by the op's name alone - the dispatch table
    names the handler, the enums are held to cmd.h, the decoder names the
    op - and compares the handler's rd_* reads to the pack() widths: a
    field under an rd_left guard is optional, a loop over a count is its
    body that many times, rd_bytes is whatever is left. Sixty-odd ops on
    ten devices, one check a device; payloads built some other way than a
    literal pack are skipped and named.
    The first run found the mirror of the morning's drift: the dead-tim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
    [cmd_gate_drivers.c]
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2026-09-22 The bootloader's core: device 11's state machine over four calls, proven on a RAM flash before any register is touched, and the took byte is the wire's
    boot/src/boot_core.c is the bootloader's state machine - hold, who (a
    prefix search on the unique id), assign, erase, chunk, missing,
    verify, record, seal, go, state, dump, stay - over erase, program,
    read and say; boot/test/harness.c wires those to a two-megabyte RAM
    flash with 128 K sectors that refuses to program a word twice, and
    host/tests/test_boot_core.py drives it through gcc and ctypes: the
    whole exchange, chunks dropped and re-sent without a repeat programmed,
    seal refused before verify, the master dying mid-stream leaving an
    invali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
    [cmd_drive.c, cmd_gate_drivers.c]
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2026-09-22 The chooser's chat page pulls the picker's tag on its boot strip instead of dying on a tag ollama list lacks
    The CCC page ran the picker, which named llama3.1:8b on a card where
    the pulled gemma4:12b did not fit, and died in a traceback from
    require_model with the command to type as its last line - while both
    prompts had pulled through ensure_pulled since 2026-09-12.
    tools/show_chat.py goes through cli.ensure_pulled now, and the pull's
    rows go to the page's amber boot strip rather than to stderr under it:
    pull() takes a `rows` drawer, and the page's Strip sets the strip's bar
    to the layer's share and its bracketed text to the tag and the figures
    (Progress.figures(), the row minus its bar),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
    [pull.py]
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2026-09-23 The bootloader target: boot_main.c at register level, its own script and startup running from ITCM, the second image in CMake and CI, --boot in the flash tool, and silence as a user function's answer
    boot/src/boot_main.c is the whole hardware layer with no HAL: VOS1 and
    PLL1 for 160 MHz with HCLK and APB1 at 80 so the RS485 pair divides
    to exactly 10 Mbit (BRR 16), the pin table driven before anything is
    clocked, three polled USARTs with FIFOs on and no interrupt, the flash
    controller's erase and 256-bit program with every error flag cleared,
    a console ring that never blocks the wire, and the jump - the slot
    filled, the USARTs reset, the clock tree handed back to HSI at its
    reset values, msr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
    [boot_main.c]
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2026-09-23 The renderer is a subpackage, coaxial/graphics/: the nine modules of the split with engine, mesh, crew, raster and preload, the face art and the blue-noise mask beside them
    The bench, on to the loader: a common with subfolders for graphics, the
    Kalman filter, and everything else. The first subfolder is the one with
    no history to lose. Fourteen modules moved by git mv and every import
    repointed by script: inside the package a sibling stays `.` and the
    library becomes `..`; a library module reaches a moved one through
    `.graphics`; a tool, a test or the front page through
    `coaxial.graphics.X`; the front page's child is `python -m
    coaxial.graphics.preload`. Twenty-five files repointed; one alias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
    [machine.py]
2026-09-23 The target's comments cut to what a reader fixing or extending needs: a block's first sentence, a field's first clause, a header's first paragraph - 4 154 lines, every number kept
    89 files under board/, comms/, boot/, modbus/, daq/, drive/, thermal/,
    filter/, shtp/: 28 853 -> 24 699 lines; the rationale and the history
    they carried are FINDINGS' record, and the 28 numbers found in no
    document are written there with the sentence each stood in. Built both
    presets, 0 warnings; every core suite and the structure suite as before.
    The cut is scripted, so it is the same rule everywhere.
    [board.h, board_adc.c, board_angle.c, board_boot.c, board_cal.c, board_clock.c, board_daq.c, board_drive.c]
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2026-09-23 One definition each, and nothing CubeMX regenerates is edited
    - boot.h holds the flash map and boot_header_t; boot_main.c, the harness,
    board_boot.c and board_cal.c use them. boot_main.c takes CMD_DEVICE from
    cmd.h. coaxial/boot.py holds the host's copy, held to boot.h by ten
    mirror pairs (the mirror check now reads hex).
    - board/boot.h included itself instead of the bootloader's boot.h: renamed
    board/handover.h.
    - VTOR and the ITCM copy move from the startup into Board_Early(), called
    in main.c's USER CODE BEGIN 1; startup_stm32h753xx.s is CubeMX's text
    again. A regenerated linker script without .itcm fails the link.
    - "/** <" trailing markers from the comment cut fixed to "/**<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
    [board.h, board_boot.c, board_cal.c, boot_main.c, drive.h, main.c]
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2026-09-23 Comments, docstrings and scripts cut to their first sentence, everywhere
    - Host Python (215 files): 79 492 -> 70 998 lines. Every multi-line
    docstring to its first sentence, every comment run to its first
    sentence. Kept whole: tools' module docstrings (argparse help), any
    docstring with a backslash, ansi2png's (it prints paragraph two).
    screen.py's re-export list restored (the unused-import check reads it).
    - PowerShell, CMake, workflows, linker scripts (28 files): 5 146 -> ~4 300.
    PowerShell help keeps every keyword. Linker scripts: only comments that
    start a line - `*drive/src/*.c.obj` holds a `/*` and the first cut broke
    the link.
    - main.c: comments inside USER CODE blocks o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
    [ansi.py]
2026-09-23 Rotor observer on a large terminal: a line stays two dots, and a tooth's undriven length is track
    At 200x60 the can is 95 dots (tuned at 21). The ring stroke grew to 3.0
    dots half-width; capped at LINE_MAX 1.0 (0.8 broke into dots). The two
    pulled phases floated 16 loose blocks; the rest of each tooth is TRACK,
    kept out of any cell an area holds. Rasters at 200x60, 120x40, 52x24.
    views 235, structure 767.
    [machine.py]
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2026-09-23 Target code, comments and docs agree: a record parameter count, the SPI4 clock, the bootloader's waits, and comments back on their declarations
    - BOARD_CAL_PARAM_COUNT stayed 46 after the winding's ids 46-48 (CAL_VERSION
    12): settable, never reported by cal op 8. Now 49.
    - SPI4's kernel is APB2 118.75 MHz, not 100: A1335 at /64 = 1.86 MHz.
    - The master now waits as the bootloader works in its receive path: erase
    2 s a sector, 2 ms a chunk, verify 2 s, seal 3 s (were 50 ms settles and
    a 0.5 s timeout).
    - Seven comments pointing at text the cut removed made self-contained; ten
    that the header split left on the wrong declaration moved back.
    - PROTOCOL cal op 8 row, BOOT waits, STO keepa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
    [board_adc.c, board_imu.c, board_limits.h, cmd_imu.c, imu.h]
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2026-09-23 Pole pairs from the command's travel and the shaft's together, counted after the pull-in: 21.00, not 20.80, and no longer at the mercy of a busy runner
    The walk compared the shaft's travel over a wall-clock interval with the
    nominal travel, so the rotor pulling in from its rest angle read as 1 % more
    shaft and a loaded CI runner pushed it past the 0.25 limit (834519a, host,
    Python 3.10). Both travels are now sampled together and counted after the
    first quarter of the walk: 21.00 on 8318_21p idle and with six cores busy.
    Sensorless 138, structure 777.
    [observer.py]
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2026-09-23 The ADC noise read and the burst share one Welford accumulator
    Board_AdcNoise and Board_AdcBurst each carried the running mean, spread
    and extremes inline; welford_add/welford_sd hold them once, and the burst
    writes a channel's extremes with its mean at the end. Same arithmetic in
    the same order. Debug and Release builds 0 warnings.
    [board_adc.c]
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2026-09-23 Five copies in the target said once: port lookup, refusals, sections, cal reads
    A scan for repeated five-line blocks found them. board_port (board_hw.h)
    replaces the rig's A-K lookup and board_io's, which fell back to port E
    for any letter past D; compares_refused gives the three duty setters
    their two refusals once; rd_sections reads a filter's biquads for ops 7
    and 9; cal_row and read_row carry the zero's and the span's prologue and
    the uncorrected read. Same bytes on the wire, same refusal text. Debug
    and Release builds 0 warnings.
    [board_adc.c, board_hw.h, board_io.c, board_pwm.c]
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2026-09-23 The application runs from D2 SRAM; flash keeps a sealed copy, the CRC the gate
    On the bench's word: the image loaded into RAM where it fits, flash only
    behind a checksum. It fits - 201 K Debug, 135 K Release in the 288 K of
    SRAM1..3, which nothing used. The app links at 0x30000000; the store at
    0x08020000 is a seal word ('SEAL', size, crc, type) then the image, the
    seal programmed last. erase keeps an image RAM holds or copies one the
    store holds; seal [u8 flags] persists only where the store holds another;
    boot_ready at reset runs RAM's image (warm) or the store's copy, each
    after its CRC. The bootloader also serves Modbus on the ST-Link's port
    at 115 200 and enables the D2 SRAM clocks. sta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
    [board_boot.c, boot_main.c]
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2026-09-23 Seven modules say their facts and numbers once, code byte-for-byte unchanged
    thermal, shading, machine, simulated/power, thermalmap, dial and the
    thermal observer view: each tuning history (density 0.3 -> 0.12 -> 0.42,
    outline lift 2.5 -> 4.5 -> 3.0, the tour's cap, the leg's K/W) is now the
    value, its measurement and what was rejected, in a line or two; the
    tables stay (the leg-to-board estimate, the NTC's geometry, the bore's
    shapes). Checked mechanically per file: the syntax tree with docstrings
    removed is identical. Put right on the way: `_dots` said Bayer where the
    mask is blue noise; a six-row header note sat over a four-row constant;
    orphaned notes whose constants had moved. 4431 -> 3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
    [machine.py]
2026-09-23 The library in folders by function: comm, devices, acquire, model, control, draw
    53 modules out of coaxial/'s root into six packages, each with a one-line
    brief; imports absolute. Paths that count parents followed the move
    (broker's .session.addr and spawn, boot's build/, orientation's STL).
    run_tests' TOUCHES names graphics/ for engine, wireframe, mesh.
    [ansi.py, capture.py, farm.py]
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2026-09-24 terminal/ui/: stage and screen in parts - console, aspect, marquee, rate, scroll
    screen 837 -> 334 (+ console 423, aspect 99), stage 727 -> 332 (+ marquee
    200, rate 68, scroll 153). Every name is imported from the module that
    defines it: screen no longer re-exports stage (its comment listing the
    names had kept the unused-import check quiet). _RECORD is built beside
    _console_records. BOARD ATTITUDE, the angle and the thermal observer bind
    aspect/console as _aspect/_console: they use those words for locals.
    show_thermal_observer's `with` had lost its line break; parenthesised.
    [ansi.py]
2026-09-24 run_tests in parts: suites, scope, runner; 861 lines -> 232
    suites holds the tables and TOUCHES, scope what a change reaches and the
    model's pick, runner one suite's process and tally. run_tests keeps the
    arguments, the run and main, behind its own bootstrap. test_ollama_runner
    binds suites as table: it names its picked lists suites.
    [runner.py]
2026-09-24 coaxial_mcp/tools in parts: schema, names, bus; 815 lines -> 345
    schema: the tool list and argument coercion; names: loosely named channels
    and pins resolved; bus: devices and link. tools keeps the board handlers
    and HANDLERS.
    [schema.py]
2026-09-24 Coaxial63100 in three: the session in rig.py, the task and the stream as mixins
    rig.py 1027 -> 338 lines: open, close, own image, AFE, gates, lookups.
    acquire/task.py (Task): channels, configure, pick, outputs, frames,
    columns. acquire/stream.py (Stream): start, stop, the host reader, blocks,
    times. SENSOR_FIELDS/WORDS go with Task. The unused-import check is AST-
    exact now (a name in a comment no longer counts); it found seven in
    rig.py and one each in motion.py and test_ollama_runner.
    [motion.py]
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2026-09-24 Device roles: Endpoint, Input, Output, Controller, Regulator, Estimator; the AFE first
    coaxial/devices/roles.py names the verbs every device shares: state,
    configure, fault, clear; read, trigger; write, on, off, is_on, trip, hold,
    resume; move; step, reset. The AFE is an Output: afe.on()/off()/write(on)
    replace enable/disable/set, here and in the stand-in, which shares the
    base. The tests' own third stand-in AFE is gone; they use the library's.
    [roles.py]
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2026-09-24 The inputs on the verbs: sensors, the capture ring, the clock, the DAQ as a Stream
    roles: Stream (start, stop, collect) and hold/resume on every Endpoint.
    Acquisition is a Stream; the rig's mixin is TaskStream and collect/Run
    live once, in roles. IMU and A1335 (ImuSensor, AngleSensor, shared with
    the stand-ins): read() is the loop's reading (quaternion, degrees);
    configure(reports, reset) and configure(register) replace
    `with configuring(): feature()` and poll_register; peek/poke are the raw
    ops. Capture is a Ring: start(*sources), stop(), read(count). Clock is a
    Timebase: trigger() latches, read() reads; probe and sync live once, so
    the stand-in no longer borrows them by cast.
    Co-Authored-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
    [capture.py, roles.py]
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2026-09-24 Thermal an Estimator (read, reset, one configure), Calibration an Input and Output (write), Link.state(port)
    The MCP link op is state; the gate counts crashed suites.
    [observer.py, roles.py, schema.py]
2026-09-24 The controller from parts: Loop(source, sink, regulator, estimator, prefilters), Paced, a notebook
    Filter, Estimator and Regulator are parts with fixed step signatures; motion.velocity
    is a Loop of SpeedPI over the drive's observer; test_controller joins at 12 %.
    [controller.py, motion.py, roles.py]
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2026-09-24 Notebooks checked against their own outputs; nothing kept a viewer cannot draw
    The panel carries a still; the builder strips widget views and state and keeps a
    picture once (png). Structure refuses a widget, stderr, a png+jpeg pair, a cell ending
    on a bare value. Prose fixed where the run said otherwise: applications' lane and gust,
    commissioning's trips, drive's throttle point (the model's 115 C, not 112.5), thermal's
    hottest node and minute, link's clients(), the stand-in's refusals in sensors and the
    power stage, acquisition's untared phases. Controller: a noisy sensor of your own for
    the Kalman to earn its keep (15.8 -> 4.2 rpm).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
    [controller.py, motion.py, panel.py, sequencer.py]
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2026-09-24 machine: the board-agnostic layer on its own; coaxial.node the family it loads
    host/machine/ holds roles, errors, controller, parts, sequencer, live, nodes,
    Machine, types as data, stand-in pack and camera, ansi, wiring, panel; nothing
    in it imports coaxial (test_structure holds it). Nodes.discover loads each
    installed family in FAMILIES (coaxial.node) and takes the boards it finds;
    Machine.discover(type, port, device) is the factory. A type wants actuators by
    kind; a node offers them (ACTUATORS). RigError is a MachineError.
    [ansi.py, capture.py, controller.py, errors.py, live.py]
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2026-09-24 The machine as an executive: a line plays once written, the writer woken with a line
    Live.feed takes an answer as it streams: each finished line is checked and
    queued at once (a block with jumps waits for its blank line); wait returns one
    line on low, a failsafe, a trip or a stop, with Machine.status(changed=True):
    'now t=.. name=value', what moved, in the program's own syntax. The buffer
    counts the chunk playing. Types name their failsafe. The board chat's program
    tool: start, send, wait, now, stop. Stand-in, 40 tokens/s: first move 0.21 s
    fed, 0.66 s whole; a wake 15 tokens. Unset outputs held what the node reads
    (every pass wrote 0: the pack's contactor opened). ctrl core in the pinned ti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
    [controller.py, live.py, machine.py, routines.py, schema.py]
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2026-09-24 host/ an installed package; harnesses in tools/cores; the tree Pylance-clean, no noqa
    - pyproject finds every package (machine, coaxial, terminal, tools, ...);
    pip install -e host/ is required (setup, README, CI). No sys.path code and
    no '# noqa' left in host/: tools no longer import tests - counts and TAGS
    moved to tools/dev, the gcc build and the drive/thermal harnesses to
    tools/cores, the render oracle to tools/render; REPO/HOST defined once in
    tools/__init__.py; setup probes gcc with python -m tools.cores.build.
    - pyright basic (Pylance's mode) 449 -> 0 over the tree and the notebooks:
    mixins declare what they borrow, abstract methods their return types,
    Optional handled at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
    [board_adc.c, board_angle.c, board_imu.c, board_limits.h, board_power.c, board_pwm.c]
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2026-09-24 Device 12 CTRL: the board's loop on the wire, rows streamed and held (MINOR 20)
    - board_ctrl.c ticks ctrl/'s runner in the drive's sample, before its step, every
    whole divider of PWM periods; measures the A1335 angle, omega_hat or iq and
    writes theta or iq_ref. No reading: the command stands (`blind`).
    - cmd_ctrl.c ops: 0 state, 1 slot (u8 slot, u8 kind, n x dec), 2 wire, 3 rows
    (all or none, 40 an op), 4 clear, 5 run. `dec` = i32 m, i8 e on the wire.
    - ctrl.c and board_ctrl.c in ITCM; fixed shapes in cmd_length.c and protocol.py.
    - coaxial.devices.ctrl: slot/load (a machine Feedback), wire, rows, drop, write,
    on/off. The stand-in steps the same machine.parts in a thread.
    - test_cont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
    [board.h, board_ctrl.c, board_ctrl.h, board_drive.c]
2026-09-24 Machine(node_hz=): a feedback its node runs, the host forwarding the setpoint
    - Actuator.LOOPS names the node module that runs a feedback; hand_over(f, hz)
    after arming, take_back() at disarm. Machine swaps the host's copy for a
    pass-through (Direct) sharing the measure, so reads and levels are unchanged.
    - Coaxial joint, surface, rotor, torque: device 12 measures angle, omega_hat or
    iq and commands theta or iq_ref; a node's `ctrl` module takes the setpoint.
    - Ctrl.write sends a setpoint only when it changes: a loop writes every pass.
    - test_controller: four legs squat on their boards, the down step on its level.
    [machine.py]
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2026-09-24 Craft clear of the board; a stop counts on the pass it is asked; the paper shows the handler
    - approach.craft: its pass keeps to the free side - in from its edge, turning CLEAR
    short of the board, diving away; no pass without room, no halo. The first at 3 s.
    - The sequencer runs the watcher before the handler's check: a stop asked on the
    last pass of a group still ends the run. Alarms.stop keeps and logs the first stop.
    - The sequencer paper: the handler beside it - an H logged, an operator's stop,
    cleanup run. alarms.py states what a handler of your own provides.
    [alarms.py, sequencer.py]
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2026-09-25 Thermal map as a thermal camera: ironbow ramp, teal lines; a lock whole or not at all
    - THERMAL_STOPS an ironbow in 24 bits: blue at -20 C, violet where the board idles,
    magenta, red from 50, orange, yellow at 80, white-hot at 100; 5 K apart through 25-60.
    - The map's rim, frames and labels in the instrument's teal, the rail's numbers ash:
    white shouted.
    - Chrome's lock is drawn with all four corners or none: half a lock read as broken.
    - tools/render/page.py tells a page that sizes itself off the terminal the size it
    draws at: the thermal map came out 80 x 30 in every capture.
    [ansi.py]
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2026-09-25 Coverage pass: the approach, the craft, the chrome, the stage, the view loop, the page tool
    - Dead code out: the corridor's no-gates return and its drawing without a segment (every
    caller passes one; now required); Chrome's, Crt's and Corner's unused measures.
    - Tested: the approach's and the craft's guards; the chrome's edges; every page on a
    terminal through the page tool; the console's VT switch and colour depth; run_view on
    scripted keys, Ctrl+C and a view's tick; Feed, open_rig, Freshness, say, steady,
    closing; the band's chips; the page tool's main and its no-frame error.
    - tools/dev/gate.py: the offline gate, or the coverage run, on a commit in a worktree of
    its own (build/g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
    [gate.py]
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2026-09-25 The firmware's wire on this host: comms/ over a fake board, as fakeboard://
    - board/fake: the board API on the host - every call answered neutrally (out-parameters
    zeroed, reads succeeding, settings taken), generated once from the prototypes - and the
    serial ports as a byte ring and a clock the exchange steps.
    - tools/cores/fakeboard.py builds comms/ (less the console, the test rig and the UARTs),
    the Modbus RTU slave and the portable cores over it, and serves it to pyserial as
    fakeboard://. Transport opens a URL as well as a port (serial_for_url); a URL port is
    named, never discovered, and this process's own - no broker.
    - tests/test_wire.py: a rig on fakeboard://, its version fro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
    [fake_board.c]
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2026-09-25 The record over a flash seam; the fake board runs it and the bench's conformance suite
    board/flash.h: the record's sector (where it maps, erase-and-program), board_flash.c
    the HAL half; board_cal.c portable over it. The fake board builds board_cal.c over a
    RAM sector (fake_flash.c), answers raw codes as the rail leaves them (mid-scale frozen
    off, noise on), refuses a span; fake_open brings the record up as main() does.
    test_conformance over fakeboard://: 96 passed, 0 failed, run by test_wire in a process
    of its own (children load the parent's DLL). board/thermal.h includes board/pwm.h.
    Both presets build, 0 warnings; the conformance suite over a flashed board is the rest
    of the proof.
    Co-Au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
    [board.h, board_cal.c, board_flash.c, fake_board.c]
2026-09-25 Every client verb over the firmware answers or refuses as the library's own
    test_wire sweeps fifty verbs over fakeboard://: a result or a coaxial.errors raise.
    It found the analog cooked reads (ntc_temperature, dcbus_voltage, phase_current) and
    read() indexing a burst reply blind - a KeyError where the reply lacks the channel,
    now a PayloadError. The fake's burst answers a row a masked channel; the burst limit
    is 32-bit (U, not UL).
    [fake_board.c]
2026-09-25 The thermal observer on the fake board; boot's data ops refuse in the board's words
    board_thermal.c builds over the fake: a board_hw.h of its own (the tick, off the fake
    clock), the observer polled as main()'s loop does, the dies and the NTC at room.
    test_wire's second sweep - daq, capture, clock, link, angle, boot - found who, missing,
    verify and dump parsing the application's refusal (u8 took 0, words; MINOR 18) as
    data: IndexError, or a wrong crc. Each now checks its reply's shape; the refusal is a
    DeviceStateError in the board's words, any other misfit a PayloadError.
    [board_hw.h, fake_board.c]
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2026-09-25 execution_mode HARDWARE | SIMULATED | EMULATED; the terminal and every entry on the emulator
    Coaxial63100(port, execution_mode=...) in place of simulated=, machine.modes defining the
    three, every caller moved: the family contract (Nodes/Machine.discover, coaxial.node), the
    views (screen.mode_of), the bench tools, the MCP program tool, the suites, the papers (the
    knob is MODE). emulator:// (tools/emu/protocol_emulator.py) starts Renode once a process and
    opens it wherever a port goes; the Transport names the schemes' packages. A URL port is this
    process's own: board._reach opened a broker process for fakeboard:// too, which held the
    fake board's DLL and left Renodes behind. The session says `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
    [controller.py, machine.py, modes.py, nodes.py, parts.py, sequencer.py]
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2026-09-25 10 Mbit/s on the emulated RS485 bus, byte for byte; a body a Renode per limb
    Firmware: the link drains every waiting byte a pass (LINK_TAKE_MAX), each at its own stamp,
    and a byte after a frame's silence closes that frame first - one byte a pass lost to a byte a
    microsecond. The ports read their shared clock once a pass, after their bytes; the keepalive
    edge is a BSRR write off its remembered level, no ODR read. Both presets 0 warnings.
    Emulator: the quantum 0.5 ms - bytes cross machines at its boundaries, and 1 ms broke every
    frame past t1.5; mips= for the core's own 475 M (FAITHFUL_MIPS), which a 10 Mbit bus needs;
    the limb's adapter paced at baud= and holding a new frame until the bus wa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
    [board_sto.c]
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2026-09-25 The emulated drive 16.5 -> 2.5 wall s a virtual s: main() skipped between handlers, the handler path trimmed
    The plant skips the core to LoopSlice (0.5 us) short of each timer event
    while an ADC waits on TRGO2: the handlers run whole at the part's speed,
    main() throttled; SkipTime keeps Renode's accounting where a mid-round MIPS
    change lost a third of the periods. CYCCNT and TIM1's count run on one
    virtual clock (VirtualClock.cs) that counts instructions, sleeps and skips.
    Firmware: Board_PwmReady and ARR kept once read; ADC3's injected end taken
    off HAL's handler (Board_SyncIrq) - ~35 -> ~15 register accesses a period.
    Paced emulators take the slice, the suites run main() whole. Each Renode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
    [board_pwm.c, board_sync.c, fake_board.c]
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2026-09-26 The virtual pendulum between her ears: how smoothly she walks, as one number
    - machine/pendulum.py: pivoted between her inner ears, a bob of her weight hung to her knees on a
    spring of no length of its own - it swings and bobs with one period, hearing the head alike every
    way; stir, its energy as the height it would lift her. A model only: the walker reads it, the
    director shows it
    - the walk's stir 3.2, 4.3, 4.9 mm at 0.65, 0.85, 0.9 strides/s, 78 % the head's surge; the torso's
    counter and the crane's damping take it to 1.7, but the rise flips on 0.5 % of any knob: both
    in, both off, until a search over disturbances
    - the page follows her at her mean speed (gynoid.Follow): her su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
    [director.py, figure.py, pendulum.py, running.py, walker.py]
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2026-09-26 machine.capture: the swing foot on the capture point, the side step, the walk begun again
    The capture point from the pelvis's speed, its course measured, the ankle
    holding what the course leaves of the sole, the foot 1.1 of the rest out.
    A swap is a side step: the swinging foot down ahead, the other out to the
    capture point foreseen once, the walk begun again on it at her speed.
    Landings take the height from where the body is, the forward target slewed,
    the phase capped; the first steps narrow over 0.6 s. Twelve trials: 73 %.
    [capture.py, director.py, walker.py]
2026-09-27 The side step's out foot set where the pelvis will be; slips re-anchored at 4 cm: 9 of 12 trials
    [director.py, walker.py]
2026-09-27 The side step clear of the other foot, borne only on the floor, a swap judged afresh; a catch out of reach a stomp
    [capture.py, walker.py]
2026-09-27 The emulated board held to the stand-in, read for read: one heat clock, one loss model
    tools/dev/ab.py runs a tty page on the stand-in and on an emulated MCU, a process a page,
    and marks a read missing, a range apart over the board seconds both cover, or a number the
    physics rules out. The thermal page went from 67 faults to 3 on native.
    - Thermal op 13 (MINOR 22): the observer's clock, coaxial.model.thermal.HASTE on an emulated
    MCU, set at the open together with its plant's; a step is 0.1 thermal s at any clock.
    - The stand-in's losses are thermal_power_estimate's (coaxial.model.thermal.power_estimate,
    held to the C); its held vector turns the phases, its compares follow its drive, its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
    [board_adc.c, board_limits.h, board_sync.c, board_thermal.c, native.c, observer.py]
2026-09-27 The torso's counter on at 3.9 degrees: the walks' stir 4.4 -> 2.4 mm; the scoreboard's shove at a fixed stride phase
    A CMA-ES search over the counter, the crane damping and the capture law
    found 5.9 against 8.2, but the damping felled the walk at 0.9 on a 1 %
    change and a 0.1 % change of any knob flipped a shove: landed at 5 s it
    met whatever phase the pace had brought her to. It lands as the phase
    first crosses 0.30 now; the counter alone holds 86 % against 84, margin
    and gain add noise, the damping stays off.
    [walker.py]
2026-09-27 The stance knee 16 degrees soft and the plan's dip eroded over 0.05: the pendulum's stir 2.4 -> 1.7 mm
    Read by stride phase, nearly all the stir went in at touchdown: the leg
    landed bent 23 degrees and straightened to 7 within 0.16 of a stride,
    lifting her 26 mm at 0.29 m/s to a dead stop, 6 m/s2 either way at her
    ears. Room in the knee and a dip nearer the body's own halve the peaks.
    [gait.py]
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2026-09-27 The stance knee 8 degrees soft, the heel strike 15 toes up, the height's recovery 0.03 m/s, the torso's counter off: the knee 9-29 through stance, the strike 1.55 -> 1.1 kN
    The counter nodded the torso 7.6 degrees a stride to hold the head's fore-aft to 24 mm of the pelvis's 65: the pendulum reads 3.5 mm for it now, held 85 %. The surge itself, the collision at touchdown, is the next target.
    [gait.py, walker.py]
2026-09-27 The floor's events in the shoves' place: a hole, a sill, a slip patch and a loose rug under her next step
    physics.World.terrain lays them; the floor a slab over a plane 3 cm down, the halves compiled over the whole span and cut (a geom grown or moved past its compiled bounds is missed by the broadphase), the sill and the patch mocap bodies, the rug a free body gripping the sole and sliding on the floor. The hole and the rug fell her, the sill and the patch tip her 6-8 degrees: held 93 %.
    [physics.py]
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2026-09-27 A drive's glitch on the scoreboard - the knee's gate dropped, the knee derated hot - and the swing foot landed on the capture point along the walk
    physics.World.glitch cuts a drive's peak to a share for a while. The cut knee gives 19 degrees and takes her weight again; the hot one folds, the pelvis sinks past the height latch and the other foot hangs from a target the body is not at (walked on straight it fell sooner). The landing on from the plan's spot by the body's speed over the plan's, over omega: the walks' stir 3.7 -> 3.5 mm, the rises held.
    [physics.py, walker.py]
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2026-09-27 The calf: the heel to 50 degrees at toe-off, its rise scaled by the stride, the stance knee 6 degrees soft - the walks' stir 3.35 -> 2.80 mm, the ears' bob 18 -> 12, the hot knee walked out
    With the foot landed on the capture point along the walk the push-off before the landing holds where it fell the walks before: held 90 %. The head's fore-and-aft stays 62 mm at the ears: the pelvis's 30 (the vault of a 1 m stride) doubled by the torso's 2 degrees of pitch; the phase run as a pendulum, a lead on the spine, a shorter stride, a planned landing dip, the latch let go and the bob's swing on the landing all tried and out.
    [gait.py, walker.py]
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2026-09-27 The drive's ISR without the library's trig: drive_sincos and an atan2 polynomial in the observer, an add-and-truncate for lrintf - 1 876 -> 1 445 cycles a period
    - drive_math.c: drive_atan2, an eleventh-order odd polynomial on the octant, 1.7e-6 rad worst.
    - drive_observer.c: the PLL angle's sin and cos once for the model and the error, the lead's
    and the blend's two angles through drive_sincos; flux_theta, the lead and the blend's angle
    through drive_atan2. drive.c: the HFI's error angle too.
    - board_drive.c: the compares' and the log's seven lrintf a period as an add-and-truncate.
    - FINDINGS: a period's 57 wall us on the emulator accounted for; real time under the drive is
    the ISR's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
    [board_drive.c, drive.c, drive.h, drive_math.c, drive_observer.c]
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2026-09-27 The lean before the first step is the body's: the pelvis tipped 4 degrees and the torso with it, the walker letting it out over 2 s; the drives' callouts docked at the viewport's edges with leaders t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
    Pushed 7 cm ahead with the torso plumb she read as leaning back before she stepped; a lean kept through the walk fell her to the slip and the hot knee (held 76 % against 90), let out it costs nothing (held 89.8 %). A stiffer spine steadies the torso's pitch but grows the ears' fore-and-aft (measured, FINDINGS). The callouts: the joint, its angle, torque bar and number, power bar, a leader to the pivot. Emulated is Renode (SIL); simulated a pu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
    [arrival.py, director.py, gait.py, walker.py]
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2026-09-28 Her walk made hers: the pelvis tipped 6 degrees under an upright torso from the rise on, the spine taking it back out and the fall's watch measuring from it; the arms swung from the forearm, near the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
    [arrival.py, director.py, gait.py, walker.py]
2026-09-28 The weight onto the left foot partly as the right lifts: SHIFT_IN 3.5 -> 5.5 cm inside the ankle, the stance hip rolled -2.5 degrees standing instead of -4.4 and the pelvis 33 mm across instead of 61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
    [arrival.py]
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2026-09-28 HUMANOID: R records her - every state the page hears, the page's yaw, each joint and each segment's place - and R again writes build/recordings/humanoid_<time>.csv; the view's reset moves to V
    [running.py]
2026-09-28 She no longer leans back before the first step: the torso leans as far as the shins while rising (a keyframe at 80 % of the height) and standing, and at the lean's 8 degrees from the weight's shift o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
    [arrival.py]
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2026-09-28 The seam's odd lean: the lean and the step moved the pelvis on at the shift's height, the standing knee planned straight and bent back 1.8 degrees under her while she tipped over it like a plank; the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
    [arrival.py]
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2026-09-28 Between the rise and the walk: she rises to the shift's height and stands still and straight through 6 and 7 (the torso 1.0, the pelvis -0.2 mm, where the knees bent 4 -> 9 and the torso bowed to 5.7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
    [arrival.py, director.py, running.py]
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2026-09-28 The ears' pendulum on at 0.1: the head 53 -> 48.5 mm fore and aft a stride, the strike 1613 -> 1115 N, held 81.3 -> 87.9 %; the shoulders' counter-roll kept as a knob at 0 (it cost the slow walk); lo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
    [walker.py]
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2026-09-28 Each of her boards keeps its heat and says it on the bus: machine.heat lumps thermal.c's envelope onto three nodes (the switches, the laminate, the winding; the 5230SL through a 1:64 cycloid), the bo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
    [buses.py, director.py, heat.py, physics.py, rtu.py, running.py]
2026-09-28 What she trips on, laid where her walk meets it (machine.events): a hole, a rug, a sill, a slip patch and a lace stepped on (World.tug pulls the lifting foot back), from the page on Ctrl H R T S L; l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
    [director.py, events.py, physics.py, running.py]
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2026-09-28 The page: the callouts compact and framed as the tty's instruments are - 20 cells a joint for 34, the name in four letters on a patch its drive's heat colours on the thermal observer's scale, those n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
    [events.py, physics.py, running.py]
2026-09-28 ROTOR OBSERVER at rest: the injection's estimate ran away three ways, each measured on native against the world's shaft. The current loop fed w lambda forward off it - at 2 V and l2 261 the demodulat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
    [drive.c, drive.h]
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2026-09-28 Her stance leg reaches behind her and she is dressed: the toe-off at 0.66, the ball planted at 0.24 and the stride 0.85 m - the thigh leaves the floor 6 degrees behind upright where it stood 1 ahead,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
    [gait.py, physics.py]
2026-09-28 Her jeans' wide legs hang from under her knees and swing on their own: in MuJoCo a hem of 0.12 kg on two sprung hinges below each knee (1.7 Hz, a quarter of critical, touching nothing), swinging -46.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
    [figure.py, physics.py, running.py]
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2026-09-28 Her head nearer her shoulders and human: the neck 2.5 cm shorter and fuller, the head a little larger with a nose, ears, eyes, lips and blonde hair; a bust under a looser tank, the jeans baggier over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
    [figure.py, physics.py]
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2026-09-28 CI's host red on 332a3fc (3.12): the views counted a FAIL and named none. A page drawn in-process leaves its footer or a screen clear on the line the next report lands on - 4 of 273 lines - and the r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
    [gate.py, runner.py]
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2026-09-28 The drive let go on a zero triple with MOE up - the three low sides on, a short across the windings: on native 865 rpm stopped in a second at 31 A rms, and from 1 979 rpm the short's first peak tripp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
    [board_drive.c, board_pwm.c, drive.c, drive.h, drive_model.c, native.c, world.c]
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2026-09-28 Her limbs collide and her feet keep clear: floor alone, her sneakers passed 22 mm into each other as she walked; colliding, a swinging foot is kept 90 mm off the other wherever their soles overlap, a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
    [director.py, figure.py, gait.py, physics.py, walker.py]
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2026-09-28 Her feet toed out without turning in: toed out with a small swing turn she fell (5/4, 6/6, 8/8 degrees) - the swing aimed its ankle while the landings recorded its ball, 12 mm wider at 6 degrees, and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
    [gait.py, walker.py]
2026-09-28 The rotor page's mark skipped a pitch, 51.4 degrees, at every electrical turn: drawn at the angle over the pole pairs, which the magnets' own pattern hid and the STEPPER's 2 rpm showed. The drive cou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
    [cmd_drive.c, drive.c, drive.h]
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2026-09-28 After a fall the walk began again with the pelvis still lowered as she fell, 12 cm, and her speed read from where she fell, 3.7 m back: after each restart she walked 8-10 cm crouched and a sole bore 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
    [director.py, walker.py]
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2026-09-28 She trod the air: the swing lifted her foot 130 mm over the floor and bent her knee 75 degrees. The swing now skims: the foot's least height - its heel's, ball's and toes' tip's, soft within 3 mm - i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
    Low, the swinging foot met the other's heel, toed out 8 degrees and 24 mm nearer the line than its ball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
    [capture.py, curves.py, figure.py, gait.py, landing.py]
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2026-09-28 From in front and behind her hips no longer swayed under her shoulders: with the pelvis turned 6 degrees her whole body swayed, the hips 60 mm across and the shoulders 41. The pelvis now turns 9 and 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
    [gait.py, walker.py]
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2026-09-28 Caught on her hands she held her arms out straight and toppled over them sideways. Her hands on the floor, her arms give under her over 0.6 s into her forearms - the elbows to 90, the shoulders to 11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
    [director.py]
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2026-09-28 QUAD in MuJoCo, seen in the tty's viewport: a 2 kg frame on four direct-drive 63100 rotors under APC 20x10E propellers, each a stand-in board armed on the master's pilot, sensorless, its speed loop o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
    [quad.py]
2026-09-28 A foot that meets something is lifted over it until its heel clears it, and the other foot with it: where a heel clears what was met is remembered (landing.over) until both feet are past it, each foo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
    [landing.py, stance.py, walker.py]
2026-09-28 The jeans' legs stopped where their cloth meets the leg and the sneaker, stiffly, and hemmed onto the vamp: swinging softly stopped at 14 degrees, they swung to 19 and the shin stood 35 mm out throug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
    [physics.py]
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2026-09-30 The gynoid sways her hips, not her bottom, and her jeans show the gap between her thighs. Turned 9 her pelvis swung 32.8 degrees a stride and rolled 12.5; turned 3 and dropped 7 it swings 16.7 and ro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
    [gait.py]
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2026-09-30 Falling, her drives' phases are shorted through the low sides: the legs' and trunk's as she goes, every drive once she is down - each joint gives kt^2/R of its speed back (140 N m s/rad an L joint, 3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
    [buses.py, director.py, heat.py, physics.py, rtu.py]
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2026-09-30 Her walk's style as knobs trimmed while she walks (machine.style): the pelvis's turn and drop, its planned shift, the torso's counter-turn, the shoulders held over the line. The HUMANOID page shows t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
    [running.py, style.py, walker.py, walkplan.py]
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2026-09-30 Falling, her arms catch her and give into her forearms by her face (director.YIELD, back), and hold it down, the neck too; the legs and trunk stay shorted. Five falls: 2 prone on their forearms, 1 on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
    [director.py]
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2026-09-30 HUMANOID page: gauges, a subtler seat and bust, the camera over the floor
    - Top row: still-walk-run and catwalk-swagger scales, S F and Z X
    (style.sway, running's 'sway').
    - The cheeks 6 mm proud inside the jeans, the bust 2 cm out and flattened:
    at 2.6 and 3.2 cm they read as too big and as spheres (the user).
    - drums.py and playback.py split out: gynoid.py 7.6 k of 7.4, show_humanoid
    6.3 k of 6.
    - The camera follows x and z (gynoid.Follow, the state's 'velocity'): up
    from a fall walking back the way she came, a joint came 2.38 m behind the
    lens; now 0.56 m off at most. The splat skips points behind the lens.
    [director.py, running.py, style.py]
2026-09-30 Get-up with her body colliding: knees open, the walker reset, a head IMU
    - The legs' capsules meet her trunk, head and arms (physics.LEG): folded
    over her knees the trunk went 42-45 mm in; on them the fold lost 3 tries
    of 3 until the knees open 30 degrees about each hip-ankle line
    (getup._swung), 7 mm in at most.
    - Walker.reset at the get-up's hand-over: kept from the fall, the walk
    after it held 6 s 2 times in 11 on a cleared floor; now 10.
    - Face down she rolls onto her back over the side her head's IMU finds
    lower (pose head_q*, getup.ROLLS_BY): rolled one way only, lain on her
    left she was sat up face down.
    - look.py: trunk gap, pelvis and head facing; the walk's columns in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
    [director.py, figure.py, getup.py, physics.py]
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2026-09-30 Her whole body collides; her get-up is a plan the observer checks, knees together
    - figure.BODY: every part a capsule of the drawn skin, on the floor and on
    herself; lying her arms went 40-43 mm into the floor and her shins 100
    through each other, now 2-9. The knees-open fold on it stood 3 of 12;
    gone, as the user asked.
    - machine.observer: how she lies (her head's IMU, her pelvis, her soles'
    load on the floor), what she touches, what felled her; each step's
    outcome checked. machine.planner: the steps a plan is made of; a local
    model's JSON held to them, a server after LOCAL_TRIES, else its own.
    The director plans once she lies still, re-plans on a failed step.
    - The kneel rout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
    [director.py, figure.py, getup.py, observer.py, physics.py, planner.py]
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2026-10-01 Falling, her arms toward the way she tips; the floor's boxes 0.2 m deep: 13 of 13 falls up
    - The waist turns her torso toward a tip past 20 deg off her front, all of it past 35
    (falls.turn), at once: the reach's median off the tip 45 -> 5 deg (hole), never out -> 10
    (rug); turned toward the lace's dive too, her head met the floor at 1.5-2.5 kN in 6 of 6.
    24 falls: the head touched in 12, 688 N at most (unturned, waist shorted: 10, 1170).
    - An arm landing past the 3 cm slab's middle was held inside it at 15 kN, 2 falls in 13 never
    up: slab, sill and patch reach floor.DEEP_M under the floor; 13 of 13 walk again.
    - look.py's reach off fall runs until an arm lands.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
    [director.py, falls.py, figure.py, floor.py]
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2026-10-01 Pads where her falls land: 5 mm of gel at the elbows, hips and knees, judged on 12 falls
    - Placement from 26 bare falls, each segment's first 0.2 s on the floor (tools/sim/landings.py
    where): the elbow's point 3068 N s, the hip's front and side 2800, the knee 1300; the rest
    under 240. figure.PADS, 5 mm proud; the knee's a capsule across its front (on spheres, knees
    under rolled her 22-84 deg, 5 of 12 up).
    - Gel (physics.PAD_*) from a 54-point grid: median landing peak 5.99 -> 5.32 kN, spread
    3.00 -> 2.53; stiff (0.005 s) it bounced, median 19.6.
    - test_her_pads: dropped onto her knees, 100 % through the pads, 1174 N a knee where bare 1348,
    6.2 mm of give where 5.1.
    - Onto feet re-s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
    [director.py, figure.py, getup.py, physics.py, planner.py]
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2026-10-01 Shoved sideways she parries: the shove seen, the swing hurried, a crossover step
    The capture point past a standing foot's outer edge is a shove (landing.shoved); catching or
    shoved the phase runs 0.32 faster; the swinging foot crosses over in front of the standing one
    up to 15 cm (capture.CROSS) and steps no wider than 0.3 m; a catch down early begins the walk
    again on it; the arms rise 15 deg (machine.parry). The fall is read on the head's IMU. Fixed:
    a restart's phase wrapping into the swing, a foot held in the air riding the pelvis's error,
    a stale catch restarting the other foot, no catch for 2.5 s after one.
    Shoved 30/60/120 N, 48 times each: HEAD held 33/10/1, now 38/21/0; the scoreboa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
    [capture.py, director.py, events.py, landing.py, parry.py, stance.py, walker.py]
2026-10-01 Her back has stops; the scoreboard in three: the walk, the parry, the landing past saving
    Down after a sill her spine bent back 98-101 degrees, shorted and stopless: now the spine
    -30..85, its roll and the waist 35 and 50 each way (physics.STOPS), 31-37 back at most.
    gait_montecarlo: a walk on its look and its power drawn (ENERGY_K past 300 W, 482 at 0.85
    strides/s), its falls ignored; an event, the 60 N nudge among them, on its falls (FALL_K the
    share, the heaviest); the page's 120 N shove on its landing (LAND_K a kN of her body's peak,
    HEAD_K of her head's). As it is: 247.8, held 76.7 %, the shove's landing 6.0 kN, the head
    none. The CMA-ES in tools/sim/cmaes.py.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
    [physics.py]
2026-10-01 Past saving she crouches as she goes: a lunge, the other knee down, shorted once down
    Falling, her legs and trunk are driven at once into a crouch (falls.crouch: the side she tips
    to lunges, the other kneels, the spine 25 forward) and shorted only once down. Shoved past
    saving 16 times: her peak on the floor 8.7 -> 6.2 kN at the median, 11.0 -> 10.0 the worst,
    a shank first 8 -> 14 times, the head never; held on once down 6.7 and 12.0, the head down
    once. She still ends on a side: the fall is called 0.06-0.25 s before the floor.
    test_a_fall_past_saving_crouches.
    [director.py, falls.py]
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2026-10-01 Lying shorted she drew 794 W: the short's damper flipped an ankle each step at 500 Hz
    A shorted drive's kt^2/R stepped as a torque against the joint's speed, 140 N m s/rad on an
    ankle's 0.05 kg m^2, overshot every 1 ms step: +-140 N m at its clamp, the speed +88/-62 deg/s,
    500 Hz, the page's draw 443-917 W as she lay still. The short is now the joint's own damping
    in MuJoCo (dof_damping, integrated implicitly), its torque 0; a board's windings still heat
    from the braking (machine.buses). Lying she draws 72-77 W, the boards' 68 their own.
    [buses.py, physics.py]
2026-10-01 Her get-up without waits: plans at once, a curve through the keyframes, steps ended on their outcome
    The house plan runs at once and a model is asked in the background, its plan taken at a
    step's end where it differs (the chain leaves it only whether to straighten out first): on
    the page she lay still 4-9 s for gemma's plan, and a failed step's plan stalled the loop as
    long. Still 0.3 s before she begins (1.0); the unfold, roll and crouch held 0.2-0.3 s after,
    not 0.6-1.0; the knees under and the sit back end on their outcome, as onto feet did; the
    roll at 0.75 of its time (the hip and knee 254-290 deg/s, at 0.6 337). The stream is a curve
    through its keyframes (getup._curve: Fritsch-Carlson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
    [director.py, getup.py, observer.py]
2026-10-01 The falls suite sharded on a fresh checkout: CI ran it whole, 532 s, and cut it at 300
    The runner shards a suite by its recorded seconds (tests/.counts.json, not committed): CI
    had none, ran test_gynoid_falls.py as one job and crashed it at 300.1 s on 8a4492d through
    e8b3201. suites.FRESH_S gives its seconds where none are recorded: run so here, 35 passed.
    [runner.py]
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2026-10-01 Her get-up's curve on from where she is when a step ends early; the sit-back over 0.6 s
    A step ended on its outcome skipped to its mark with the curve laid from its own keyframe:
    a hip's setpoint jumped 15-21 deg a pass into the sit and the lift, now 0.5 and 0.3 at most.
    The sit-back's first keyframe over 0.6 s, not 0.3: the neck 866 -> 520 deg/s, a foot 3.9 ->
    2.8 m/s; 16 falls of 16 up, 21.1 s from the fall to walking. The TODO gone through: its
    get-up lines rewritten to what is left.
    [getup.py]
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2026-10-01 The drives as built, switchable: rotors fed forward, gearboxes as bodies with their drag and ratings
    Rolling-element wave drives (estimated): each joint's drag through its ratio as frictionloss
    (BACKDRIVE), the assemblies placed as bodies where they sit, their segments the lighter, 55.29 kg
    either way (PLACED); a board feeds its rotor forward on its setpoint's acceleration (ROTOR_FF):
    at L 1:30 with the rotors in, the hip's peak error 36.5 -> 17.6 deg, the knee's 38.7 -> 20.3.
    World.geared keeps each gearbox's peak torque; a fall past saving costs GEAR_K past its rating.
    M and S rewound to KV 140 and 160, the same copper a N m^2; the elbows and the neck on M.
    The figure's XML in machine/mjcf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
    [buses.py, drives.py, figure.py, mjcf.py, physics.py]
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2026-10-01 Her body as built is the default: 35.4 kg of carbon shells, L 1:30, M and S 1:40, rotors and drag
    From the squat 16 s: the strike 696 N against 1231, no catch; 30 s on built boards without a
    derate, the hip at 94 C. The nudge 38 N, the 60 N's push speed on 55 kg: held 10 of 16. Down,
    she draws in 1.0 s on, her head level (falls.TUCK: chin in, her head met the floor at 1.01 m/s).
    The roll re-searched as built: face down from flat on her back in 5.46 s against 5.11.
    Fall checks: a late catch fails only if she fell; her head no faster than 1 m/s (0.72);
    a limb or her seat first, never trunk or head; the felled flag no longer always true.
    Suites: gynoid 21, faults 9, falls 35, controller 106, si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
    [build.py, director.py, drives.py, events.py, falls.py, getup.py, physics.py]
2026-10-01 A touch of backlash: each board sees its joint through its gearbox's 0.1 deg of play
    The A1335 reads the motor's shaft: the board's angle, its PD's and its reply's, held within the
    play's half (buses `play`). From the squat 16 s: the strike 719 N against 693 without, the head
    fore-aft 33.6 mm against 36.5, no catch. Suites: gynoid 21, faults 9, falls 35, 0 failed.
    [buses.py, drives.py, physics.py]
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2026-10-01 Nonlinear linkages: the knee's and ankle's ratios over their strokes; every drive bound by its back-EMF
    drives.STROKES: the knee 1:36 standing and folded, 1:28 swinging; the ankle 1:36 through
    -25..25 deg. Each step the host gives the boards a curve joint's ratio over its size's - its clamp
    and amps a N m by it - and MuJoCo its rotor seen, drag and short. A board's q current no more than
    (V/sqrt3 -+ back-EMF)/R: motoring the EMF takes, braking it adds - clamped both ways a fall lost
    its brakes, her head down at 2.58 m/s. As built: 16 s from the squat, the strike 753 N; 30 s on
    built boards, no derate, the hip 95.9 C; the crouch's landing 3.0 kN at the median.
    M draws her as a kinematic stick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
    [buses.py, drives.py, physics.py]
2026-10-01 Her hips' drives on the pelvis, rods to the femurs; falls read on her trunk
    - hip in the seat behind the joint, hip_roll on the pelvis's side over it,
    L at a flat 1:36 through 1.6 rods; mount() side-correct. Pelvis 10.50 kg,
    a thigh 2.43, she 36.01. Walks 16 s from the squat; 30 s no derate, the
    hip roll 109.7 C.
    - Falling and down read on the trunk: the head's IMU less the neck's and
    head's joints, within 0.071 deg of MuJoCo's torso walking 8 s. Shoved past
    saving her head met the floor 0 of 16 (2 at 1.75, 3.57 m/s on the head's
    read); the parry 10 of 16 either way.
    - falls 35/35, gynoid 21, faults 9, structure 1382; the gate 4105 passed,
    test_mcp's 10 and a crash on the bench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
    [director.py, drives.py]
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2026-10-02 Her quick-releases in her shell and her stick figure
    - build.RELEASES: each limb's collar, one table for its mass, the mechanism's
    collar, the shell's polymer band 1 mm proud and the stick figure's wire
    collar, its bone broken 6 mm clear either side. The arm's 50 mm down,
    under the shoulder's 70 mm drive; the leg's 65 mm down.
    - The leg's stands 15 mm into the knee drive's top: the drive 35 mm lower
    felled the rise to the walk at 6.5 s (0.012 kg m^2 more swinging) - kept
    where it is, in TODO with the hip's gimbal.
    - gynoid 21 (bare: a band a release), render 146, views 29/71/24/7.
    [build.py]
2026-10-02 Lying still she holds nothing; the page counts each board as it stands
    - Given up and still, every drive shorted, armed again if she moves:
    lying, 102 W -> 33.2 W, the 25 driven boards' housekeeping (1.33 W each;
    1.4 measured idle). A shorted board switches nothing.
    - World.drawn: work, copper, housekeeping each, switching unshorted - the
    page's watts (was 27 x 2.53 W always), look.py's 'drawing', the
    recordings' 'watts' column.
    - falls.SOFT_DEG 5 -> 10: at 5 a shove's arms folded 30 -> 157 deg in 0.15 s
    and her head met the floor at 2.46 m/s; at 10 and 15, 0 of 16.
    - mjcf.HIP_YAW_DEG, the hips' yaw stop for the gimbal's trial: at 25 the
    scoreboard 248 vs 238, held 81.0 %, 3 get-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
    [director.py, falls.py, heat.py, mjcf.py, physics.py, running.py]
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2026-10-02 Her build as modules: outrunners on printable two-stage gearboxes, boards apart
    - drives: L, M, S an outrunner on a planetary into a ball stage (BALLS
    12/12/10, 8-12 mm balls), the boards out of their stacks; L wound 1.25,
    137 -> 171 N m: from the squat 30 s where she fell at 9.45.
    - down: braked, cut once still, each bus's boards checked: lying 33.2 W.
    - the knee's drive on its axis, the hip roll's on a 1.67 spur pair, drawn;
    femur and tibia hung from their gearboxes' collars; the calf rod bent
    down the calf's inner back: clear over fit's 45 poses, 5 mm of her jeans.
    - the roll pushed by the arms: face down and knelt from all ten starts.
    - her shell as printable panels; quick-releas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
    [arrival.py, build.py, buses.py, capture.py, director.py, down.py, drives.py, figure.py]
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2026-10-02 Her ball stages laid out for the wave reducer tools, the gearbox drawn full width
    - One eccentric, ring fixed, cage out at lobes:1, each race a stock bearing:
    L 11 x 12 mm balls on a 6005, e 0.92 mm, ring 69.2-72.8 in 80; M 11 x 8
    on a 6805, 0.77, 51.5-54.5 in 60; S 9 x 7 on a 6900, 0.55, 34.9-37.1 in
    42; pressure angle mean 13-15, at most 21-22 deg. On 9 and 8 mm balls M's
    and S's rings kept 1.75 and 0.4 mm of wall.
    - mechanism.GEAR_RADIUS 0.8 -> 1.0: the ring as wide as its motor.
    - The walk's retune in TODO: 535, 64.5 %, the parry 1 of 8 where 2.
    [drives.py]
2026-10-02 Her skeleton in MuJoCo, colliding: drums, boards, bones, boom, rods, spurs, belts
    - machine/skeleton: 52 geoms as welded massless bodies riding her
    segments, her weight unchanged; MuJoCo's parent filter off (it takes a
    welded part for its segment), each segment kept from its parent, the
    skeleton from its segment's neighbours' skins (the squat put a hip's yaw
    45 mm into the thigh's capsule), and what touches standing or in the
    squat she lands in. A step 0.184 -> 0.212 ms.
    - physics.SKELETON off: walking, the ankles' cranks 50-60 mm inside her
    shins met each other 2-6 mm deep and she fell in 1-3 s; outside, the
    thigh's boards meet them sat back. gynoid 24, faults 9, falls 38 of 4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
    [mjcf.py, physics.py, skeleton.py]
2026-10-03 Her ankle a parallel pair; each drive's output on its drum's axis
    - Two M at 1:68 under the knee, a 12 mm rod each from a crank on its
    gearbox end to the heel's back: pitch together 160 N m, roll against
    105; the boards' currents mixed, each within its 25 A. Inside her shell
    and jeans, fit clean; scoreboard 495, held 68.3 % (535, 64.5 before).
    - fit.outputs and its test: the ankle's L turned its crank about x from
    along the shin, the hip yaw's gearbox faced away; the elbow and wrist on
    bevel pairs (across the arm 3-26 mm out of her).
    - Skeleton off the floor; still off: crouch head 1.03-1.66 m/s, 3 of 64.
    - Suites 1992 passed, 0 failed.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
    [buses.py, drives.py, linkage.py, physics.py, skeleton.py]
2026-10-03 Her hip a gimbal of parts: a fork on the yaw, a cradle on the roll
    - Each drive's stator on the stage before its joint (figure.STAGES):
    the roll's M on the fork, the pitch's L in the cradle, drawn, collided
    and checked turning with the leg; the hip's ideal-axis special cases gone.
    - Fork: steerer, crown over the L, legs to the roll's bearings 55 mm
    either side; cradle band and trunnions; boom 60 mm, arms to the yaw drums.
    - fit clean over 45 poses, the femur off its collar 34 mm out, not 28.5.
    - Masses still on the pelvis (physics.STAGED 0): on their stages the walk
    from the squat fell at 5.8 s, scoreboard 578 against 495.
    - Offline gate 4102 passed, 0 failed.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
    [build.py, drives.py, figure.py, mjcf.py, physics.py, skeleton.py]
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2026-10-03 Her trunk's roll first, its M on a spur pair into it
    - The torso's joints roll, pitch, yaw: the roll's axis fixed in the
    pelvis, its M there 10 mm lower on a 1:1 spur pair, the pitch's L on the
    roll's stage; a rod across the pitch went singular near 58 deg, a
    differential's bevels wanted 70 mm.
    - fit clean over 45 poses, every drive's output on its axis, the roll's M
    4 mm inside her skin; scoreboard 582, held 64.0 % (main 495, 68.3).
    - Lands with the walk retuned for it and the hip's stages.
    [drives.py, figure.py, linkage.py, skeleton.py]
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2026-10-03 Her legs' and pelvis's members sized for stiffness
    At 0.6 of their drives' peaks, at most 0.25 deg a member, roll-wrapped
    carbon (E 70 GPa, G 20): the femur 36 mm at its top and a high-modulus
    50 mm down the thigh; the tibia 40, 30 past the ankle's rods, its clevis
    20; the boom 50 (a hip's pitch twisted the 30 mm one 1.3 deg), routed steep
    to the yaw drives' tops; the hip fork's legs 22, its bearing arms 18, its
    crown a carbon plate in the 25 mm under the yaw drum. Hung bones take a
    radius a run (skeleton.runs). Fit: the tibia 1 mm off the ankle's rods
    in the sideways crouch, the rest clear; every drive held; gynoid 26/26,
    render 146/146.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
    [skeleton.py]
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2026-10-03 Her trunk's and arms' members sized for stiffness; printing without overhangs
    - The spine fork's front legs 24 mm high-modulus, its back one 30, each
    under its bearing; the column 40, the girdle 30; the neck's bracket 10,
    inside her neck (25 stood 15 mm out of it, the head 0.77 kg).
    - The humerus below its drive 20 mm high-modulus (0.37 deg at the elbow's
    walking peak), the forearm's 16 (0.14), the shoulder's flange bracket 18.
    - The drums' struts printed 20 mm for the rods' 3-4 kN, the ankle roll's 14
    (a 20 met the folded femur, 3 mm). Fit checks the trunk's frame against
    her shell and clothes: inside both.
    - docs/findings/body.md: the table, and printed parts without overhangs.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
    [skeleton.py]
2026-10-03 Her trunk's roll on a four-bar: an 18 mm crank on a 24 mm horn, lever 1.33-1.73
    The 1:1 spur pair's 100 mm wheels stood in the pitch's bracket's sweep. Transmission 53 deg
    at worst over +-35 deg, closest 1 mm over spine -30..85; fit clean, every drive held.
    Offline gate: 4133 passed, 0 failed.
    [drives.py, linkage.py, physics.py, skeleton.py]
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2026-10-03 Her drives as coaxial stacks: inverter, pancake outrunner, one-stage box
    Frames 68 x 30 and 60 x 16 mm, boxes 84/64/44 mm, inverters 100 mm 100 A and 70 mm 50 A,
    1:30, each winding in its window (`drives.STACKS`); her controller's clamps held. Gait Monte
    Carlo held 74.2 % (70.5 on the drives as they stood); felled by P up at 22.9/23.7 s.
    Drawn as their parts. Offline gate: 4132 passed, 0 failed.
    [build.py, drives.py, linkage.py, physics.py, skeleton.py]
2026-10-03 Her stacks as solids, a part each: inverter, motor, gearbox
    The skeleton's collision bodies and the fit check take each stack's parts at their own
    diameters, the right side's x mirrored (`drives.toward`); the held census counts a stack whole.
    Closest new pairs: the hip's inverter 5 mm into the hip roll's gearbox, the head's 4 into the
    neck's holder. Offline gate: 4133 passed, 0 failed.
    [drives.py, skeleton.py]
2026-10-03 Her drives sized by six numbers, each 1 at a part's limit; the demand cached; drives.md
    drive_sizes.py: P inverter, T copper (its binding node named), J rotor felt, Q = T J the
    frame, S box, V volts, at 1.5x the walk's demand; build/drive_demand.json makes an iteration
    0.4 s. Read: the knee's ratio window 33..34; its continuous torque the 100 mm inverter's
    switches at 44 A; a knee six-bar x1.09 against direct x1.12. body.md's nine drive entries
    moved to docs/findings/drives.md (6.2 k tokens past 6.0). test_structure 1411 passed.
    [drives.py]
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2026-10-03 The demand over five scenes, A the amps number; the hip roll's crank-rocker measured, not kept
    drive_sizes: the walk, a slip, a nudge, a hole and P's shove folded into the demand (one walk's
    knee asked 1231 deg/s with a catch, 561 without), each joint on a rod or a four-bar scaled by
    its lever; with the parries the legs' heat 1.4-2.9 at 1.5x. Four-bars: cranks and horns 8 mm
    plates (PLATE_R), the right side mirrored, their dead centres MuJoCo stops, the lever clamped
    to the stroke (past it the far branch read 0.44). The hip roll's crank-rocker: at -22..+44 the
    best Monte Carlo (75.8 %) but her head on the floor at 4.5-6 m/s, the stop; at -28..+40 no
    head landing but 67.2 % and the walk down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
    [drives.py, linkage.py, mjcf.py, skeleton.py]
2026-10-03 Her members sized by a tool; the flex in the world; the pitch's bracket 12 -> 36 mm
    tools/sim/members.py: every tube, plate, rod and strut against its drive's peak or 1.5x its
    clamp - stress, flex at 0.6, and each joint's wind-up. As they stood the pitch's bracket took
    8.1x its allowable and wound the spine 27 deg at its clamp (the bob the user saw), the steerer
    3.7x in torsion, the neck's bracket 1.3x; sized, 3 of 63 marginal. drives.flex, BOX_K and WIND:
    a board with its encoder on the motor sees its joint wound by its last torque (physics.WOUND,
    buses): at 1 her walk fell at 6.4 s, at 0.5 she walked - the joint's own sensor, WOUND 0 the
    default. Suites: structure 1414, gynoid 26, falls 44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
    [buses.py, drives.py, physics.py, skeleton.py]
2026-10-03 The Monte Carlo and the get-up search on the relay; the first step's lift 0.06 -> 0.04 m
    gait_montecarlo and getup_search run every trial as a focus.relay job (--one, --one-start), no pool of their own: 54 runs in 103 s, cost 730.16, held 74.1 % as the grid run gave; the get-up's 5 starts in 14 s, 4 of 5 walking again.
    arrival.LIFT_UP_M 0.04: the stacks' ankles and hip rolls reflect half the inertia the first step was tuned on, the pelvis 51 mm down and 15 up in the walk's first second -> 18 and 4; every rise 100 %.
    Suites: structure 1414, gynoid 26, falls 44, faults 9 passed, 0 failed.
    [arrival.py]
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2026-10-04 The toes' spring a knob: drives.TOE_K, TOE_C
    A sneaker's forefoot 11-29 N m/rad, a plated one's past 200; on the look suite with the search's push-off knobs and the toes sprung, 40 held the rises 41-100 % and the walks 5-53, 100 29-66 and 4-11, 200 and 400 under 35 and under 16: a stiff toe turns with the foot at toe-off and stands her on the toe tips.
    [drives.py]
2026-10-04 Standing: the stand held, bricks and a balance board under her, a step reflex, the stand suite; the get-up's launch tamed
    Director(stand_s): the arrival's stand held; floor.BRICK and BOARD (hinged, BOARD_K 3000 N m/rad
    or free); events.STANDING rigged under her and befalling her, scored by the Monte Carlo's 'stand'
    suite, test_gynoid_stand.py and look.py --stand; figure.POINT_FEET a sphere under each sole.
    machine.stand steps past the capture point as it will be at the landing, the swing foot pinned
    where it lands; past the sole's edge it earns nothing yet: 64.6 % with it, 64.8 without (the
    nudges and the stiff board 100 %, shoves 46-49, bricks 48-56, the free rocker 21-27).
    arrival.PULL_M 0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
    [arrival.py, build.py, director.py, events.py, falls.py, figure.py, floor.py, gait.py]
2026-10-04 The HUMANOID page: one key row, the rest a help sliding up on TAB; a robo-gym of rigs on 7-0
    stage.helped and help_panel: the keys by group on a panel that slides up from the bar over 0.25 s
    on TAB or ?, down by itself 8 s after the last key - the old taskbar (the user, 2026-10-04);
    frame_of(help=). The page's bar one row (BAR); GROUPS body, floor, gym, view, page. 7-0 land her
    anew on the bricks abreast or staggered, the stiff board, the free rocker, standing (the runner's
    'rig', running._landed); P and N push and nudge from her sides in turn, shift along her way, B
    takes a brick ('befall', events.befall - toward her heading, not the world's x). The bar and the
    panel judged as PNGs at 150 c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
    [running.py]
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2026-10-04 balance.md: the day's scoreboard, 729 and 65.7 % over 28 trials; the brick read closer
    The second step takes the brick's foot onto the brick's rear edge, blind to it, where it bears
    0-8 N; stood 4 cm lower after a step the hop stayed (0-1114 N a foot) - reverted.
    [stand.py]
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2026-10-04 A pinned foot reaches 1 cm under until it bears; Clef 27B at 4k picks the grinder's suite
    arrival.PRESS_M: a foot bearing nothing was solved from the pelvis as it is and sat on the
    floor at 0 N; the 60 N standing shove now stands from either side, the scoreboard 721.4 and
    65.8 % against 729 and 65.7. coaxial_ollama/decide.py: /v1/systemone choice, noul, score;
    clef:4k (27B, num_ctx 4096) 5.3 s a decision, clef-flash refuses on 0.35.1 (issue 18769).
    gym.py asks it the suite; knobs PRESS_M and DWELL_S; the result printed from grind().
    TODO: the platform layer classical IK + RL; the grinder's rounds 1-3 in balance.md.
    [arrival.py]
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2026-10-04 Standing to stay, each foot bears its share of her weight
    bearing.shared: every leg a stance leg, its foot let down 0.3 m/s a share it lacks and drawn up a share too many, the share what her centre of mass asks of it between the feet, all of it while the other steps; it replaces the leg bearing the more as the stance leg, the press and the landed foot's seek. The stand suite 99.3 and 89.2 % against 237.9 and 77.5; the push polar 32 of 48 against 25 (100 N 9 of 12 against 3, from her sides on the loaded leg's side step); the bricks 96 and 63 % from 60 and 55, the rockers 100 from 63 and 90; the scoreboard 538.0 and 82.8 % against 641.7 and 78.6, the rises, walks and events identical. Gynoid s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
    [arrival.py, bearing.py]
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2026-10-04 The rear foot no longer slips back before its swing
    The heel rises by the leg's reach (stance.HEEL_UP_DEG 45), the stride 0.75 m,
    the foot let go goes with the pelvis and eases into its swing (stance.LET_Q
    0.1), the swing 45 mm up. look.py's toes back at lift 0.8 mm from 92; on the
    scoreboard's walks 3, 1, 1, 4 mm from 31, 85, 92, 92 and their power 317-487
    W from 507-882. Scoreboard 250.5 and 82.9 % against 265.9 and 86.4 (the slip
    in its cost): every rise and walk; a sill at 0.65 strides/s and a nudge
    walking fell her 2 of 3 each, none before. Up and walking 23 s after the
    shove's fall. test_gynoid: 0.9 of her strides in 3 s, not 2 m.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
    [gait.py, stance.py, walker.py]
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2026-10-05 Her stance leg a strut again; an armada of her smokes the walk in 12 s
    The hips no longer planned down to the trailing leg's flat foot; the leg at
    its soft knee's length, its heel solved for it; a leg carries as its sole
    bears; the knee gives up to 24 deg through the double support.
    Steady at 0.85, 0.65, 1.0 strides/s: knee behind plumb 7.1, 6.8, 8.1 deg
    (16.7, 16.5, 18.3), 393, 384, 604 J/m (561, 885, 608), parries 0, 0, 0
    (0, 8, 0), toes back 0.8, 0.5, 0.1 mm; from the squat none either.
    tools/sim/armada.py, replay.py: robots marked walking, a law's constants or
    its code swapped in, gone back to bit for bit; test_gynoid_gait.py holds
    looks.FORM at three paces and her start from the squat.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
    [buses.py, gait.py, stance.py, walker.py]
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2026-10-05 A catch at 7 cm; every walk begun at her own pace
    capture.CATCH 0.04 -> 0.07: from the squat no parry in 12 runs a side
    gain 0.3 % apart where 7; the events held 48 of 90 where 47.
    The director sets the walker's pace at every start (0.85, glided);
    the scoreboard's walks no longer set it over that: 12 of 12 on their
    form where 2 fell.
    The armada walks a robot in anew under a changed law.
    Gynoid 28, falls 44, faults 9, stand 6, gait 41, structure 1458: 0 failed.
    [capture.py, director.py]
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2026-10-05 She leans, then shifts, and lifts the foot as her weight comes over
    arrival.keyframes: the lean on both feet before the shift onto the
    left; the capture point 24-28 mm inside the standing ball at the lift
    where 35. Of 30 starts over 6 side gains 29 with no parry, 1 down
    (standing, glided to 1.02 strides/s), where 21, 3 down, 6 parried.
    Events held 48 of 90 as before; the scoreboard's rises and walks held.
    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
    [arrival.py]
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2026-10-05 She runs: a bounce a foot, from a flight at her speed
    machine/runner.py, tools/sim/run.py, test_gynoid_run.py (run.FORM): a minute
    at 1.27, 1.49, 1.72 and 1.94 m/s asked 1.25-2.0 on the one stack, 48 V; the
    same on 40 A and on 36 V; asked 2.25 down in 10-16 s (docs/findings/run.md).
    drive_sizes --run folds her run in: T 1.17 at the hip at 1.5x.
    Offline gate 4247 passed, 0 failed. electronic_simulations at 4808c95.
    [runner.py]
2026-10-05 Her motors as bought, the 63100 on every drive
    drives.FRAMES rows of parts: T-Motor's U8 II Lite at KV 100 on 15 drives, the
    MN6007 II on 6, one box at 1:30, the 63100 (100 mm, 14.7 mm tall) on all 21;
    her 30.8 kg. Their rotors 2.5 times the frame's before: the board's rotor
    feed-forward a quarter (whole, 3 standing starts of 12 fell), her run's
    stance 0.30 s (0.72-1.65 m/s; 2.0 no longer held). The mechanism drawn a
    stack's parts apart. Offline gate 4247 passed, 0 failed.
    [drives.py, physics.py, runner.py, skeleton.py]
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2026-10-05 Her going on one law: walk and run rows of the same setpoints
    machine/going.py over gaits.py, off the page: a limb bears or is free, a
    gait a row of 16 numbers, no stage and no plan's table. The walk's row,
    found on the scoreboard's price with a foot always down: 0.94-0.99 m/s at
    360-367 J/m where the walk as built draws 623 at 0.96, its knee landing
    at 18 deg; priced 26, five of the form's conditions off. The run's row
    is the runner's: 1.46 m/s at 517 J/m. A row between: walk, run and walk
    again on 2 timings of 10. tools/sim/go.py measures and searches;
    test_gynoid_going.py 11 passed. Offline gate 4263 passed, 1 failed
    (test_daq_api's first dt, 82 of 82 alone).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
    [gaits.py, going.py]
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2026-10-05 The converters calibrated on their reference at boot; the self test where the image runs
    main() calibrated the three ADCs with AFE_ON low: the reference is that
    rail's. CALFACT read 0 on all three and no linearity word was set. On the
    board 2026-10-05:
    - Every single-ended code ~1000 high: a dead Vgate 1049 codes, the NTC +1.9
    K at 35 C, the MCU's die +20 K (66-70 C for 43-46), the DC link's -32 418
    ppm "span" its offset. A code stuck 70 under every 512: 586 NTC readings
    folded on 512 leave -80..-17 empty and pile on the boundary.
    - The rail is raised 100 ms at boot (the link's code is within its noise 25
    ms after it), each converter takes its linearity and both offsets, and the
    t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
    [board_limits.h, board_sync.c, main.c]
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2026-10-05 QUAD flies flight after flight: the burn down a speed for each height, the thrust run down as the propellers do
    The page on its four stand-ins, 2026-10-05, measured a frame at a time:
    - The third flight never left its hover: its envelope share, 0.42 since the
    dry loss's refit, sat over the room of 0.4 full tilt waited for. The room
    is the throttle's point less what a flight spends, 0.3 - ten flights on end
    peaked at 0.73 from hovers at 0.46. The test flies into the second flight's
    full tilt.
    - The burn stopped 0.44 m up and crept 3.1 s to its 10 cm: asked the pull
    that stops it, the spool's allowance kept through the burn. It is flown
    down a speed for each height over its mark -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
    [quad.py]
2026-10-05 QUAD flies a routine: its figures rows of one law's setpoints
    machine.aerobatics is the card - a figure a row, a routine the rows in
    turn, each eased in on the least jerk and left on its seconds and what it
    waits for - and machine.flying the one law that flies any row: a height
    and the pace it may go there at, come to and stopped from as gently; a
    speed along and across its heading, the heading's turn, its spot gone
    home; turns about its nose and its wing. A pirouette, an orbit and a
    corkscrew to 8 m, a roll and a flip over a toss, the way back down, then
    full tilt and the burn as before: 59.9 s on ideal rotors, 0.5 g at most
    outside its turns. machine.quad keeps the frame.
    On the page: no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
    [aerobatics.py, flying.py, quad.py]
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2026-10-05 QUAD on a 63 V pack, inside its boards' envelopes
    The four boards on one pack of 15 cells (machine.quad): 63 V full, its
    bus drooping 0.12 ohm a link amp, its charge counted down - a fifth a
    flight. Spent, the routine comes down from wherever it is at 2 m/s and
    waits on the floor: a charged pack in 3 s, the boards cooling, their
    observers kept through it. Full tilt and the burn take 1.5-1.85 kW and
    the bus to 56 V.
    The rotors are asked the share of their pull the boards' thermal
    envelopes leave - the least room under a throttle's point - which the
    law speeds the frame up on and plans a fall's stop on, never limits a
    stop by: flown from its first hover with the observers UNCERTAIN, none
    thro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
    [aerobatics.py, flying.py, quad.py]
2026-10-05 A woman's normal walk as a metric, her walk as built a take; her arms hang on the law
    tools/sim/normal.py: 23 measures from joints' places, a band each; fbx.py reads
    binary and ASCII FBX and writes binary 7400, its FileId and footer its stamp's as
    the SDK's own files' are, 48 of 48; mocap.py a column a take, off the band and from
    the first; look.py --fbx. Off the band: six mocap walks 0.00-0.20, her walk as built
    2.01, the one law's 4.10. tests/takes/walk.fbx reads back 0.000 mm;
    test_gynoid_gait.py holds her walk to it and to the band, test_gynoid_going.py the
    law's arms: elbows 24 deg with 16 of play where 80 and still. The page walks her as
    built, the law under J; the law's walk one at 0.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
    [director.py, free.py, gaits.py, going.py, hold.py, pace.py, running.py]
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2026-10-06 QUAD's late pass is its steps: a starved page's flight no longer rings
    - flight.passed takes a pass of the feed in steps of STEP_S, 25 ms, at the
    most; flight.fresh lays the flights' own. A starved page's every pass is
    50 ms, and stepped whole the frame rang on its rotors: 30 A through the
    corkscrew, the envelopes' share 0.22, `home` never held. With the feed
    every 60 ms: `home` 41 s and more before, 3.0 s now.
    - The page's tests on one `paged`, a row a step of the flight: full tilt's
    kilowatt is 0.15 s of its two seconds, and a frame's read of it was 814 W
    on CI's runner (f8c6b1b red). The late pass held headless on four
    stand-ins: its first toss at 27.0 s on 77 % of the pull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
    [flight.py]
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2026-10-06 The law's walk 502 J/m where 582: its free sole eased up, a heel-landed foot flat first
    A walk's free sole is raised to its clearance over the first fifth of its
    swing (at once, the knee was asked 23 deg more in a pass as the foot left); a
    run's still at once. A foot on its heel has its heel's rise only as its toes
    come down. As the page runs her 485 J/m, 0.20 off a woman's band where 0.34,
    a strike 352 N where 428; her ways 69 of 104, the keys 12 of 12.
    ways.py --polar: shoved walking by her stride and the standing foot. 38 N:
    fore and aft 12 of 12 up, aside 3 of 12. Gate 4501 passed, 0 failed.
    [free.py, gaits.py, strut.py]
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2026-10-06 QUAD's world is solid: what stands is struck, a wreck's flight begun again
    - machine.quad's world takes things (`mjcf(things)`, `Sky(things)`): boxes,
    rods and hulls beside the floor, the frame's discs and hub what it
    strikes with; `Sky.hit` what it struck first, more than a skid on the
    floor. `course.solids` gives the course's: a tree its trunk and cone, a
    house its walls and roof, a car, the mast, a gate's bars - 128 things, a
    pass 0.12 ms the dearer. The gates stand for the course's flights alone,
    as they are drawn (`Sky.stand`).
    - The first gate's lower bar stood 0.3 m over the spot, in the lift's way:
    the floor is its lower edge now.
    - flight: struck, a flight is CRASHED -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
    [course.py, flight.py, quad.py]
2026-10-06 QUAD's laps a fifth shorter; war emergency power where a wreck is near
    - course: a bend takes 0.7 of the pull where 0.4, the lean asked 23 m/s^2
    where 20, and a bend's pull swings from side to side in SWING_S, 0.6 s,
    at the fastest - the line's turn's change a metre bounds the speed.
    flight: its envelope 0.04 under the boards' throttle where 0.08. On the
    page's four boards, still air and six winds: laps 26.4/25.4 s to
    21.8/20.6, 28.2 to 22.3 in the worst wind; a gate 0.53 m off at the most,
    the boards at 0.71-0.74 of their envelopes, nothing struck.
    - quad.Sky.ahead: the frame's ghost flown half a second on as it goes, in a
    world of its own with 0.15 m to spare; flying.short: t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
    [course.py, flight.py, flying.py, quad.py]
2026-10-06 A free foot not hurried: shoved 38 N walking, up 62 of 64 where 44
    Her capture point running across, the free foot is due no sooner than what
    is left of its swing at the swing's own pace (going._due): hurried, it came
    down 3 cm short and the steps after it shorter. ways.py --polar, up of 64:
    38 N 62 where 44, 70 N 36 where 17, 120 N 5 where none. Her ways 77 of 104
    where 69; her walk 501 J/m and 0.20 off the band as before; the page's
    presses under the director 66 of 72 either way. Gate 4505 passed, 0 failed.
    [gaits.py, going.py]
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2026-10-06 A catwalk on the one law: an accent, read back swaying 0.40
    gaits.MANNERS 'catwalk': the pelvis's list 1.9 deg more, its turn 12.9 - the
    pelvis turning 29 deg and rolling 11.5, a catwalk by name, at 570 J/m; in
    the walk through six accents and plain again, up on 12 timings of 12.
    go.py: a form's sample no longer overwrites the row asked (--ask with
    --form raised KeyError: 0 since 9160e2c0); a form carries her walk by place.
    Going suite 54 passed.
    [gaits.py]
2026-10-06 A pose's accent with a side, let go before she goes: hip left, hip right
    Two setpoints her stand alone reads, weigh and hang: 77-80 % of her on one
    sole, the pelvis rolled 5.5 deg up over it, the other knee 29 deg where 10.
    gaits.passed steps her way and her accents together: a pose's is let go, 2 s,
    before the row leaves her stand, and hers again as she stands - asked on
    from it at once she was down in 1.2 s. Going suite 59 passed; gate 4539
    passed, 0 failed.
    [gaits.py, going.py, hold.py, pace.py]
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2026-10-06 QUAD's place on its line found between samples: the boards' laps 2 % shorter, their spool's heat less
    By the nearest sample's own tangent a frame off its line in a bend jumped at
    every sample, and the asked speed's change with it. The tuner flies the air's
    seeds a run asks (--seeds).
    [course.py]
2026-10-06 QUAD's asked speed softened: the plan's steps no longer spooled for, the boards' laps 19.6 and 19.0 s
    From its way out of a bend to its brake for the next the plan's speed stepped
    14 m/s^2 in a pass and the collective followed at once. The speed asked comes
    to the plan's over SOFT_S, the plan looked up as much further on: on the four
    boards in seven winds 19.5-19.7 and 18.6-19.1 s where 20.2-20.7 and
    19.6-20.7, their envelopes at 0.66-0.69 where 0.72-0.77, a gate 0.50 m off at
    the most where 0.67.
    [course.py]
2026-10-06 Asked a slow walk she strolls: 0.73 off a woman's band where 1.53
    An accent of its own, asked by a slow walk's row itself: a step 0.14 s
    longer, her walk ratio 1.08 where 0.73 - 0.52 m/s at the row -0.3, 0.66 m/s
    and 0.39 off at -0.15, no gait's name where on stilts and a shuffle. Let go
    before she stops (gaits.passed): stopped on the long step, down 3 timings of
    12. The page's slow levels -0.15 and -0.3; the row -0.6 stays a shuffle.
    Her ways 76 of 104, the presses under the director 66 of 72 as before;
    going suite 64 passed, gate 4546 passed, 0 failed.
    [gaits.py]
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2026-10-06 QUAD's plan on a circle of its grip, its tilt's loop stiffer: laps 14.9 and 14.4 s, the four boards 15.3 and 15.2
    The brake before a bend and the way out of it are shares of what the bend
    there leaves of the grip, run back from the far end of what is looked at, where
    shares of the pull whatever the bend took. The tilt's loop at 140 and 20, its
    miss answered to 1.2 rad: a lean came round at 3 rad/s and the frame was 5.8
    m/s under its plan out of a bend. A gate 0.40-0.42 m off on the boards in still
    air and nine winds; 30.4 as the tuner counts twelve trials where 33.1.
    [course.py, flying.py]
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2026-10-09 WEP past the SOA on an observer's word: thermal op 14 holds a board's derate off (MINOR 25)
    Where a wreck is a fact (the user): thermal op 14 holds the clamp's thermal
    derate at one, 2 s at the most, the trip on the record's ceiling standing; the
    flight on WEP gives the rotors 40 A where 30 and 432 rad/s - the pack's 63 V at
    the clamp - where 310, the law its lean whatever its row's or, the floor ahead,
    its height first. Taken where the law is short of what it asks, up counted, and
    the frame's ghost strikes a thing within 0.5 s; on the ghost alone every dive
    at a gate and every way down to land took it. The ghost no longer counts what
    the frame is already that near. The flight's own cut keep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
    [board_limits.h, board_thermal.c, flight.py, flying.py, observer.py, quad.py]
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2026-10-09 QUAD: a larger technical course on machine.grounds, the frame propped for its 63 V pack, its thrust and its line drawn
    machine.grounds holds the course's gates, each its own opening, and what stands: two slaloms of
    2.8 m gates, a 9.4 m climb, a 10 m dive, a hall flown through by its 2.6 m windows - its walls
    boxes about them -, a 3 m alley; its clearances once, for the tuner and the suites. The line
    crosses each gate off its middle, its apex; the plan's top what its pull holds against the
    drag, its straights on THROTTLE of the frame's pull. Searched with a gate's margin weighed
    150 s a metre: laps of 19.6 and 19.2 s, on four boards 19.5 and 19.0, every tip inside in two
    winds it never flew.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
    [course.py, flight.py, flying.py, grounds.py, quad.py]
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2026-10-10 QUAD raw: a dive pushed inverted, the plan a sphere about gravity, the rotors asked through the air along their discs
    The race was paced at 12 m/s and 12 m/s^2, its discs against 0.5 g at the least, a crest no
    faster than 0.511 g let it fall: laps of 19.6 and 19.2 s, never sped down past -8.8 m/s^2.
    Its plan is now a sphere about gravity, PULL of what the boards' envelopes leave, the thrust
    v^2 k + a t + g up wherever that points, the air through the discs and the drag in it; the
    race's discs as far down as its line asks and SLACK of g past it. The law's reach is what the
    air along its discs leaves, its air learnt on the thrust it believes, the drag on its climb
    flown; quad.speed_for asks a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
    [aerobatics.py, course.py, flight.py, flying.py, quad.py]
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2026-10-10 A flight on stand-ins its own to the digit; the raw plan eased at a share of all of its pull
    The stand-ins' front end drew its noise from the module's random and their heat ran on the
    wall's clock until a flight's first pass: one flight run twice read SOA 0.83 then 0.91, a
    stuffy room whole or into gate 6. The front end seeded, a flight's boards on its clock from
    their arming, a flight is the same run after run. The plan's sphere eased at a share of what
    the envelopes left came down slowest where they left least - a stuffy room's spent boards
    were asked twice their pull for 2 s and it flew into a house; eased at a share of all of it,
    on four boards in four winds, a stuffy room and a pack at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
    [course.py, flight.py, flying.py]
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2026-10-10 The page's flight in the race's 20 ms steps, the rest owed: one flight whatever the wall
    Stepped as the wall's passes came, a loaded page drew its air's eddies on
    other steps and crossed gate 0 0.97 m low, 0.15 m past its room, one flight
    in nine - the gate's test_views_quad failure. flight.passed owes a pass's
    seconds short of a step to the next and reads the boards' observers every
    THERMAL_S of the flight's clock, for the page, the race and the tests alike:
    every pass pattern flies 14.24 and 14.98 s, every tip 0.25 m inside.
    [flight.py]
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2026-10-10 ADC3's interrupt without veneers, its divide and libm: ITCM, a laid scale, vrintr, a rational tanh
    The user, 2026-10-10: the hot paths' jumps and stalls cut. The handler and
    five board functions it reached behind long branches' veneers from D2 SRAM go
    into ITCM. Board_CalApply reads a Q28 table laid wherever the record changes -
    zero the identity - an SMULL and a shift where a 64-bit divide ran
    __udivmoddi4's 40 branches a DAQ sample; it rounds where it truncated, a count
    at most. The DAQ rounds by nearbyintf, vrintr and vcvt where lrintf was a
    call; the plant's tanh a clamped 13/6 rational within 1e-6 of libm's, where
    tanhf took expm1f and its errno path. The reach: 93 -> 74 functions, 436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
    [board_cal.c, drive.h, drive_math.c, drive_model.c]
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2026-10-10 wbc: the active set given 80 changes a level; the loop walks 8 s
    At 20 changes the set ran out in every swing and left bounds broken by up to
    1 600 (unit rows); at 80 they hold to 1e-9 and no level runs out (`stuck`
    counted and shown in the trace). The loop's walk: 17 steps, 1.08 m, 0.18 m/s,
    2944 J/m, stood (the stack 16, 1.88 m, 0.31 m/s, 792 J/m); shoved from 8 ways
    60/80/100/120 N stood 7/5/2/0 of 8. Shadowing the stack's walk, WEP off: 16 N m
    apart in single support, the loop chattering less (0.75 against 2.9 N m a
    tick), achieving more of the swing (7.8 against 5.6 of 34 m/s^2), drawing more
    torque (40.5 against 33.3). The height band's ids no longer collide with a
    corner's. TODO 36 cu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
    [wbc.py]
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2026-10-11 Gearboxes with their play; the room and its words; the quad's thrusts as her law
    machine/gearbox.py (physics.BOXED): each rotor free across 0.5 deg of play, the
    box wound up past it at 9 kN m/rad against 2 % mesh friction, 5 substeps; the
    servo and the ESO on the motor's encoder. On it the walk on setpoints drags its
    toes 7-19 mm at lift (band 2), the loop on its torques walks 265-326 J/m and its
    ESO stands 8 of 8 at 100 N (PD 2): BOXED 0 for the page, 1 for the loop's tests.
    Rigid, the boards keep the 0.05 deg encoder deadband started at the hold: gait
    99 of 99 as before. machine/room.py, errands.py (keys U I E Y): the law turns
    0.05 rad/s walking and not on the spot, no word's target reach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
    [buses.py, director.py, drives.py, errands.py, flying.py, gearbox.py, mjcf.py, pace.py]
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
